JessyBarber/Jessy-Thesis/README.md

# Jessy-Thesis
Repo for thesis. This repo includes documentation, code, resources & reports. 

Project Planning Report -> Project Planning Report/Project Planning Report.pdf
