JessyBarber/Jessy-Thesis/Final Report/Final Report/Final Report.tex

%----------
%   WARNING
%----------

% This Guide contains Library recommendations based mainly on APA and IEEE styles, but you must always follow the guidelines of your TFG Tutor and the TFG regulations for your degree.

% THIS TEMPLATE IS BASED ON THE IEEE STYLE 

%----------
% DOCUMENT SETTINGS
%----------

\documentclass[12pt]{report} % font: 12pt

% Custom packages
\usepackage{comment}
\usepackage[numbers]{natbib}
\usepackage{booktabs}
\usepackage[table,xcdraw]{xcolor}
\usepackage[normalem]{ulem}
\usepackage{amsmath}
\usepackage{subcaption}

\useunder{\uline}{\ul}{}

\bibliographystyle{IEEEtran}

% margins: 2.5 cm top and bottom; 3 cm left and right
\usepackage[
a4paper,
vmargin=2.5cm,
hmargin=3cm
]{geometry}

% Paragraph Spacing and Line Spacing: Narrow (6 pt / 1.15 spacing) or Moderate (6 pt / 1.5 spacing)
\renewcommand{\baselinestretch}{1.15}
\parskip=6pt
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
\usepackage[utf8]{inputenc}

% English settings
\usepackage[english]{babel} 
\usepackage[babel, english=american]{csquotes}
\AtBeginEnvironment{quote}{\small}

% Footer settings
\usepackage{fancyhdr}
\pagestyle{fancy}
\fancyhf{}
\fancyhead[R]{\MakeUppercase{6007ENG - Industry Affiliates Program, Trimester 1, 2023}}
\fancyfoot[R]{Jessy Barber - Griffith University | \thepage}
\fancypagestyle{plain}{\pagestyle{fancy}}
\renewcommand{\headrulewidth}{0pt}

% DESIGN OF THE TITLES of the parts of the work (chapters and epigraphs or sub-chapters)
\usepackage{titlesec}
\usepackage{titletoc}
\titleformat{\chapter}[block]
{\large\bfseries\filcenter}
{\thechapter.}
{5pt}
{\MakeUppercase}
{}
\titlespacing{\chapter}{0pt}{0pt}{*3}
\titlecontents{chapter}
[0pt]                                               
{}
{\contentsmargin{0pt}\thecontentslabel.\enspace\uppercase}
{\contentsmargin{0pt}\uppercase}                        
{\titlerule*[.7pc]{.}\contentspage}                 

\titleformat{\section}
{\bfseries}
{\thesection.}
{5pt}
{}
\titlecontents{section}
[5pt]                                               
{}
{\contentsmargin{0pt}\thecontentslabel.\enspace}
{\contentsmargin{0pt}}
{\titlerule*[.7pc]{.}\contentspage}

\titleformat{\subsection}
{\normalsize\bfseries}
{\thesubsection.}
{5pt}
{}
\titlecontents{subsection}
[10pt]                                               
{}
{\contentsmargin{0pt}                          
	\thecontentslabel.\enspace}
{\contentsmargin{0pt}}                        
{\titlerule*[.7pc]{.}\contentspage}  

% Tables and figures settings
\usepackage{multirow} % combine cells 
\usepackage{caption} % customize the title of tables and figures
\usepackage{floatrow} % we use this package and its \ ttabbox and \ ffigbox macros to align the table and figure names according to the defined style.
\usepackage{array} % with this package we can define in the following line a new type of column for tables: custom width and centered content
\newcolumntype{P}[1]{>{\centering\arraybackslash}p{#1}}
\DeclareCaptionFormat{upper}{#1#2\uppercase{#3}\par}
\usepackage{graphicx}
\graphicspath{{imagenes/}} % Images folder

% Table layout for engineering
\captionsetup*[table]{
	format=upper,
	name=TABLE,
	justification=centering,
	labelsep=period,
	width=.75\linewidth,
	labelfont=small,
	font=small
}

% Figures layout for engineering
\captionsetup[figure]{
	format=hang,
	name=Fig.,
	singlelinecheck=off,
	labelsep=period,
	labelfont=small,
	font=small		
}

% FOOTNOTES
\usepackage{chngcntr} % continuous numbering of footnotes
\counterwithout{footnote}{chapter}

% CODE LISTINGS 
% support and styling for listings. More information in  https://es.wikibooks.org/wiki/Manual_de_LaTeX/Listados_de_código/Listados_con_listings
\usepackage{listings}

% Custom listing
\lstdefinestyle{estilo}{ frame=Ltb,
	framerule=0pt,
	aboveskip=0.5cm,
	framextopmargin=3pt,
	framexbottommargin=3pt,
	framexleftmargin=0.4cm,
	framesep=0pt,
	rulesep=.4pt,
	backgroundcolor=\color{gray97},
	rulesepcolor=\color{black},
	%
	basicstyle=\ttfamily\footnotesize,
	keywordstyle=\bfseries,
	stringstyle=\ttfamily,
	showstringspaces = false,
	commentstyle=\color{gray45},     
	%
	numbers=left,
	numbersep=15pt,
	numberstyle=\tiny,
	numberfirstline = false,
	breaklines=true,
	xleftmargin=\parindent
}

\captionsetup*[lstlisting]{font=small, labelsep=period}
 
\lstset{style=estilo}
\renewcommand{\lstlistingname}{\uppercase{Código}}

% REFERENCES 

% IEEE bibliography setup
\begin{comment}
\usepackage[backend=biber, style=ieee, isbn=false,sortcites, maxbibnames=6, minbibnames=1]{biblatex} % Setting for IEEE citation style, recommended for engineering. "maxbibnames" indicates that from 6 authors truncate the list in the first one (minbibnames) and add "et al." as used in the IEEE style.

\addbibresource{Sections/Bibliography/References.bib} % The references.bib file in which the bibliography used should be
\end{comment}

%-------------
%	DOCUMENT
%-------------

\begin{document}
\pagenumbering{roman} % Roman numerals are used in the numbering of the pages preceding the body of the work.
	
%----------
%	COVER
%----------	

\begin{titlepage}
	\begin{sffamily}
	\color{azulUC3M}
	\begin{center}
		\begin{comment}
		\begin{figure}[H] % UC3M Logo
			\makebox[\textwidth][c]{}
		\end{figure}
		\end{comment}
		\vspace{2.5cm}
		\begin{Large}
			Bachelor of Electrical and Electronic Engineering (Honours)\\			
			 2023\\ % Academic year
			\vspace{2cm}		
			\textsl{6007ENG - Industry Affiliates Program}
			\bigskip
			
		\end{Large}
		 	{\Huge Structural Health Monitoring of the Griffith Footbridge Using LoRaWAN Technology}\\
		 	\vspace*{0.5cm}
	 		\rule{10.5cm}{0.1mm}\\
			\vspace*{0.9cm}
			{\LARGE Jessy Barber}\\ 
			\vspace*{1cm}
		\begin{Large}
			Griffith University Internal Project\\
			Yong Zhu
		\end{Large}
	\end{center}
	\vfill
	\begin{figure}
		
	\end{figure}
	\end{sffamily}
\end{titlepage}

%----------
%	ABSTRACT AND KEYWORDS 
%----------	
\renewcommand\abstractname{\large\bfseries\filcenter\uppercase{Executive Summary}}
\begin{abstract}
\thispagestyle{plain}
\setcounter{page}{1}
	
	% Write your abstract
This research presents a novel approach for Structural Health Monitoring (SHM) of the Griffith University footbridge, harnessing the power of LoRaWAN technology within the framework of the Internet of Things (IoT). The study is undertaken in two phases. 
	
The first phase focuses on the software development and testing of the initial three layers of the IoT architecture: coding, perception and network. This involves the utilisation of two Arduino MKRWAN 1300 devices, where one serves as a LoRa node and the other as a LoRaWAN gateway. An ADXL335 3-axis accelerometer is integrated into the system to capture vibrational data, which is processed and visualized through Python scripts. 
	
The second phase extends the reach of the IoT architecture to incorporate middleware and application layers. It also includes hardware modifications like transitioning to a custom PCB and a 3D printed enclosure. The data captured is transmitted via a LoRaWAN connection to a WisGate Edge Lite 2 gateway and then relayed to the TNN cloud. Data visualization and analysis are facilitated using the Arduino IoT Cloud dashboard.
	
Each phase is guided by defined objectives, including hardware design and testing, software validation, and comprehensive field tests. The overall outcome is a potential new standard for bridge health monitoring using LoRaWAN technology, as exemplified by the Griffith University footbridge.
	
	\vfill
\end{abstract}

%----------
%	Dedication
%----------	
\chapter*{Acknowledgements}

\setcounter{page}{2}
	
	% Write here	
	I would like this opportunity to acknowledge and thank the following people, without whom I would not be able to complete this project:

My mother and father, for always supporting me every step of the way on my academic journey. For supporting me both mentally and financially during my studies, I thank you deeply. 

My group of friends, for respecting the time required for my studies, and always being there to elevate my spirits. 

My fellow peers at Griffith who I have met along the way, I thank you for being patient with me and always providing a fun learning experience. 

My work staff and bosses, for allowing me to take time off from my dream job to complete my degree, and allowing me to come back full time the moment I finish. 

And finally I would like to thank my supervisor Yong Zhu and project partner Huiyue Qiao for their countless hours in meetings and extensive laboratory testing. I hope you enjoyed the project as much as I did. 
	\vfill

%----------
%	TOC
%----------	

%--
% TOC
%-
\tableofcontents
\thispagestyle{fancy}

%--
% List of figures. If they are not included, comment the following lines
%-
\listoffigures
\thispagestyle{fancy}

%--
% List of tables. If they are not included, comment the following lines
%-
\listoftables
\thispagestyle{fancy}

%----------
%	THESIS
%----------	
\clearpage
\pagenumbering{arabic} % numbering with Arabic numerals for the rest of the document.	
\pagestyle{fancy}
\chapter{Introduction}
\input{Sections/Introduction/Report-Structure}
\input{Sections/Introduction/Project-Background}
\input{Sections/Introduction/Aims-Objectives}
\newpage
\chapter{Review of Published Literature}
\input{Sections/Literature-Review/Literature-Review}
\chapter{Design Process}
\input{Sections/Design-Process/Design-Specifications}
\chapter{Prototype Testing}
\input{Sections/Prototype-Testing/Testing-Methodology}
\chapter{Discussions}
\input{Sections/Discussions/Discussions}

% IMPORTANT: Latex special characters are: # $ % & \ ^ _ { } ~. To avoid mistakes when compiling try writing \ before. For: \ use \textbackslash ; for ^ \textasciitilde and ~ \textasciicircum.

%     Example of figure:
%     \begin{figure}[H]
%     	\ffigbox[\FBwidth] {
%     	\caption[Name as seen in index]{Figure name}
%     	}
%     	{\includegraphics[scale=0.6]{imagenes/creativecommons.png}}
%     \end{figure}

%     Example of table:S
% \begin{table}[H]
% 	\ttabbox[\FBwidth]
% 	{\caption{Lorem ipsum}}
% 	{\begin{tabular}{|c|P{1.5cm}|c|P{1.5cm}|P{2cm}|c|P{1.5cm}|P{2cm}|}
% 		\hline
% 		\multicolumn{2}{|c|}{\textbf{I}} & \multicolumn{2}{c|}{\textbf{II}} & \multicolumn{3}{c|}{\textbf{III}} & \textbf{IV} \\
% 		\hline
% 		x & y & x & y & x & y & x & y \\
% 		\hline
% 		10.0 & 8.04 & 10.0 & 9.14 & 10.0 & 7.46 & 8.0 & 6.58 \\
% 		\hline
% 		8.0 & 6.95 & 8.0 & 8.14 & 8.0 & 6.77 & 8.0 & 5.76 \\
% 		\hline
% 		13.0 & 7.58 & 13.0 & 8.74 & 13.0 & 12.74 & 8.0 & 7.71 \\
% 		\hline
% 		9.0 & 8.81 & 9.0 & 8.77 & 9.0 & 7.11 & 8.0 & 8.84 \\
% 		\hline
% 		11.0 & 8.33 & 11.0 & 9.26 & 11.0 & 7.81 & 8.0 & 8.47 \\
% 		\hline
% 		14.0 & 9.96 & 14.0 & 8.10 & 14.0 & 8.84 & 8.0 & 7.04 \\
% 		\hline
% 		6.0 & 7.24 & 6.0 & 6.13 & 6.0 & 6.08 & 8.0 & 5.25 \\
% 		\hline
% 		4.0 & 4.26 & 4.0 & 3.10 & 4.0 & 5.39 & 19.0 & 12.50 \\
% 		\hline
% 		12.0 & 10.84 & 12.0 & 9.13 & 12.0 & 8.15 & 8.0 & 5.56 \\
% 		\hline
% 		7.0 & 4.82 & 7.0 & 7.26 & 7.0 & 6.42 & 8.0 & 7.91 \\
% 		\hline
% 		5.0 & 5.68 & 5.0 & 4.74 & 5.0 & 5.73 & 8.0 & 6.89 \\
% 		\hlineS
% 		\multicolumn{5}{l}{Source: BOE}
% 	\end{tabular}}
% \end{table}

% Start writing here----------------------------------------------------

%----------
%	Bibliography
%----------	

\clearpage
%\addcontentsline{toc}{chapter}{Bibliography}

%\printbibliography
\bibliography{References}

%----------
%	Appendix
%----------	

% If your work includes Appendix, you can uncomment the following lines
\chapter {Appendix}
\pagenumbering{gobble} % Appendix pages are not numbered
\input{Sections/Appendix/Appendix}

\end{document}
