JessyBarber/Jessy-Thesis/Final Report/Final Report/Sections/Introduction/Report-Structure.tex

\section{Report Structure}

The report is organized in the following structure; first relevant background information regarding measuring the health of a bridge, WSNs, LoRa and LoRaWAN, and the internet of things will be presented. Following this, the aims and objectives of this report will be outlined. Next, a review of the relevant published literature will be evaluated. The design specifications and methodology for developing protoype one and two will be provided. Results from testing both prototype implementations will be presented and a discussion regarding these results and performance will be provided. Device limitations will be analysed, suggestions for further improvements will be discussed followed by a conclusion. Proceeding the conclusion will be the references and appendices.
