JessyBarber/Jessy-Thesis/Poster/presentation.pptx

## Structural Health Monitoring of the Griffith Footbridge using LoRaWAN Technology

LoRaWAN
What is LoRaWAN Technology?
IoT Architecture
Demonstration of a full IoT implementation
Design and testing of two functional prototypes
Two Prototypes

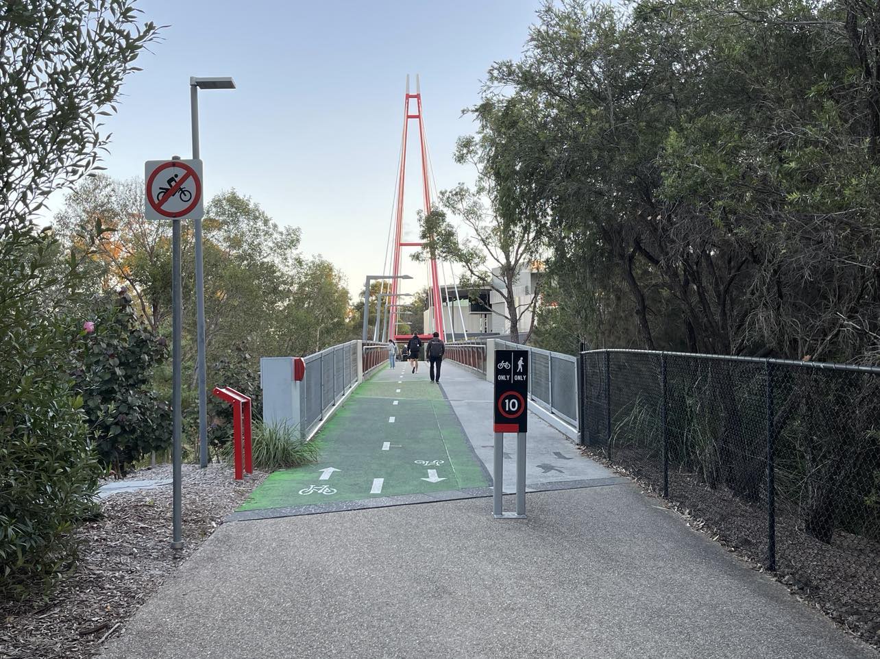
[picture p42: figure]

## Slide 2

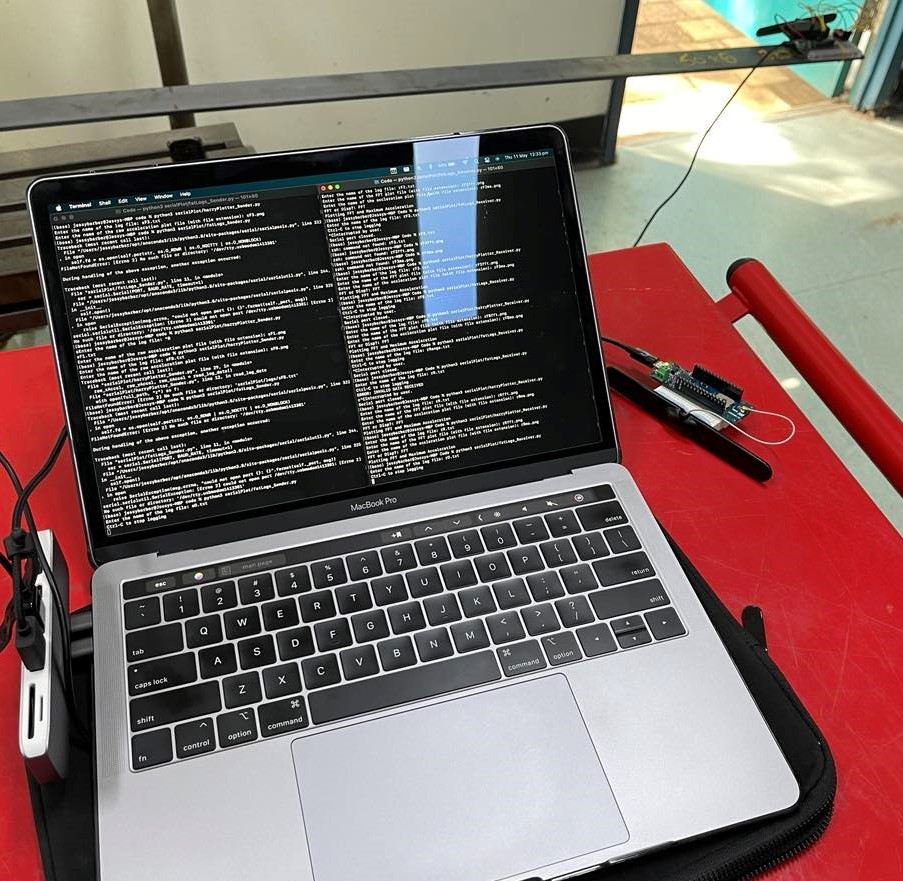
[picture p43: figure]
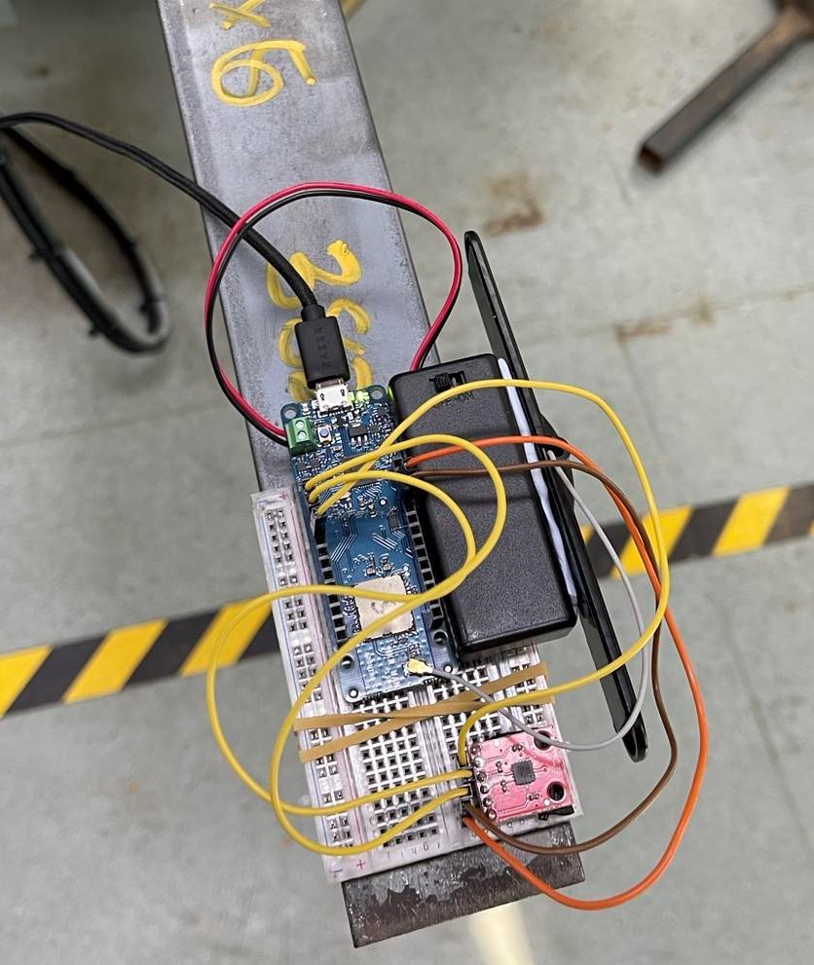
[picture p44: figure]

Node to node LoRa communication

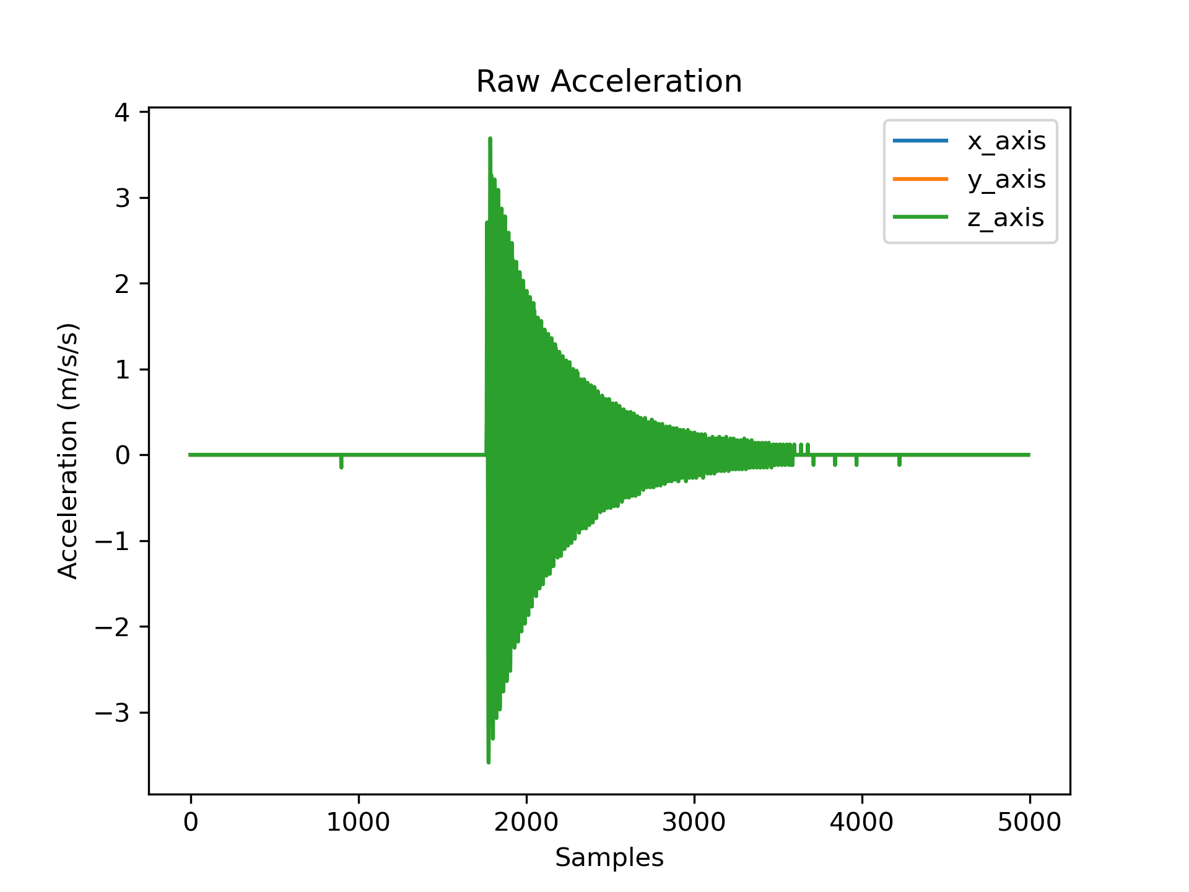
[picture p45: figure]

Serial communication for raw acceleration

Node to node communication range: 200m

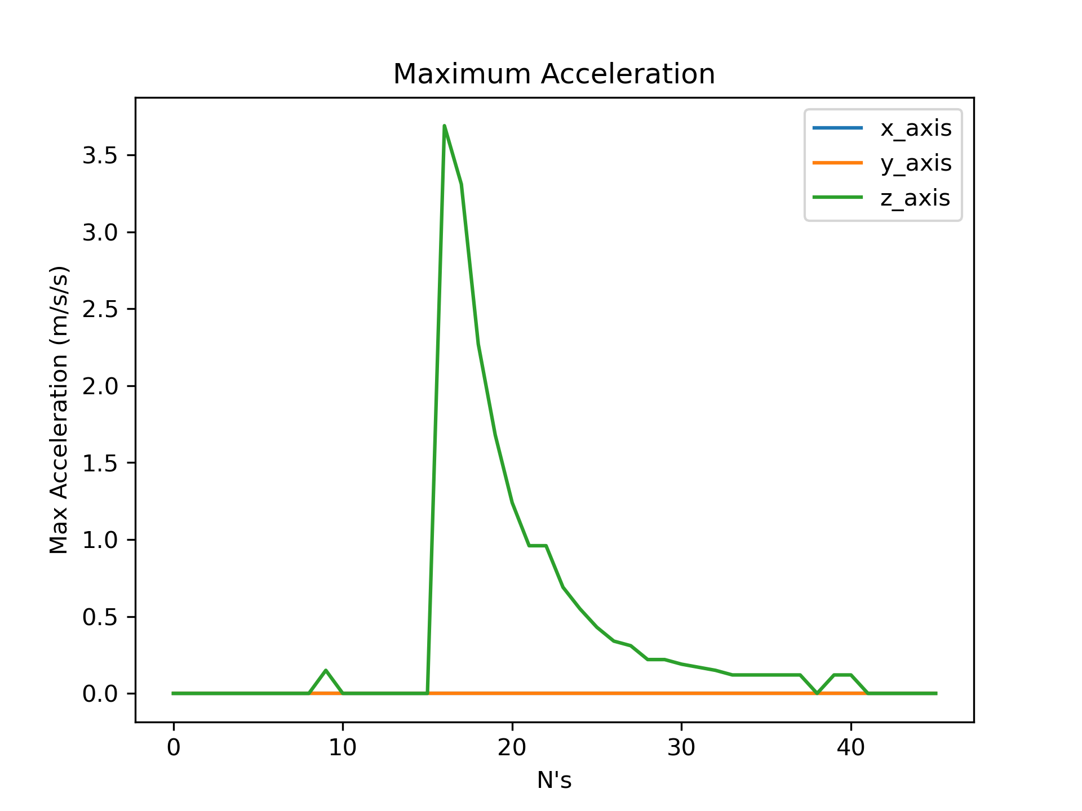
[picture p46: figure]
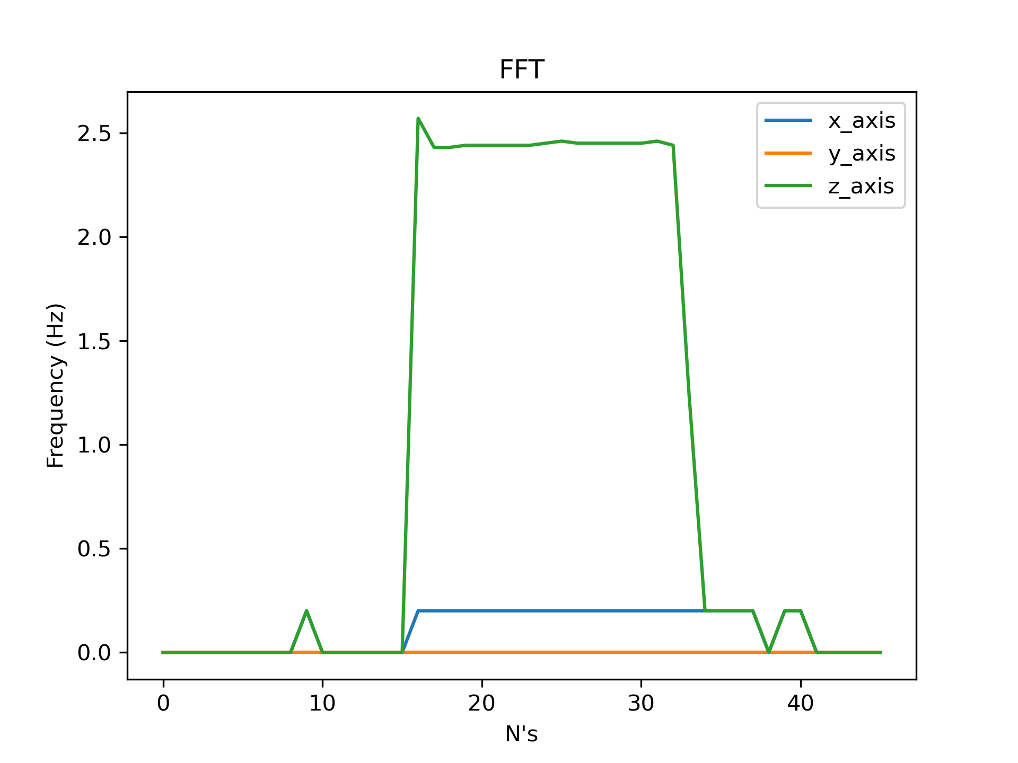
[picture p47: figure]

9

## Slide 3

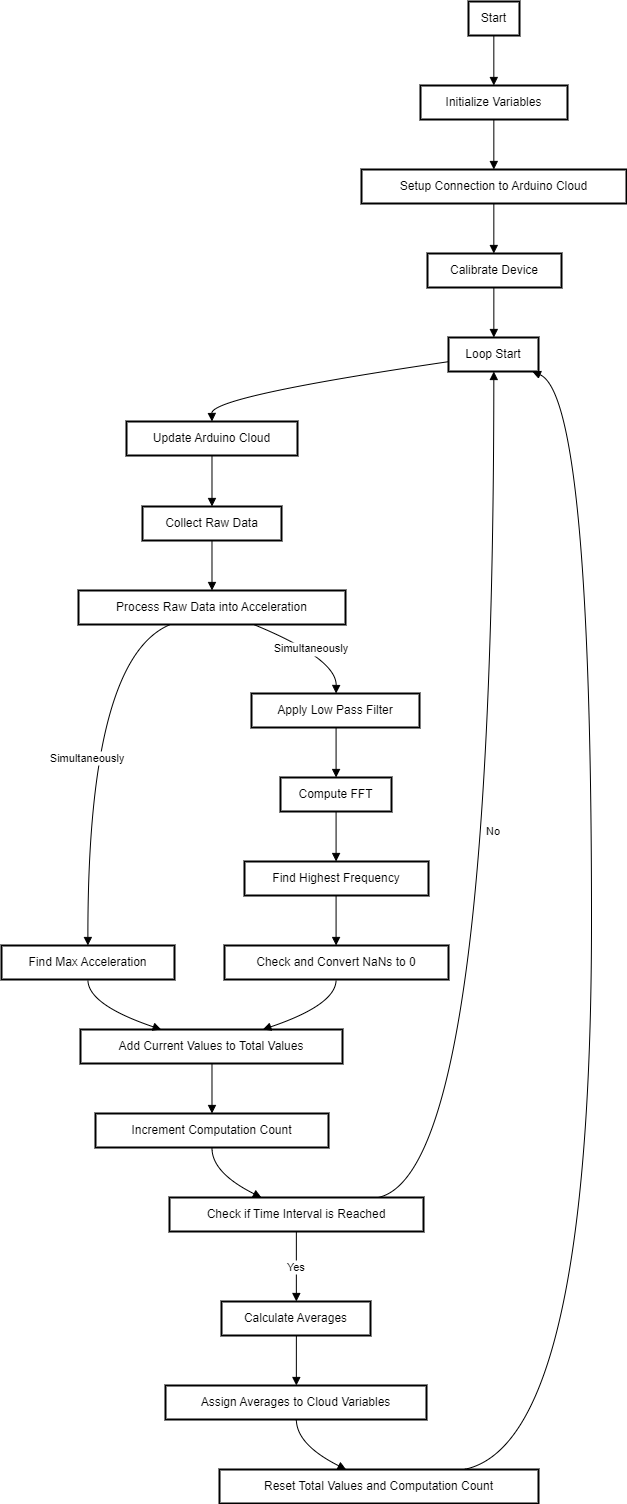
[picture p48: figure]
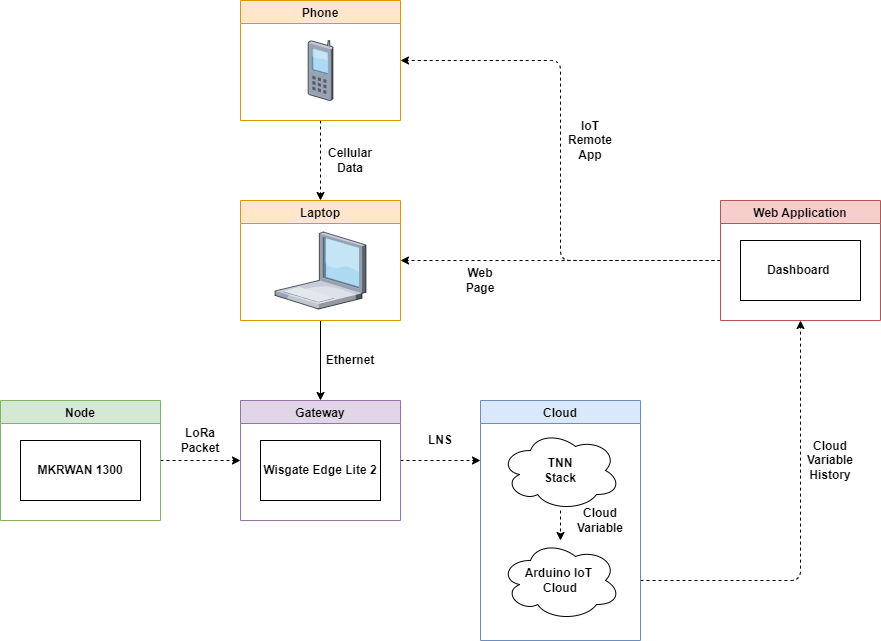
[picture p49: figure]

## Slide 4


## Slide 5

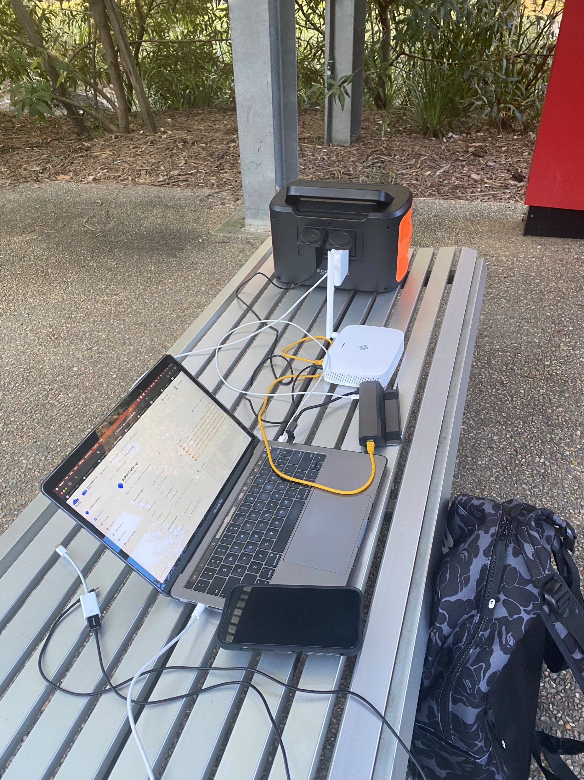
[picture p50: figure]

Test range: 25m

Average first mode flexural frequency:
2.5 Hz

## Conclusion
