JessyBarber/Jessy-Thesis/Final Report/Final Report/Sections/Design-Process/proto1-sys-diagram.pdf

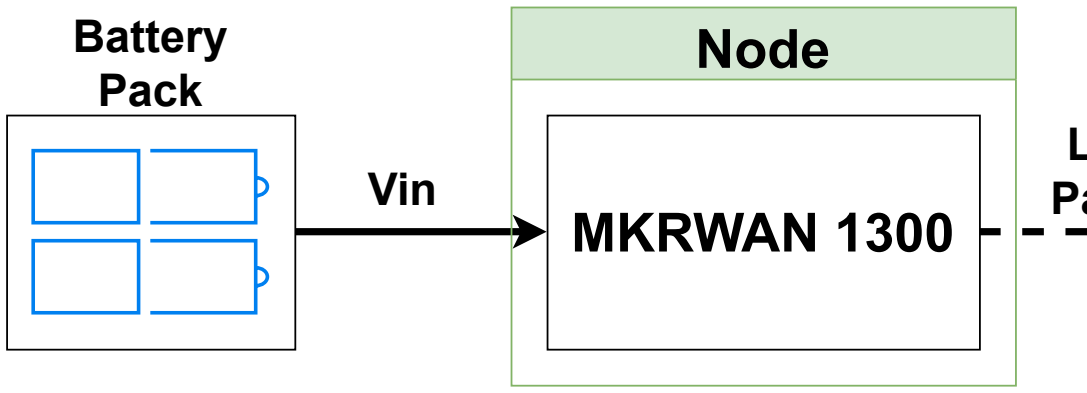
[picture p66: figure]
Node; MKRWAN 1300; Vin; Battery Pack

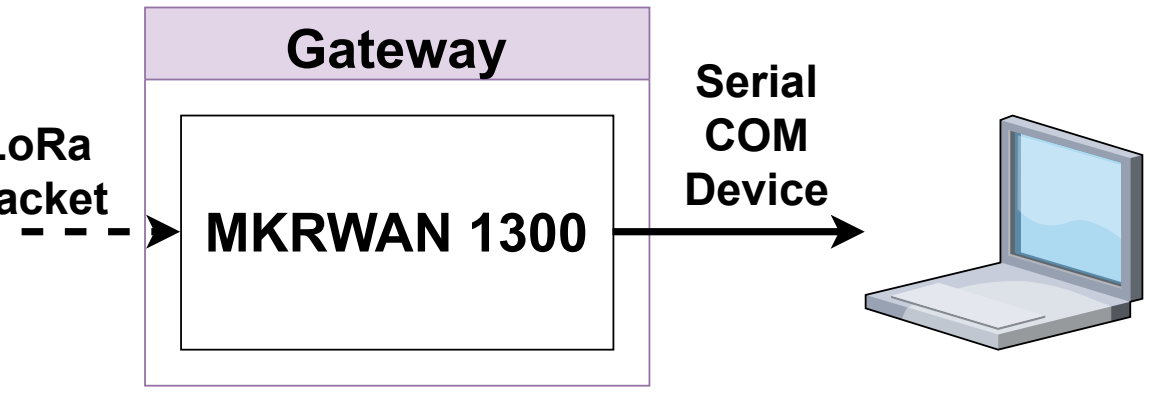
[picture p67: figure]
Gateway; MKRWAN 1300; LoRa acket; Serial COM Device
