JessyBarber/Jessy-Thesis/Final Report/Enclosure with Axis .pptx

X

Y

Z
