JessyBarber/Jessy-Thesis/Final Report/cover-page.pdf

## Griffith School of Engineering

## Griffith University

## 6007ENG – Industry Affiliates Program

# Structural Health Monitoring of the

# Griffith Footbridge Using LoRaWAN

# Technology

## Jessy Barber, s5138877

12th

# June, Trimester 1, 2023

## Griffith University Internal Project

## Yong Zhu

A report submitted in partial fulfilment of the degree of Bachelor of Engineering (Honours)

The copyright on this report is held by the author and/or the IAP Industry Partner. Permission has been granted to Griffith University to keep

a reference copy of this report.

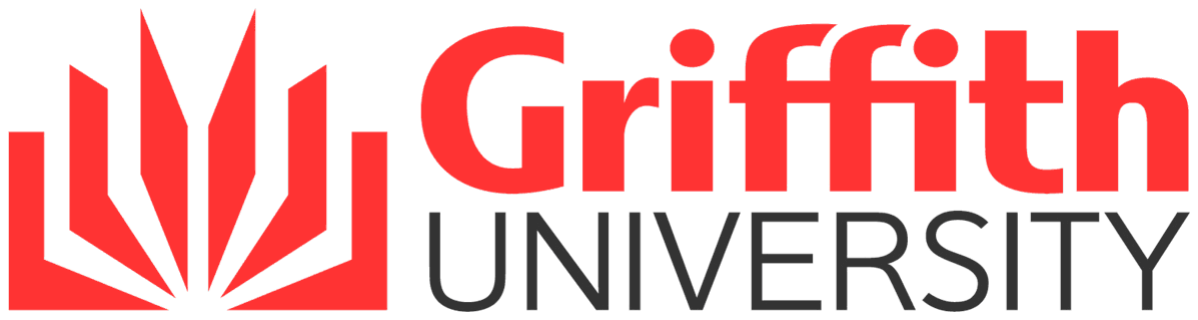
[picture p86: figure]
