JessyBarber/Jessy-Thesis/Resources/MKR WAN 1300 from Arduino.pdf

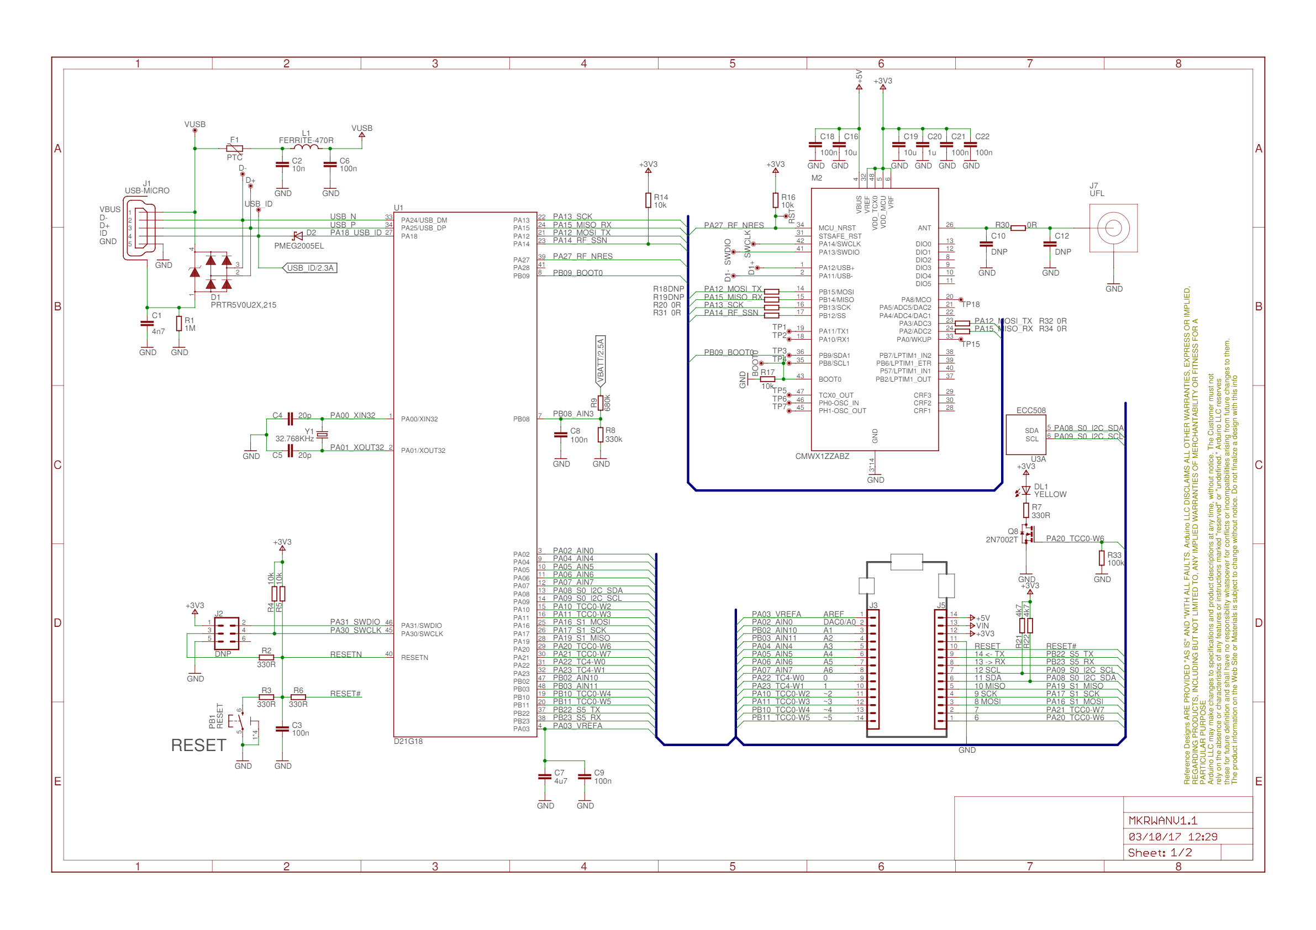
[picture p87: page 1]
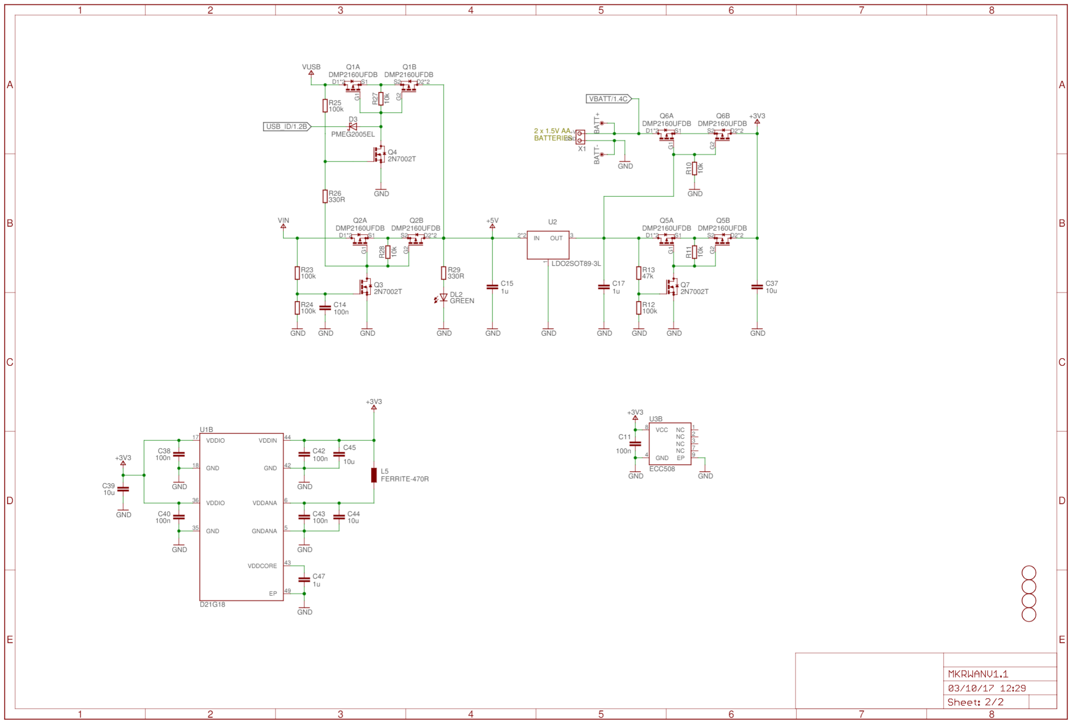
[picture p88: page 2]
