JessyBarber/Jessy-Thesis/Code/Log/Plots/N=32/FFT(N=32).png

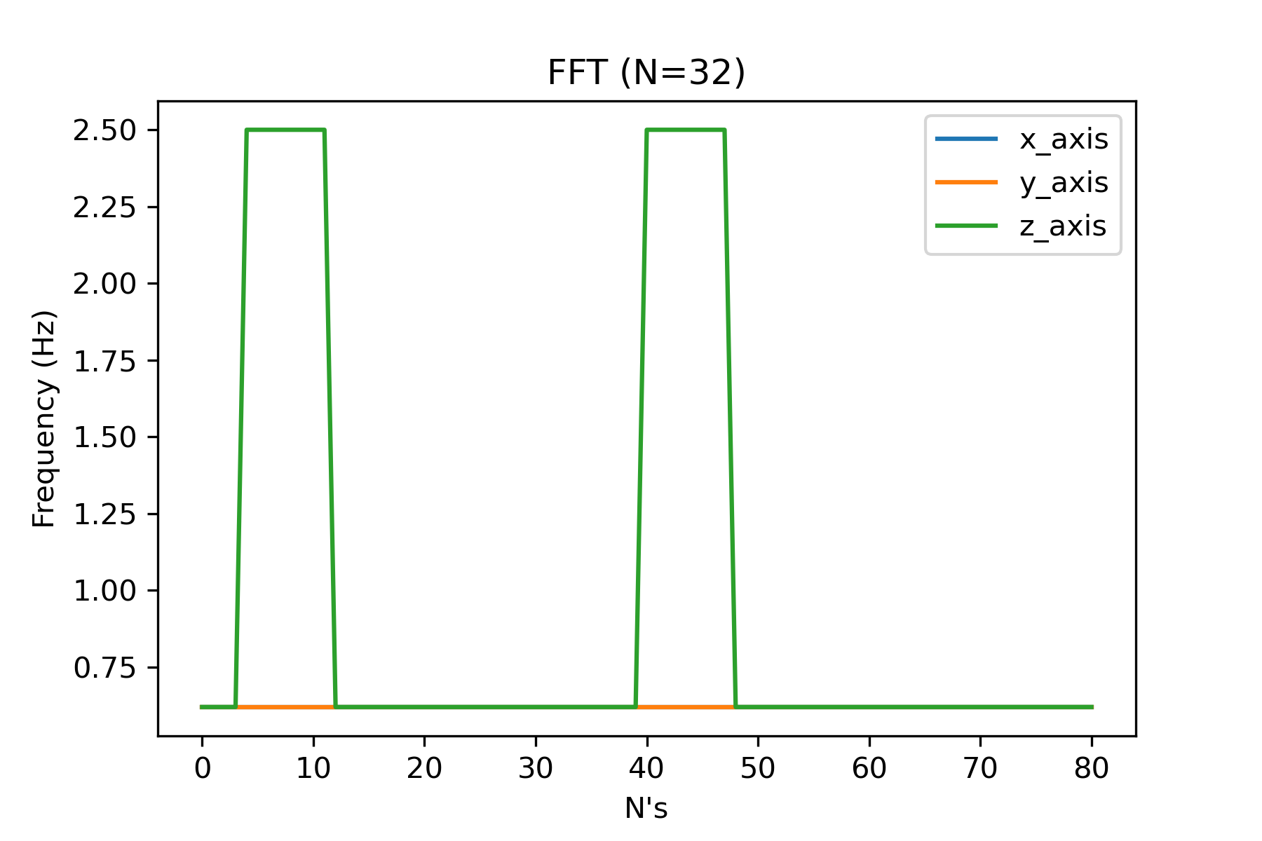
Code/Log/Plots/N=32/FFT(N=32).png
