JessyBarber/Jessy-Thesis/Code/Log/Plots/N=32/MaxAccel(N=32).png

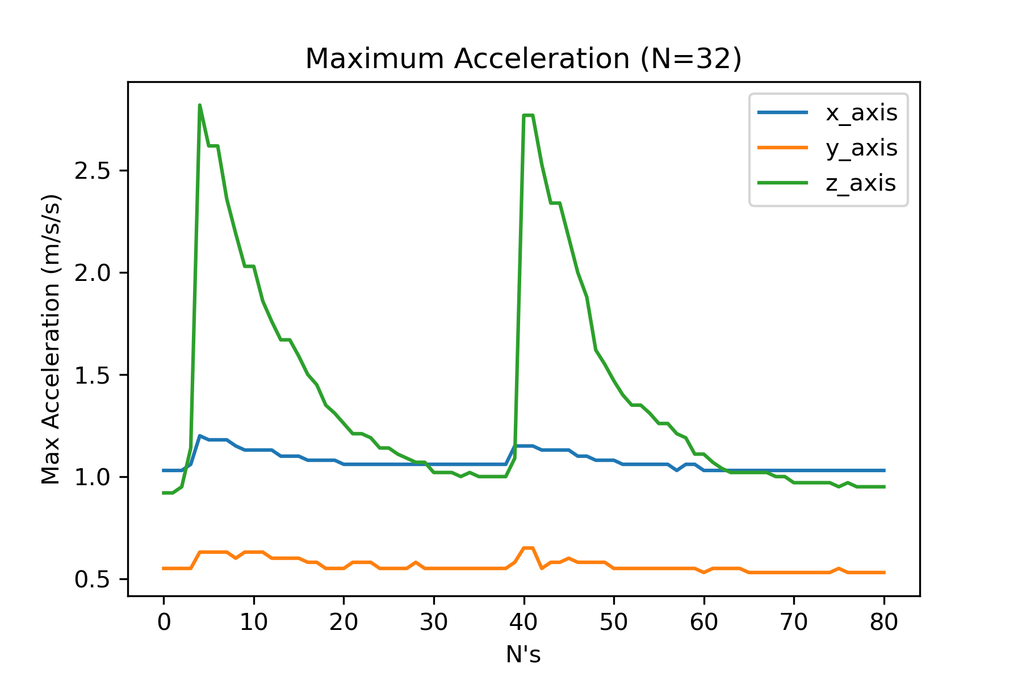
Code/Log/Plots/N=32/MaxAccel(N=32).png
