JessyBarber/Jessy-Thesis/Code/Log/Plots/N=64/FFT(N=64).png

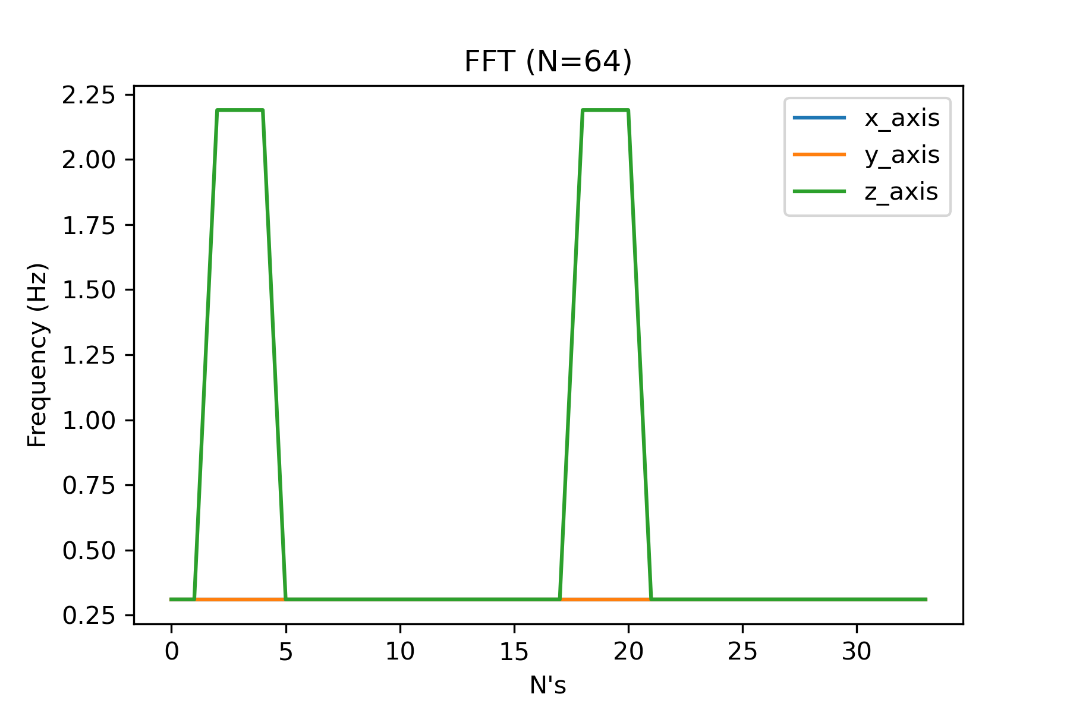
Code/Log/Plots/N=64/FFT(N=64).png
