JessyBarber/Jessy-Thesis/Code/Log/Plots/N=64/MaxAccel(N=64).png

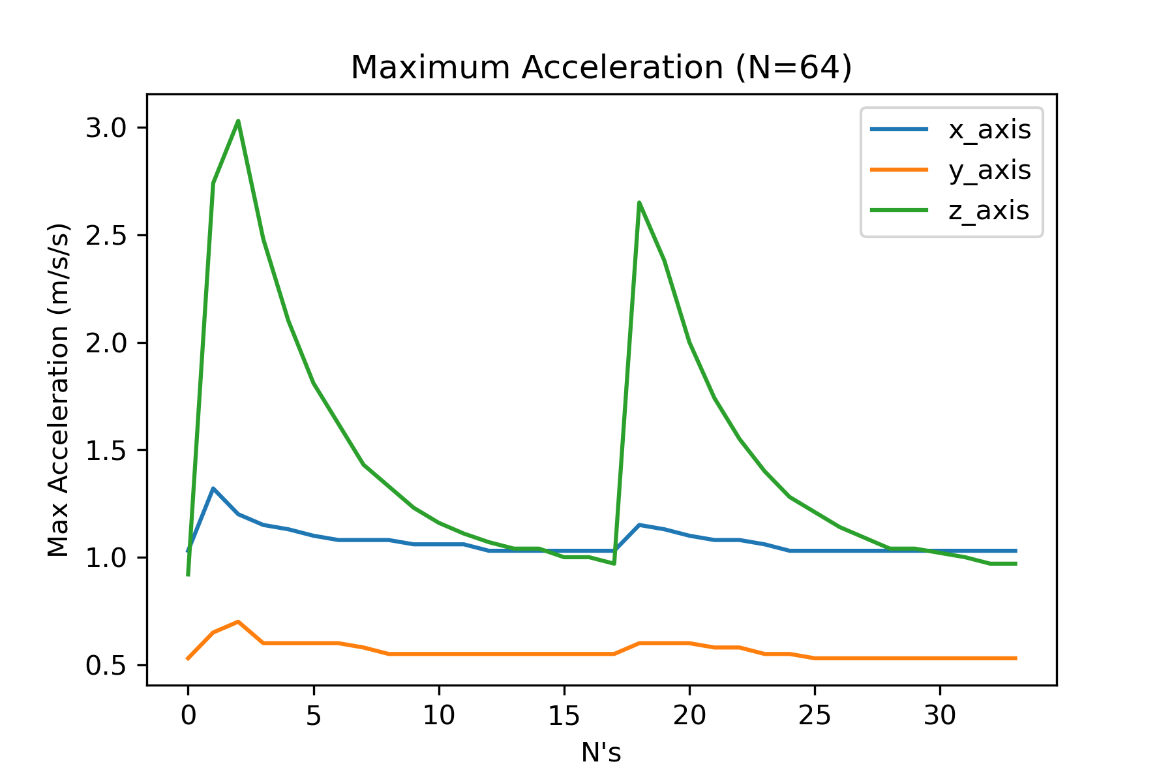
Code/Log/Plots/N=64/MaxAccel(N=64).png
