JessyBarber/Jessy-Thesis/Code/Log/Plots/N=64/RawAccel(N=64).png

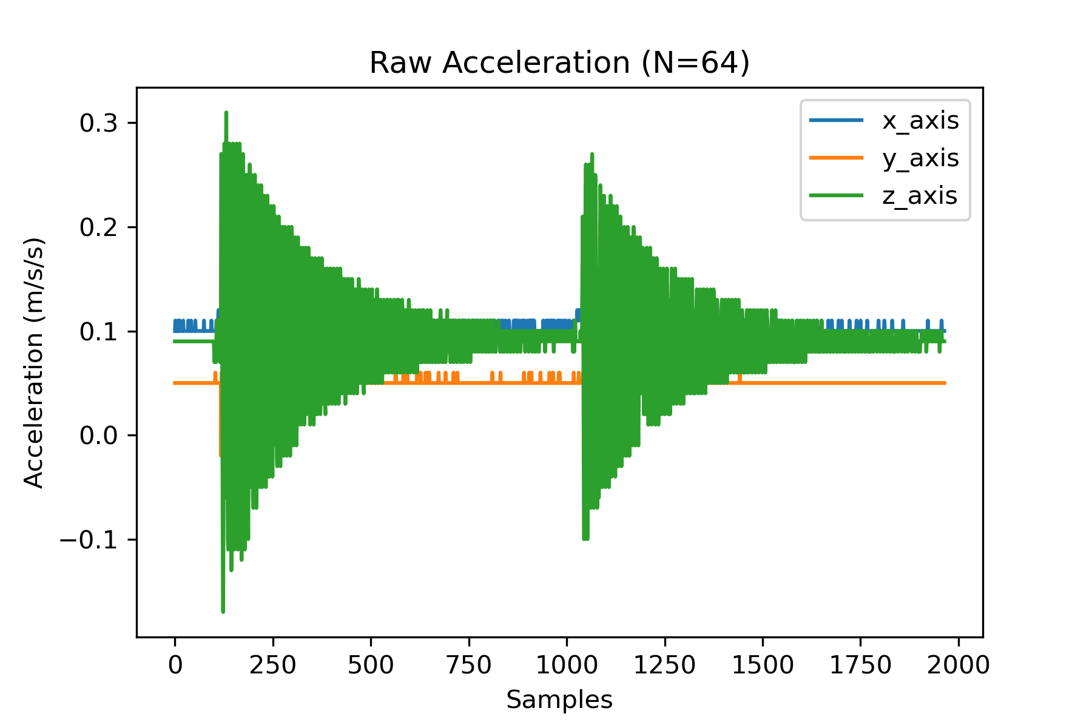
Code/Log/Plots/N=64/RawAccel(N=64).png
