JessyBarber/Jessy-Thesis/Code/Log/Plots/N=128/MaxAccel(N=128).png

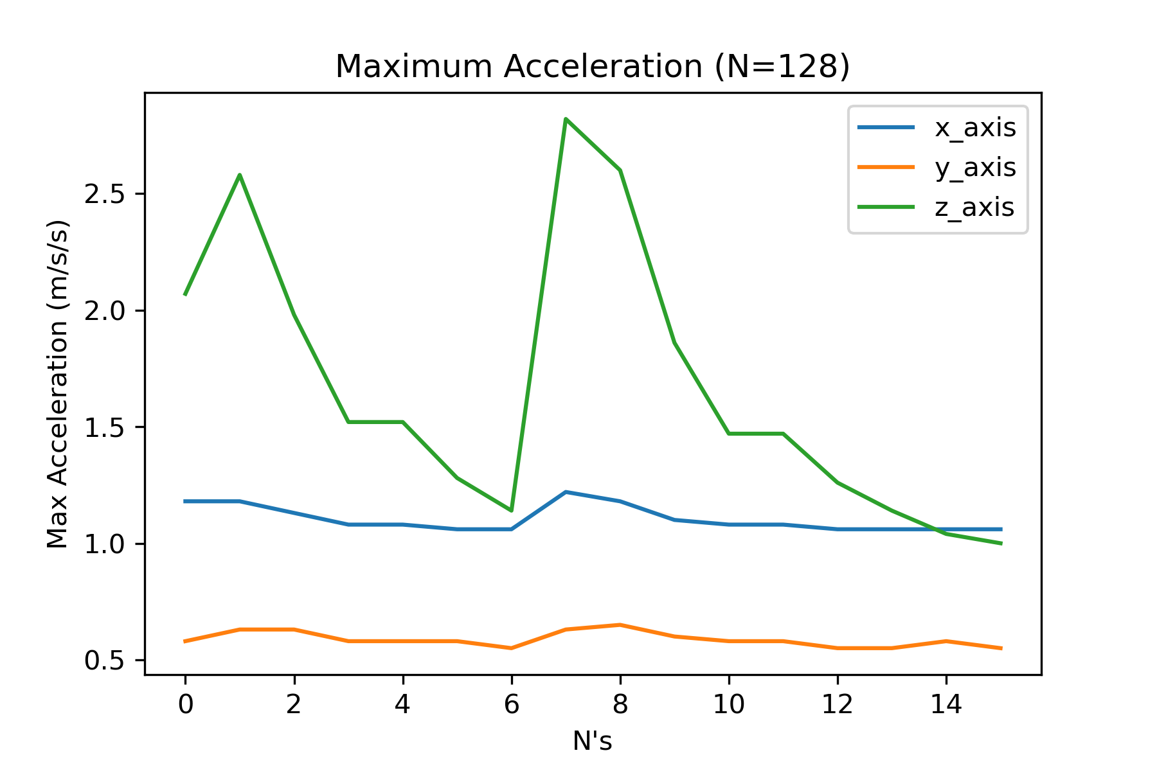
Code/Log/Plots/N=128/MaxAccel(N=128).png
