JessyBarber/Jessy-Thesis/Code/Log/Plots/N=128/RawAccel(N=128).png

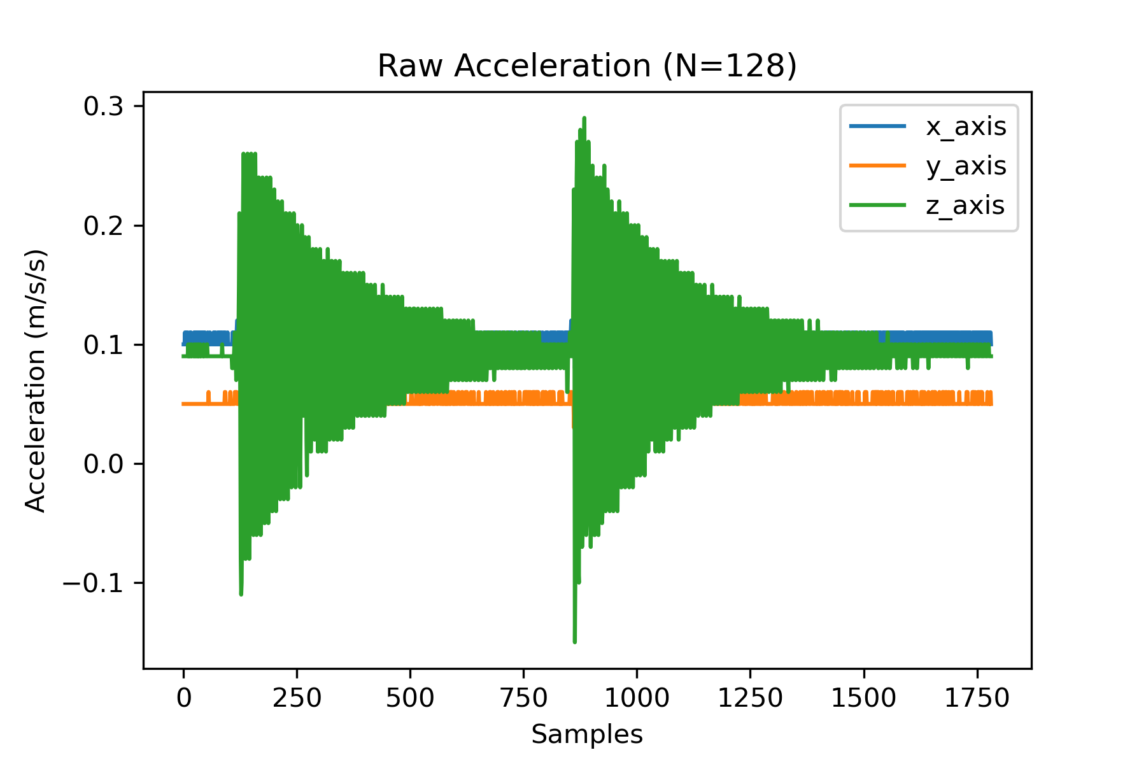
Code/Log/Plots/N=128/RawAccel(N=128).png
