JessyBarber/Jessy-Thesis/Code/Log/Plots/N=256/FFT(N=256).png

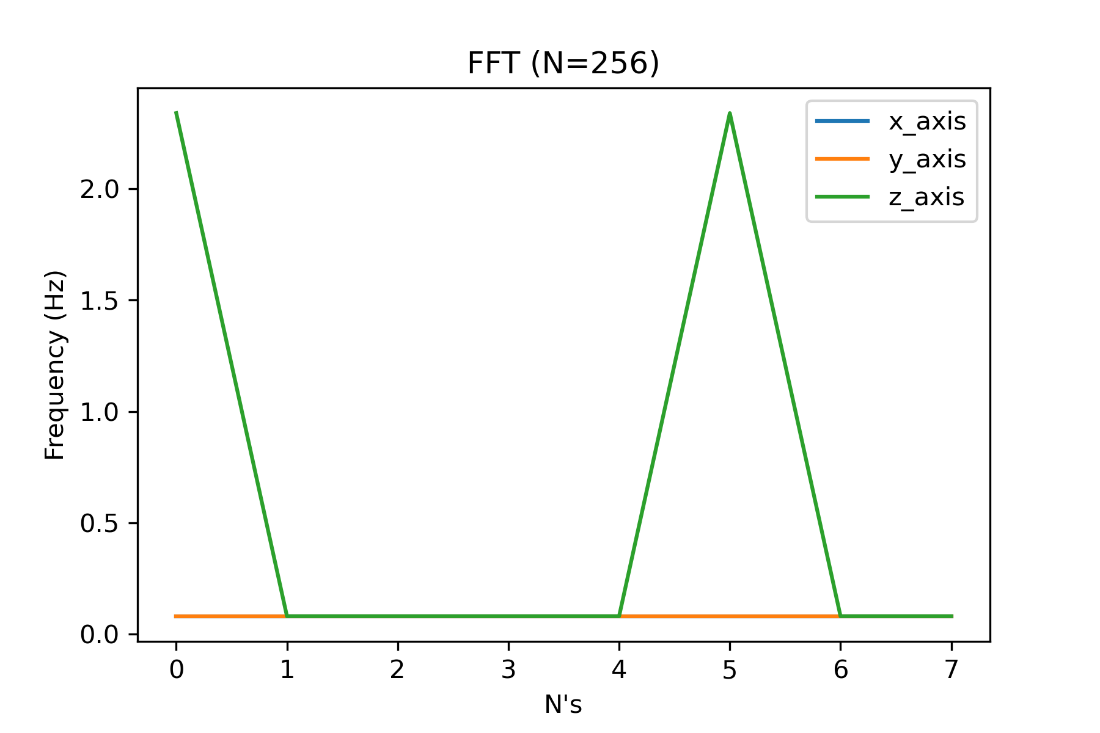
Code/Log/Plots/N=256/FFT(N=256).png
