JessyBarber/Jessy-Thesis/Code/Log/Plots/N=256/MaxAccel(N=256).png

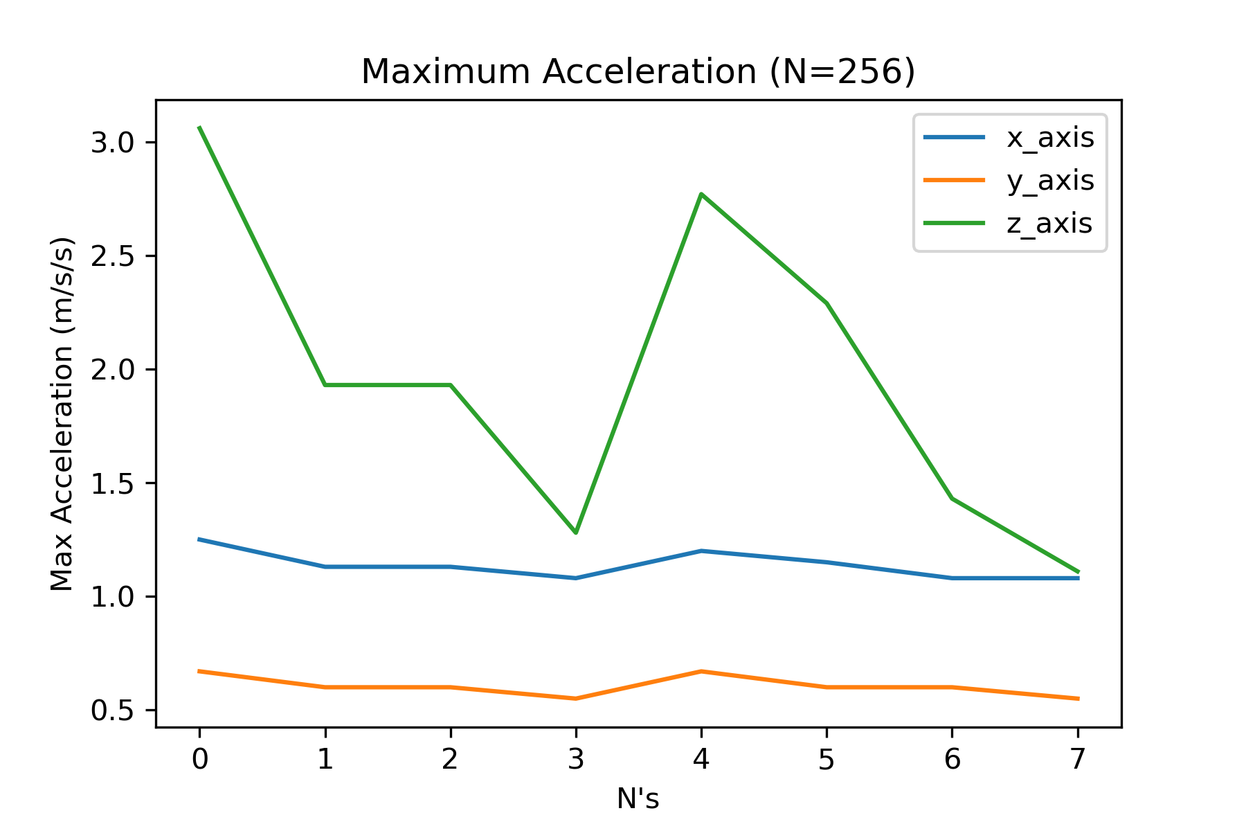
Code/Log/Plots/N=256/MaxAccel(N=256).png
