JessyBarber/Jessy-Thesis/Code/serialPlot/plots/pcbrtest1.png

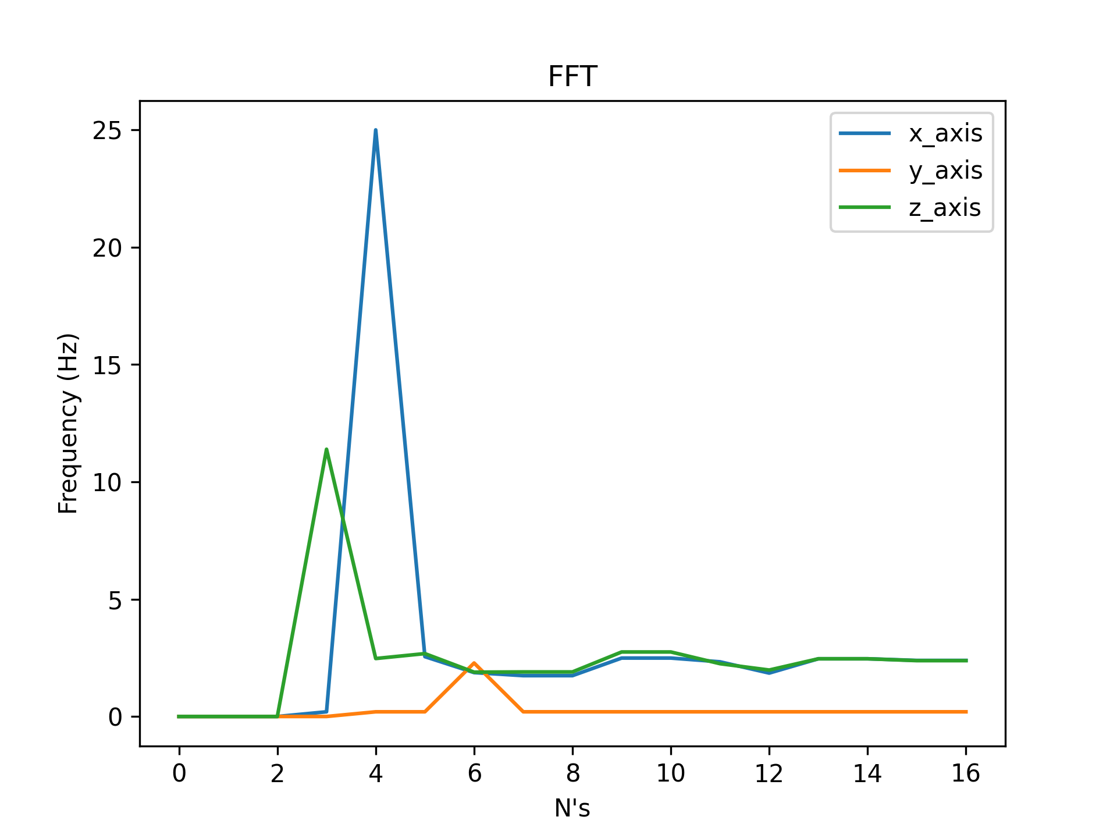
Code/serialPlot/plots/pcbrtest1.png
