JessyBarber/Jessy-Thesis/Code/serialPlot/plots/pcbrtest1ma.png

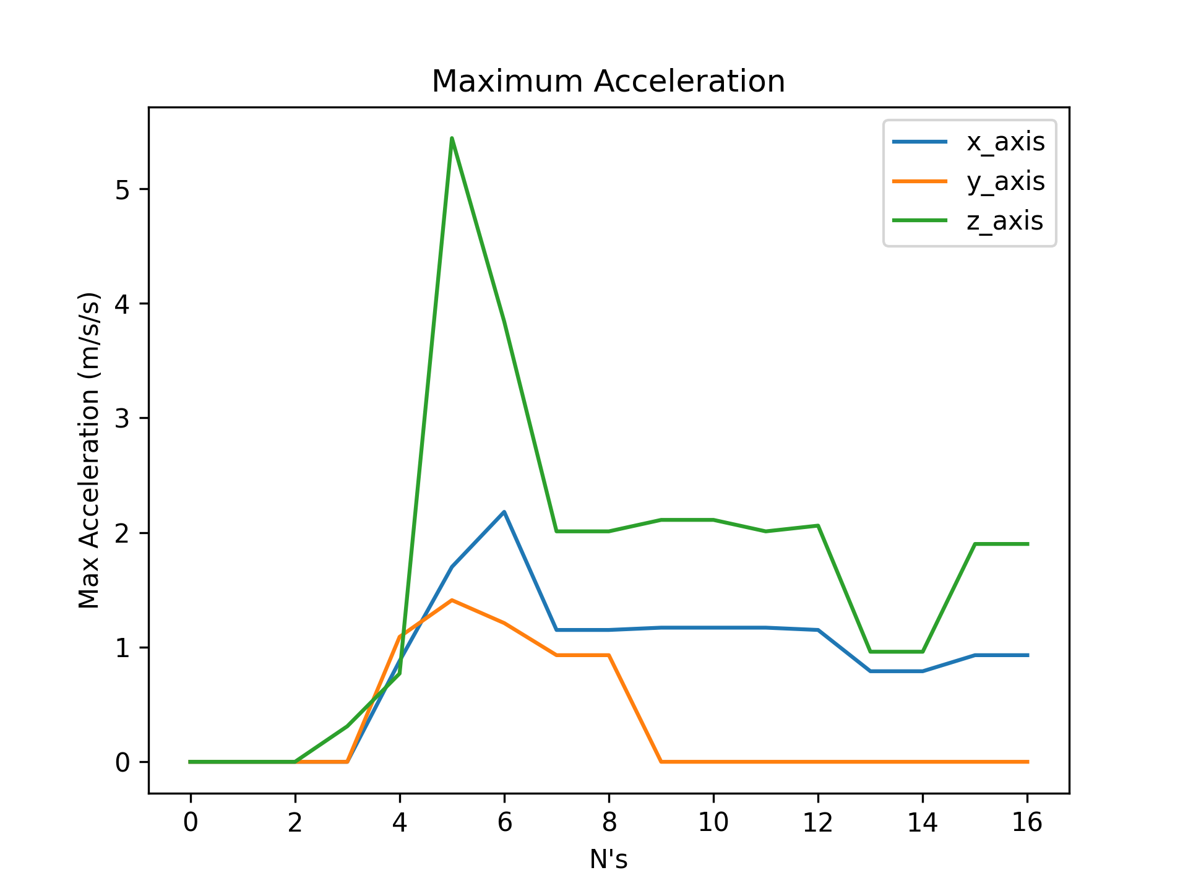
Code/serialPlot/plots/pcbrtest1ma.png
