JessyBarber/Jessy-Thesis/Code/serialPlot/plots/pcbtest1.png

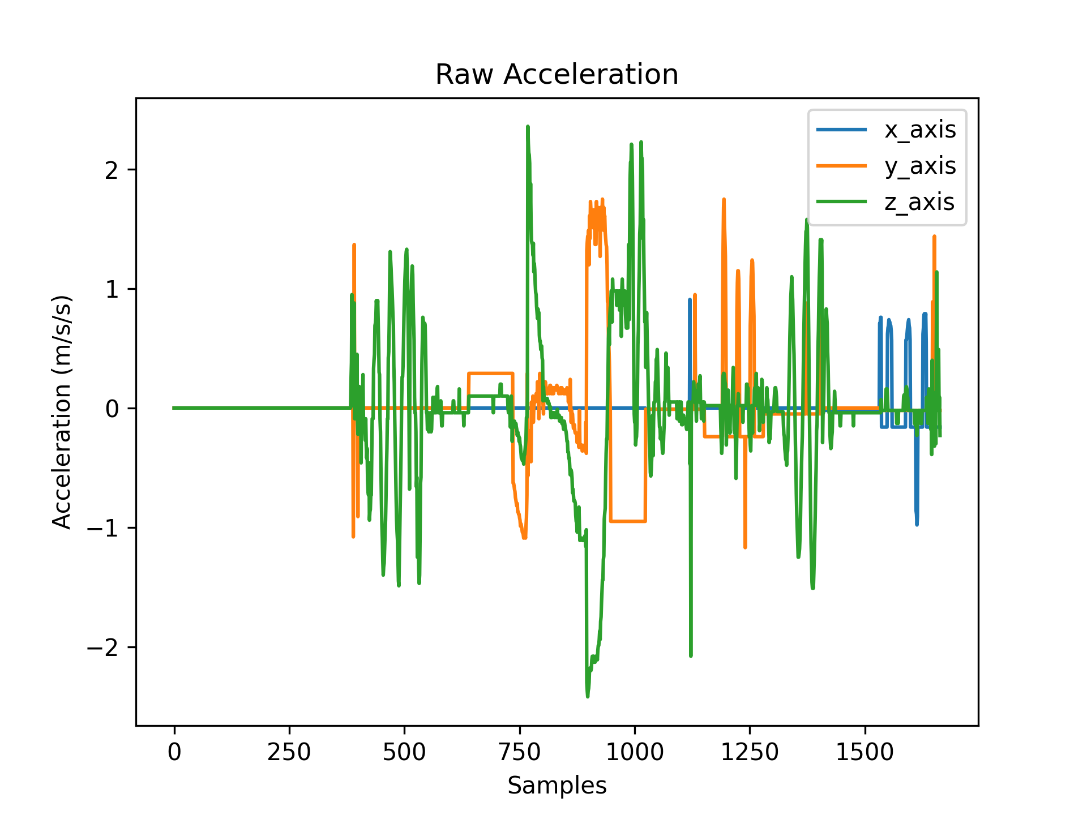
Code/serialPlot/plots/pcbtest1.png
