JessyBarber/Jessy-Thesis/Code/serialPlot/plots/pcbtest2.png

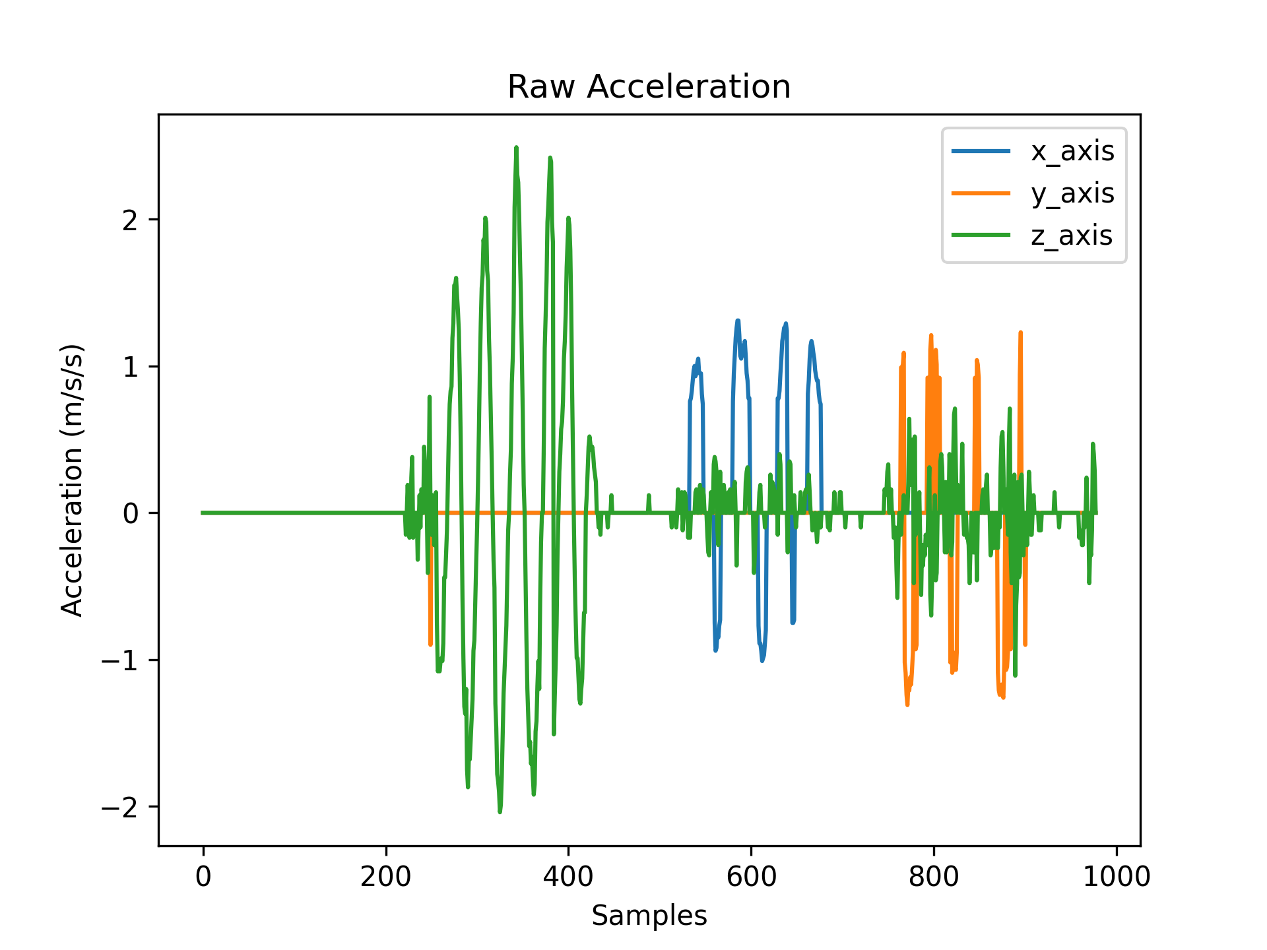
Code/serialPlot/plots/pcbtest2.png
