JessyBarber/Jessy-Thesis/Code/serialPlot/plots/pcbtest3.png

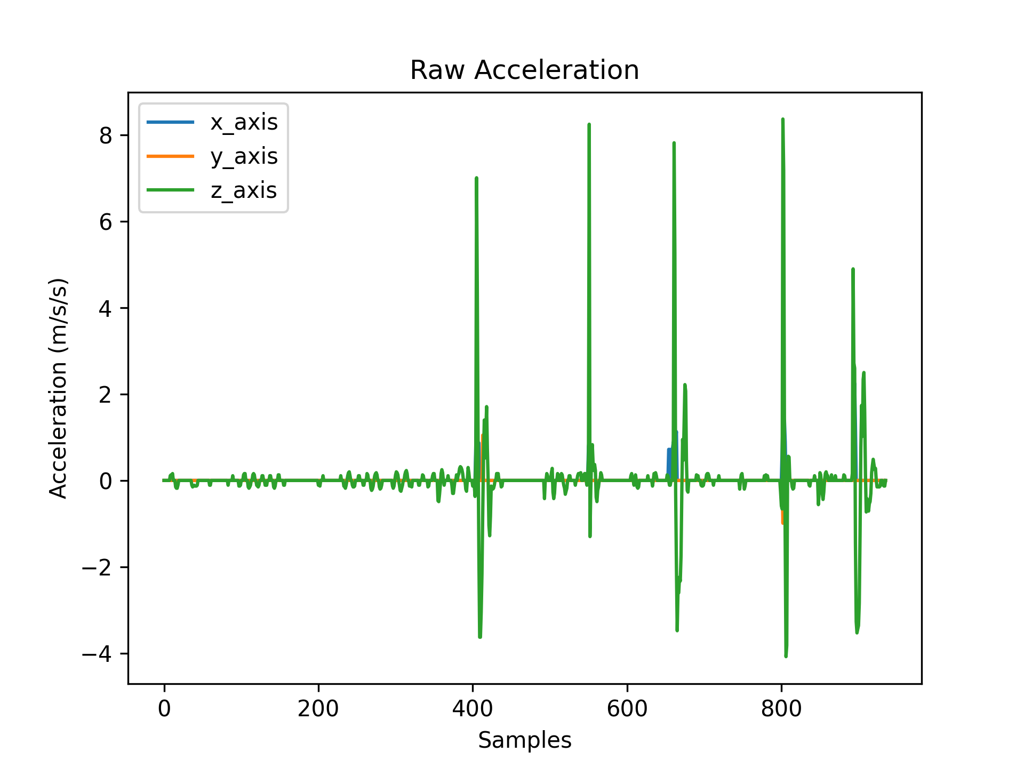
Code/serialPlot/plots/pcbtest3.png
