JessyBarber/Jessy-Thesis/Code/serialPlot/plots/pcbtestR1FFT.png

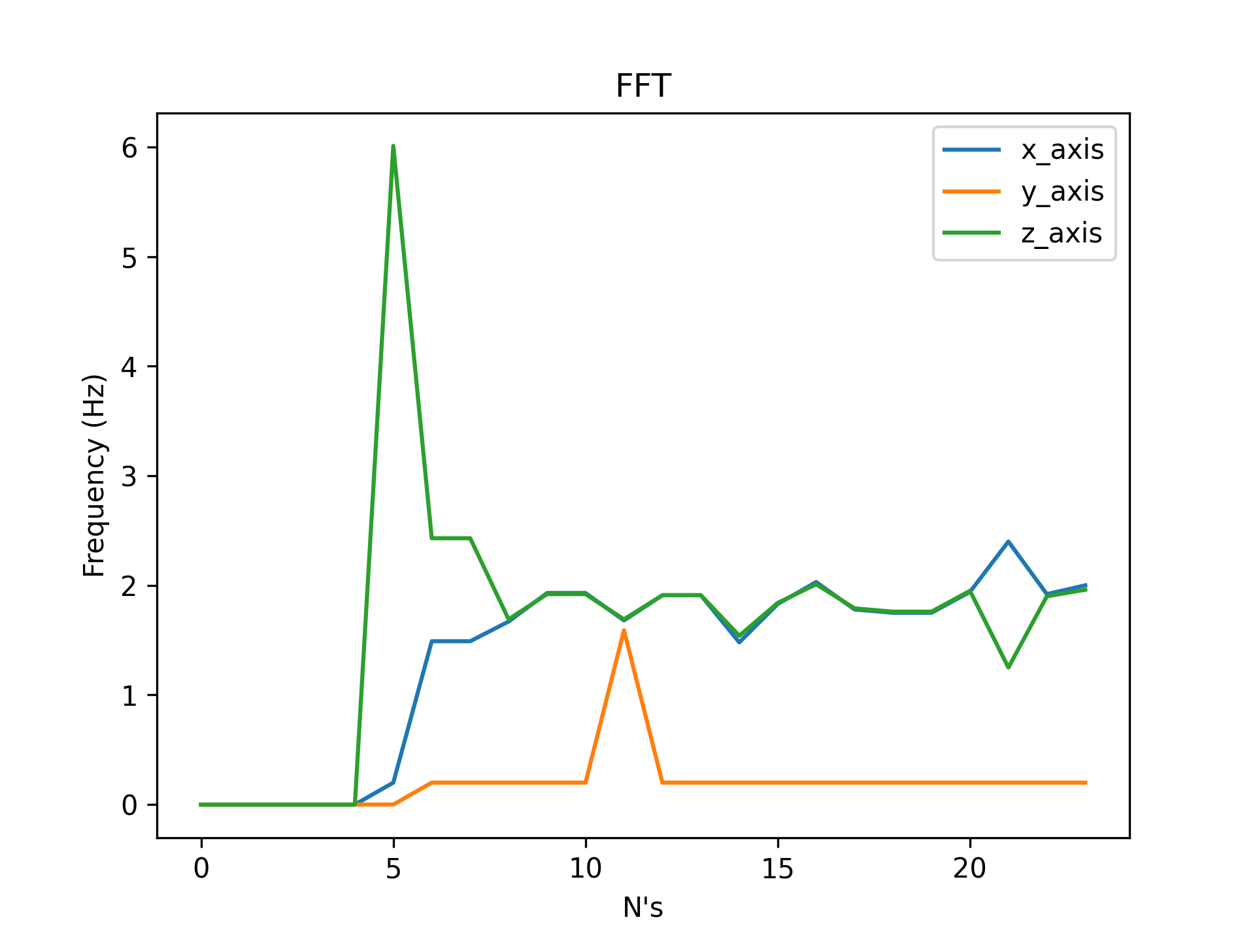
Code/serialPlot/plots/pcbtestR1FFT.png
