JessyBarber/Jessy-Thesis/Code/serialPlot/plots/pcbtestR1MA.png

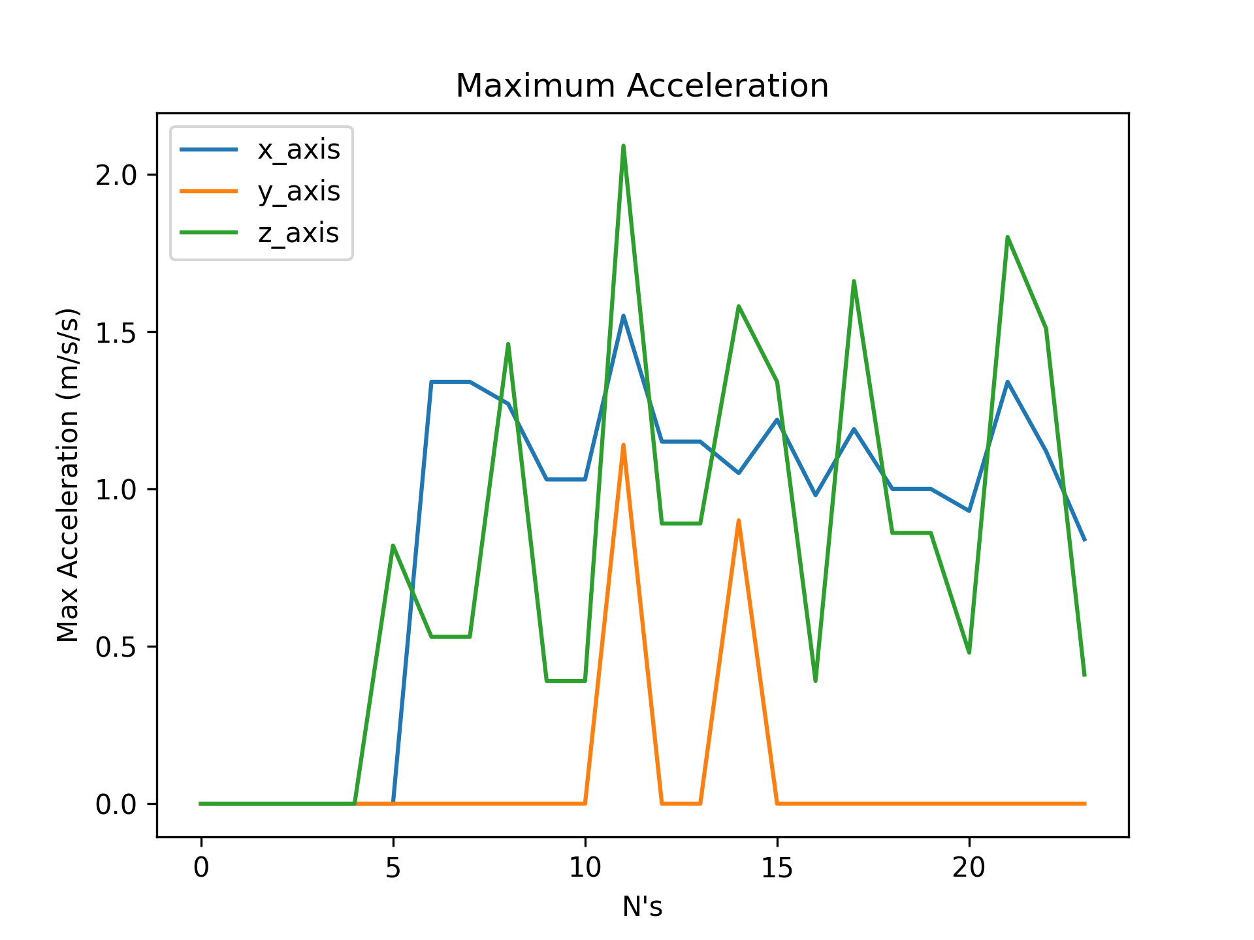
Code/serialPlot/plots/pcbtestR1MA.png
