JessyBarber/Jessy-Thesis/Code/serialPlot/plots/pcbtestRBFFT.png

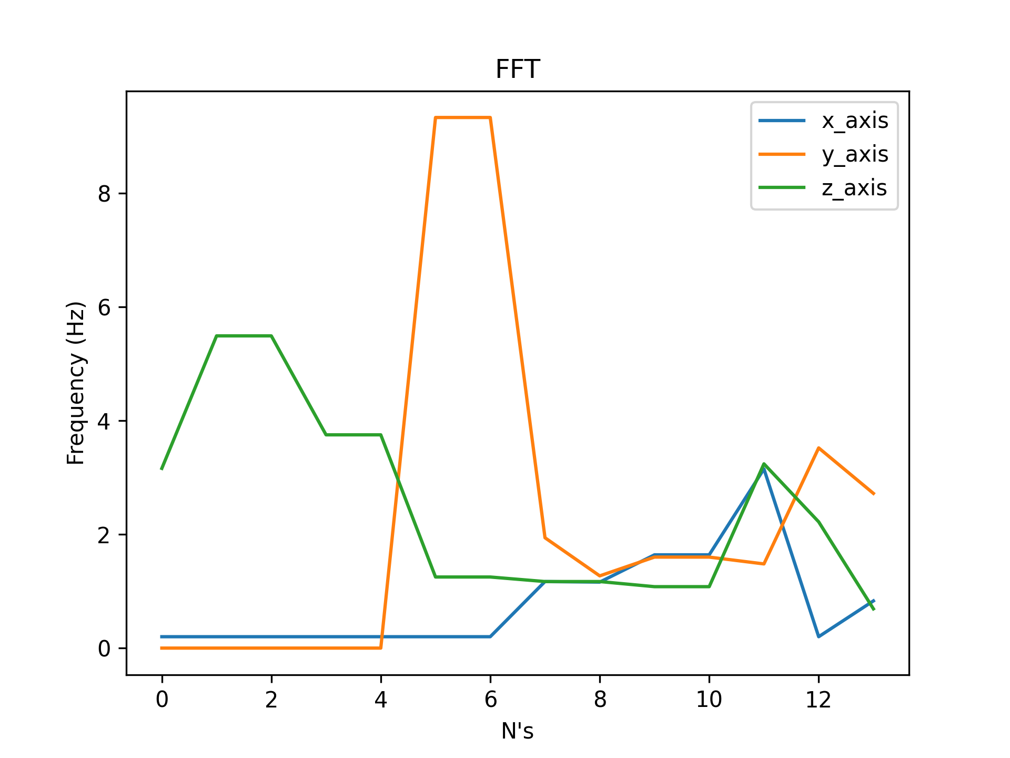
Code/serialPlot/plots/pcbtestRBFFT.png
