JessyBarber/Jessy-Thesis/Code/serialPlot/plots/pcbtestRBMA.png

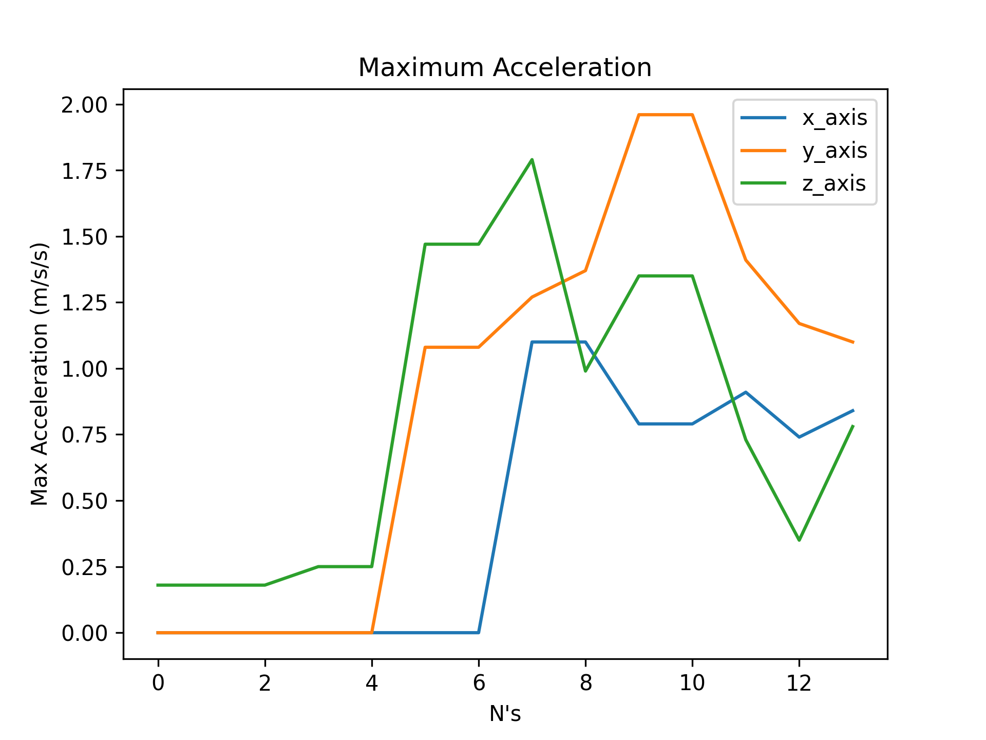
Code/serialPlot/plots/pcbtestRBMA.png
