JessyBarber/Jessy-Thesis/Code/serialPlot/plots/pcbtestS1.png

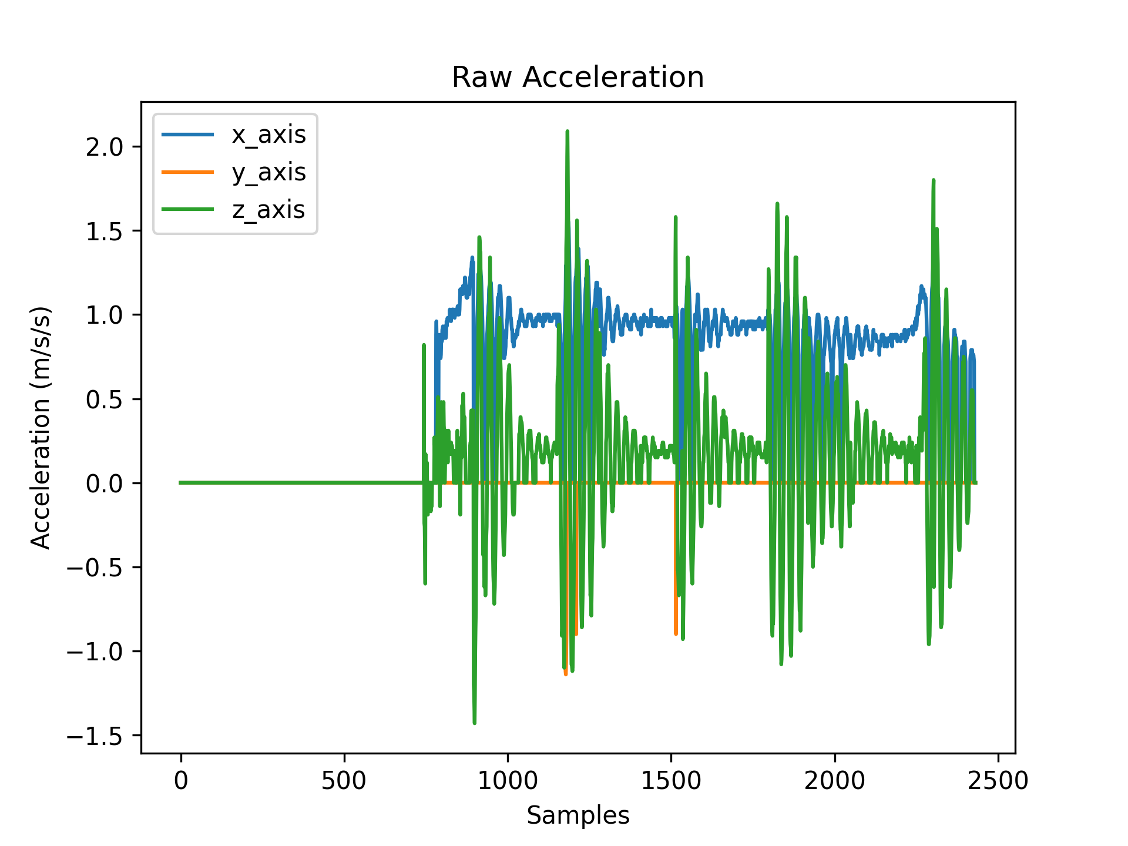
Code/serialPlot/plots/pcbtestS1.png
