JessyBarber/Jessy-Thesis/Code/serialPlot/plots/rDBfft.png

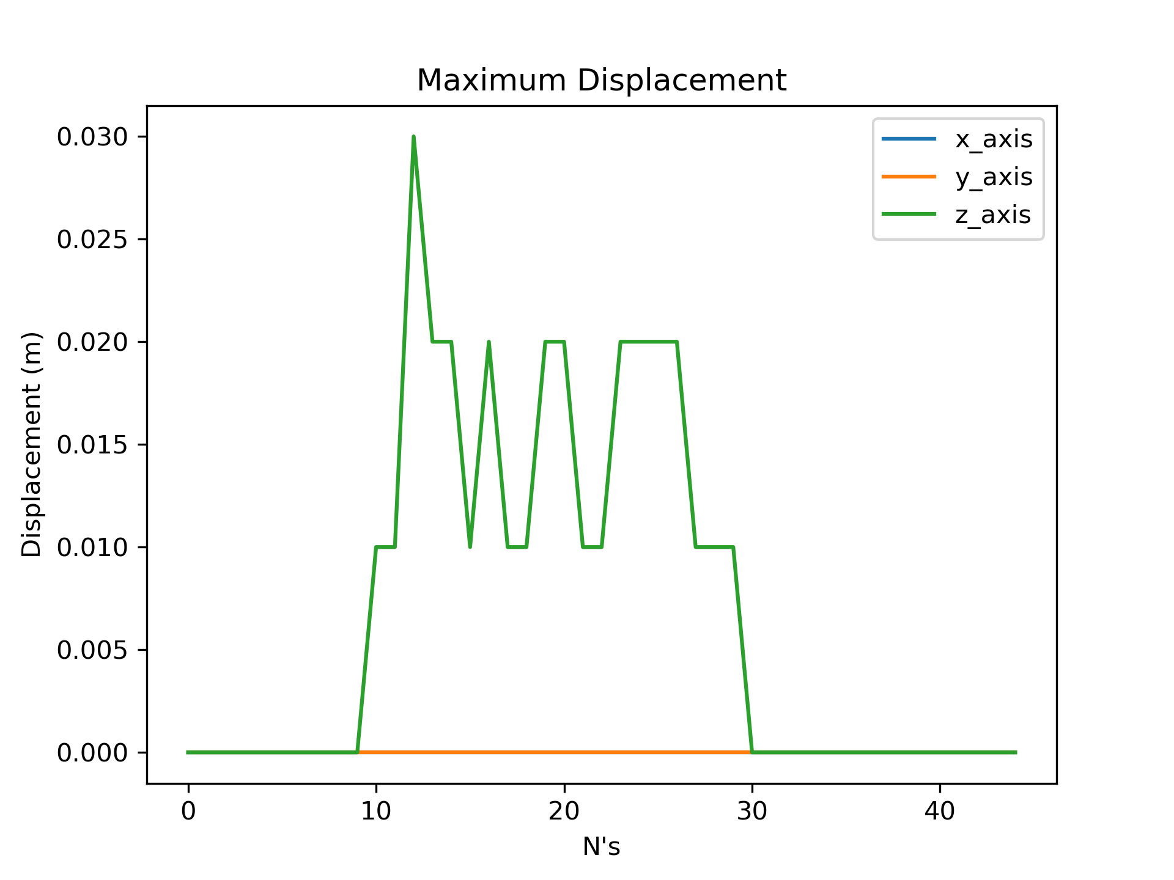
Code/serialPlot/plots/rDBfft.png
