JessyBarber/Jessy-Thesis/Code/serialPlot/plots/rDBma.png

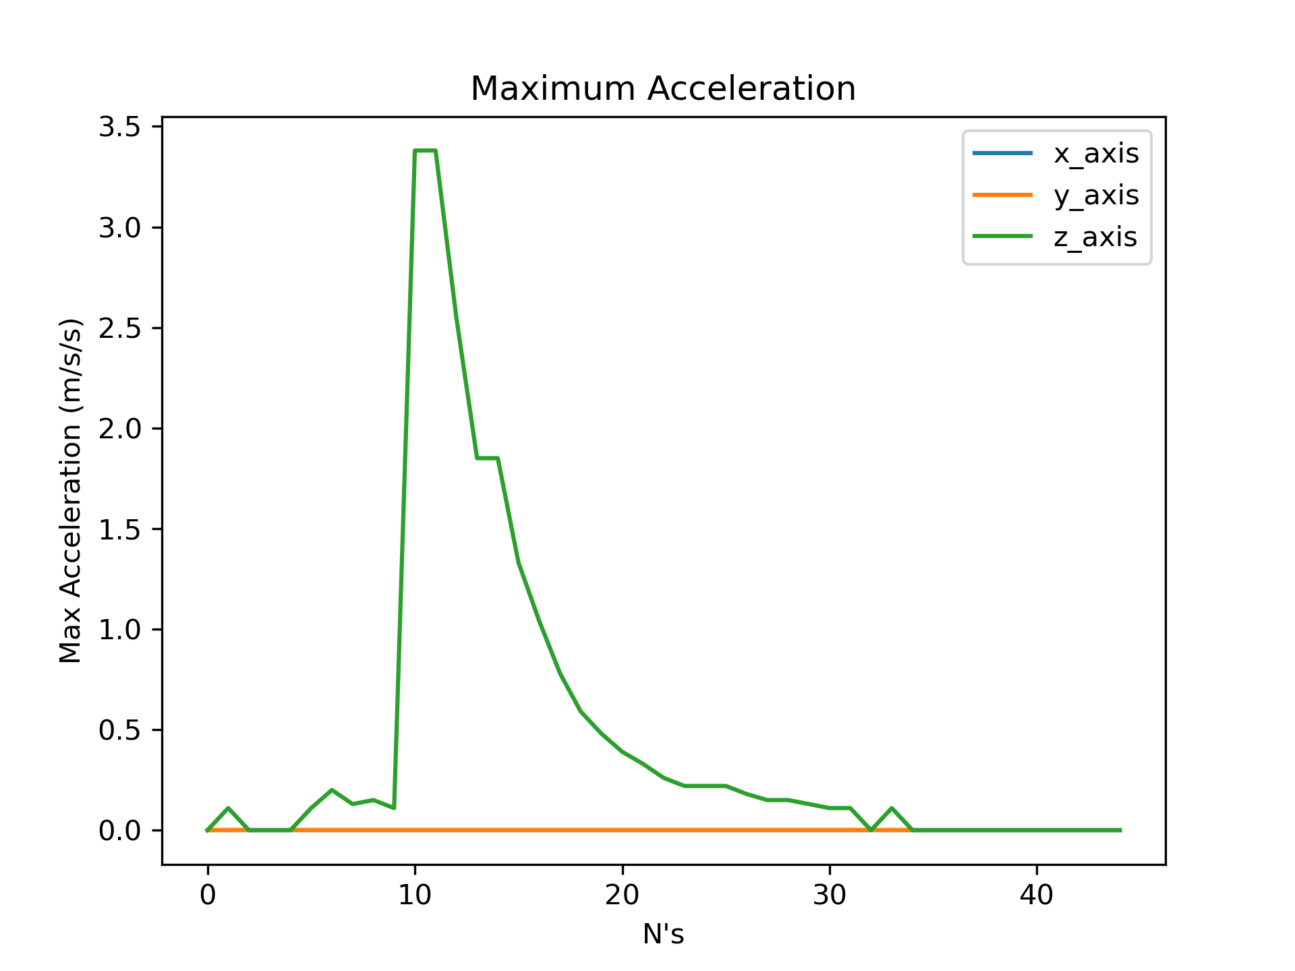
Code/serialPlot/plots/rDBma.png
