JessyBarber/Jessy-Thesis/Code/serialPlot/plots/rDd.png

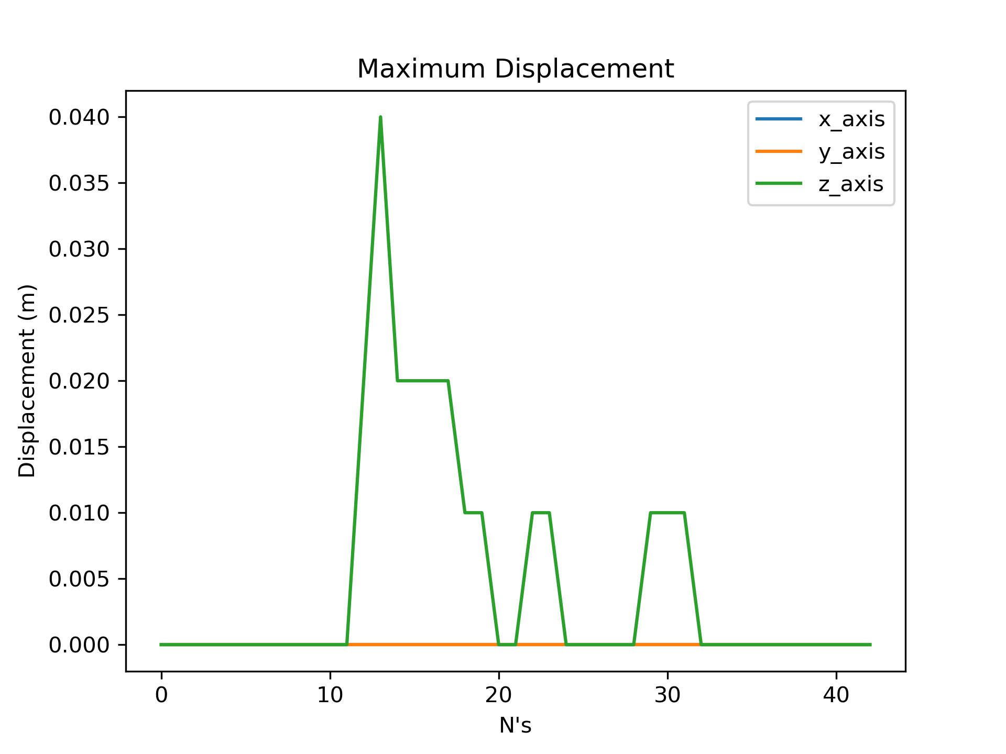
Code/serialPlot/plots/rDd.png
