JessyBarber/Jessy-Thesis/Code/serialPlot/plots/rDma.png

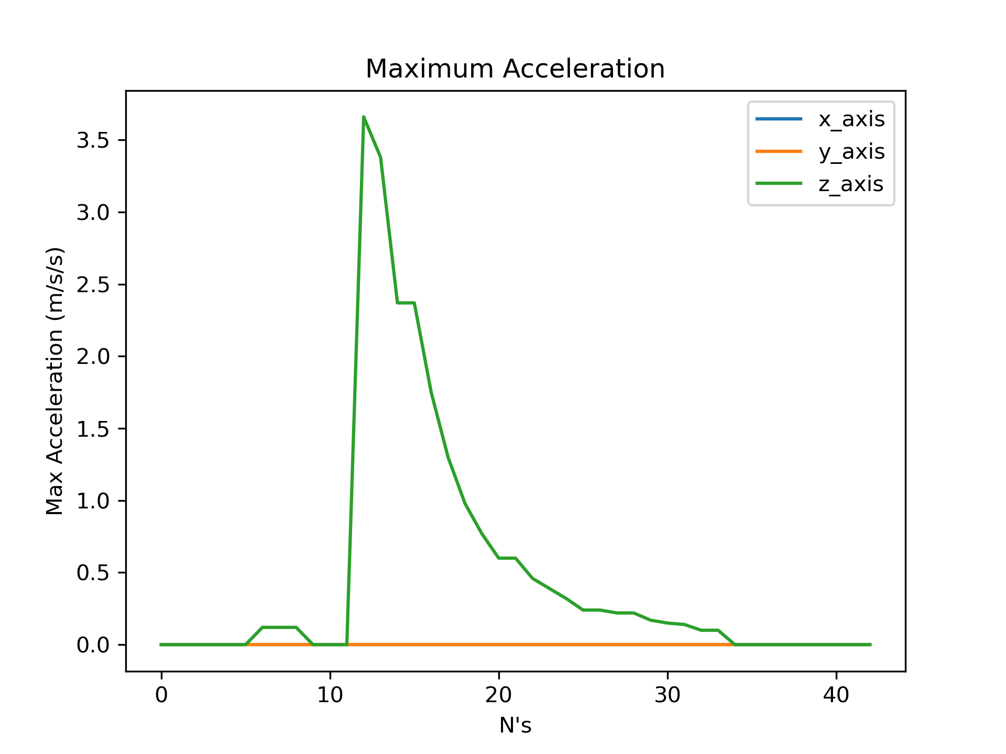
Code/serialPlot/plots/rDma.png
