JessyBarber/Jessy-Thesis/Code/serialPlot/plots/rF1fft.png

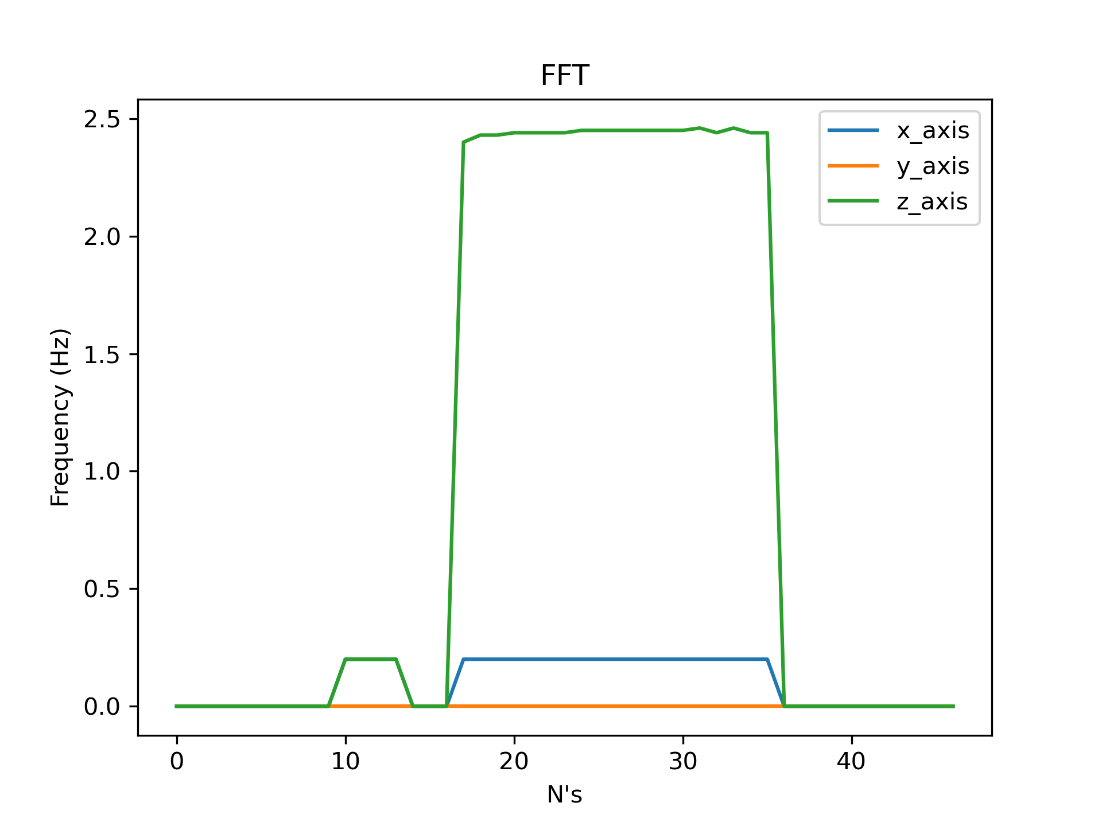
Code/serialPlot/plots/rF1fft.png
