JessyBarber/Jessy-Thesis/Code/serialPlot/plots/rF1MA.png

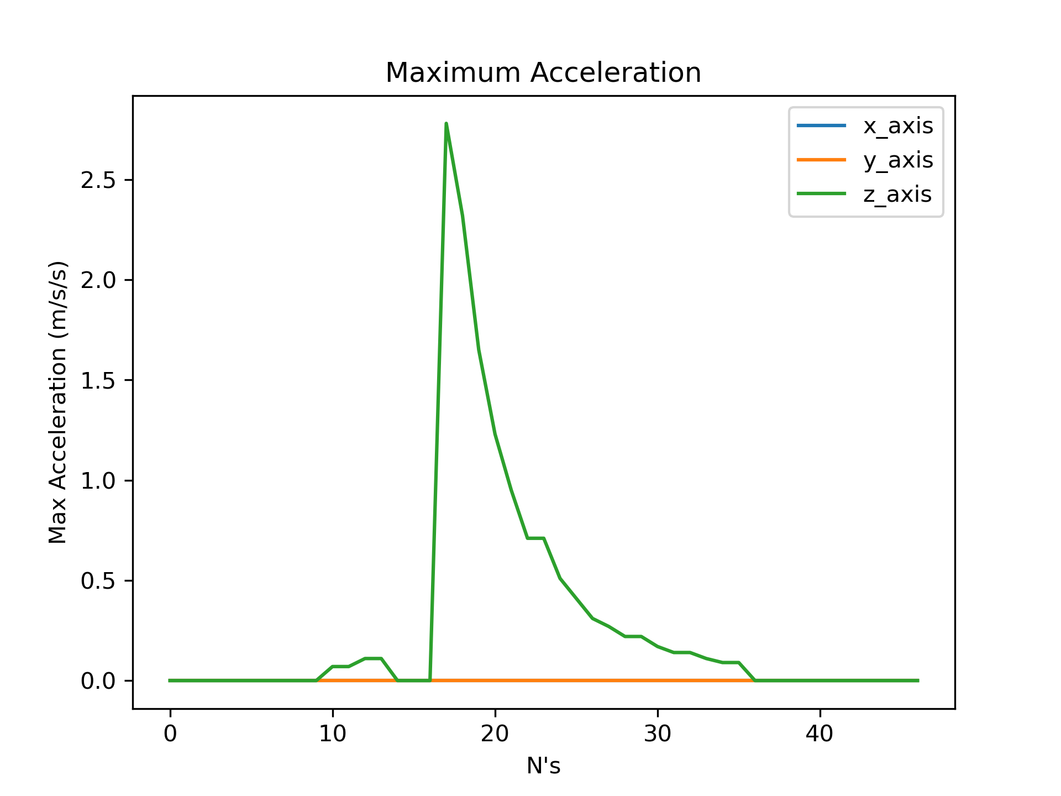
Code/serialPlot/plots/rF1MA.png
