JessyBarber/Jessy-Thesis/Code/serialPlot/plots/rFBfft.png

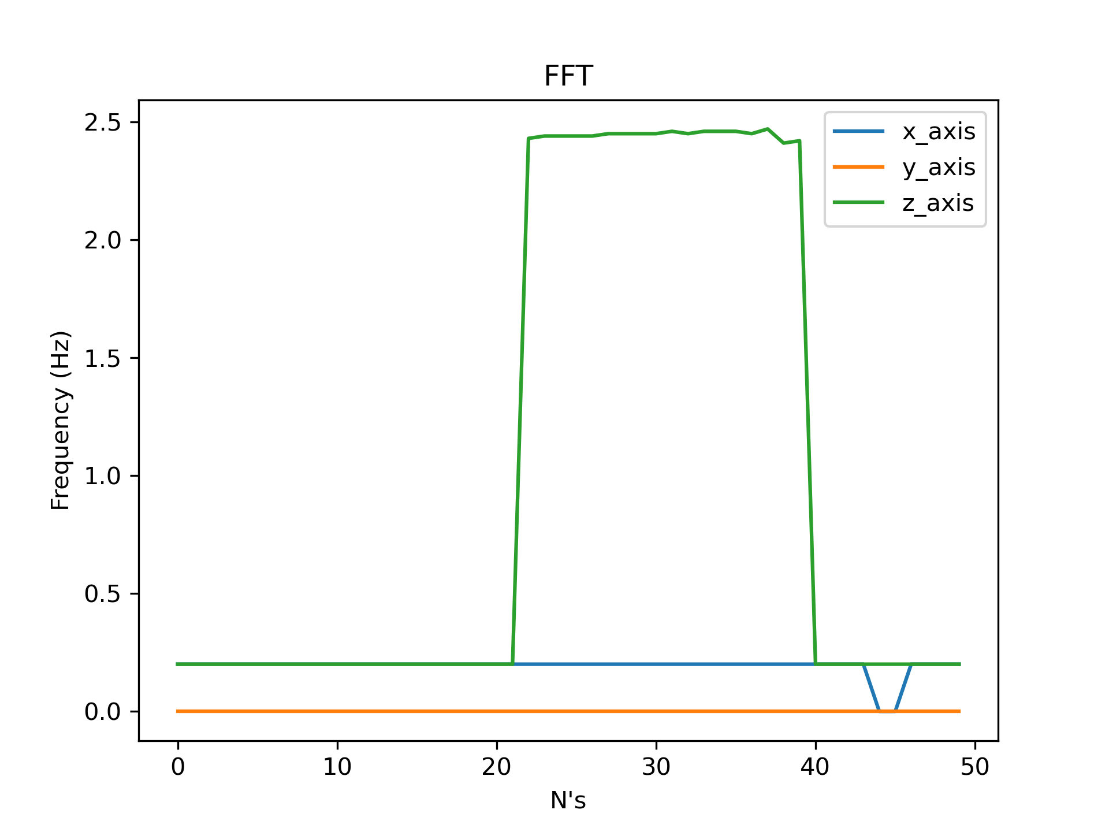
Code/serialPlot/plots/rFBfft.png
