JessyBarber/Jessy-Thesis/Code/serialPlot/plots/rFBma.png

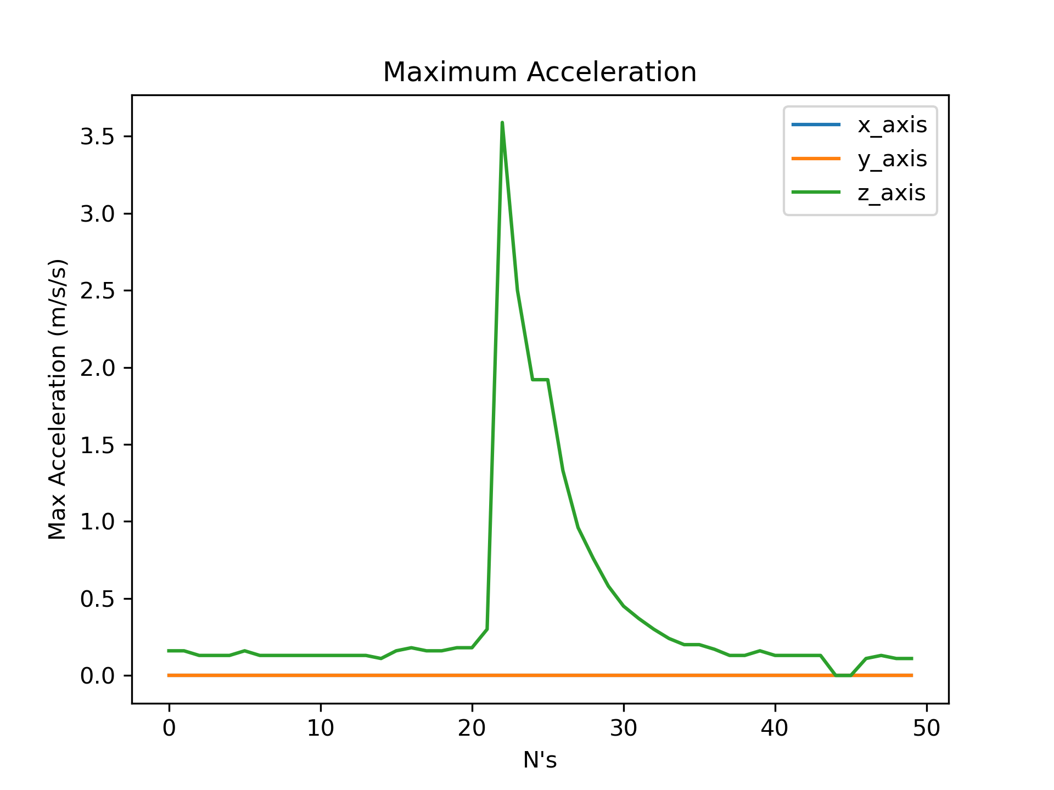
Code/serialPlot/plots/rFBma.png
