JessyBarber/Jessy-Thesis/Code/serialPlot/plots/rFLPfft.png

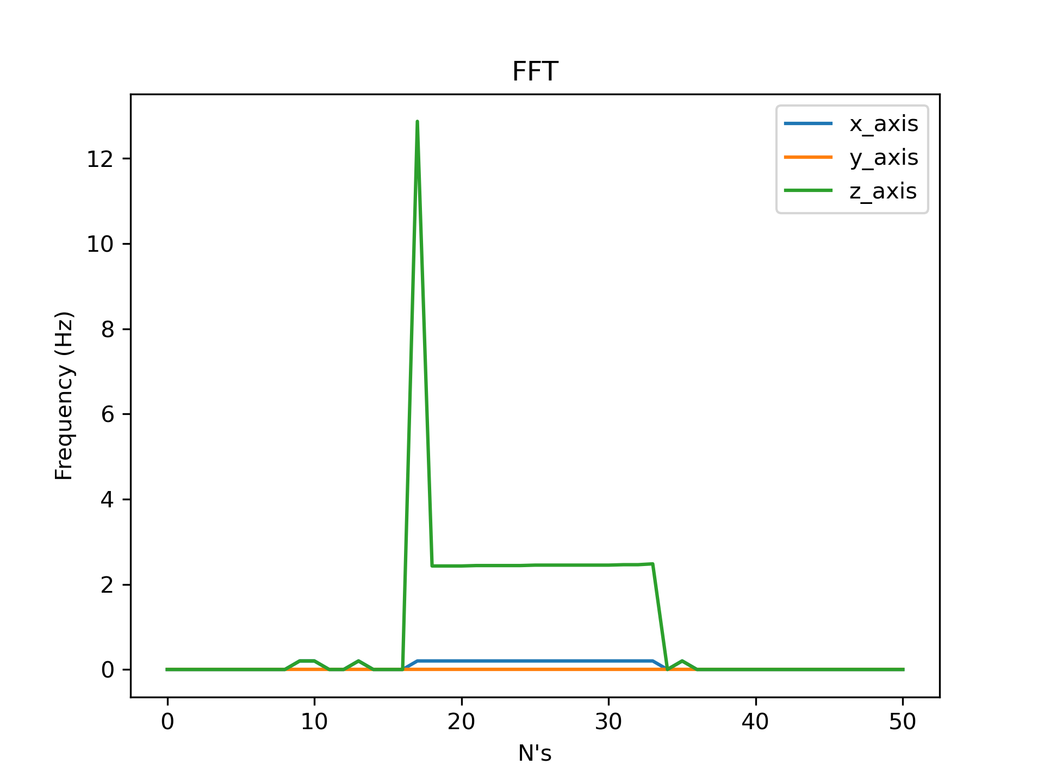
Code/serialPlot/plots/rFLPfft.png
