JessyBarber/Jessy-Thesis/Code/serialPlot/plots/rFNLPfft.png

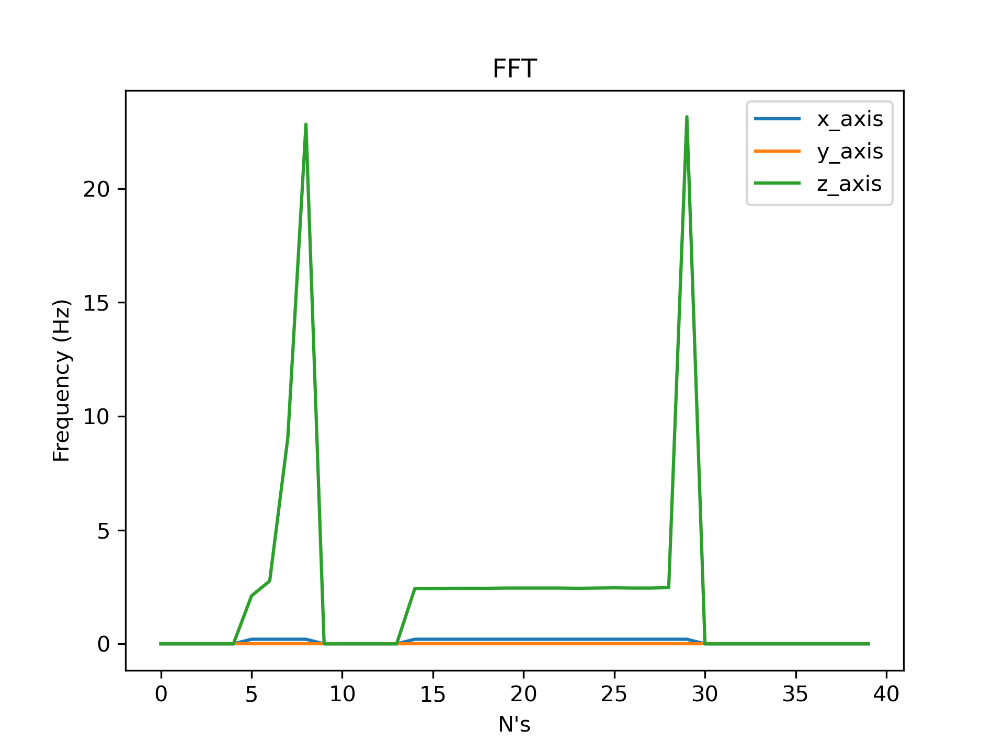
Code/serialPlot/plots/rFNLPfft.png
