JessyBarber/Jessy-Thesis/Code/serialPlot/plots/rFNLPma.png

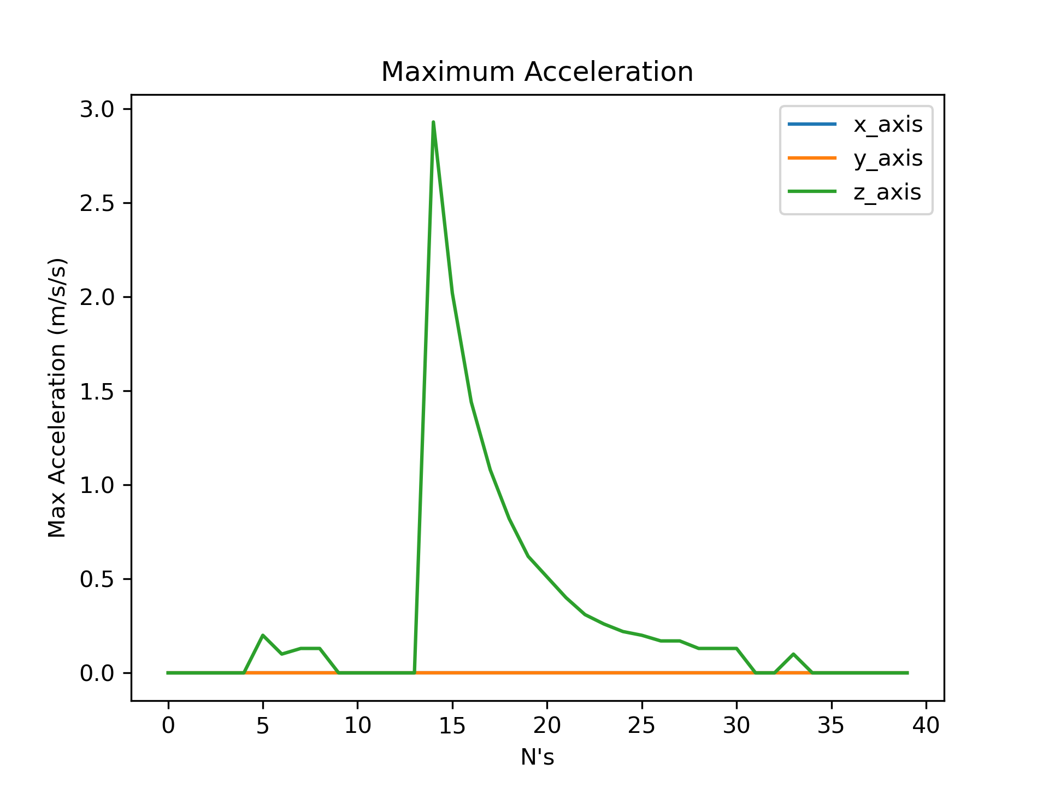
Code/serialPlot/plots/rFNLPma.png
