JessyBarber/Jessy-Thesis/Code/serialPlot/plots/rRfft.png

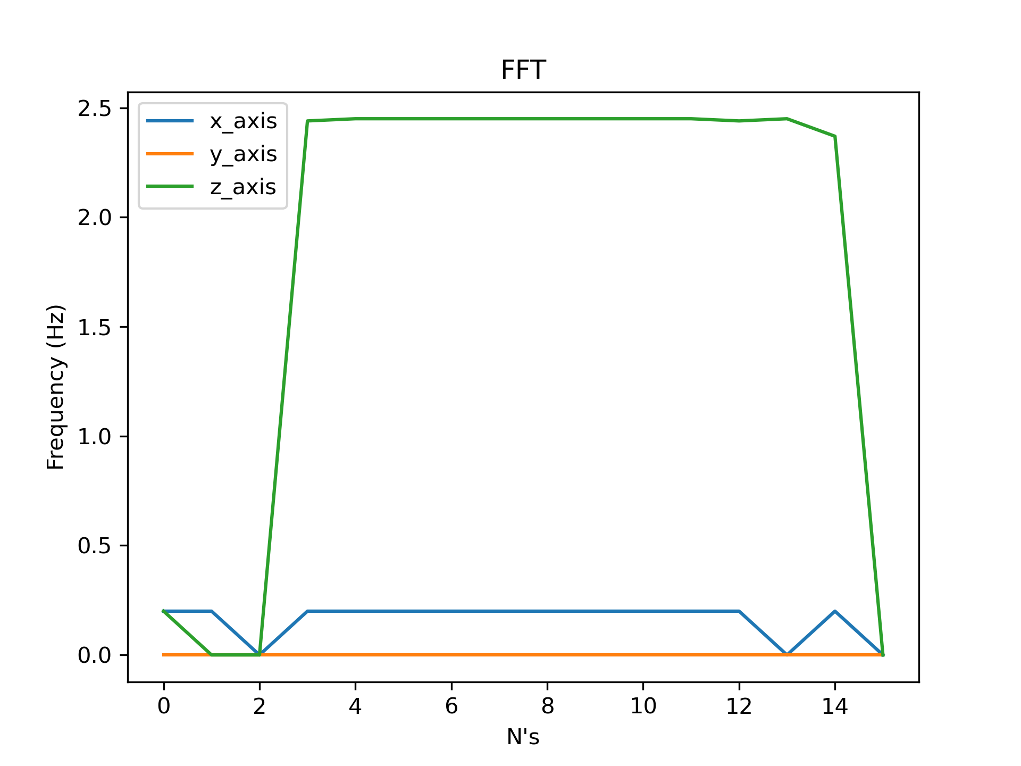
Code/serialPlot/plots/rRfft.png
