JessyBarber/Jessy-Thesis/Code/serialPlot/plots/rRma.png

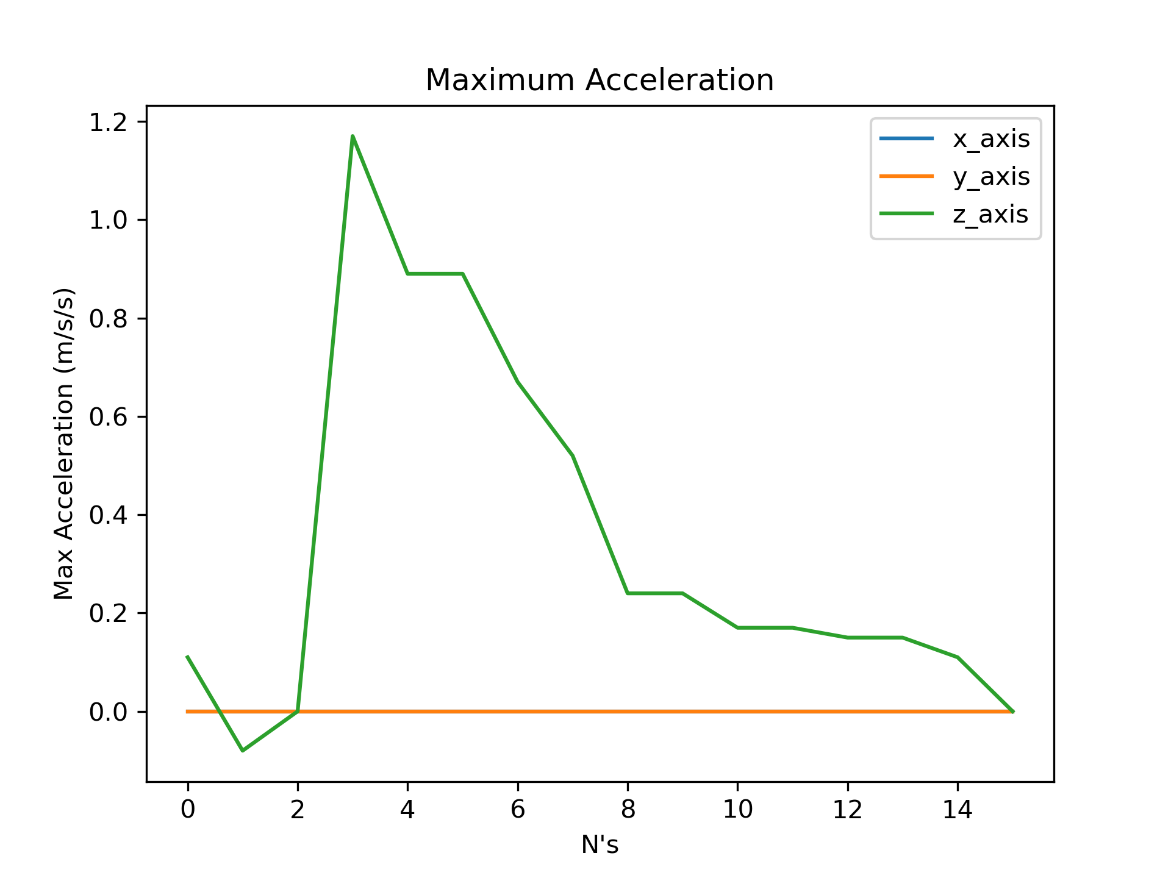
Code/serialPlot/plots/rRma.png
