JessyBarber/Jessy-Thesis/Code/serialPlot/plots/rt1fft.png

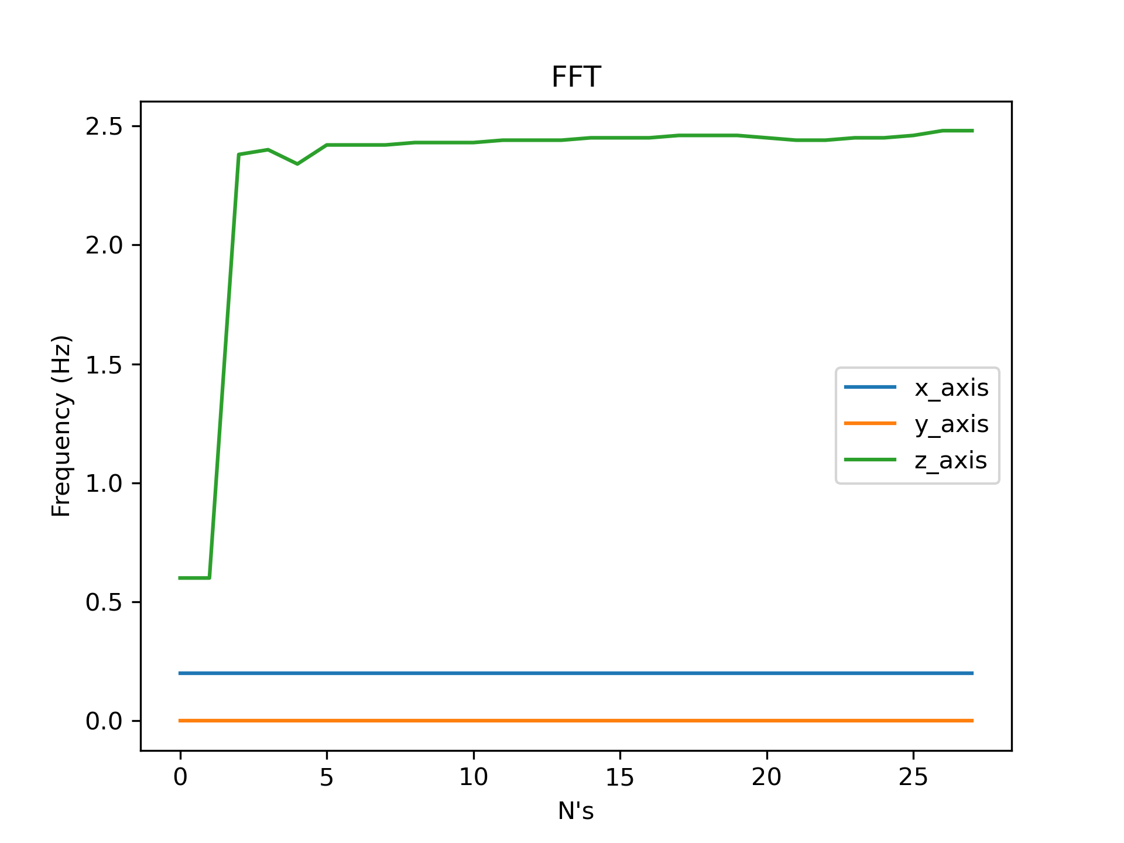
Code/serialPlot/plots/rt1fft.png
