JessyBarber/Jessy-Thesis/Code/serialPlot/plots/rt1ma.png

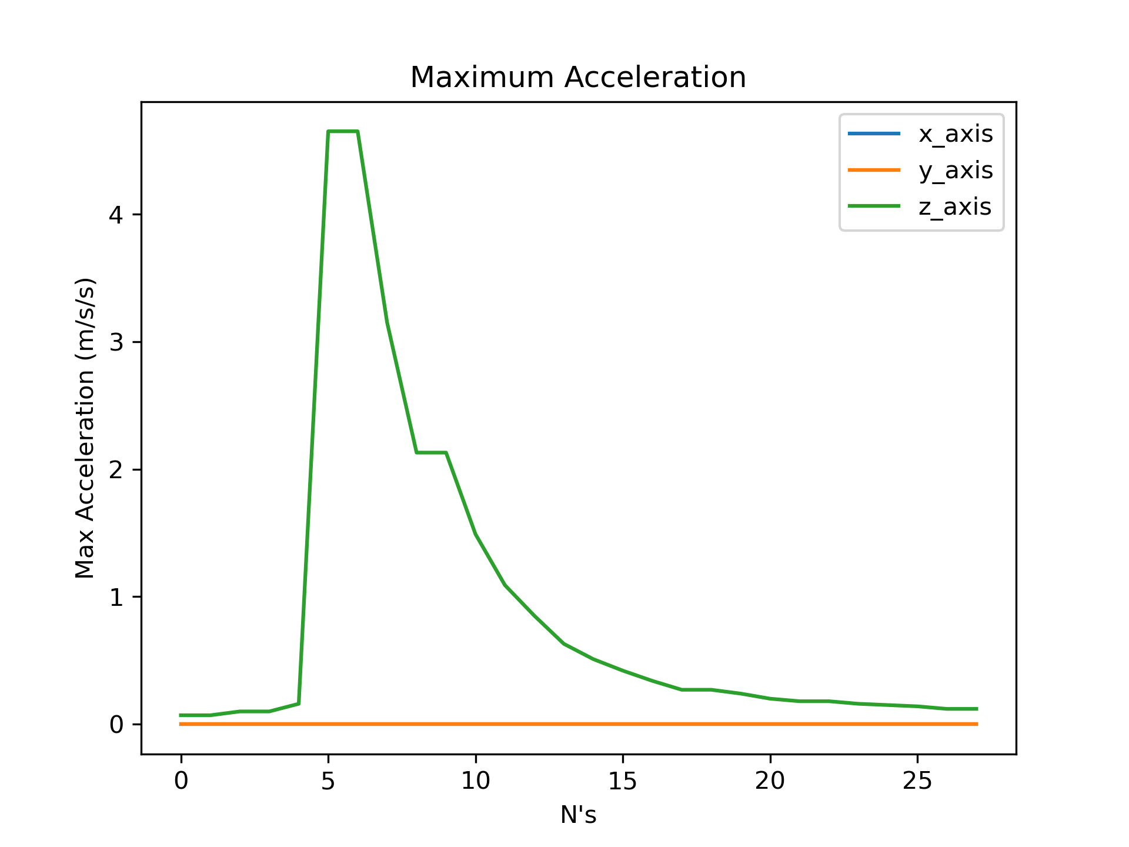
Code/serialPlot/plots/rt1ma.png
