JessyBarber/Jessy-Thesis/Code/serialPlot/plots/rt5ma.png

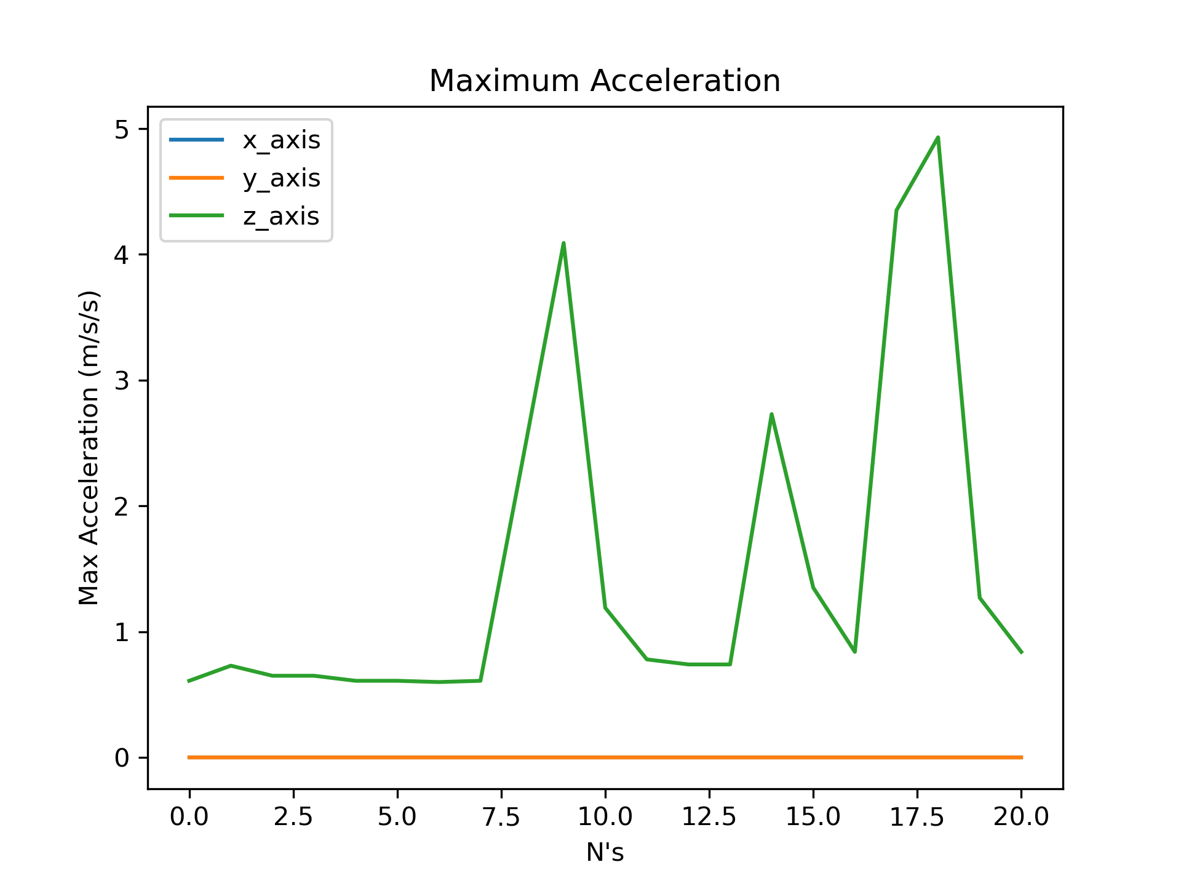
Code/serialPlot/plots/rt5ma.png
