JessyBarber/Jessy-Thesis/Code/serialPlot/plots/sFLP.png

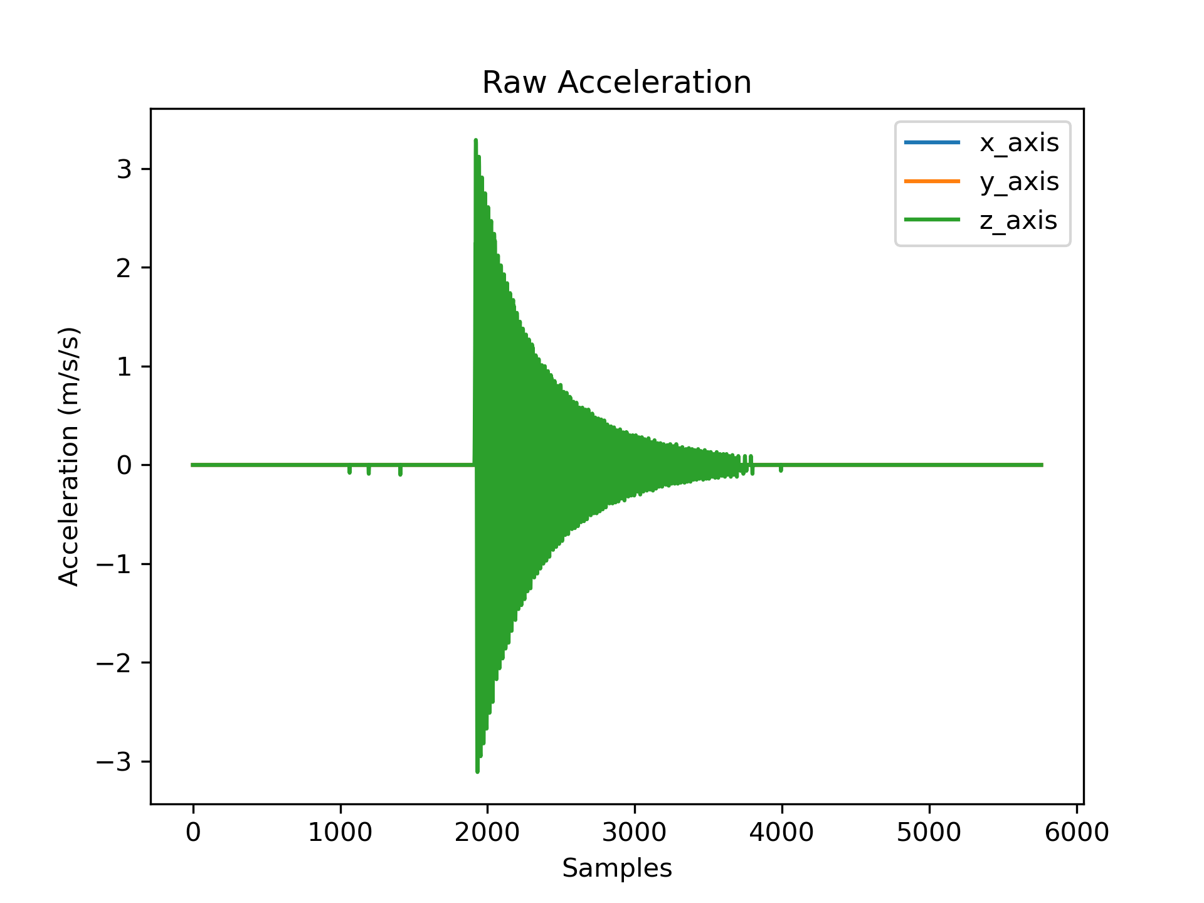
Code/serialPlot/plots/sFLP.png
