JessyBarber/Jessy-Thesis/Code/serialPlot/plots/sFNLP.png

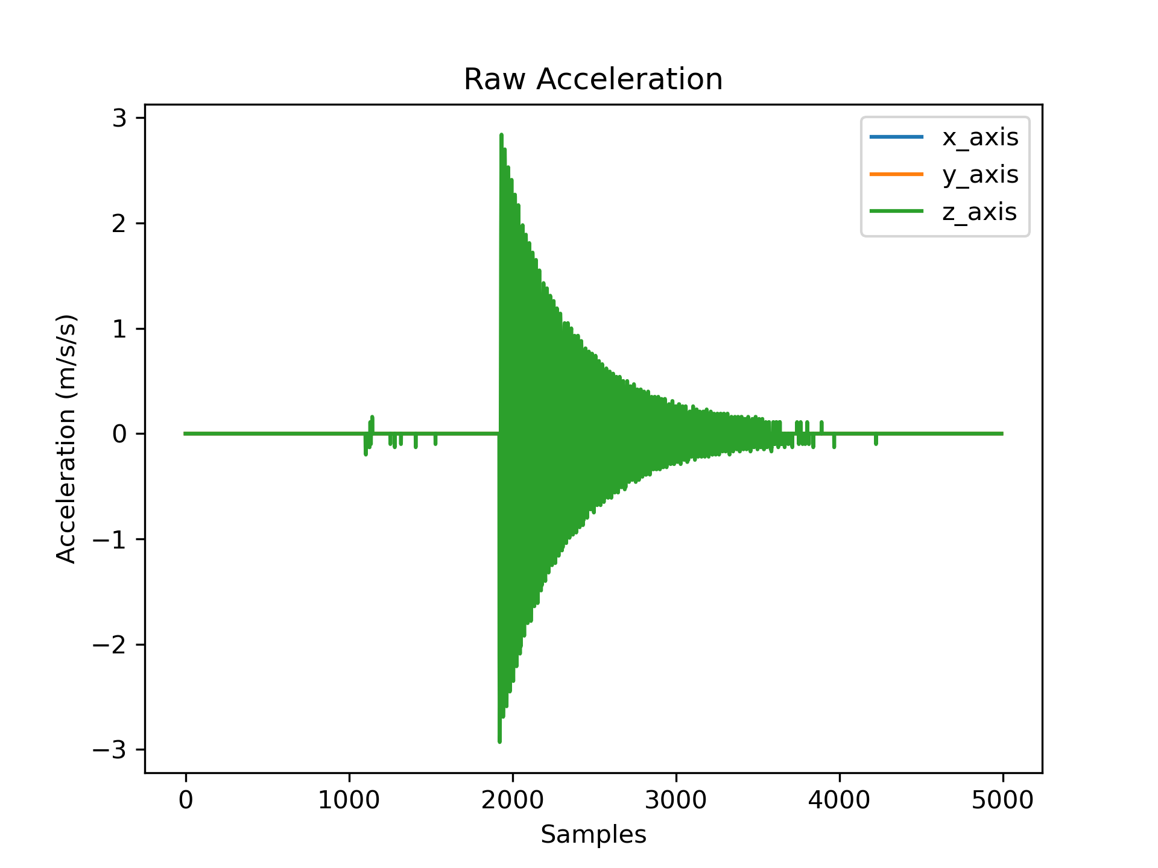
Code/serialPlot/plots/sFNLP.png
