JessyBarber/Jessy-Thesis/Code/serialPlot/plots/st1.png

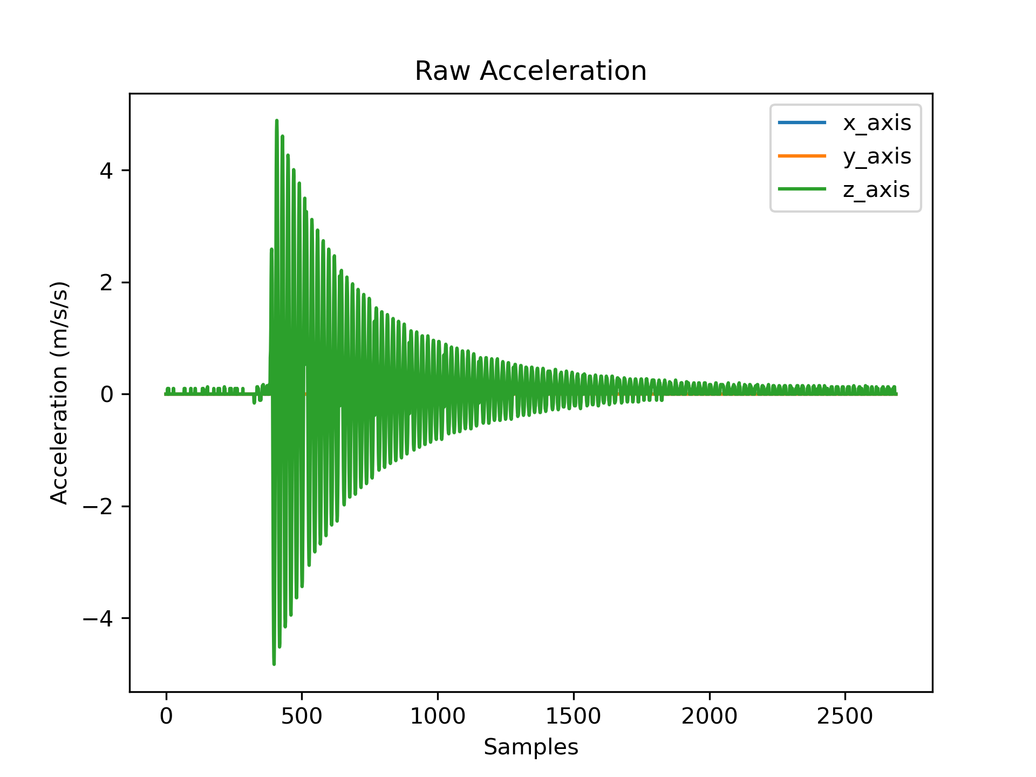
Code/serialPlot/plots/st1.png
