JessyBarber/Jessy-Thesis/Interview/consent form.jpg

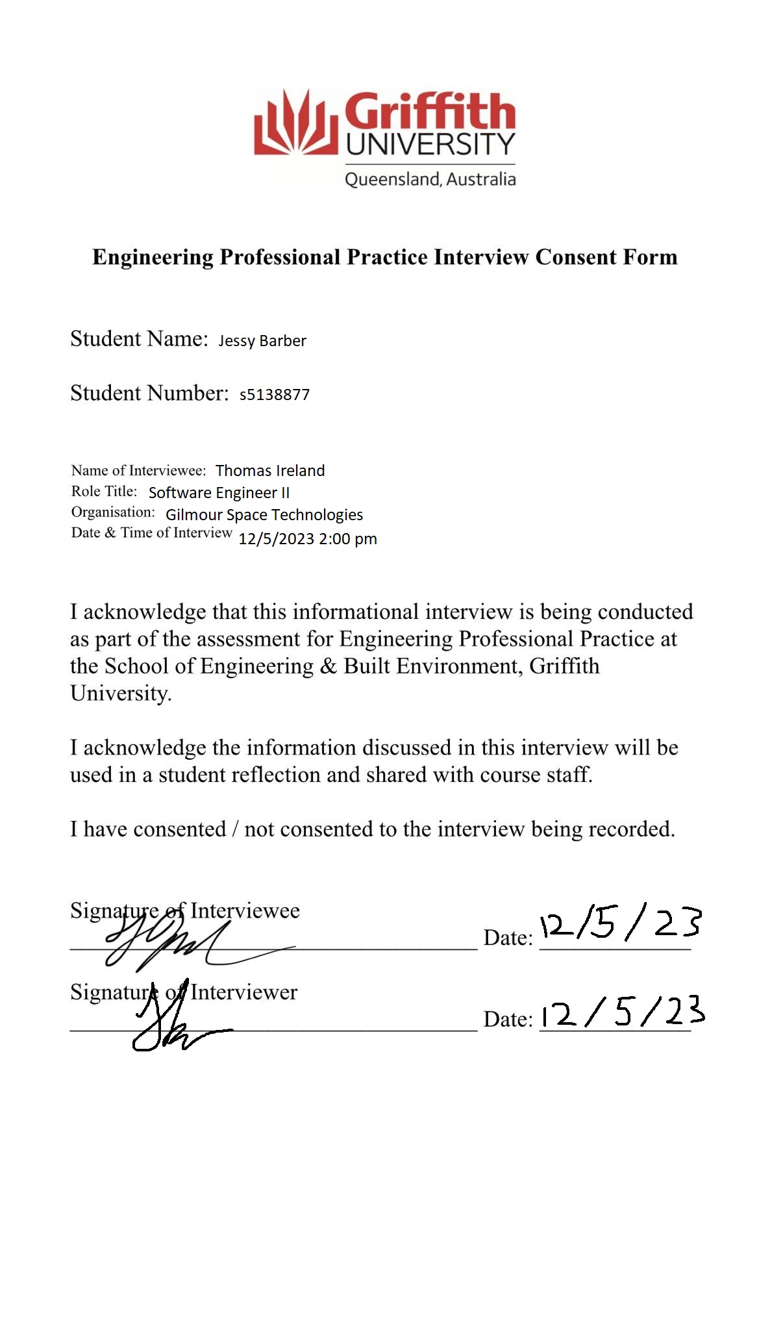
Interview/consent form.jpg
