JessyBarber/Jessy-Thesis/Poster/9-Figure5-1.png

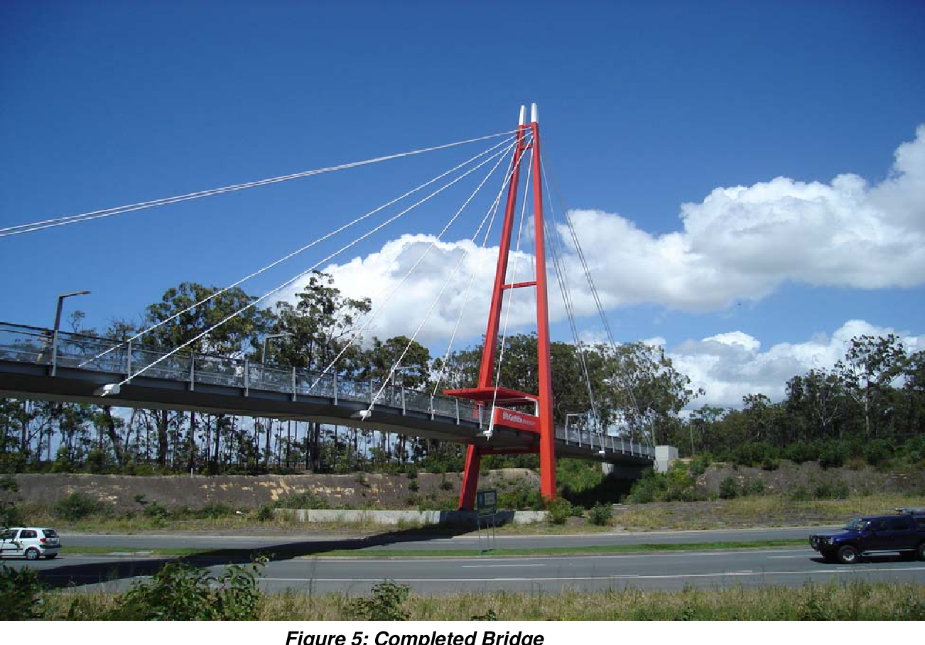
Poster/9-Figure5-1.png
