JessyBarber/Jessy-Thesis/Poster/344795886_979308416840797_6847414806290104091_n.jpg

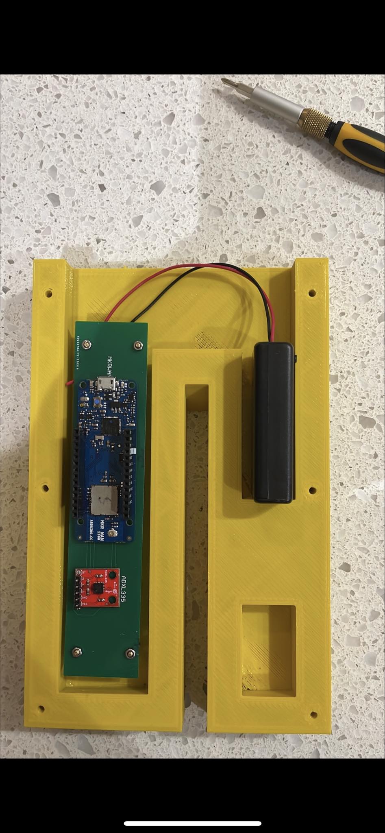
Poster/344795886_979308416840797_6847414806290104091_n.jpg
