JessyBarber/Jessy-Thesis/Poster/345075089_225211823628120_8395305061642345078_n.jpg

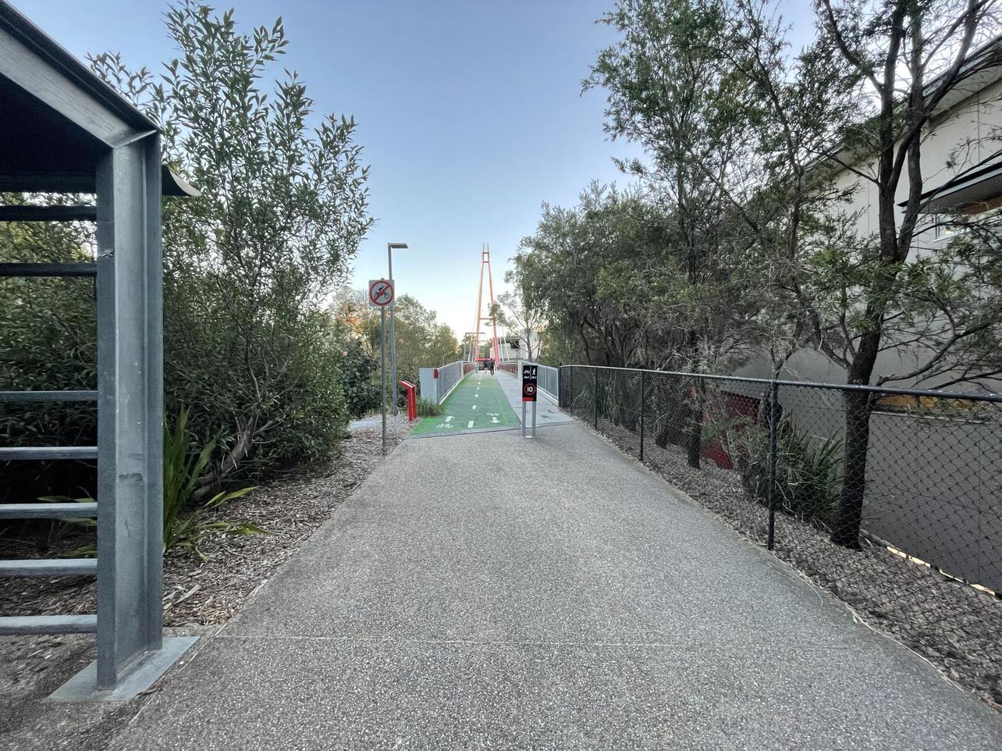
Poster/345075089_225211823628120_8395305061642345078_n.jpg
