JessyBarber/Jessy-Thesis/Poster/351194389_763414572176267_4411843484989981273_n.jpg

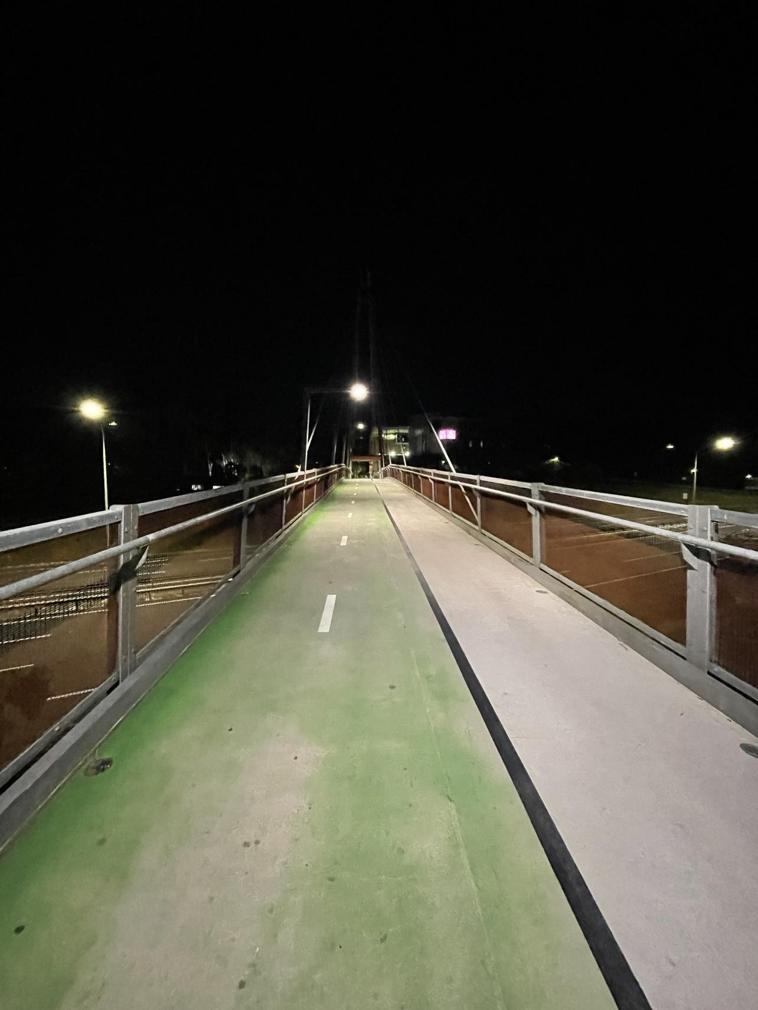
Poster/351194389_763414572176267_4411843484989981273_n.jpg
