JessyBarber/Jessy-Thesis/Poster/MicrosoftTeams-image (2).png

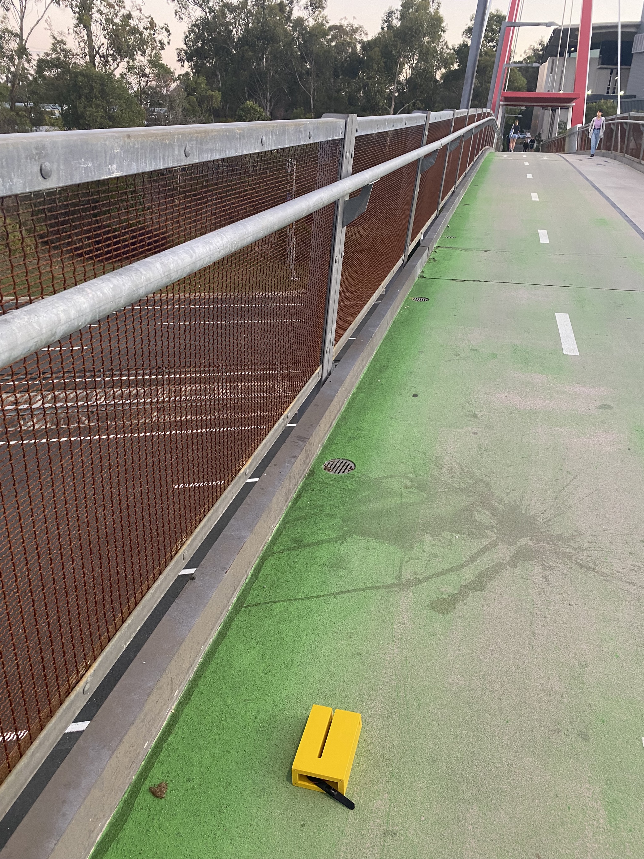
Poster/MicrosoftTeams-image (2).png
