JessyBarber/Jessy-Thesis/Poster/MicrosoftTeams-image (3).png

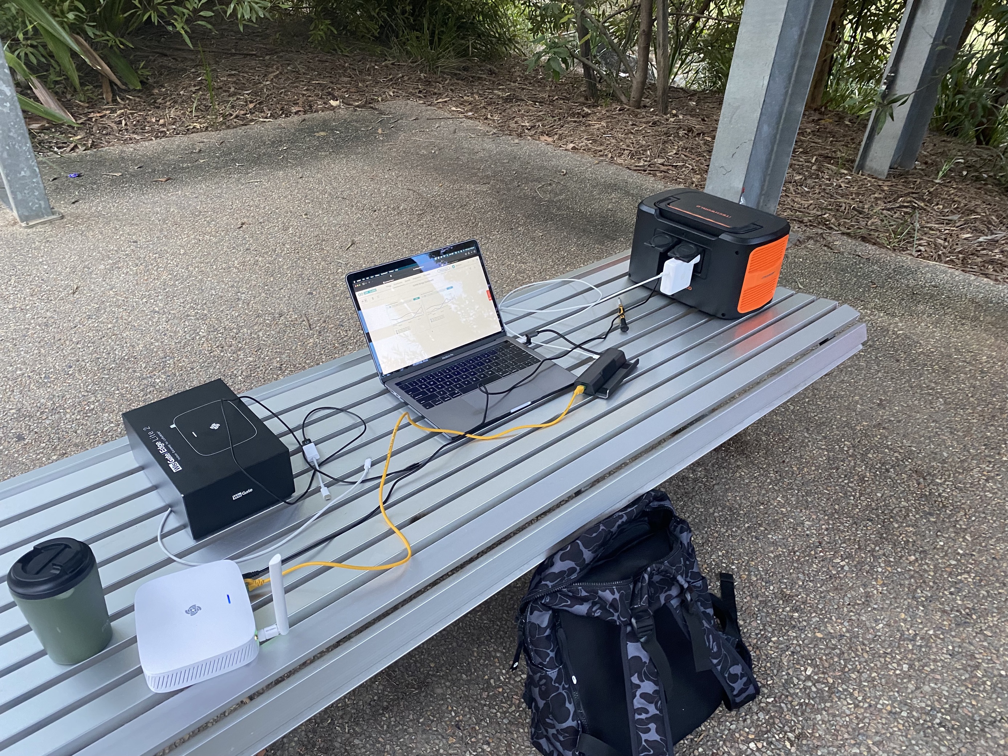
Poster/MicrosoftTeams-image (3).png
