JessyBarber/Jessy-Thesis/Poster/MicrosoftTeams-image (4).png

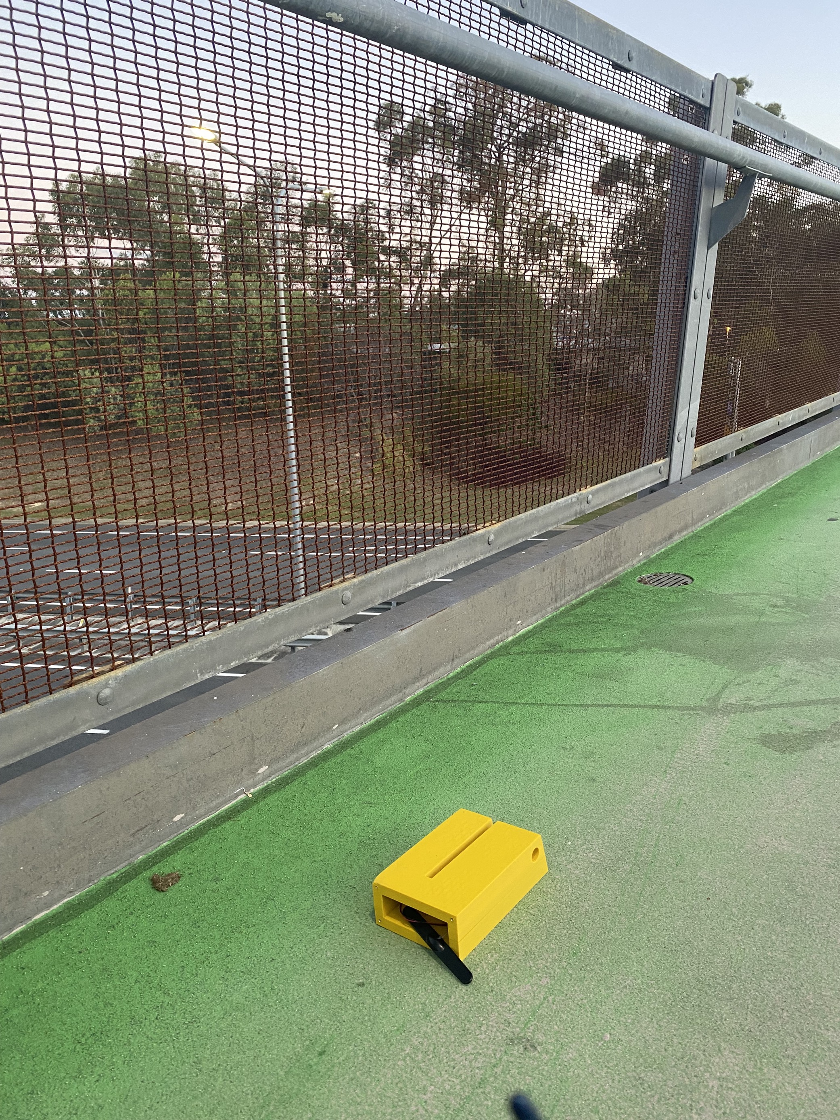
Poster/MicrosoftTeams-image (4).png
