JessyBarber/Jessy-Thesis/Poster/MicrosoftTeams-image (5).png

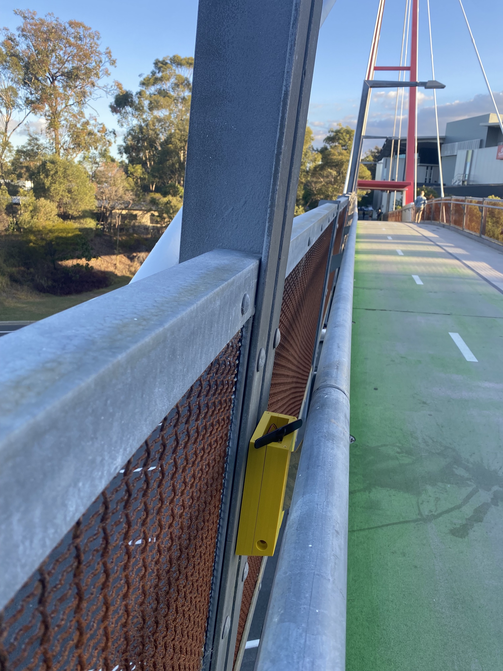
Poster/MicrosoftTeams-image (5).png
