JessyBarber/Jessy-Thesis/Poster/MicrosoftTeams-image (6).png

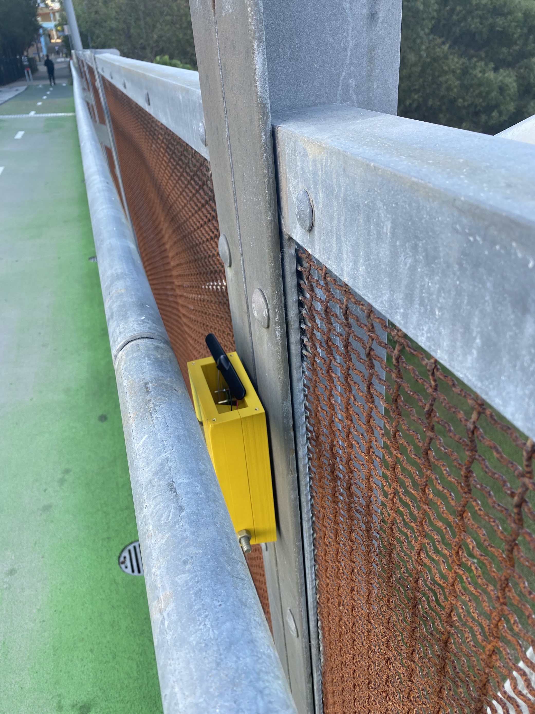
Poster/MicrosoftTeams-image (6).png
