JessyBarber/Jessy-Thesis/Poster/MicrosoftTeams-image (7).png

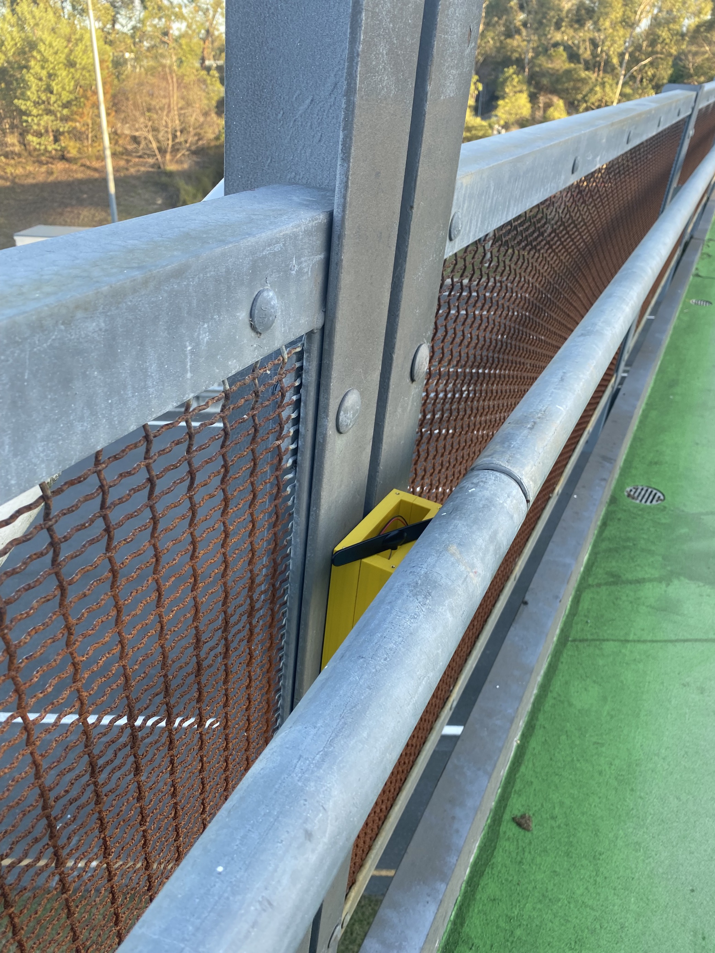
Poster/MicrosoftTeams-image (7).png
