JessyBarber/Jessy-Thesis/Project Planning Report/Images/Gantt-Chart2.png

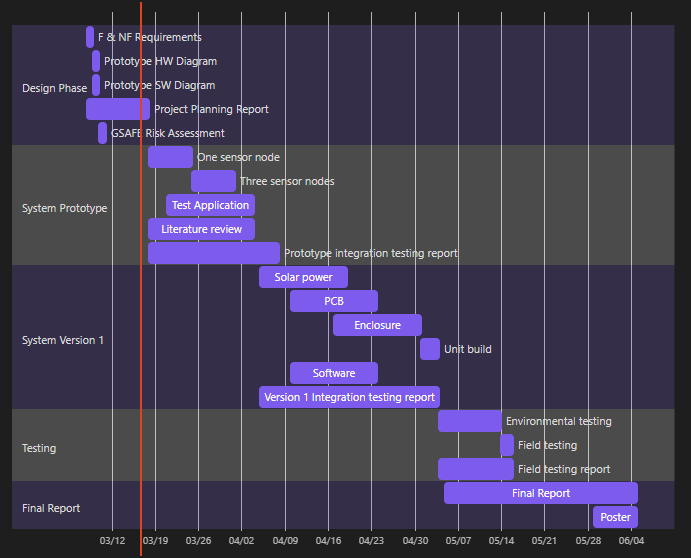
Project Planning Report/Images/Gantt-Chart2.png
