JessyBarber/Jessy-Thesis/Enclosure/Enclosure_Base_Split/Enclosure_Base_Back.step

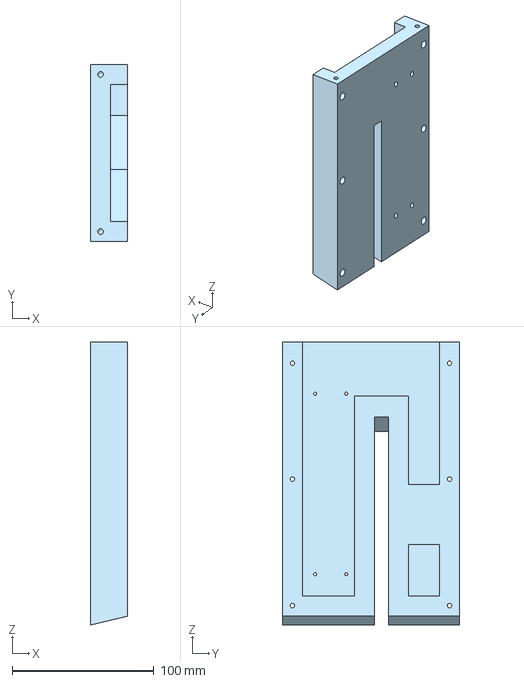
[picture p142: CAD file, 2023-05-24]
Enclosure/Enclosure_Base_Split/Enclosure_Base_Back.step
26.0 x 125.0 x 200.0 mm
