JessyBarber/Jessy-Thesis/Enclosure/Enclosure_Lid_V2.stl

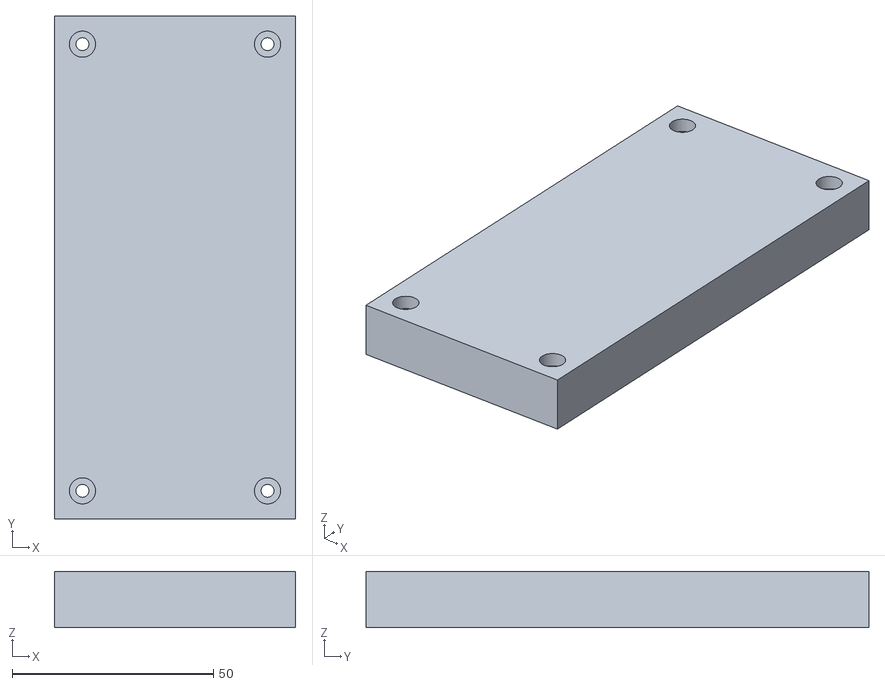
[picture p143: CAD file, 2023-05-28]
Enclosure/Enclosure_Lid_V2.stl
60.0 x 125.0 x 14.0
