JessyBarber/Jessy-Thesis/PCB/lora-carrier-board/lora-carrier-board.step

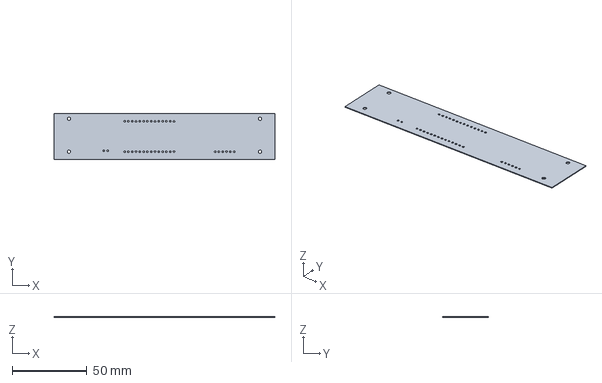
[picture p144: CAD file, 2023-05-21]
PCB/lora-carrier-board/lora-carrier-board.step
147.6 x 31.0 x 0.411 mm
