JessyBarber/Jessy-Thesis/Enclosure/Enclosure_Base_Split/Enclosure_Base_Front.step

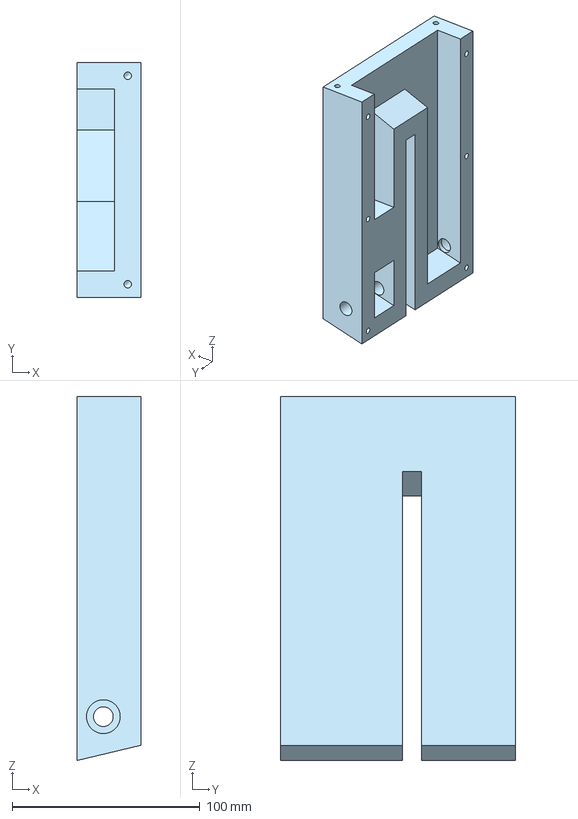
[picture p145: CAD file, 2023-05-24]
Enclosure/Enclosure_Base_Split/Enclosure_Base_Front.step
34.0 x 125.0 x 193.8 mm
