JessyBarber/Jessy-Thesis/Enclosure/Enclosure_Base_Split/Enclosure_Lid.step

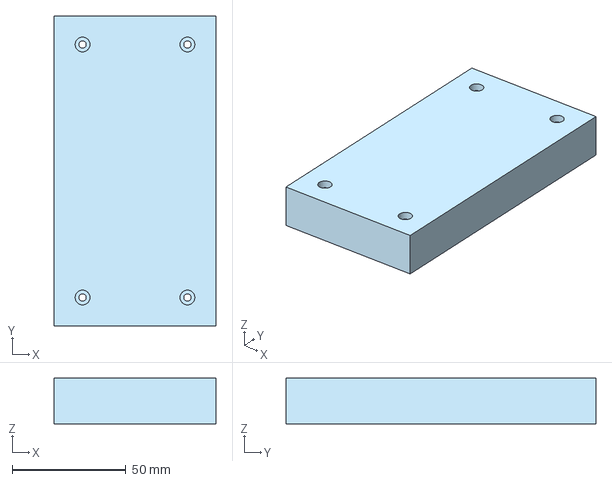
[picture p146: CAD file, 2023-05-24]
Enclosure/Enclosure_Base_Split/Enclosure_Lid.step
71.0 x 136.0 x 20.0 mm
