JessyBarber/Jessy-Thesis/(list of files, cad)

Other CAD files:
Enclosure/Enclosure_Lid.stl
Enclosure/Enclosure_Base_Split/Enclosure_Base_Back.stl
Enclosure/Enclosure_Base_Split/Enclosure_Base_Front.stl
