JessyBarber/Jessy-Thesis/Final Report/Tables/software-steps-1.xlsx

Step | Process
1
2
3
4
5
6
7
8
9
10
11
12
