JessyBarber/Jessy-Thesis/Code/serialPlot/Tests/Test2/README.rtf

Testing filter coefficients (alpha) for low pass filter.
Tests:
- SFTest2 is alpha = 0.3827 -> Fc = 5Hz
- SFTest3 is alpha = 0.3394 -> Fc = 4Hz
- We dropped beam 10cm
