JessyBarber/Jessy-Thesis/Final Report/Final Report/test.tex

\documentclass[12pt]{article}

\usepackage[numbers]{natbib}
\bibliographystyle{IEEEtran}

\begin{document}

test \cite{WSN-WaterQual}

\bibliography{References}

\end{document}
