JessyBarber/Jessy-Thesis/bridge-results.xlsx

Sheet: Experiment1
Experiment 1 (0.05, 0.05, 0.03)
 | Frequency (Hz) |  |  | Acceleration (m/s/s) |  |  | Signal
Time | x-axis | y-axis | z-axis | x-axis | y-axis | z-axis | SNR | RSSI
16:15:20 | 0.108 | 0.03 | 3.193 | 0.055 | 0.034 | 0.06 | 15.25 | -73
16:16:20 | 0.223 | 0.108 | 2.386 | 0.007 | 0.011 | 0.037 | 13.5 | -74
16:17:20 | 0.177 | -0.001 | 4.38 | 0.013 | 0.006 | 0.044 | 13.5 | -66
16:18:20 | 0.22 | 0.02 | 2.975 | 0.015 | 0 | 0.036 | 1.5 | -110
16:19:20 | 0.137 | 1.972 | 2.34 | 0.006 | 0.011 | 0.042 | 14.25 | -74
16:20:30 | 0.286 | 0.029 | 2.029 | 0.019 | 0 | 0.038 | 14 | -62
16:21:30 | 0.499 | 0.228 | 2.054 | 0.029 | 0.006 | 0.045 | 14 | -62
16:22:30 | 0.109 | 0.038 | 2.157 | 0.007 | 0.005 | 0.034 | 12.5 | -78
16:23:30 | 0.192 | 0.085 | 2.248 | - | 0.012 | 0.051 | 13 | -78
16:24:40 | 0.21 | 0.139 | 2.742 | 0.015 | 0.01 | 0.035 | 13.5 | -77
16:25:40 | 0.137 | 0.01 | 2.099 | 0.007 | 0 | 0.044 | 10 | -76
16:26:40 | 0.391 | 0.029 | 2.202 | 0.02 | - | 0.045 | 12.75 | -75
16:27:40 | 0.176 | 0.01 | 2.895 | 0.007 | - | 0.039 | 11 | -86
16:28:40 | 0.192 | 0.153 | 3.073 | - | 0.01 | 0.04 | 13.5 | -73
16:29:50 | 1.659 | 0.172 | 2.047 | 0.071 | 0.011 | 0.036 | 14 | -75
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
