JessyBarber/Jessy-Thesis/Code/serialPlot/Tests/Test1/Plots/rF0.5FFT.png

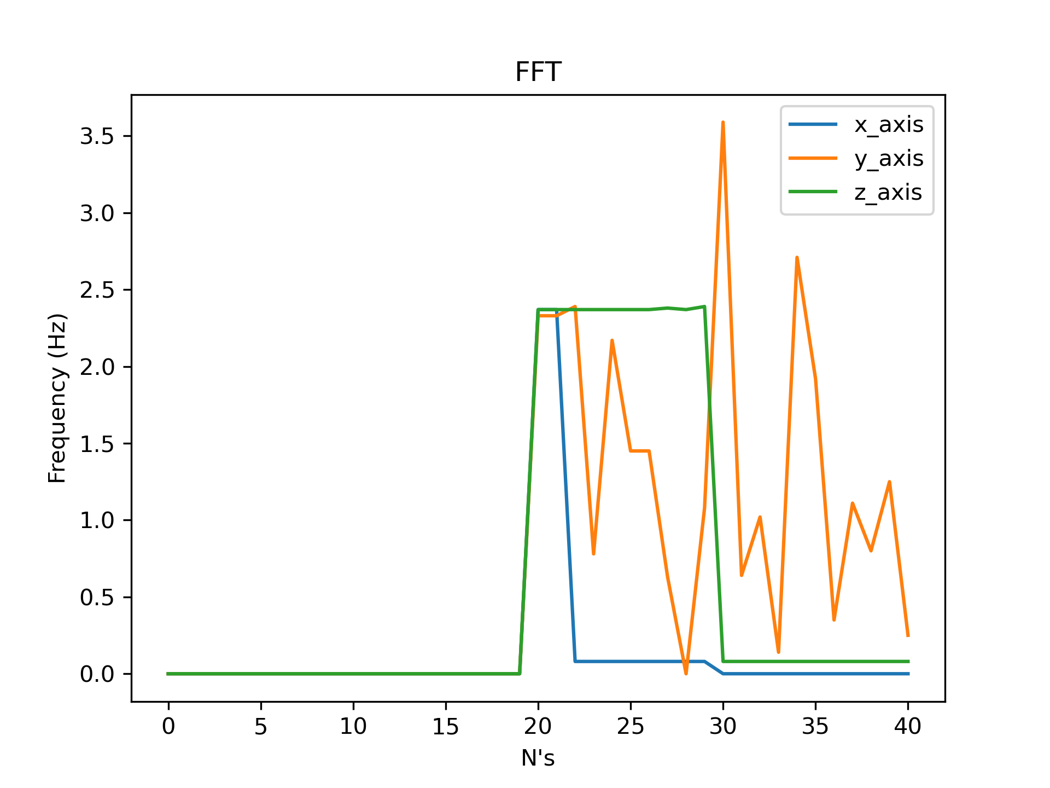
Code/serialPlot/Tests/Test1/Plots/rF0.5FFT.png
