JessyBarber/Jessy-Thesis/Code/serialPlot/Tests/Test1/Plots/rF0.5MA.png

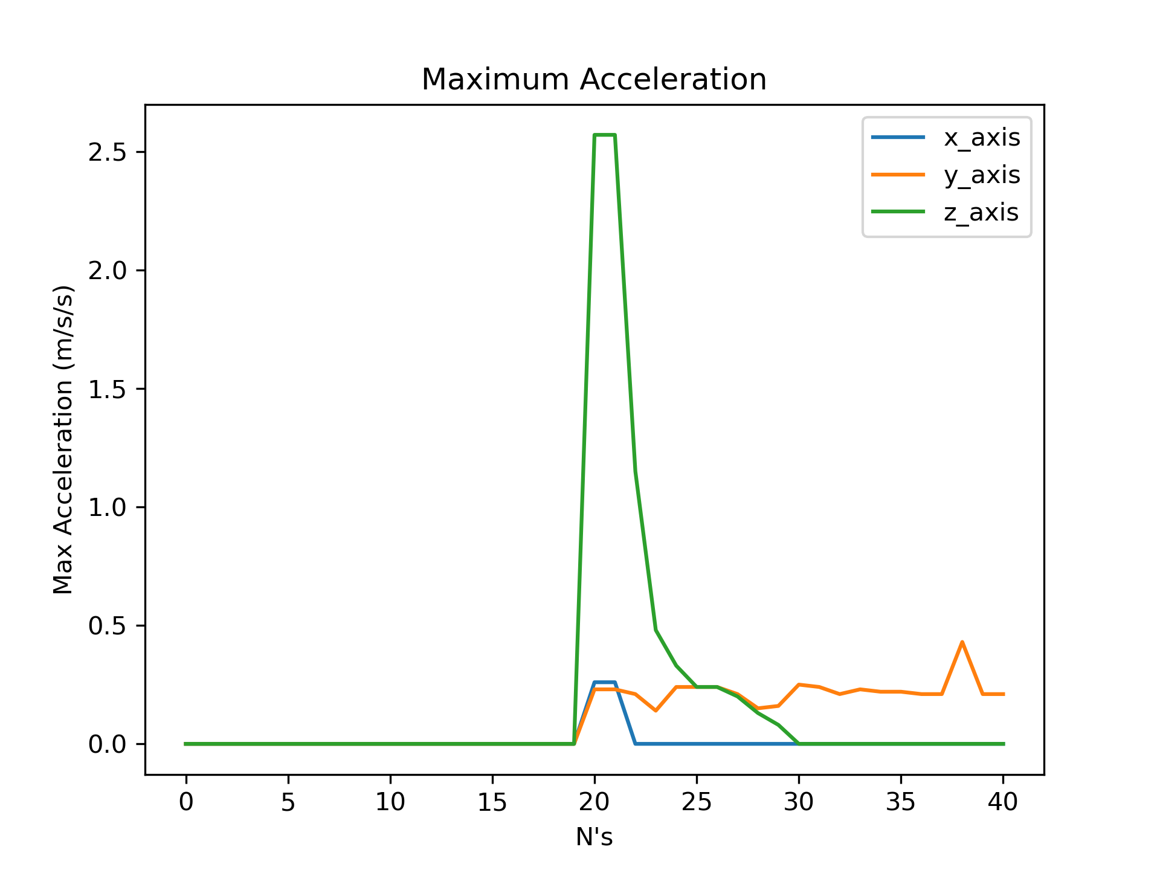
Code/serialPlot/Tests/Test1/Plots/rF0.5MA.png
