JessyBarber/Jessy-Thesis/Code/serialPlot/Tests/Test1/Plots/rfFFT.png

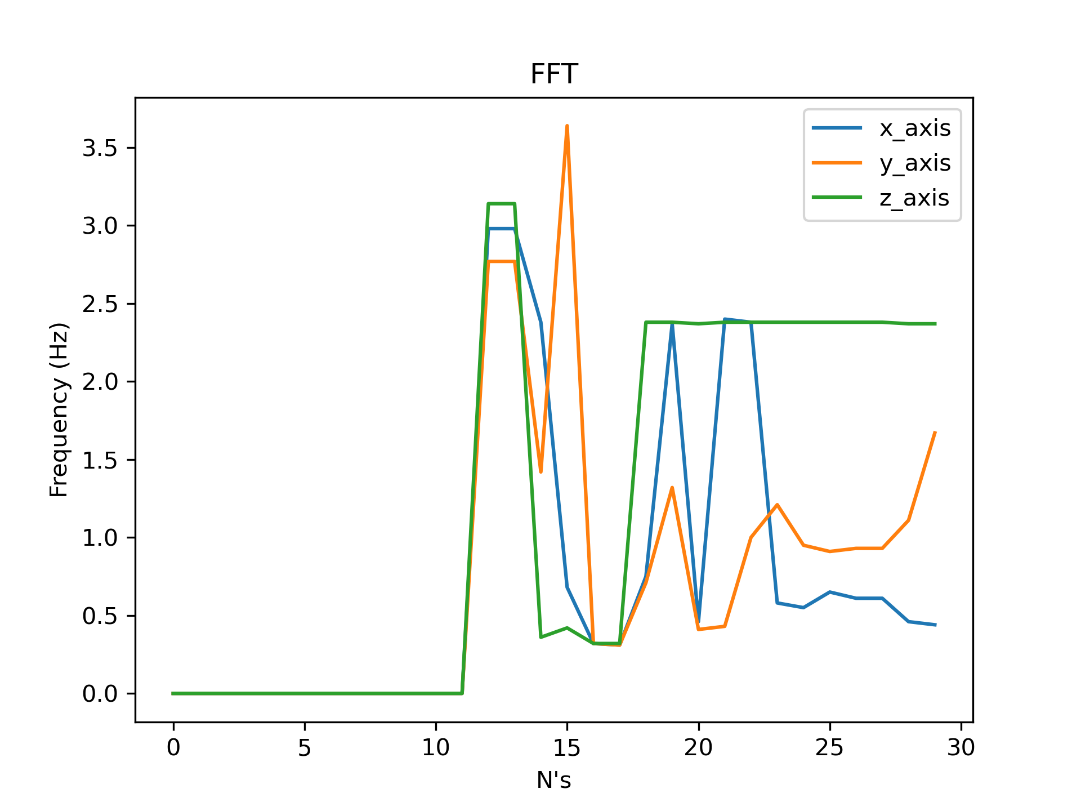
Code/serialPlot/Tests/Test1/Plots/rfFFT.png
