JessyBarber/Jessy-Thesis/Code/serialPlot/Tests/Test1/Plots/rfMA.png

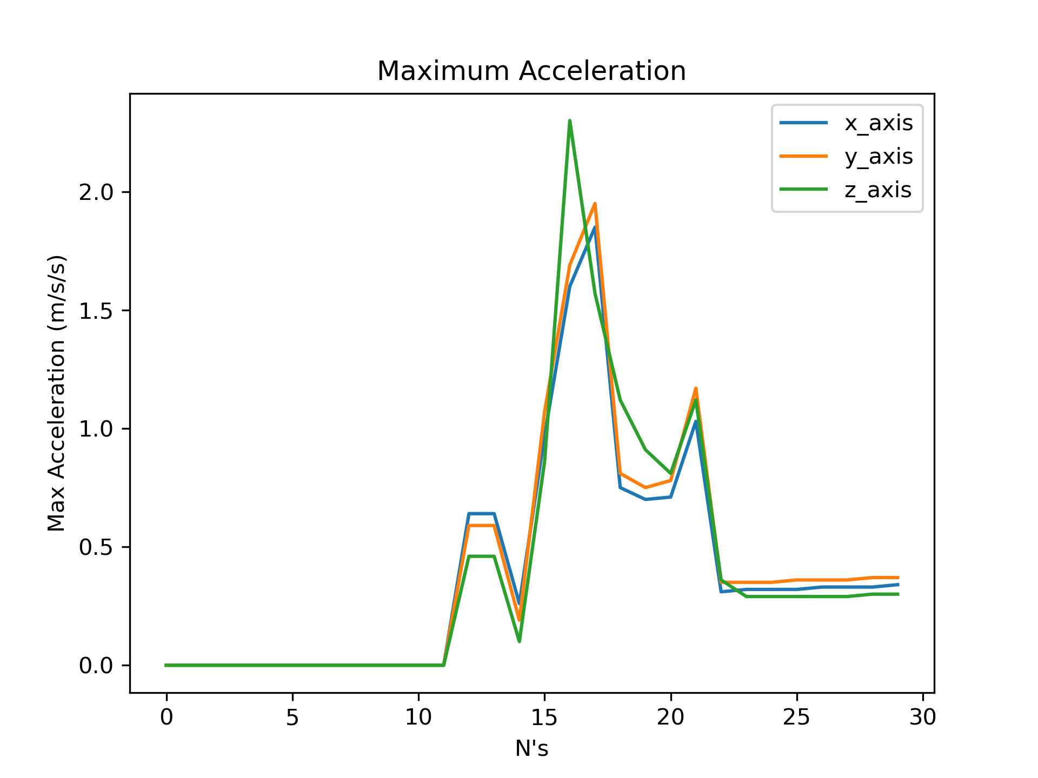
Code/serialPlot/Tests/Test1/Plots/rfMA.png
