JessyBarber/Jessy-Thesis/Code/serialPlot/Tests/Test1/Plots/rFTest1FFT.png

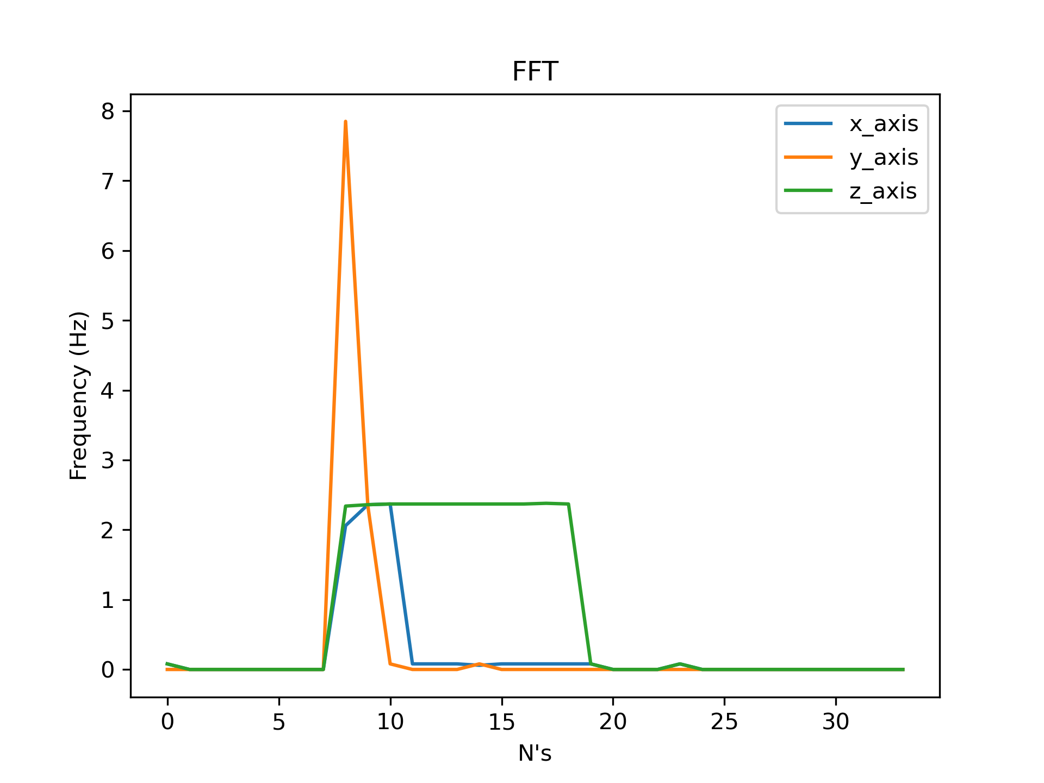
Code/serialPlot/Tests/Test1/Plots/rFTest1FFT.png
