JessyBarber/Jessy-Thesis/Code/serialPlot/Tests/Test1/Plots/rFTest1MA.png

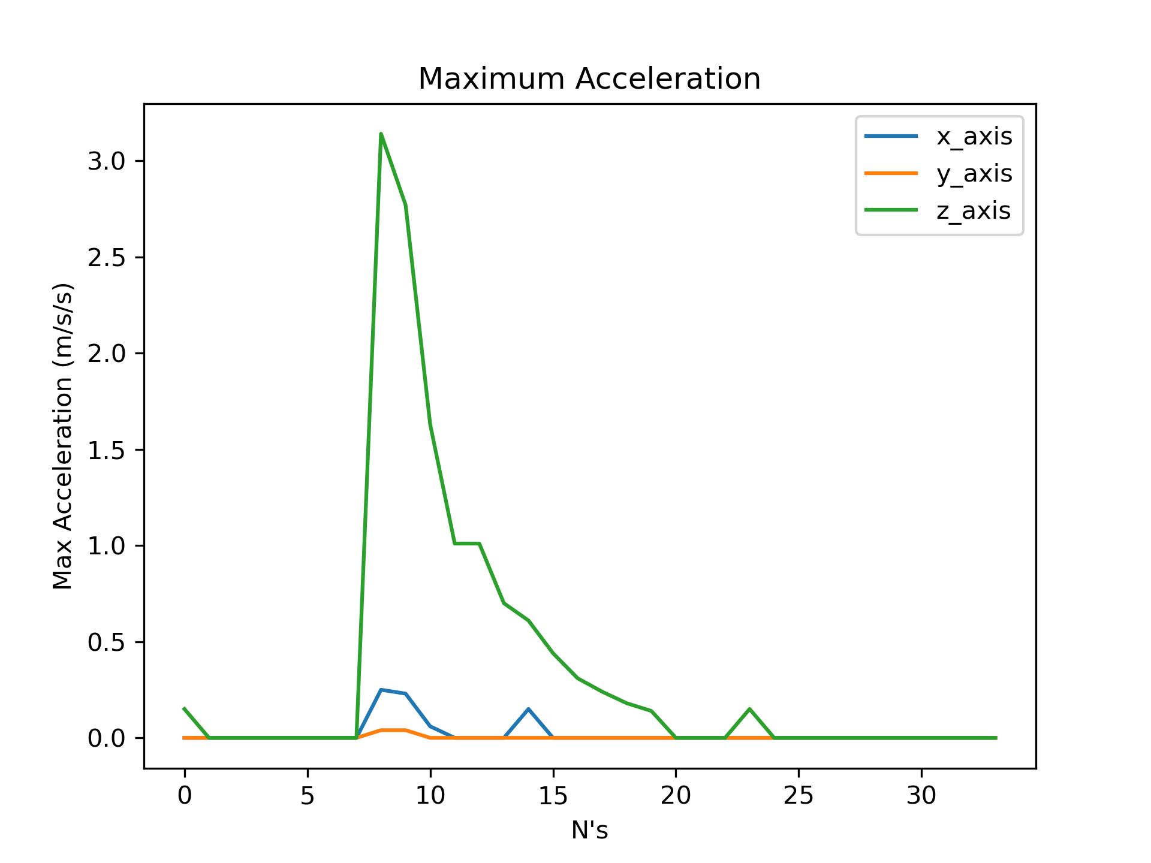
Code/serialPlot/Tests/Test1/Plots/rFTest1MA.png
