JessyBarber/Jessy-Thesis/Code/serialPlot/Tests/Test1/Plots/rFTest2FFT.png

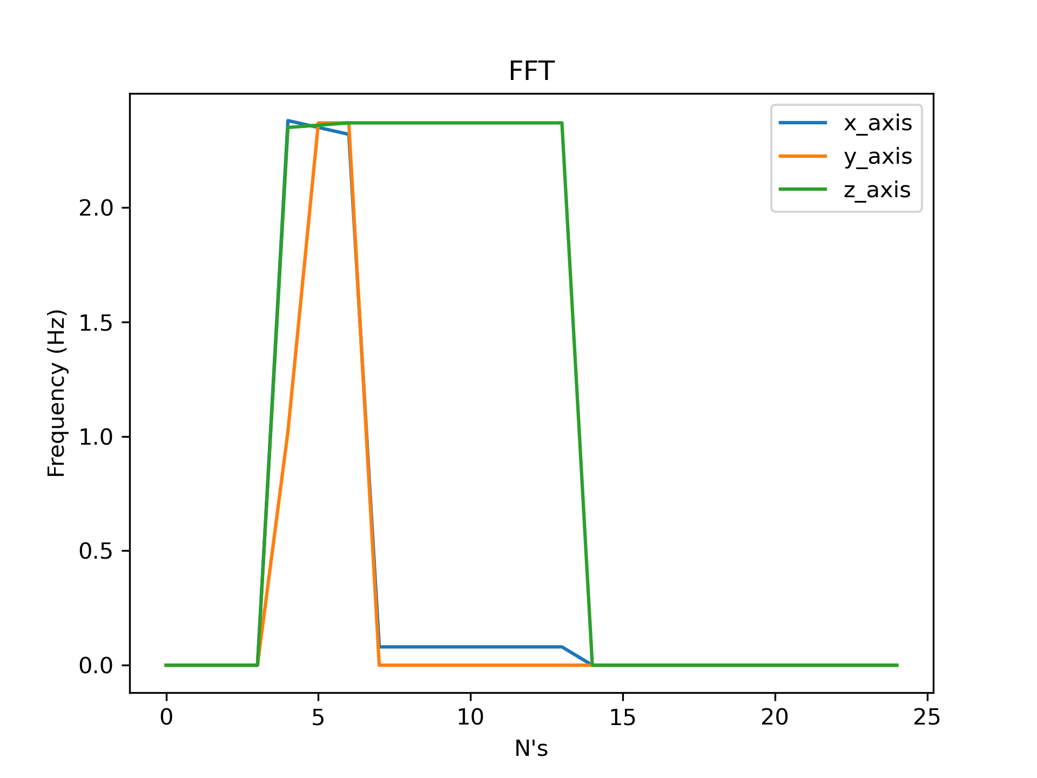
Code/serialPlot/Tests/Test1/Plots/rFTest2FFT.png
