JessyBarber/Jessy-Thesis/Code/serialPlot/Tests/Test1/Plots/rFTest2MA.png

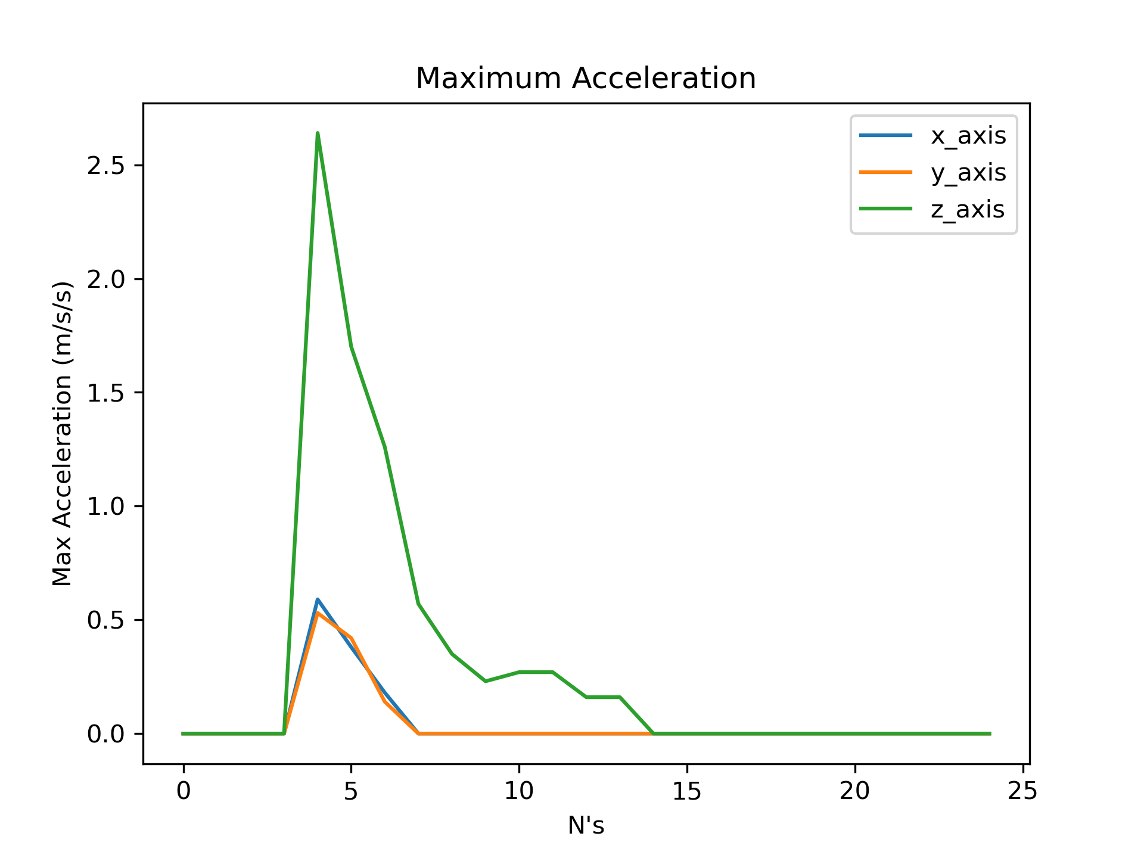
Code/serialPlot/Tests/Test1/Plots/rFTest2MA.png
