JessyBarber/Jessy-Thesis/Code/serialPlot/Tests/Test1/Plots/rFTest3FFT.png

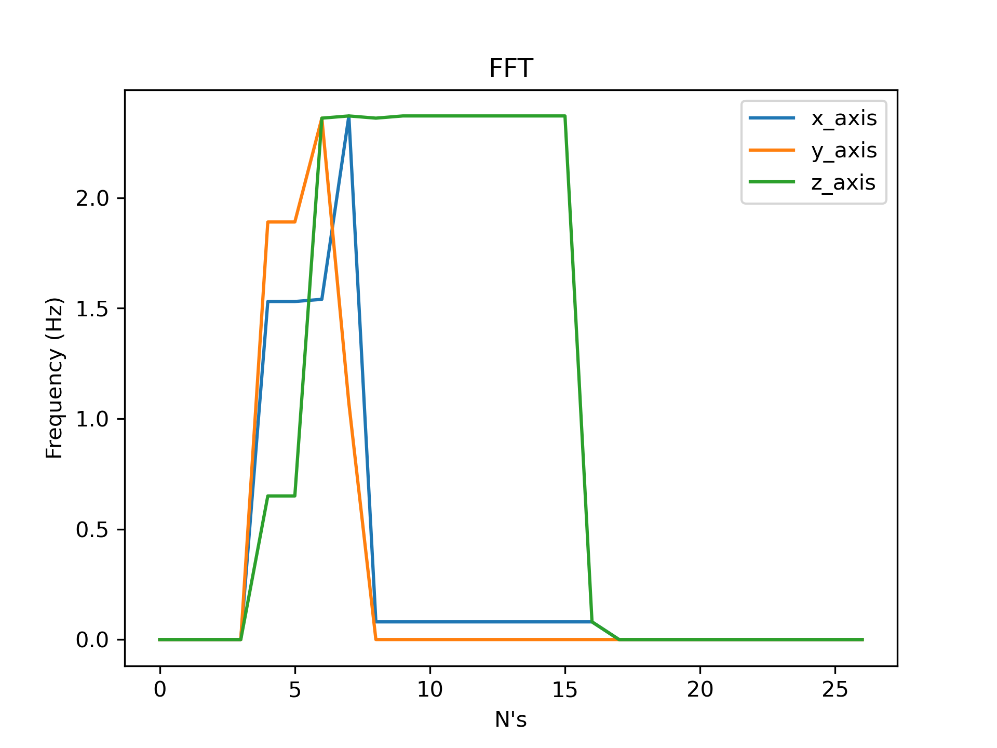
Code/serialPlot/Tests/Test1/Plots/rFTest3FFT.png
