JessyBarber/Jessy-Thesis/Code/serialPlot/Tests/Test1/Plots/SF0.1.png

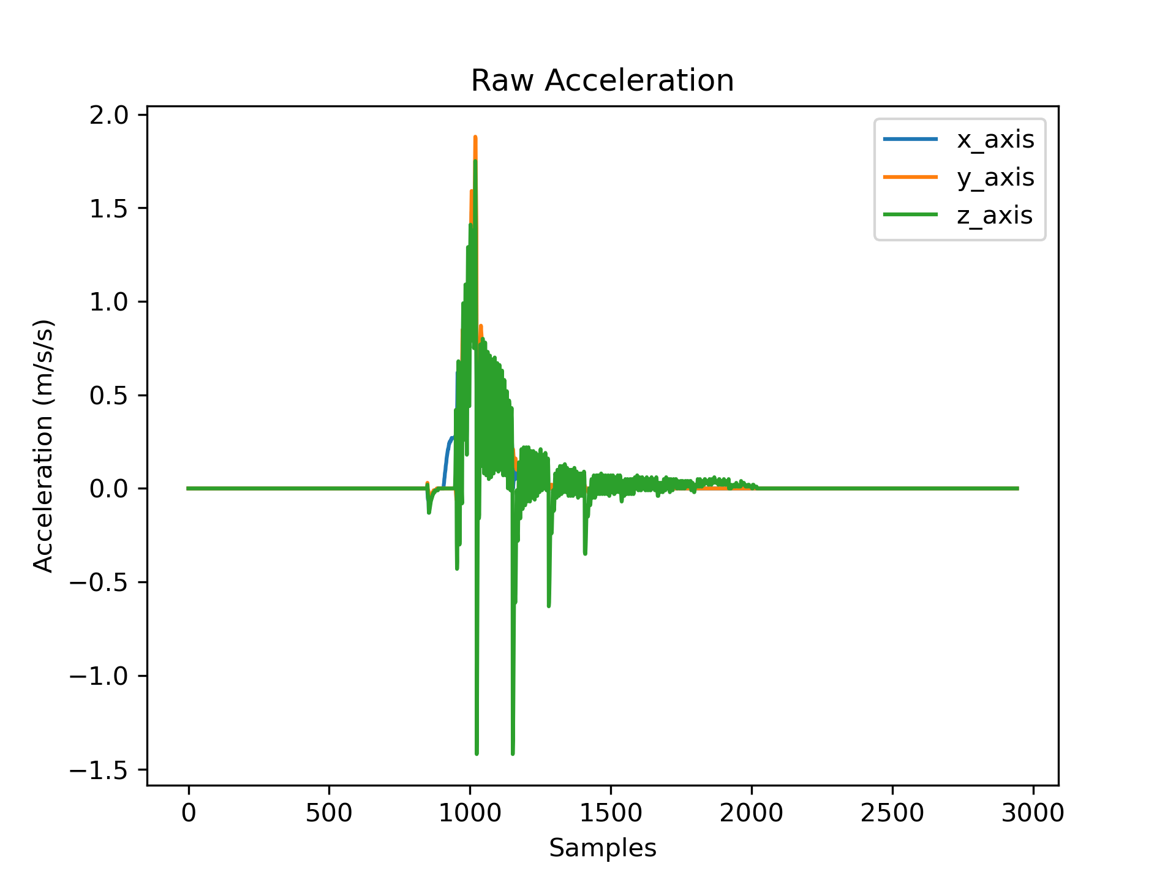
Code/serialPlot/Tests/Test1/Plots/SF0.1.png
