JessyBarber/Jessy-Thesis/Code/serialPlot/Tests/Test1/Plots/sF0.5.png

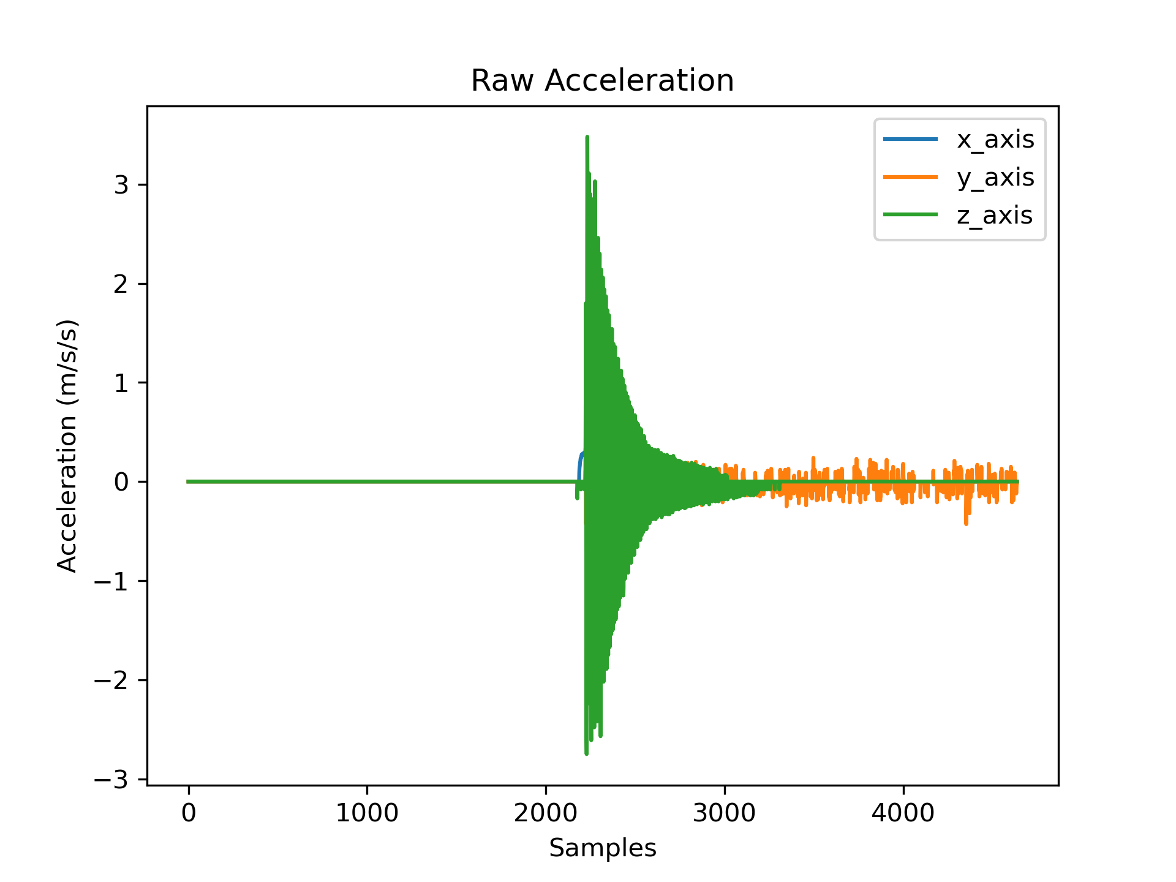
Code/serialPlot/Tests/Test1/Plots/sF0.5.png
