JessyBarber/Jessy-Thesis/Code/serialPlot/Tests/Test1/Plots/sFTest1.png

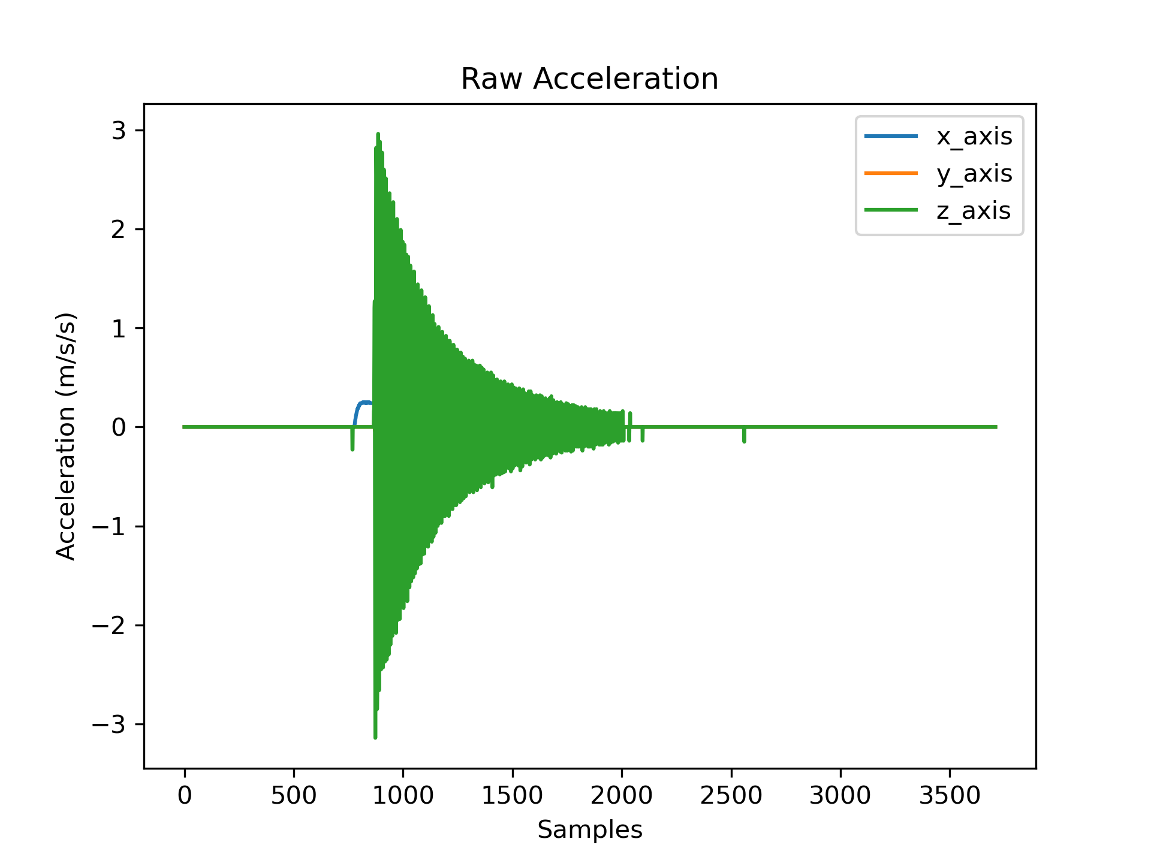
Code/serialPlot/Tests/Test1/Plots/sFTest1.png
