JessyBarber/Jessy-Thesis/Code/serialPlot/Tests/Test1/Plots/sFTest3.png

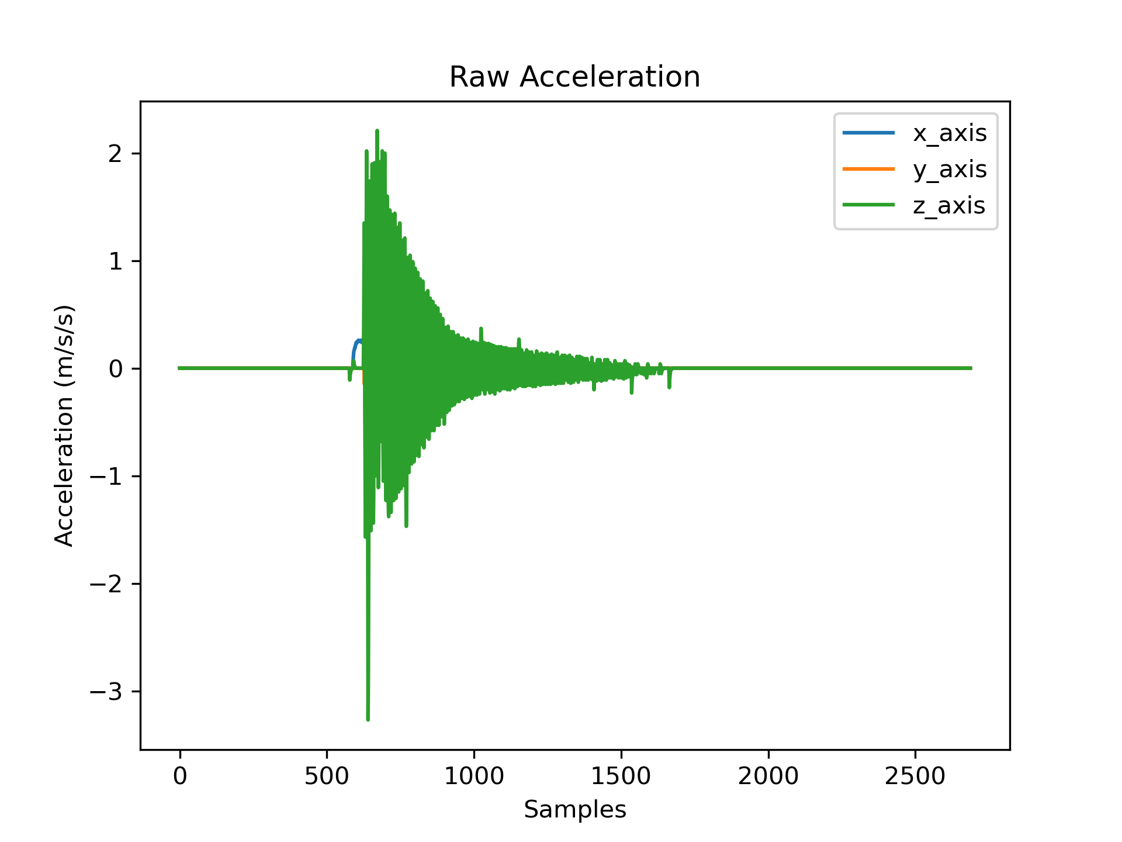
Code/serialPlot/Tests/Test1/Plots/sFTest3.png
