JessyBarber/Jessy-Thesis/Code/serialPlot/Tests/Test1/Plots/sfusbRA.png

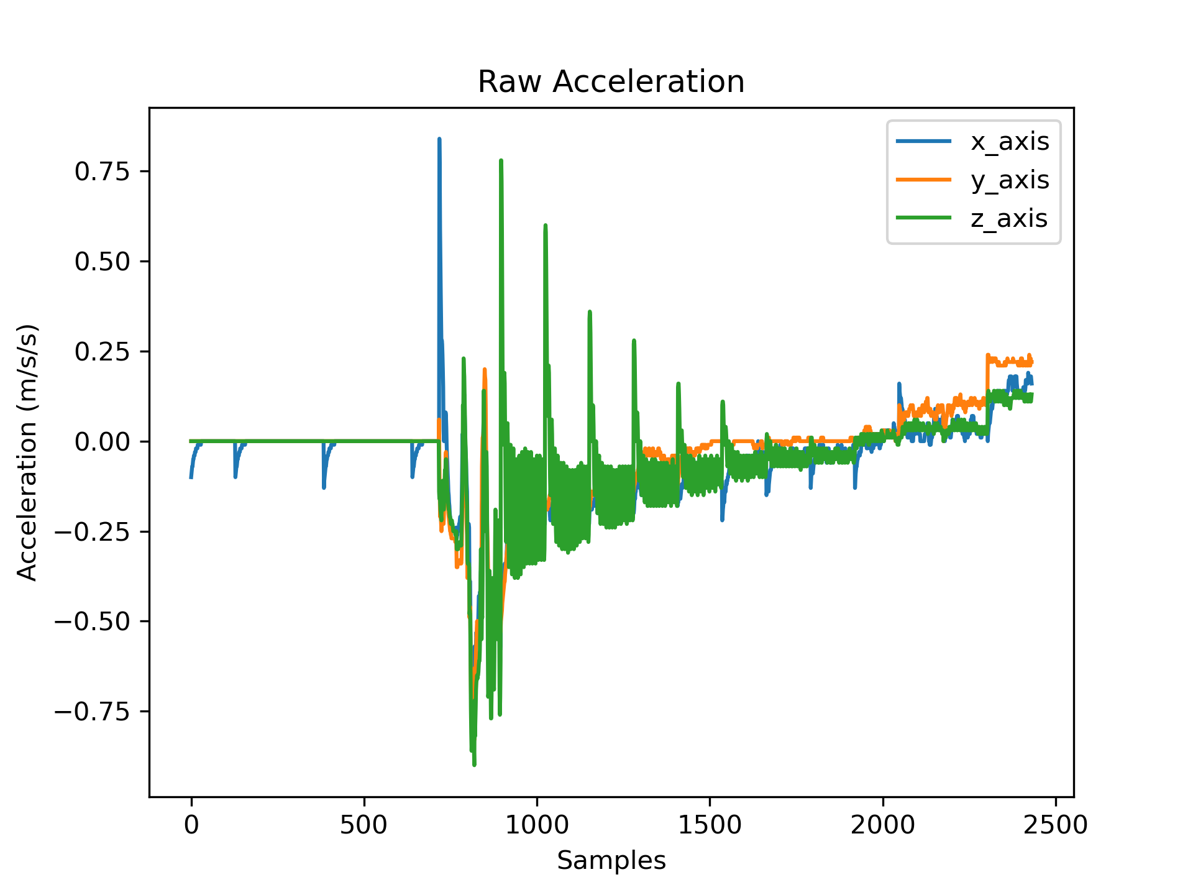
Code/serialPlot/Tests/Test1/Plots/sfusbRA.png
