JessyBarber/Jessy-Thesis/Code/serialPlot/Tests/Test1/Plots/sTest1.png

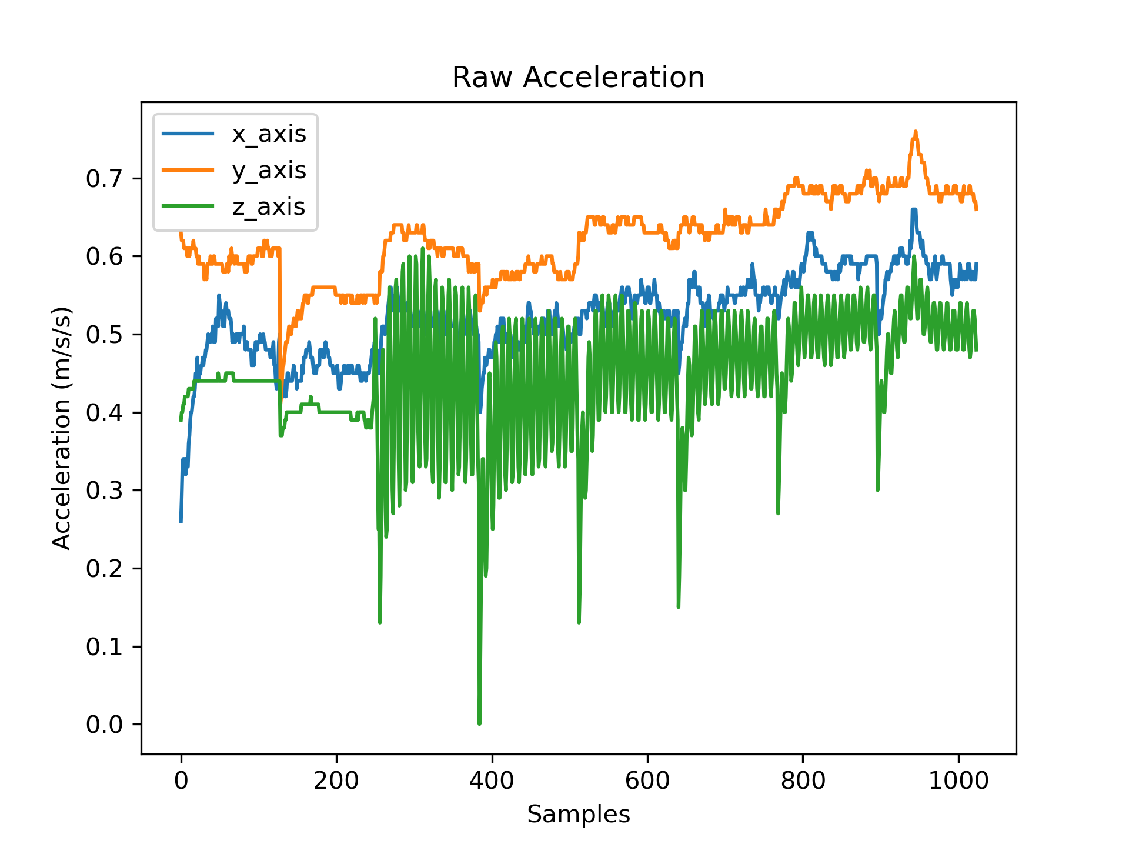
Code/serialPlot/Tests/Test1/Plots/sTest1.png
