JessyBarber/Jessy-Thesis/Code/serialPlot/Tests/Test1/Plots/sTest2.png

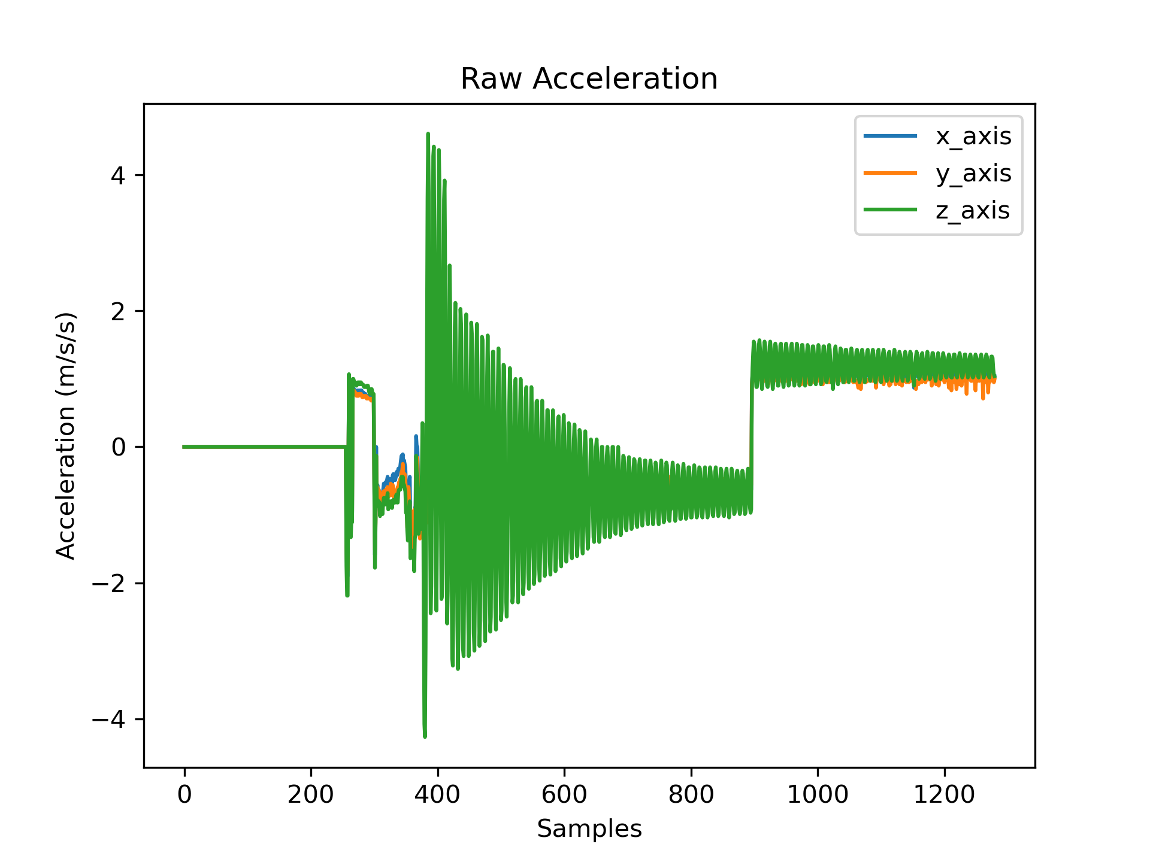
Code/serialPlot/Tests/Test1/Plots/sTest2.png
