JessyBarber/Jessy-Thesis/Code/serialPlot/Tests/Test1/Plots/sTest3.png

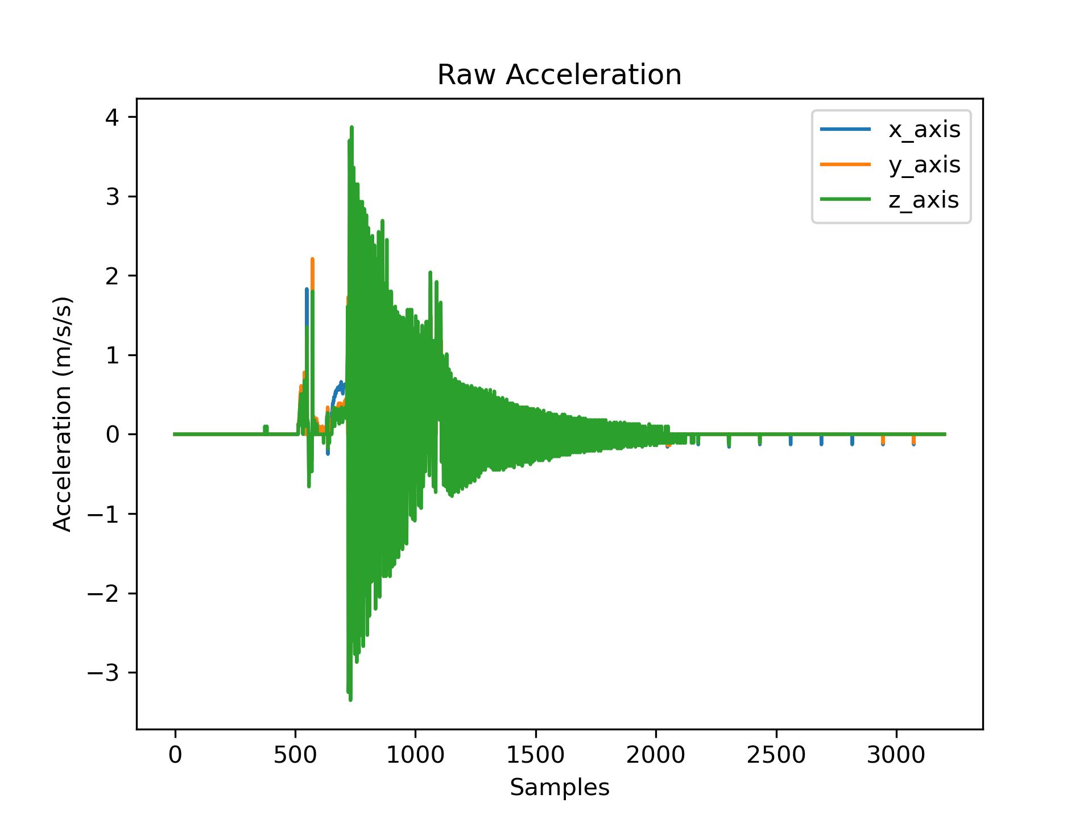
Code/serialPlot/Tests/Test1/Plots/sTest3.png
