JessyBarber/Jessy-Thesis/Code/serialPlot/Tests/Test2/Plots/rFfft.png

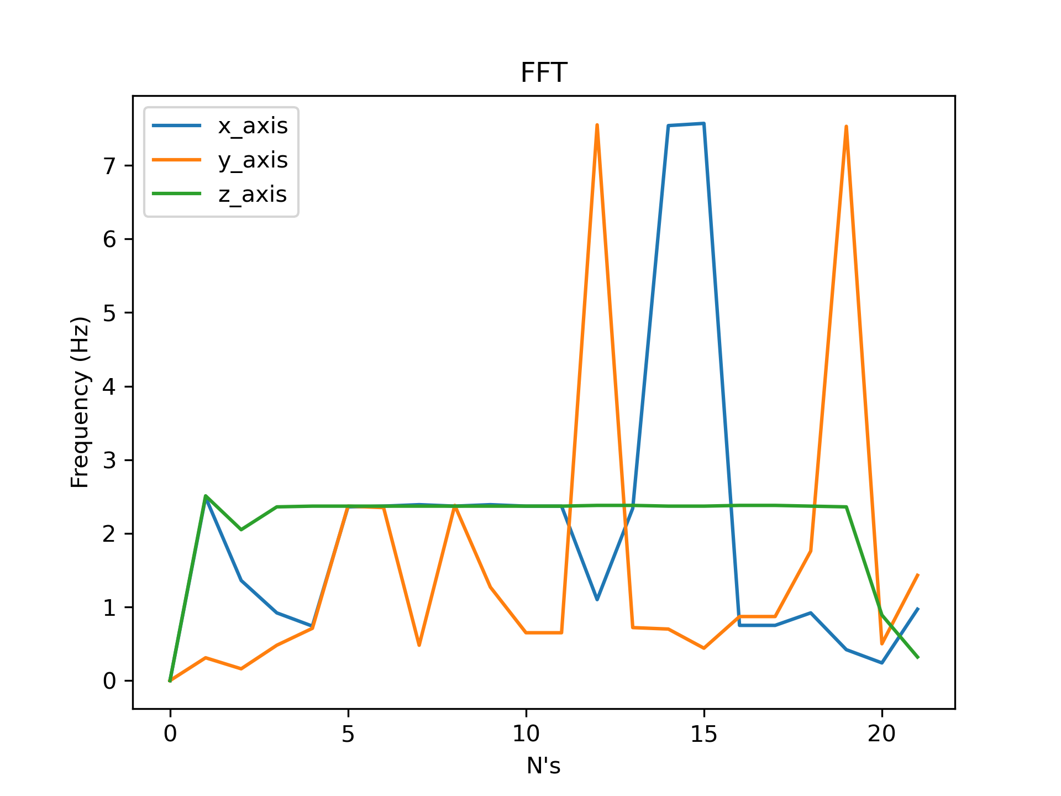
Code/serialPlot/Tests/Test2/Plots/rFfft.png
