JessyBarber/Jessy-Thesis/Code/serialPlot/Tests/Test2/Plots/rFMA.png

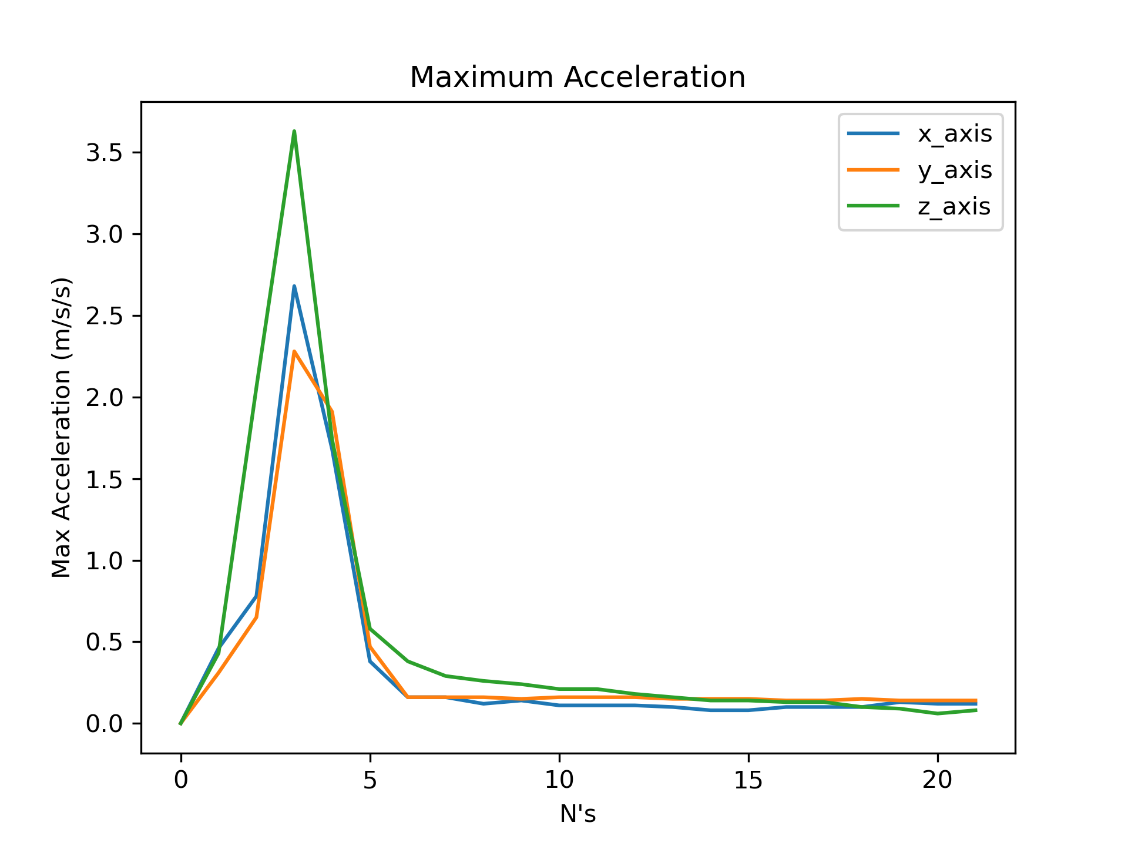
Code/serialPlot/Tests/Test2/Plots/rFMA.png
