JessyBarber/Jessy-Thesis/Code/serialPlot/Tests/Test2/Plots/rFTest3MA.png

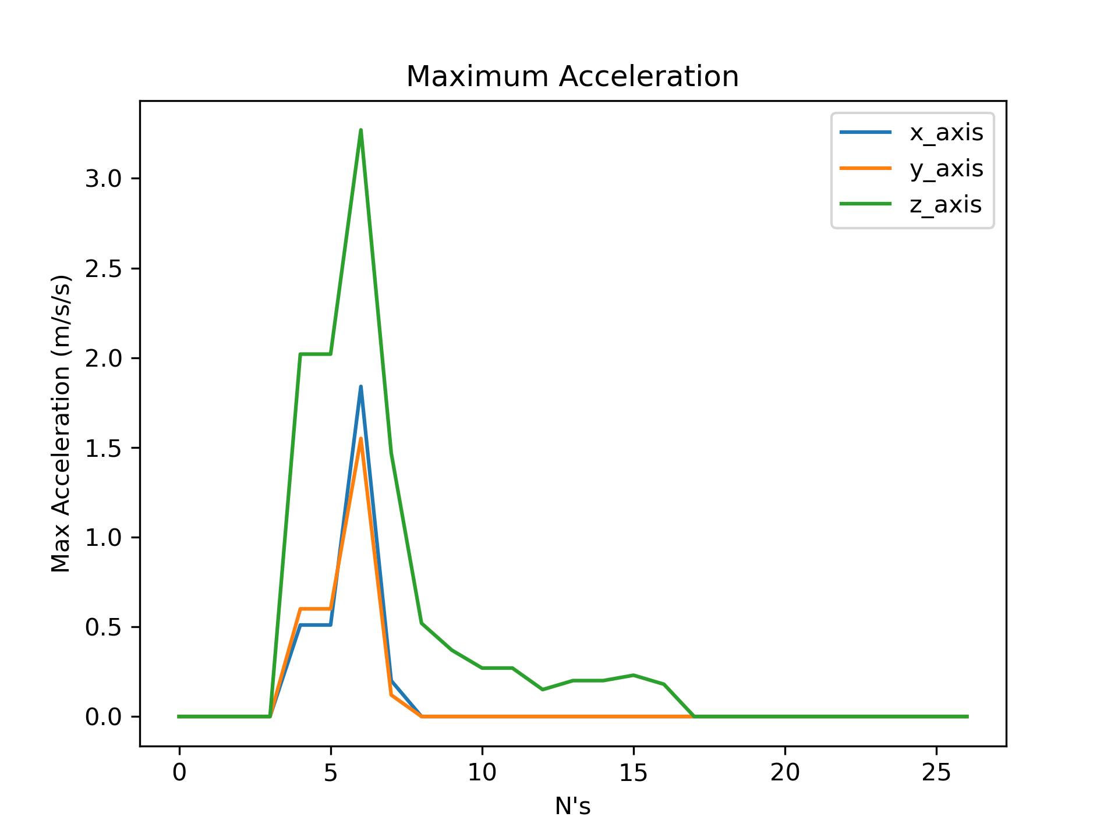
Code/serialPlot/Tests/Test2/Plots/rFTest3MA.png
