JessyBarber/Jessy-Thesis/Code/serialPlot/Tests/Test2/Plots/sF.png

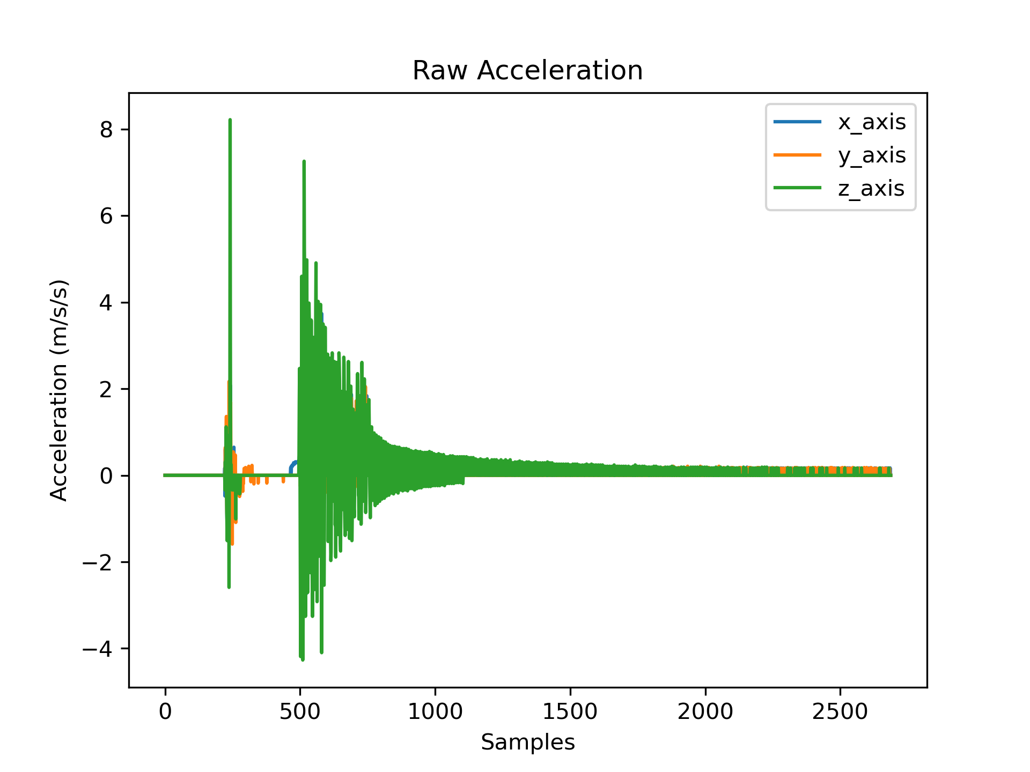
Code/serialPlot/Tests/Test2/Plots/sF.png
