JessyBarber/Jessy-Thesis/Code/serialPlot/Tests/Test3(home)/plots/rtest2D.png

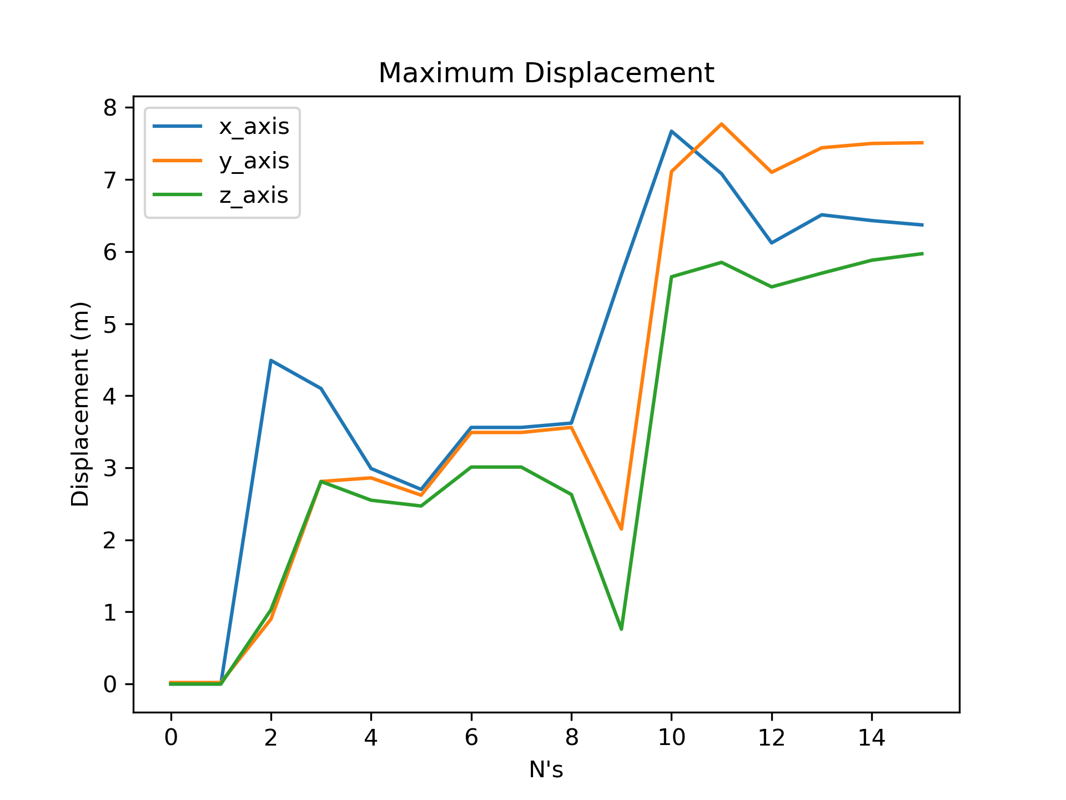
Code/serialPlot/Tests/Test3(home)/plots/rtest2D.png
