JessyBarber/Jessy-Thesis/Code/serialPlot/Tests/Test3(home)/plots/rtest2MA.png

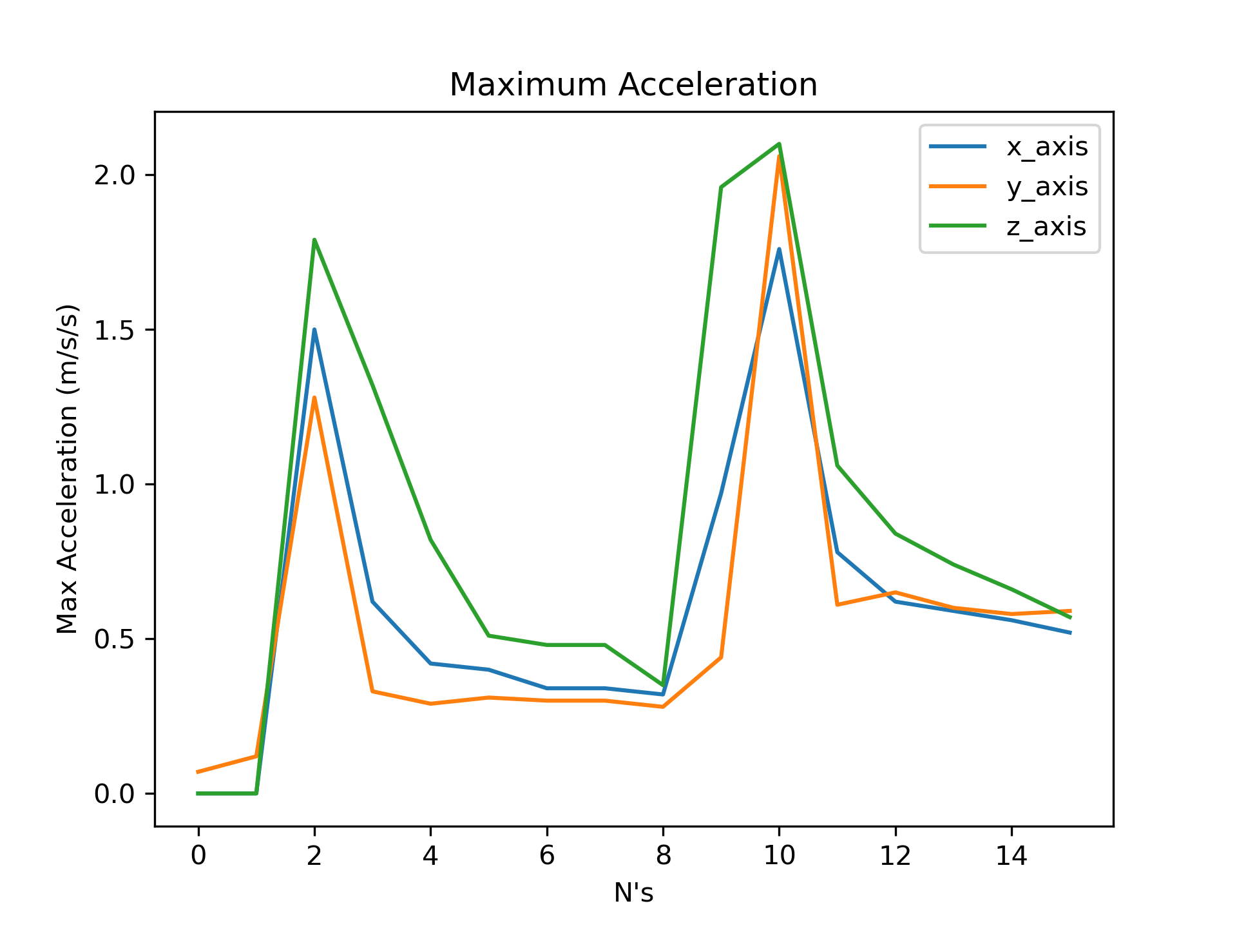
Code/serialPlot/Tests/Test3(home)/plots/rtest2MA.png
