JessyBarber/Jessy-Thesis/Code/serialPlot/Tests/Test3(home)/plots/rtest3D.png

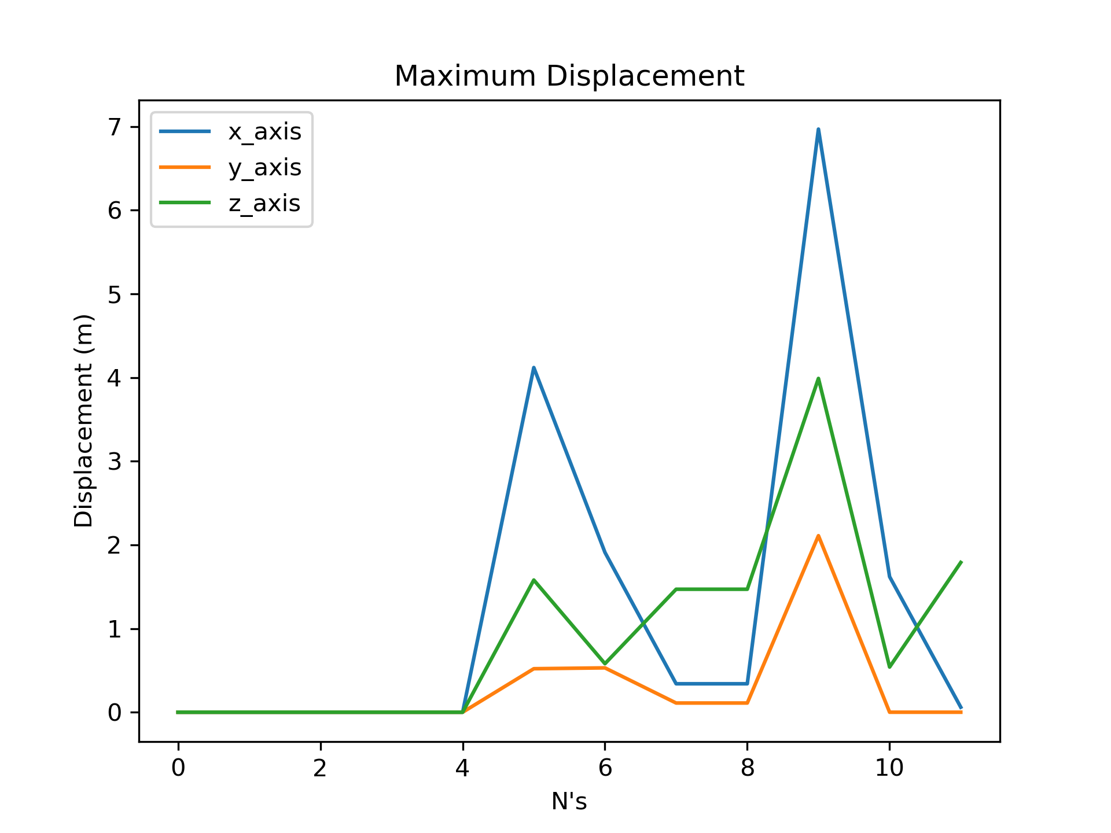
Code/serialPlot/Tests/Test3(home)/plots/rtest3D.png
