JessyBarber/Jessy-Thesis/Code/serialPlot/Tests/Test3(home)/plots/rtest3MA.png

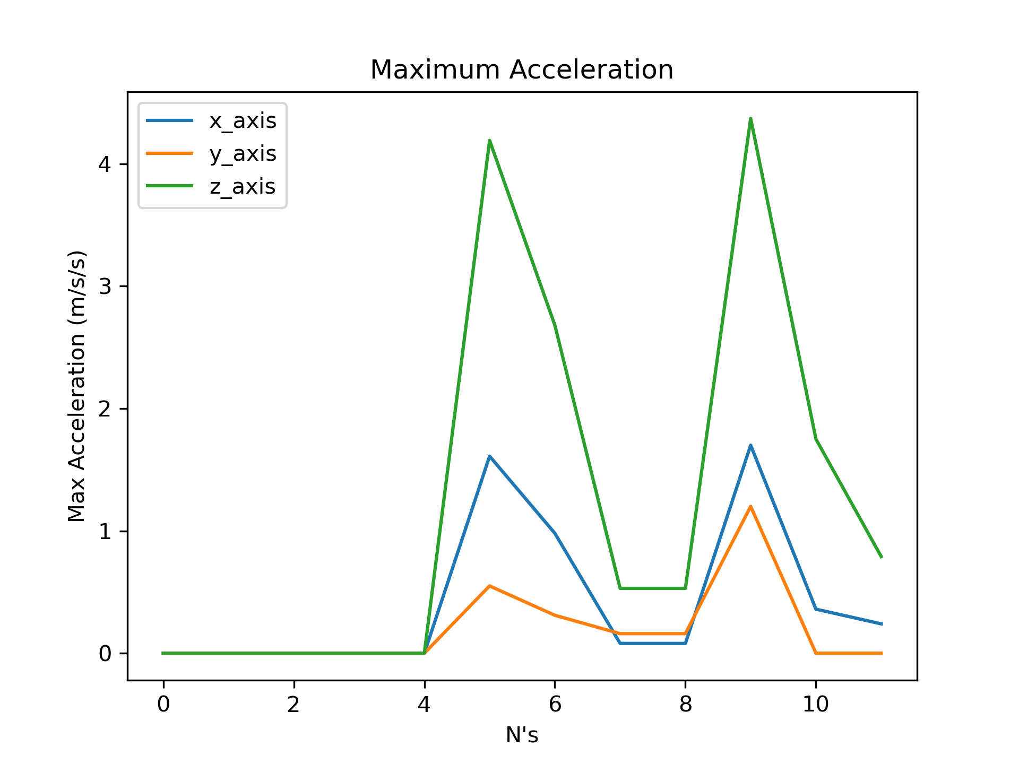
Code/serialPlot/Tests/Test3(home)/plots/rtest3MA.png
