JessyBarber/Jessy-Thesis/Code/serialPlot/Tests/Test3(home)/plots/rtest4FFT.png

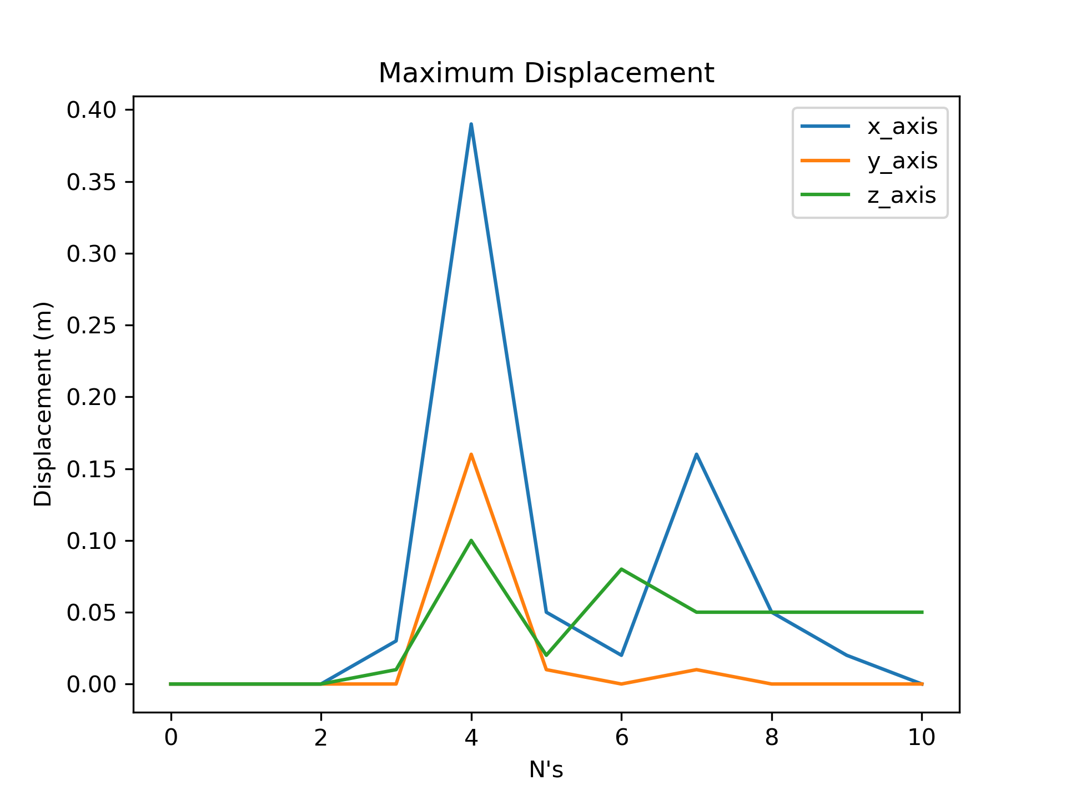
Code/serialPlot/Tests/Test3(home)/plots/rtest4FFT.png
