JessyBarber/Jessy-Thesis/Code/serialPlot/Tests/Test3(home)/plots/rtest4MA.png

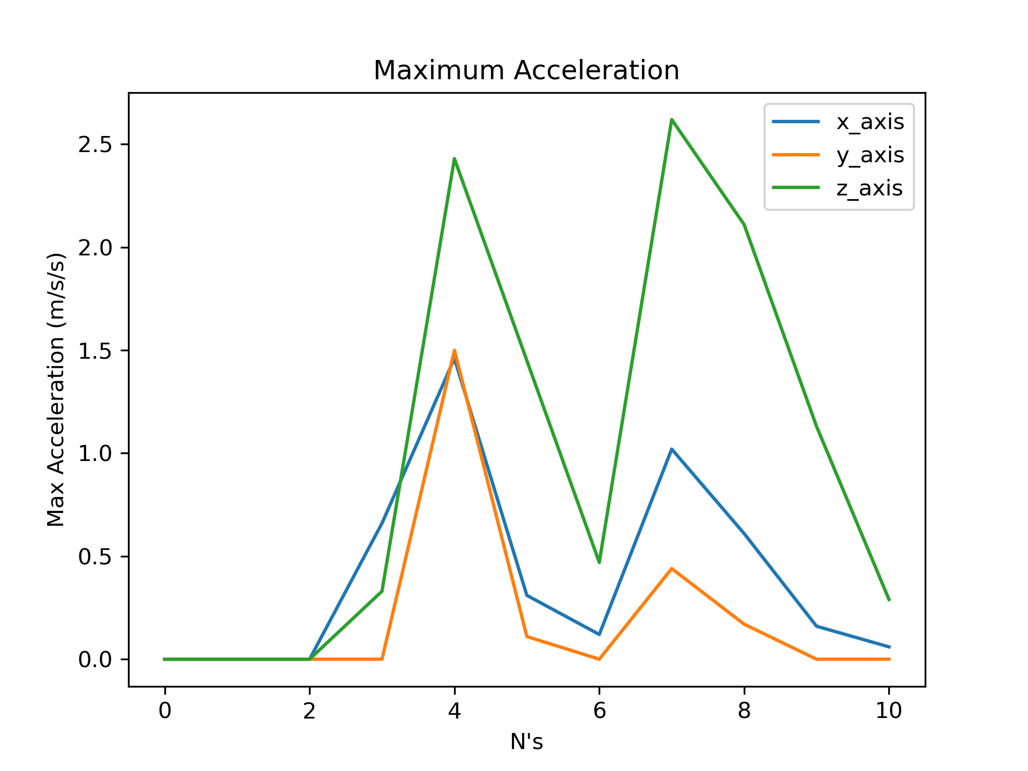
Code/serialPlot/Tests/Test3(home)/plots/rtest4MA.png
