JessyBarber/Jessy-Thesis/Code/serialPlot/Tests/Test3(home)/plots/rtestFFT.png

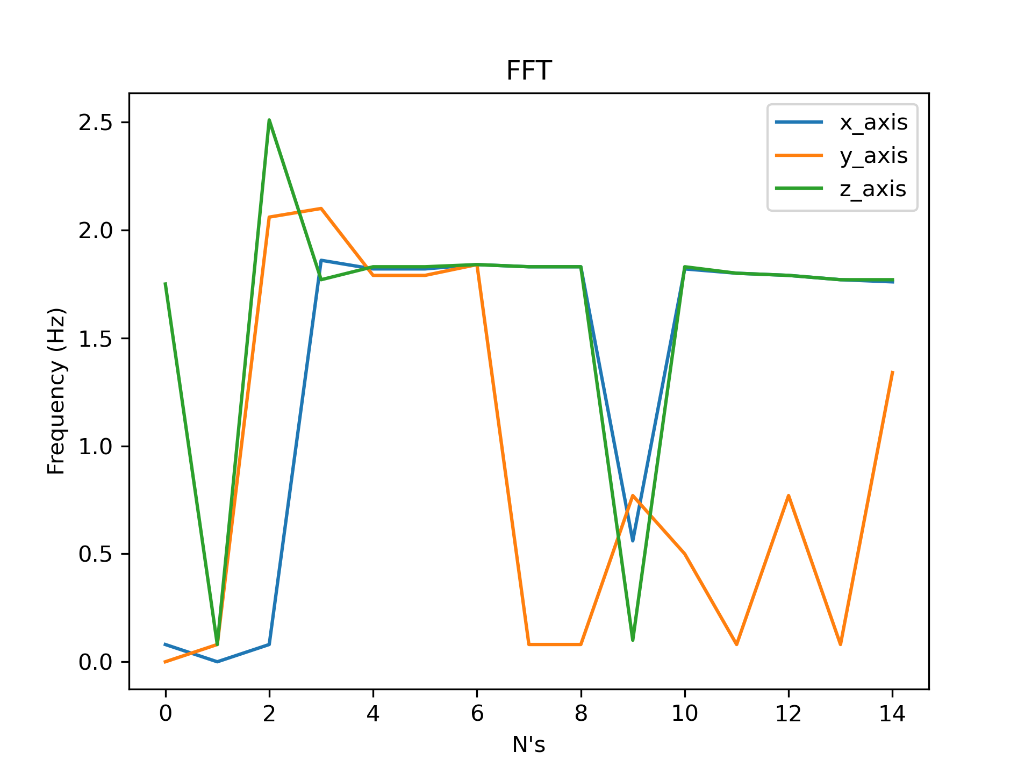
Code/serialPlot/Tests/Test3(home)/plots/rtestFFT.png
