JessyBarber/Jessy-Thesis/Code/serialPlot/Tests/Test3(home)/plots/rtestMA.png

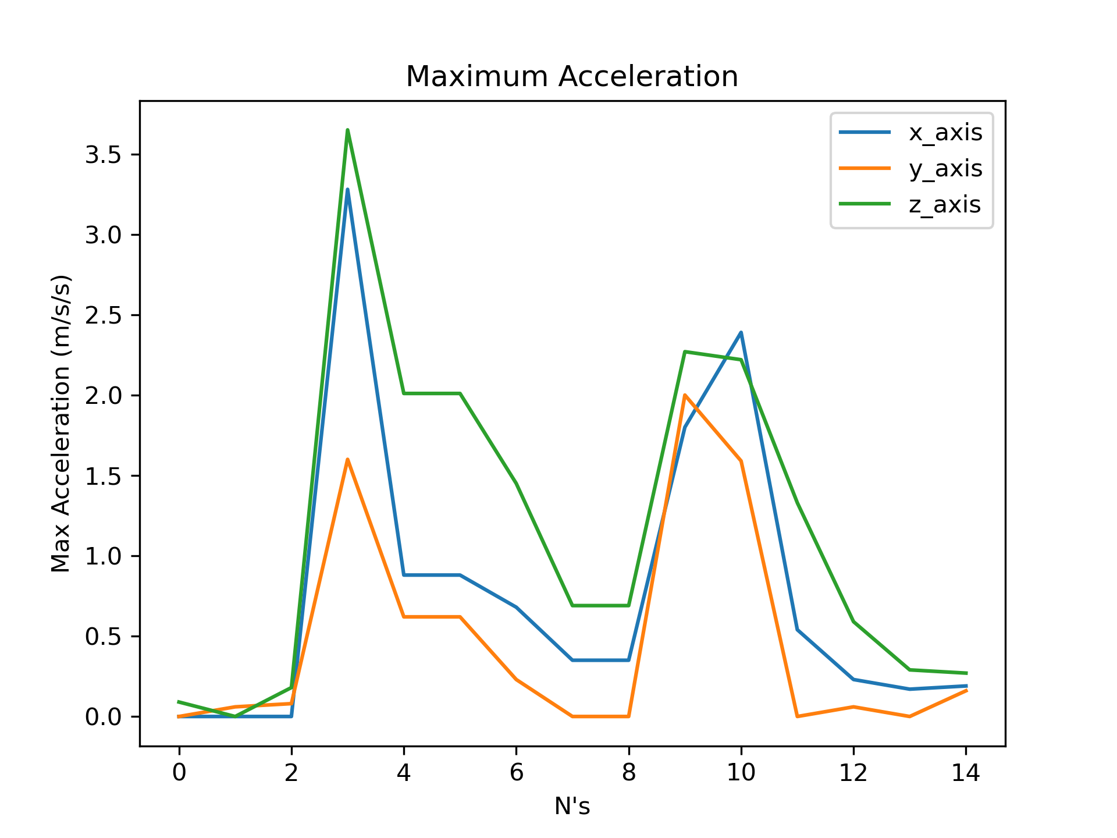
Code/serialPlot/Tests/Test3(home)/plots/rtestMA.png
