JessyBarber/Jessy-Thesis/Code/serialPlot/Tests/Test3(home)/plots/sFTest2.png

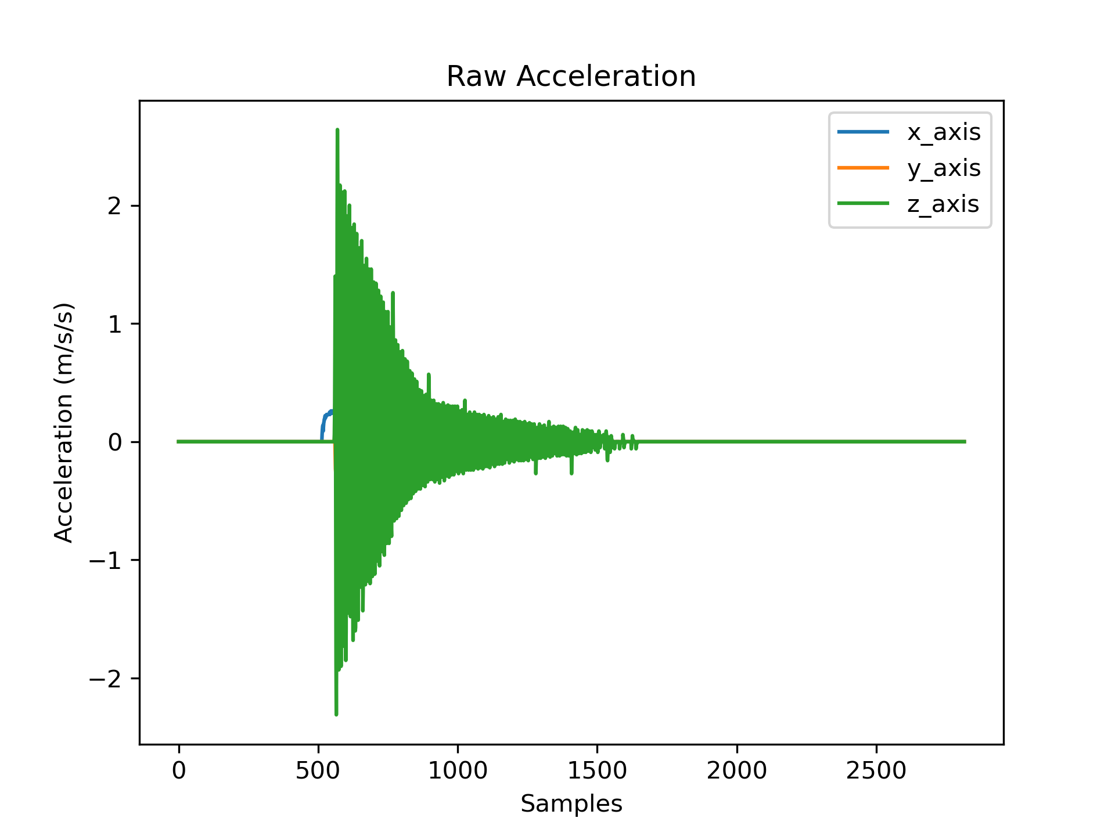
Code/serialPlot/Tests/Test3(home)/plots/sFTest2.png
