JessyBarber/Jessy-Thesis/Code/serialPlot/Tests/Test3(home)/plots/stest2.png

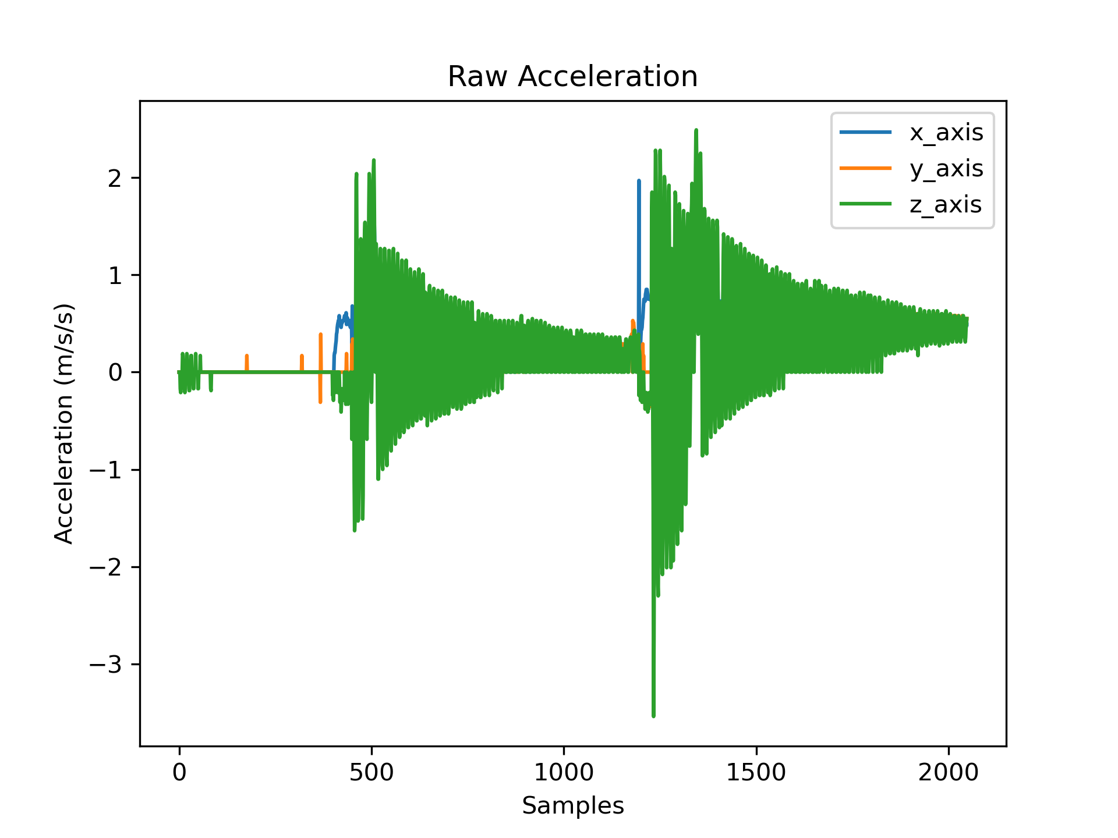
Code/serialPlot/Tests/Test3(home)/plots/stest2.png
