JessyBarber/Jessy-Thesis/Code/serialPlot/Tests/Test3(home)/plots/stest3.png

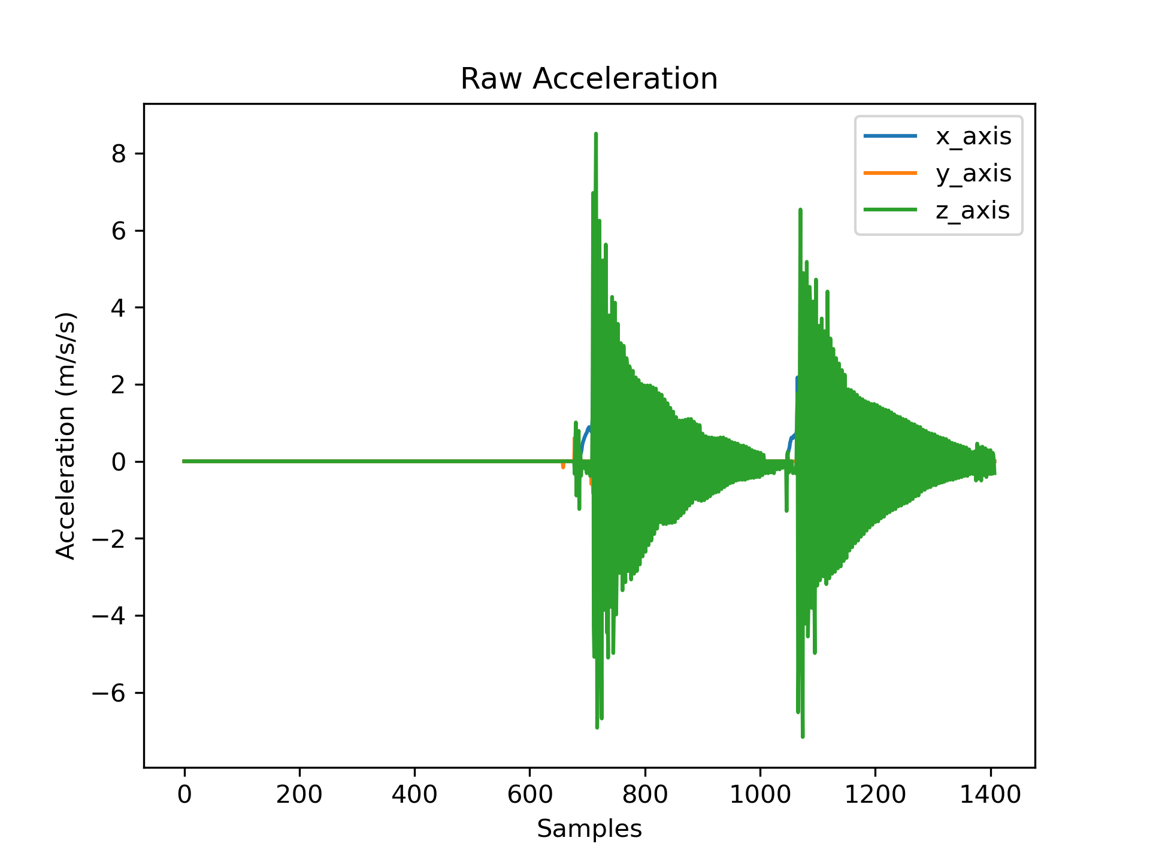
Code/serialPlot/Tests/Test3(home)/plots/stest3.png
