JessyBarber/Jessy-Thesis/Code/serialPlot/Tests/Test3(home)/plots/stest.png

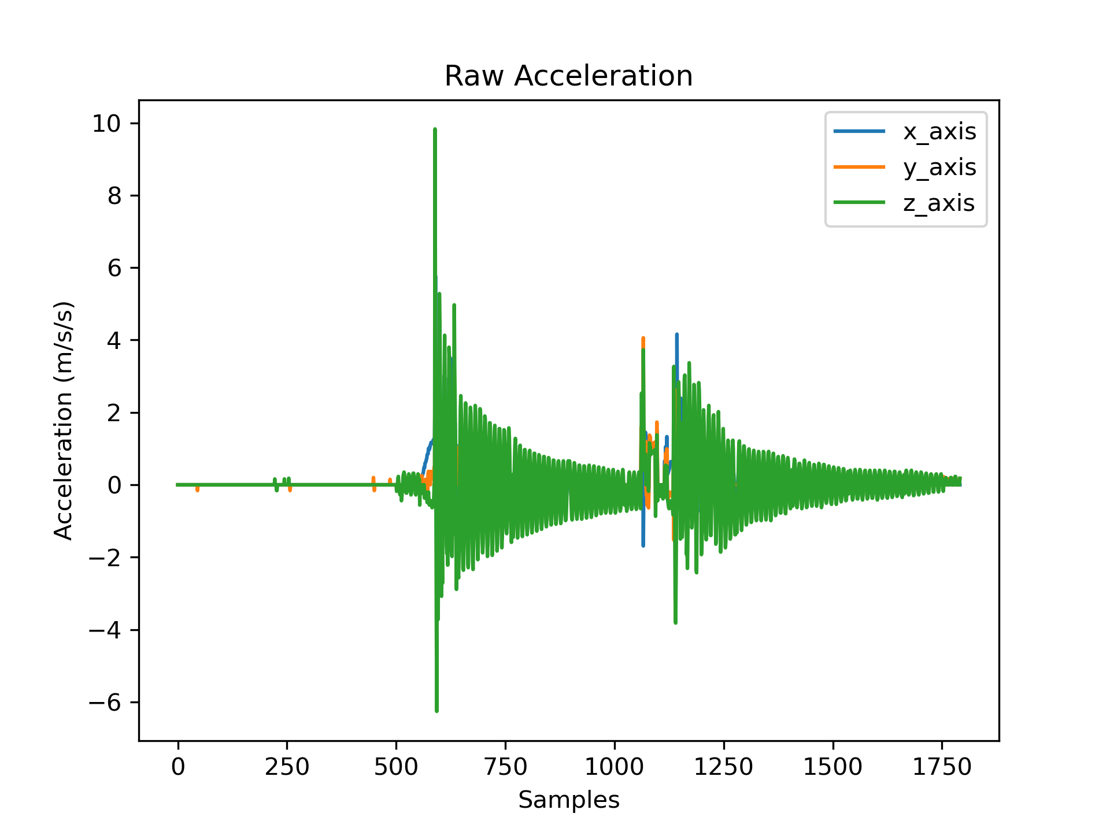
Code/serialPlot/Tests/Test3(home)/plots/stest.png
