JessyBarber/Jessy-Thesis/Code/serialPlot/Tests/Test4/plots/rF1FFT.png

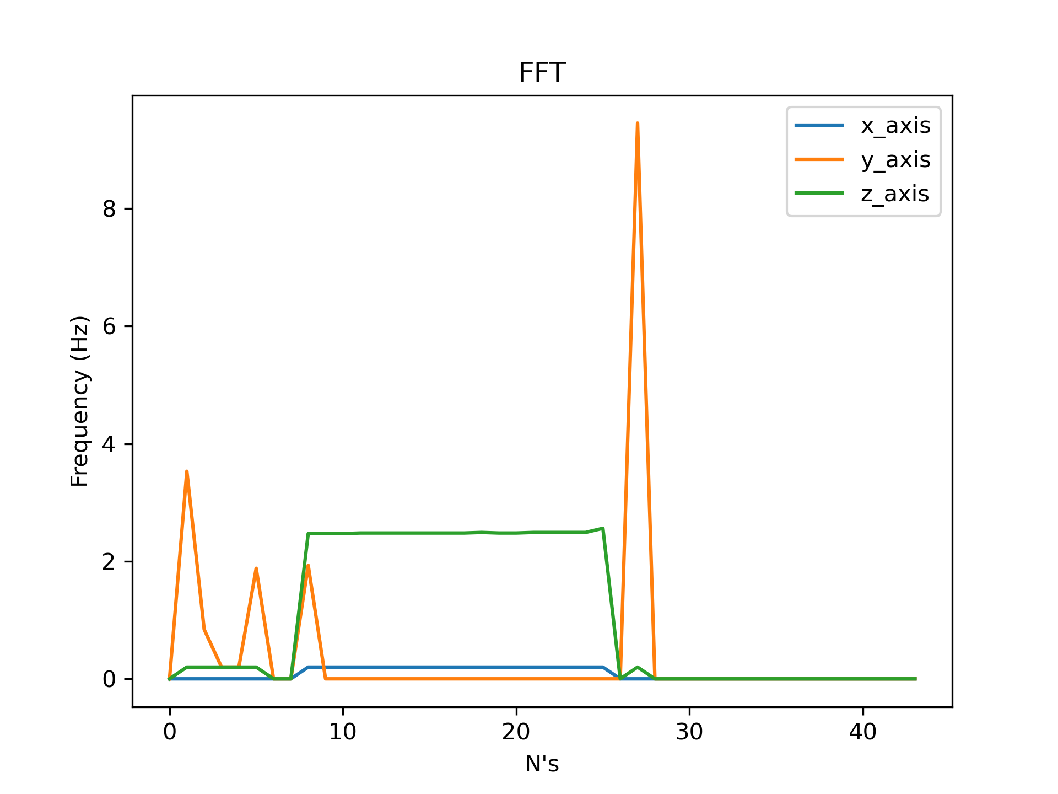
Code/serialPlot/Tests/Test4/plots/rF1FFT.png
