JessyBarber/Jessy-Thesis/Code/serialPlot/Tests/Test4/plots/rF1MA.png

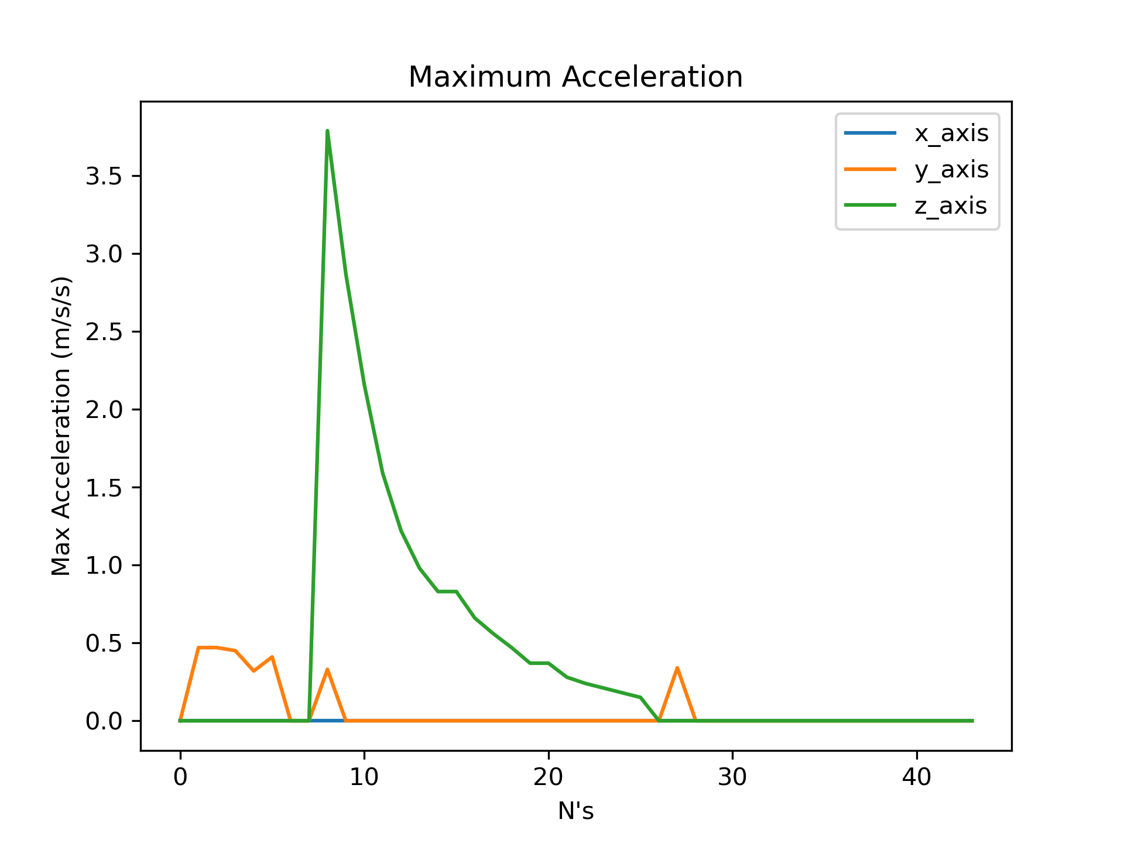
Code/serialPlot/Tests/Test4/plots/rF1MA.png
