JessyBarber/Jessy-Thesis/Code/serialPlot/Tests/Test4/plots/rF2FFT.png

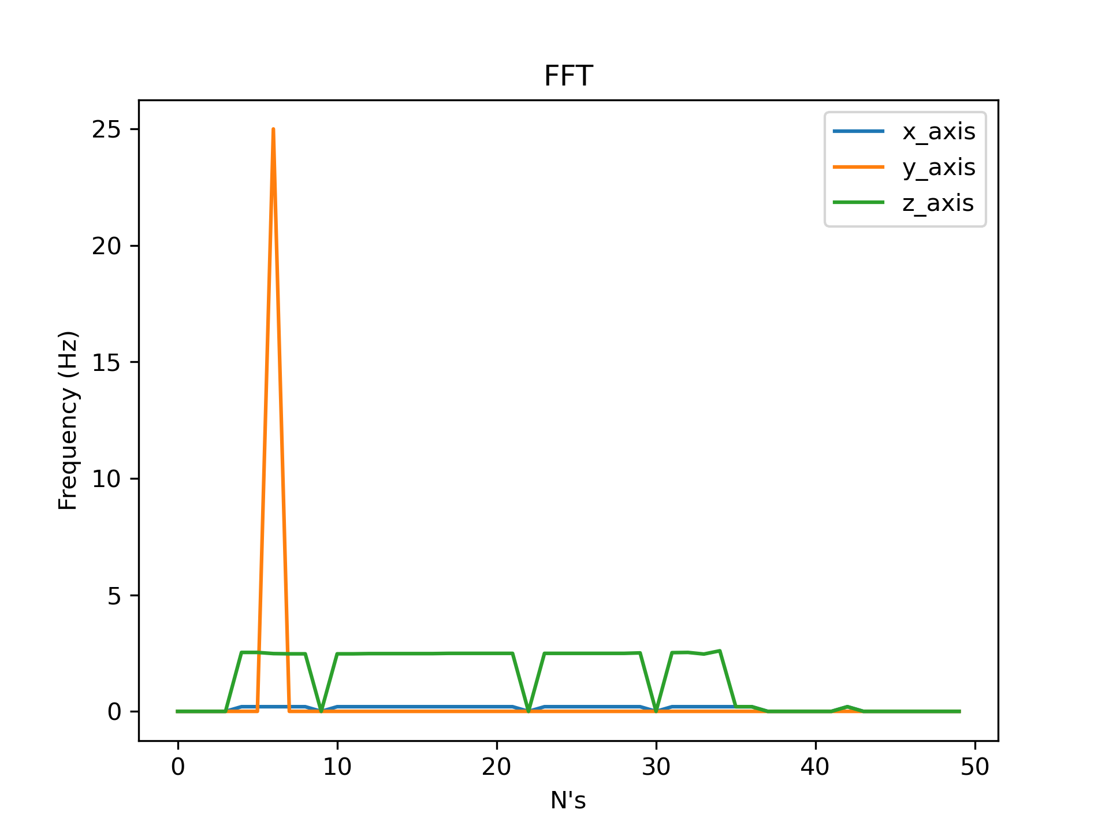
Code/serialPlot/Tests/Test4/plots/rF2FFT.png
