JessyBarber/Jessy-Thesis/Code/serialPlot/Tests/Test4/plots/rF3FFT.png

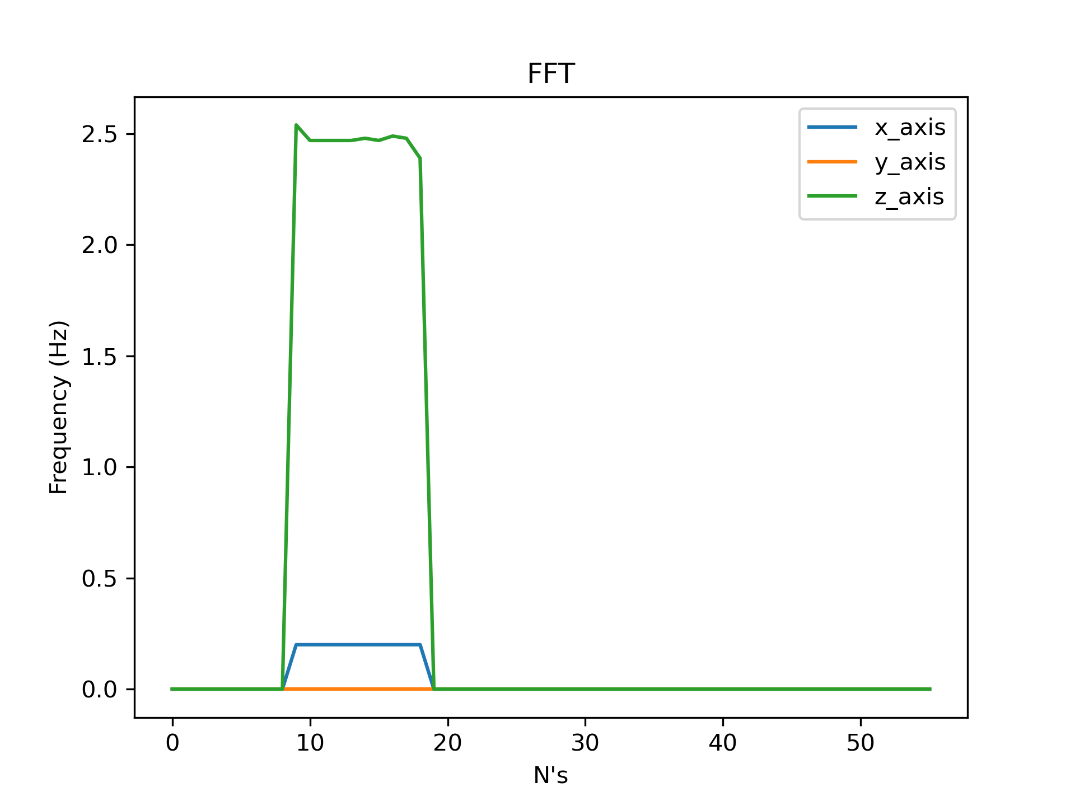
Code/serialPlot/Tests/Test4/plots/rF3FFT.png
