JessyBarber/Jessy-Thesis/Code/serialPlot/Tests/Test4/plots/rF3MA.png

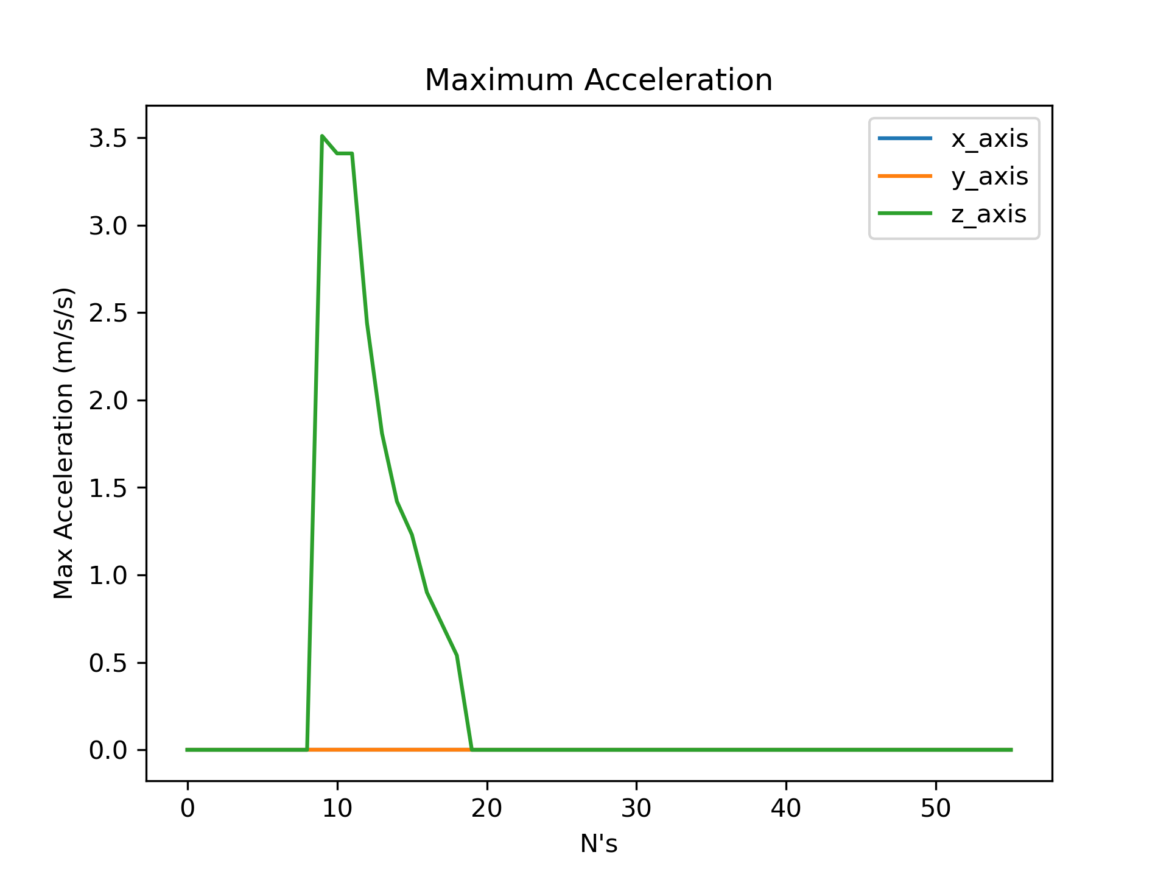
Code/serialPlot/Tests/Test4/plots/rF3MA.png
