JessyBarber/Jessy-Thesis/Code/serialPlot/Tests/Test4/plots/rF4FFT.png

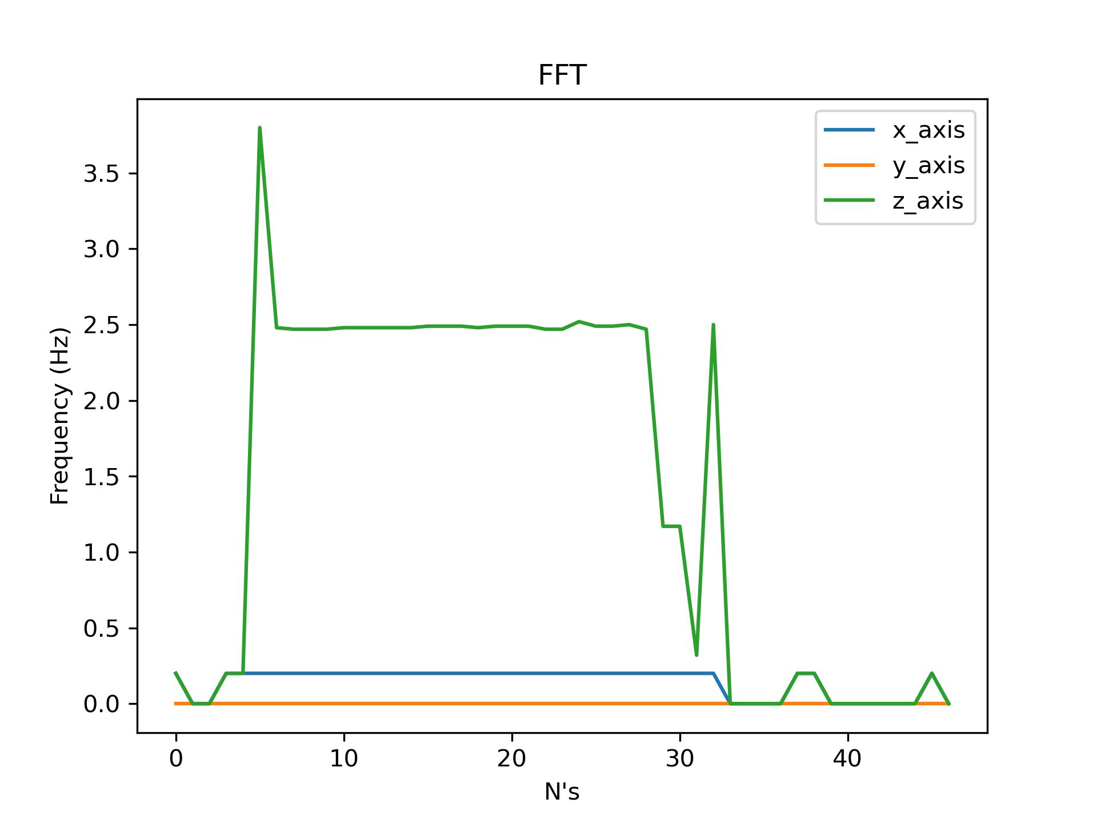
Code/serialPlot/Tests/Test4/plots/rF4FFT.png
