JessyBarber/Jessy-Thesis/Code/serialPlot/Tests/Test4/plots/rF4MA.png

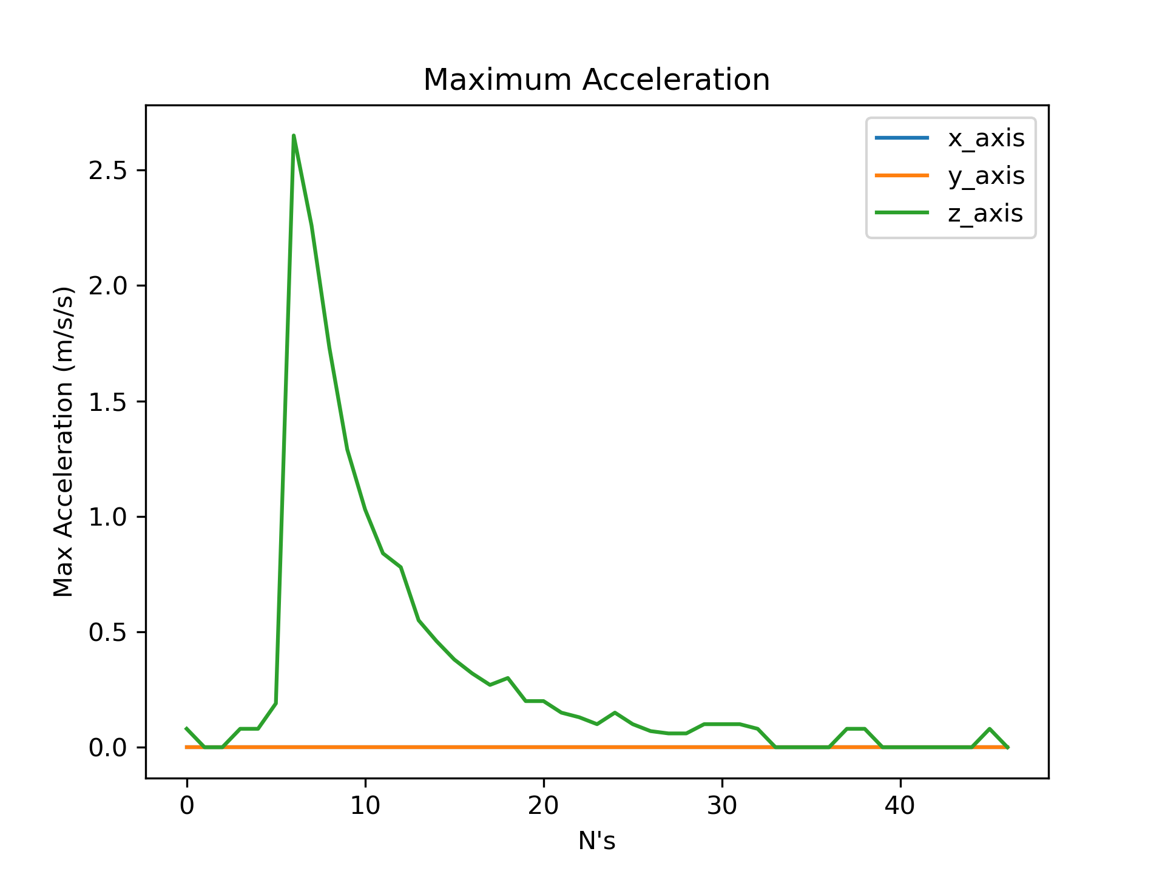
Code/serialPlot/Tests/Test4/plots/rF4MA.png
