JessyBarber/Jessy-Thesis/Code/serialPlot/Tests/Test4/plots/rF5FFT.png

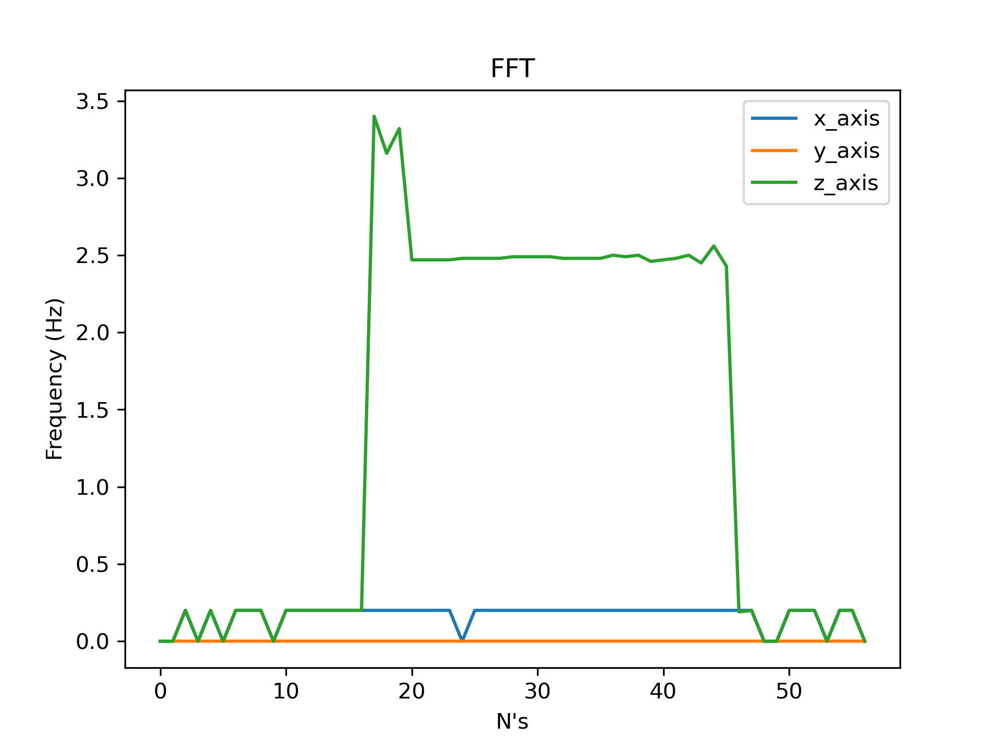
Code/serialPlot/Tests/Test4/plots/rF5FFT.png
