JessyBarber/Jessy-Thesis/Code/serialPlot/Tests/Test4/plots/rF6FFT.png

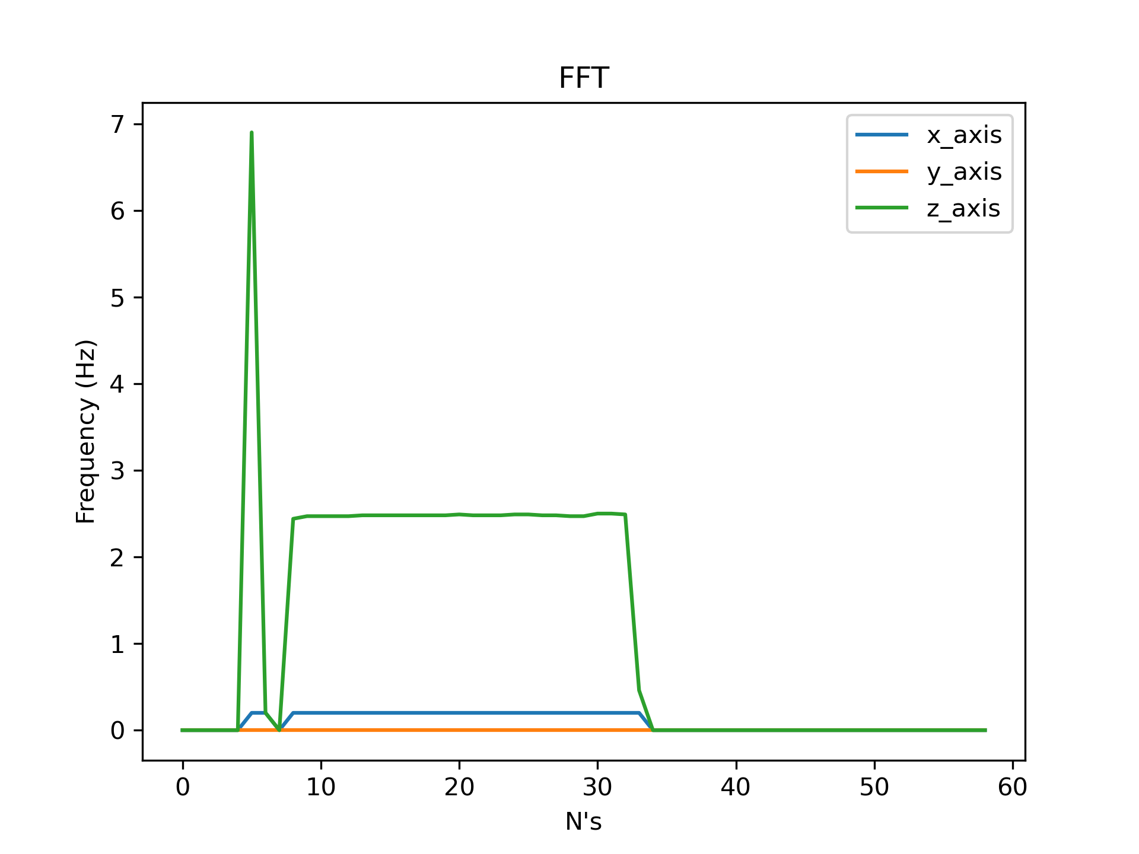
Code/serialPlot/Tests/Test4/plots/rF6FFT.png
