JessyBarber/Jessy-Thesis/Code/serialPlot/Tests/Test4/plots/rFB1FFT.png

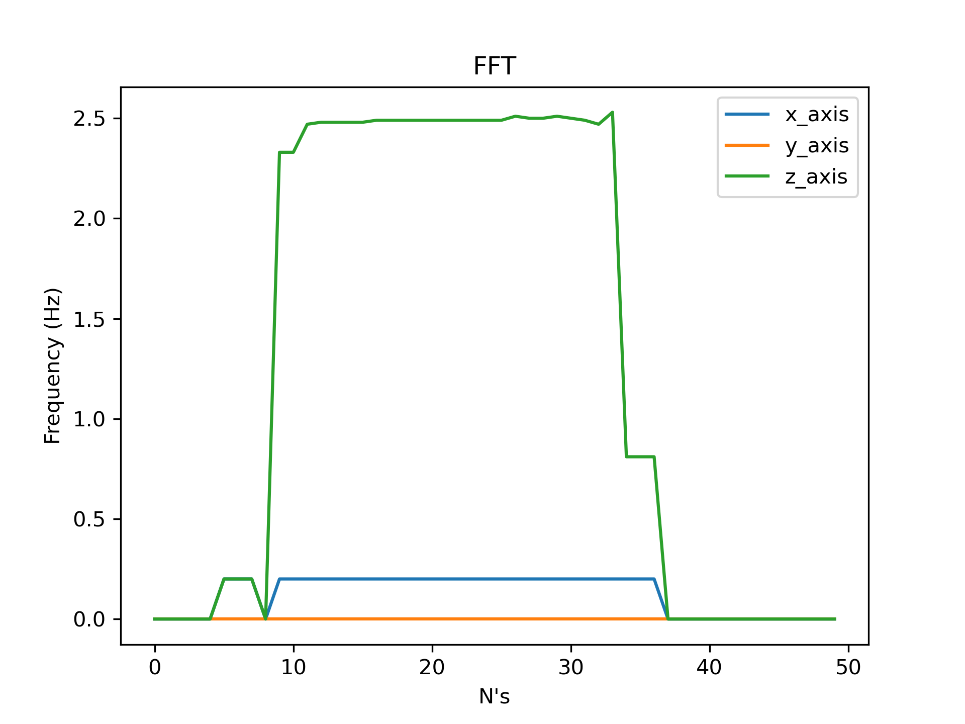
Code/serialPlot/Tests/Test4/plots/rFB1FFT.png
