JessyBarber/Jessy-Thesis/Code/serialPlot/Tests/Test4/plots/rFB1MA.png

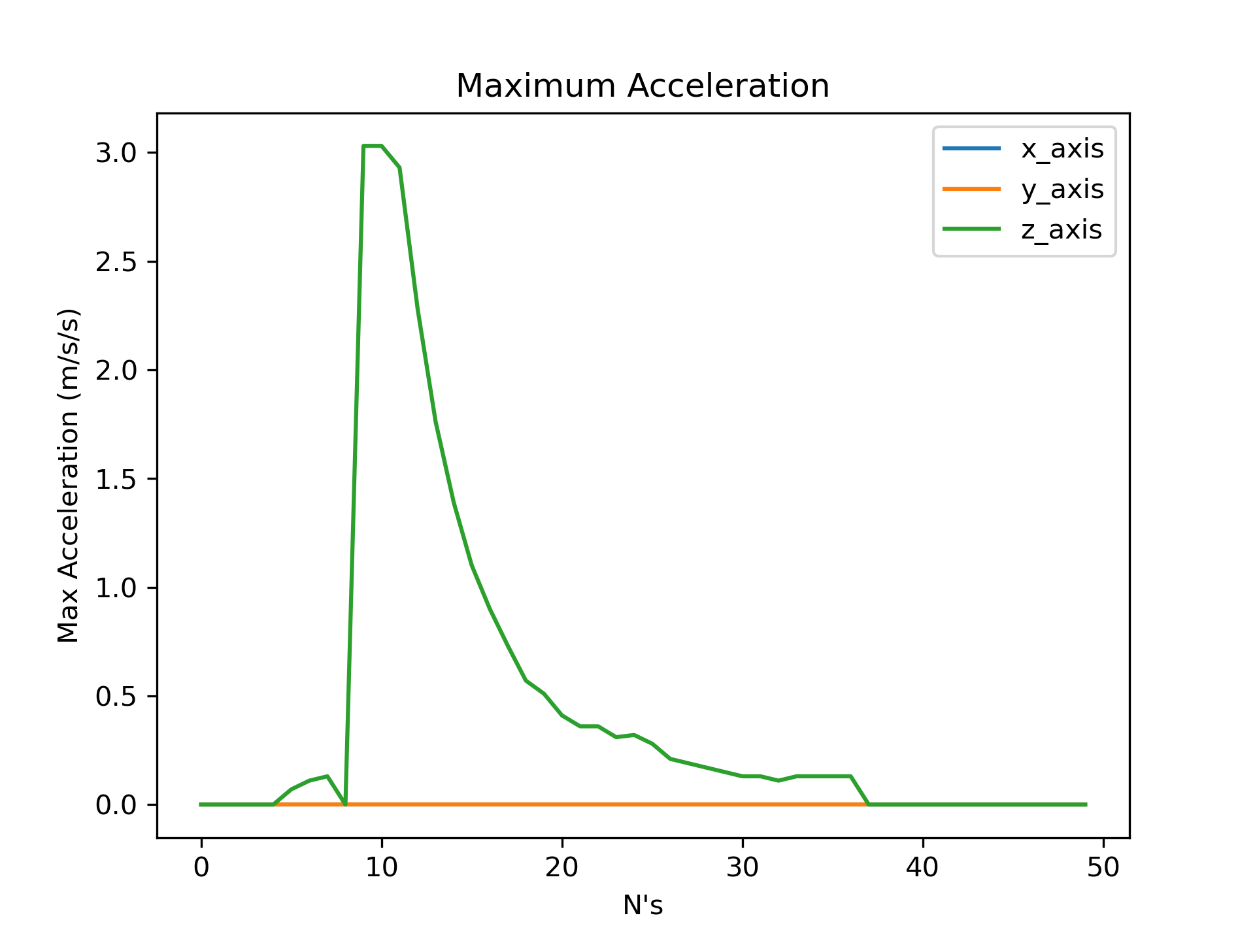
Code/serialPlot/Tests/Test4/plots/rFB1MA.png
