JessyBarber/Jessy-Thesis/Code/serialPlot/Tests/Test4/plots/rFB2FFT.png

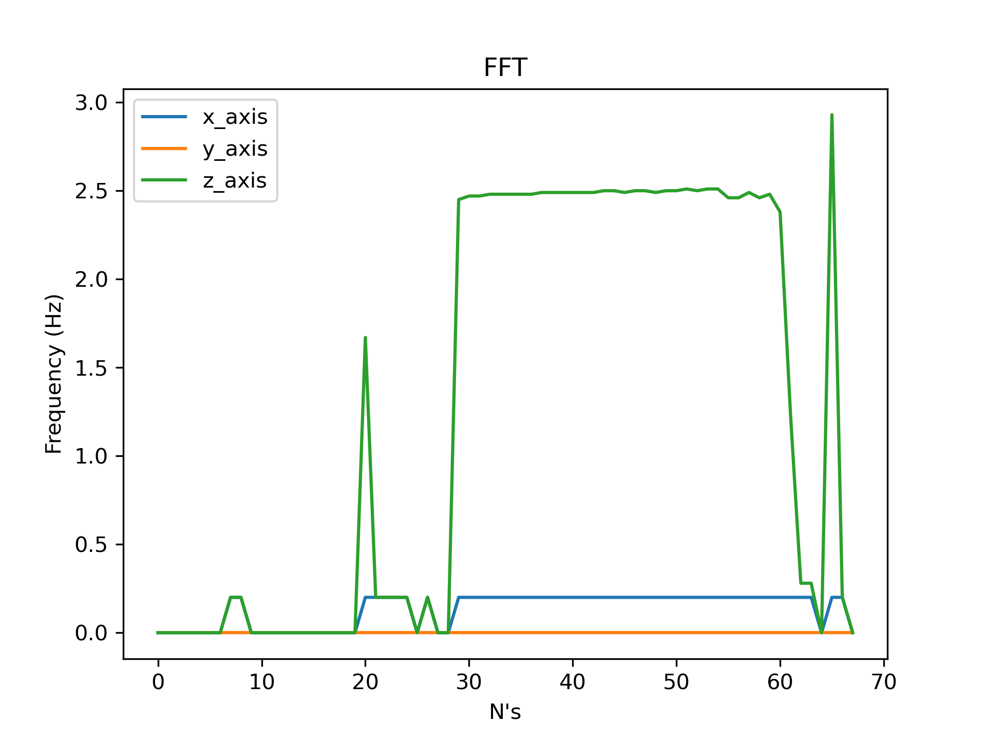
Code/serialPlot/Tests/Test4/plots/rFB2FFT.png
