JessyBarber/Jessy-Thesis/Code/serialPlot/Tests/Test4/plots/rFB3FFT.png

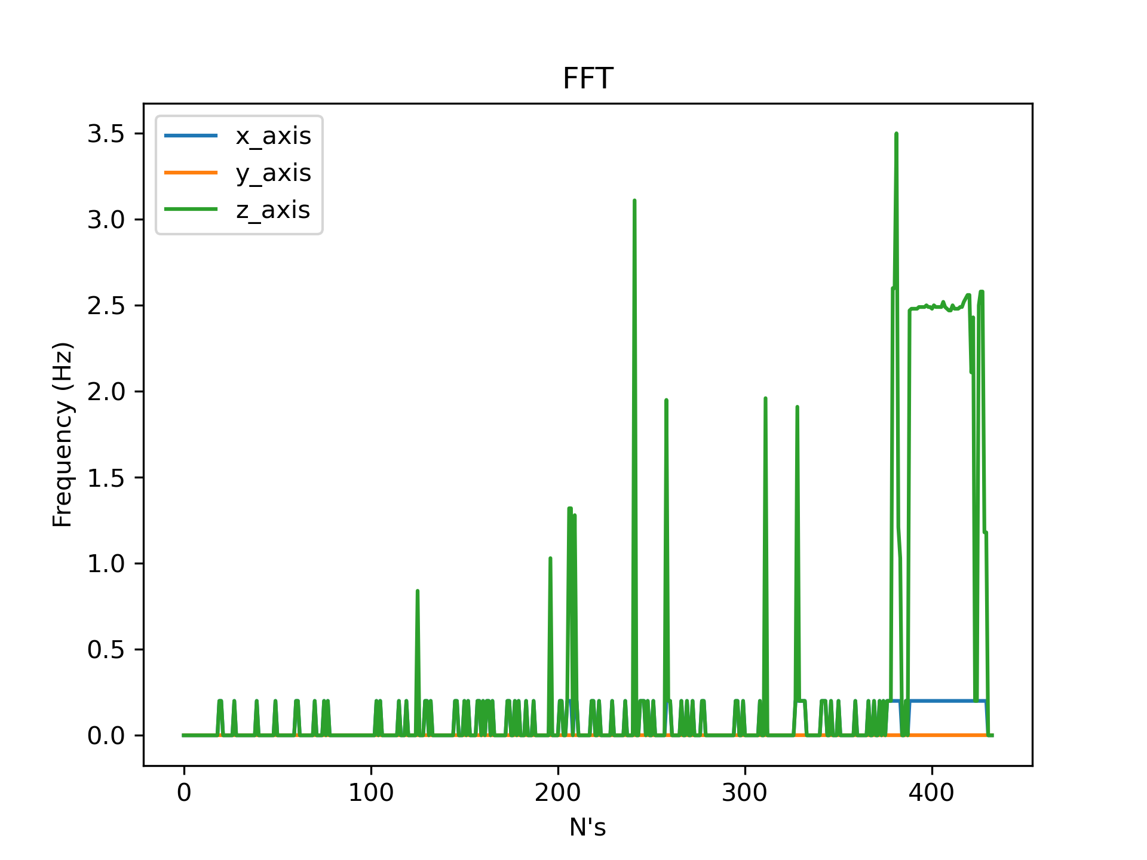
Code/serialPlot/Tests/Test4/plots/rFB3FFT.png
