JessyBarber/Jessy-Thesis/Code/serialPlot/Tests/Test4/plots/rFB3MA.png

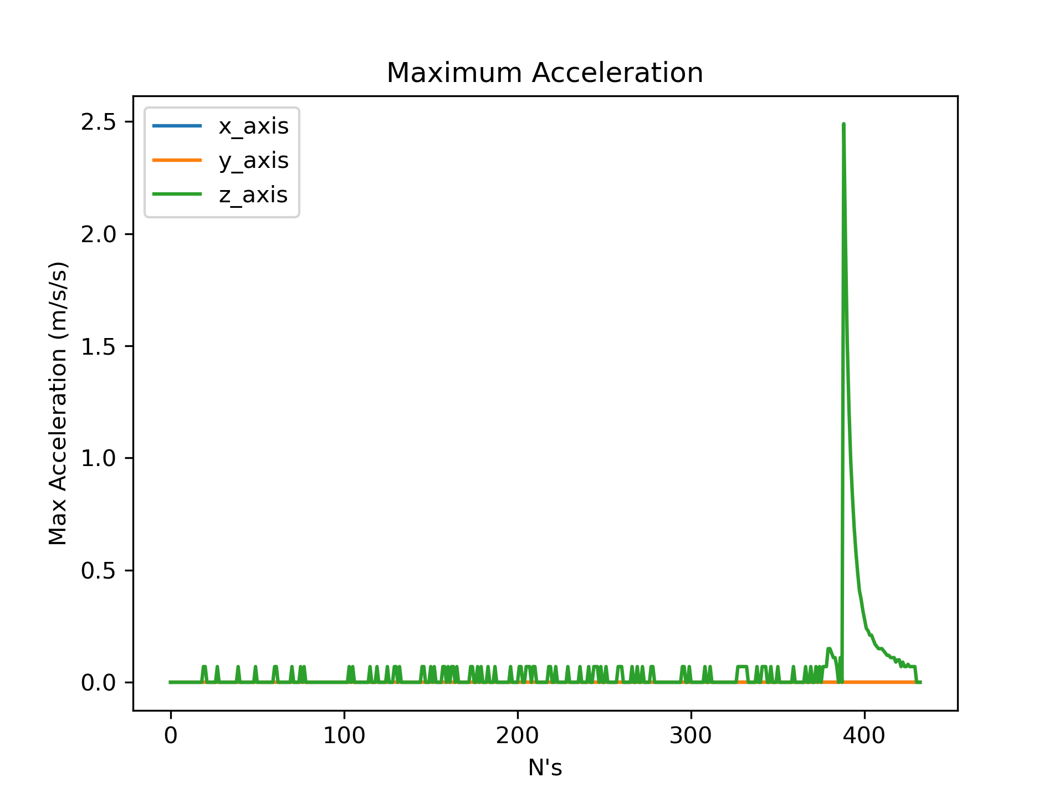
Code/serialPlot/Tests/Test4/plots/rFB3MA.png
