JessyBarber/Jessy-Thesis/Code/serialPlot/Tests/Test4/plots/rFB4FFT.png

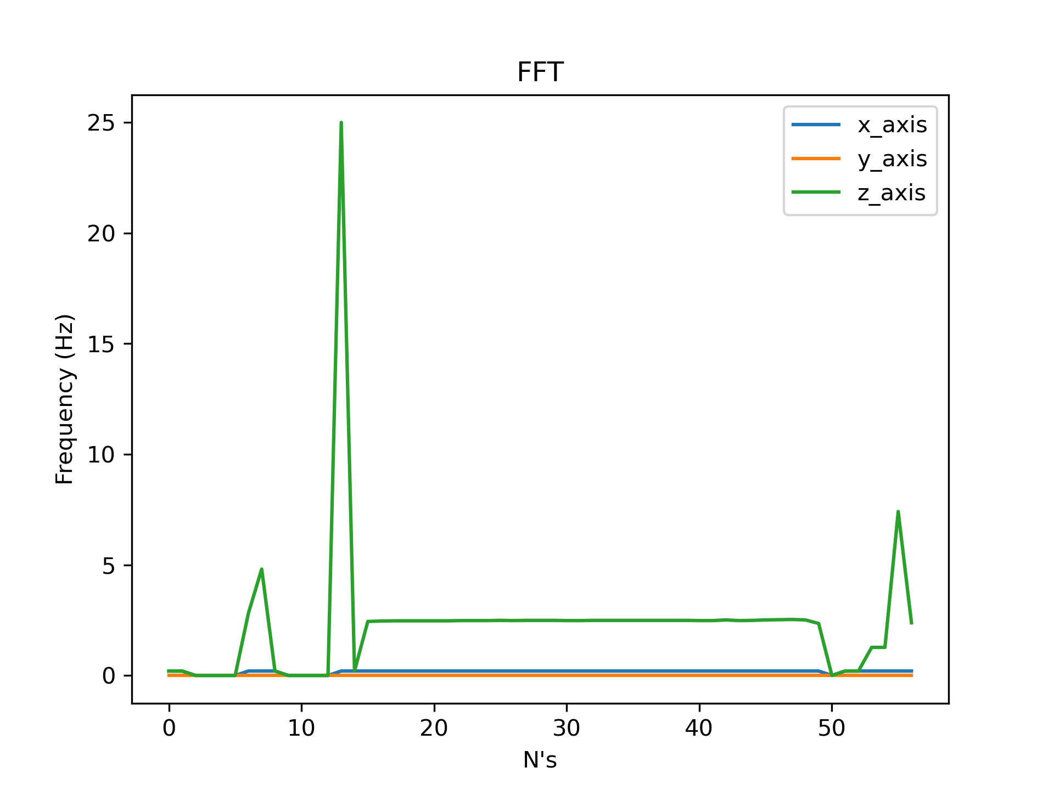
Code/serialPlot/Tests/Test4/plots/rFB4FFT.png
