JessyBarber/Jessy-Thesis/Code/serialPlot/Tests/Test4/plots/rFB4MA.png

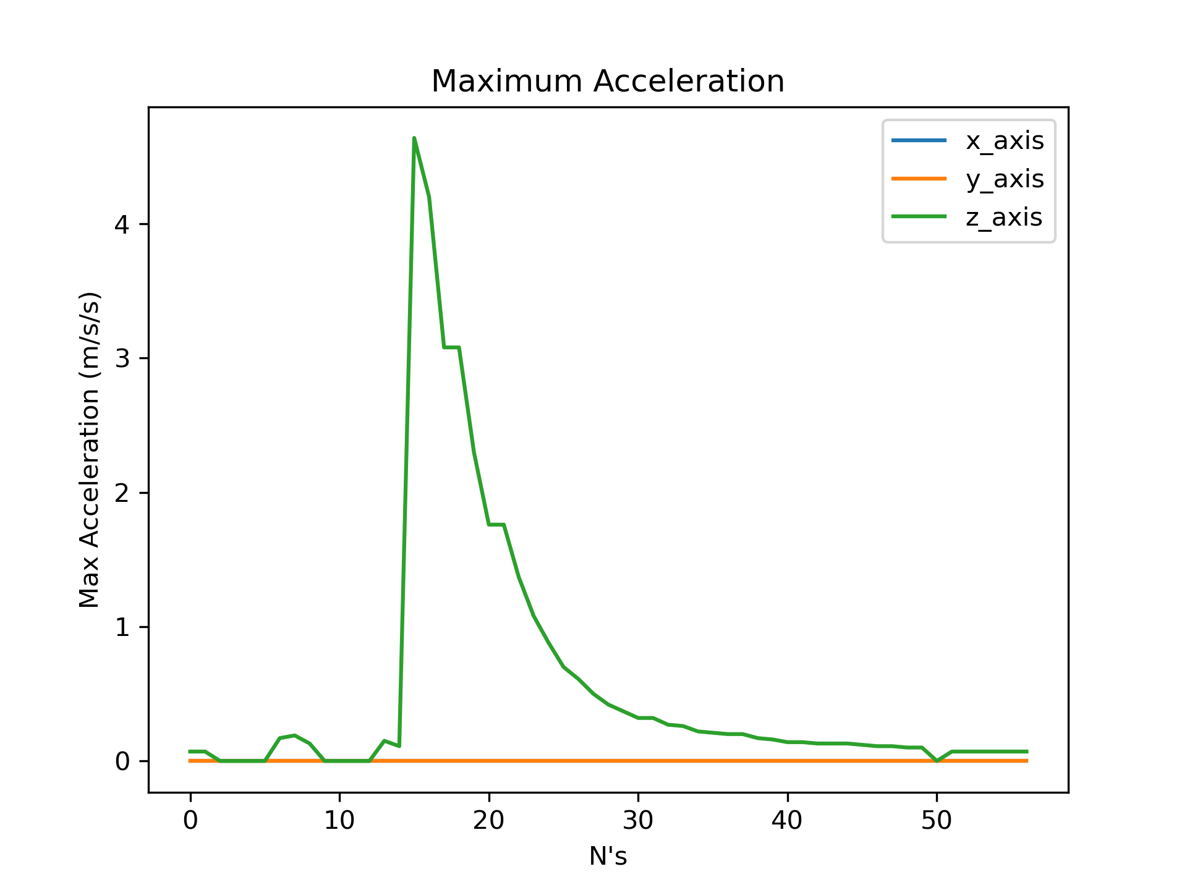
Code/serialPlot/Tests/Test4/plots/rFB4MA.png
