JessyBarber/Jessy-Thesis/Code/serialPlot/Tests/Test4/plots/rFB5FFT.png

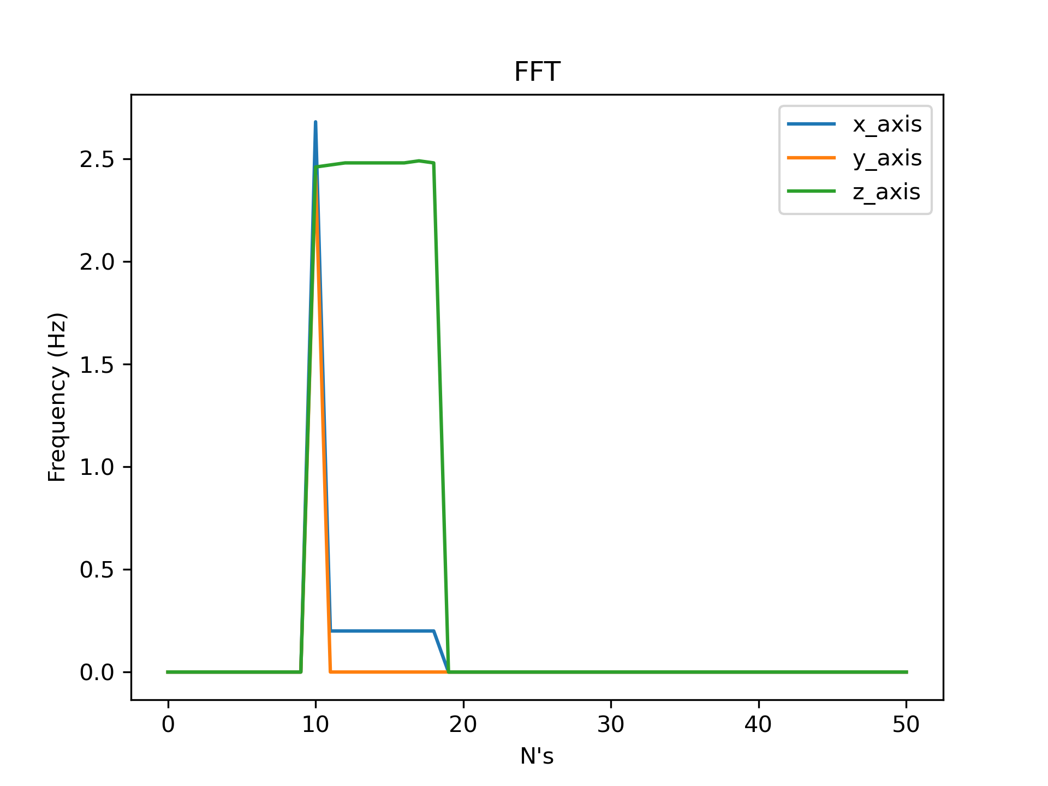
Code/serialPlot/Tests/Test4/plots/rFB5FFT.png
