JessyBarber/Jessy-Thesis/Code/serialPlot/Tests/Test4/plots/rFB5MA.png

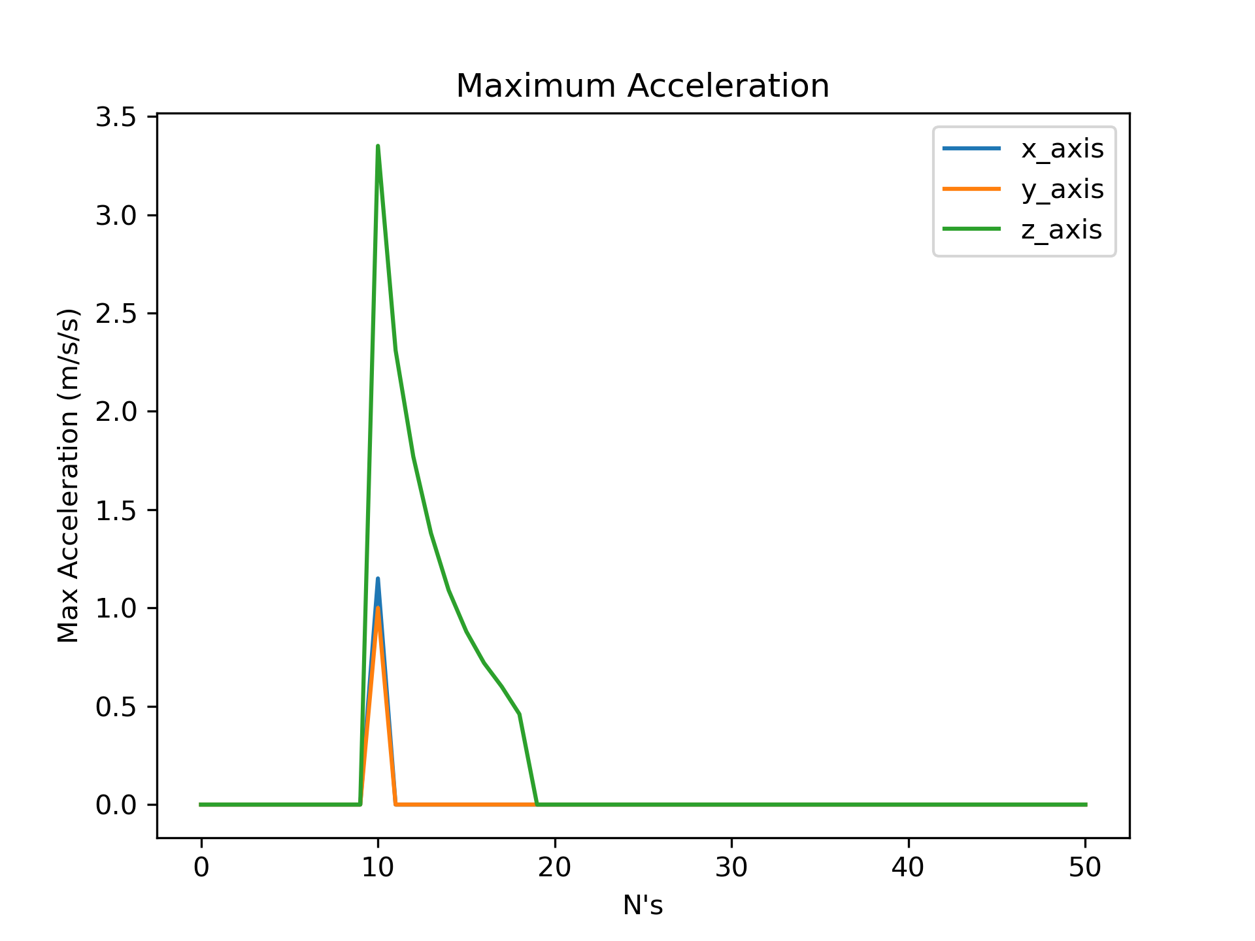
Code/serialPlot/Tests/Test4/plots/rFB5MA.png
