JessyBarber/Jessy-Thesis/Code/serialPlot/Tests/Test4/plots/rFB6FFT.png

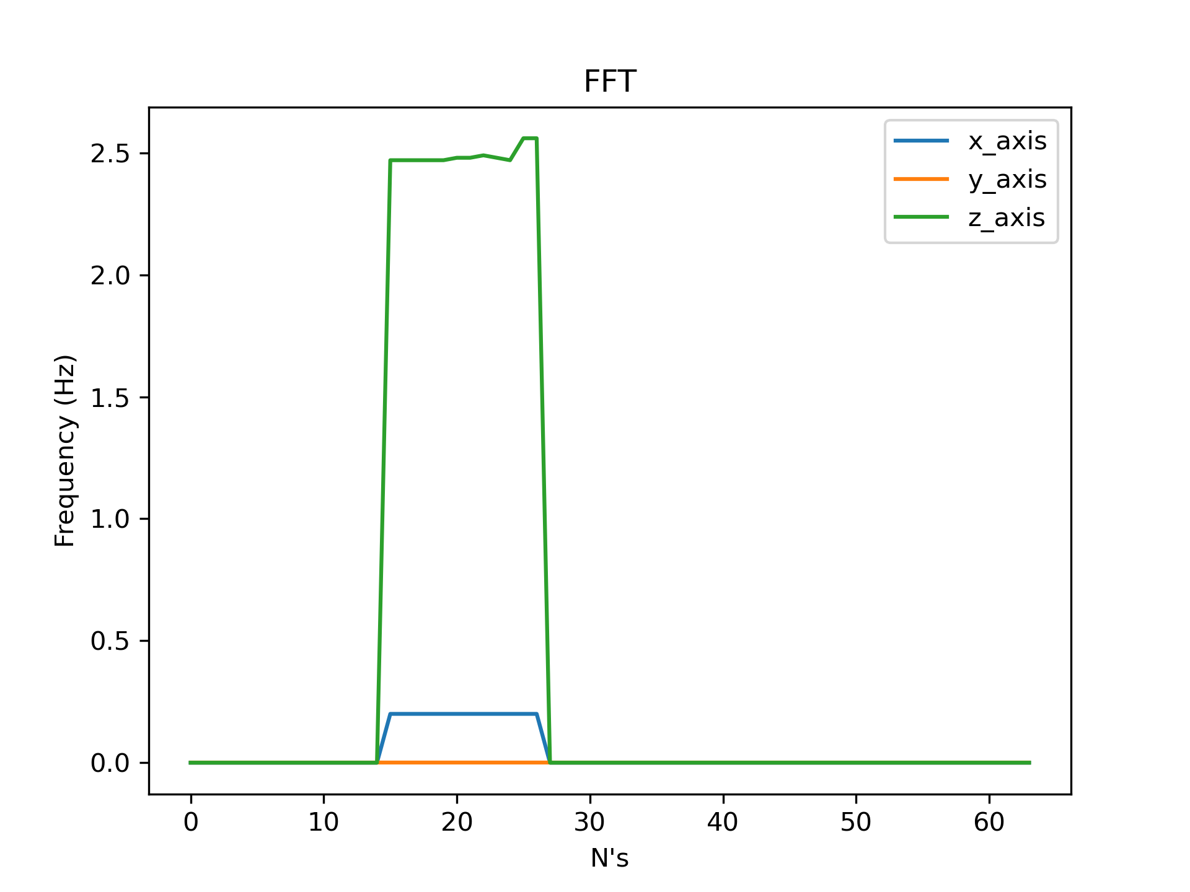
Code/serialPlot/Tests/Test4/plots/rFB6FFT.png
