JessyBarber/Jessy-Thesis/Code/serialPlot/Tests/Test4/plots/rFB7FFT.png

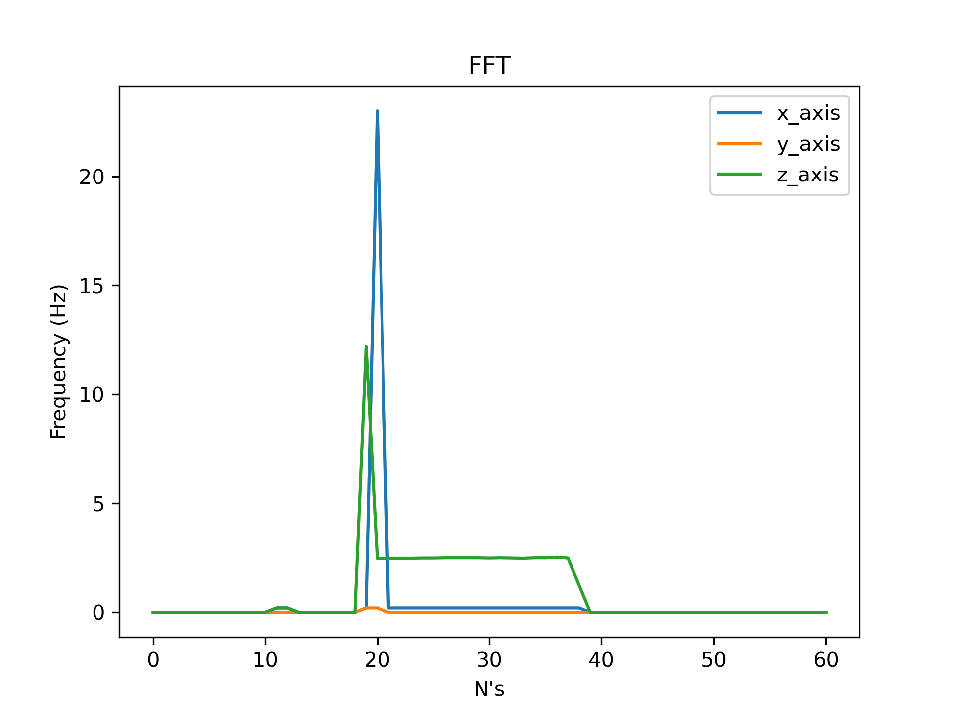
Code/serialPlot/Tests/Test4/plots/rFB7FFT.png
