JessyBarber/Jessy-Thesis/Code/serialPlot/Tests/Test4/plots/rFB7MA.png

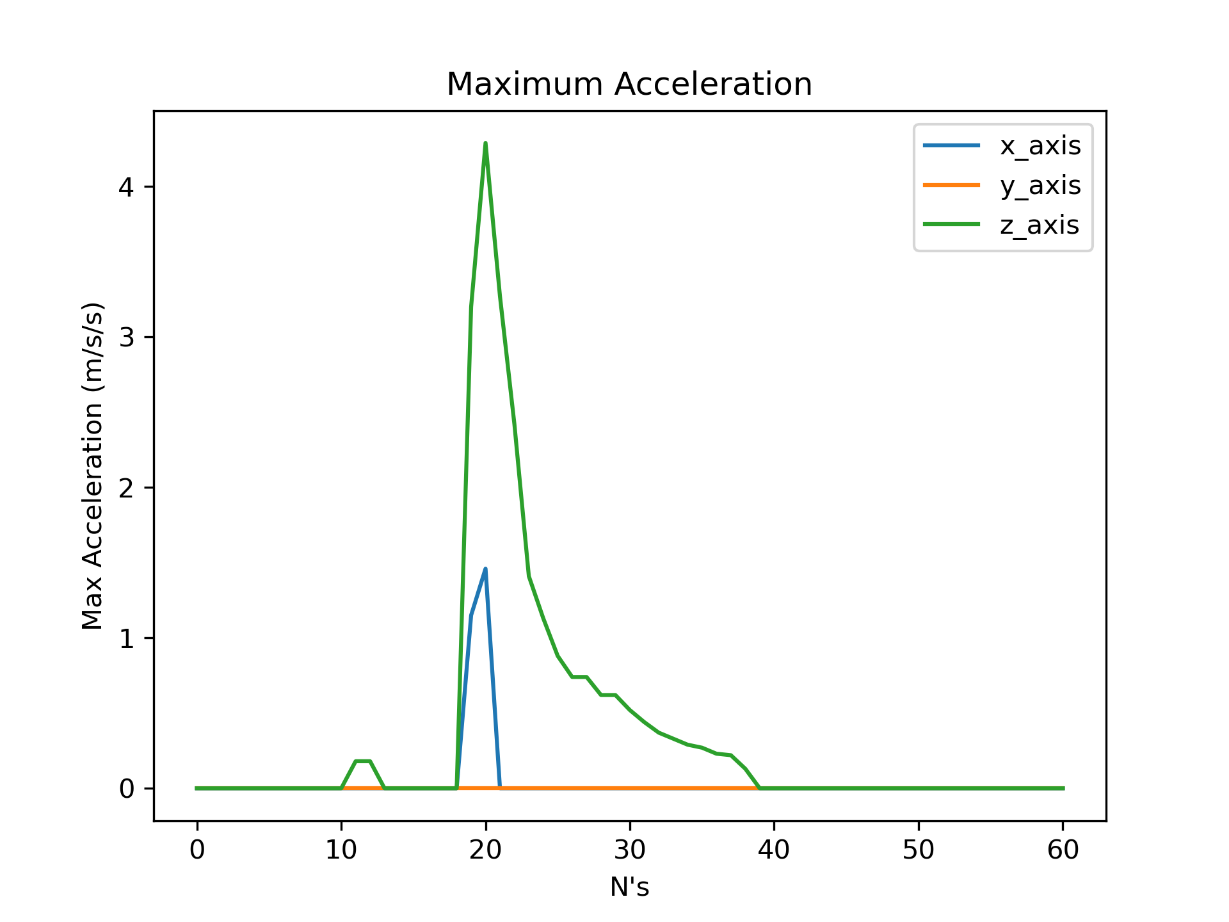
Code/serialPlot/Tests/Test4/plots/rFB7MA.png
