JessyBarber/Jessy-Thesis/Code/serialPlot/Tests/Test4/plots/rFB8FFT.png

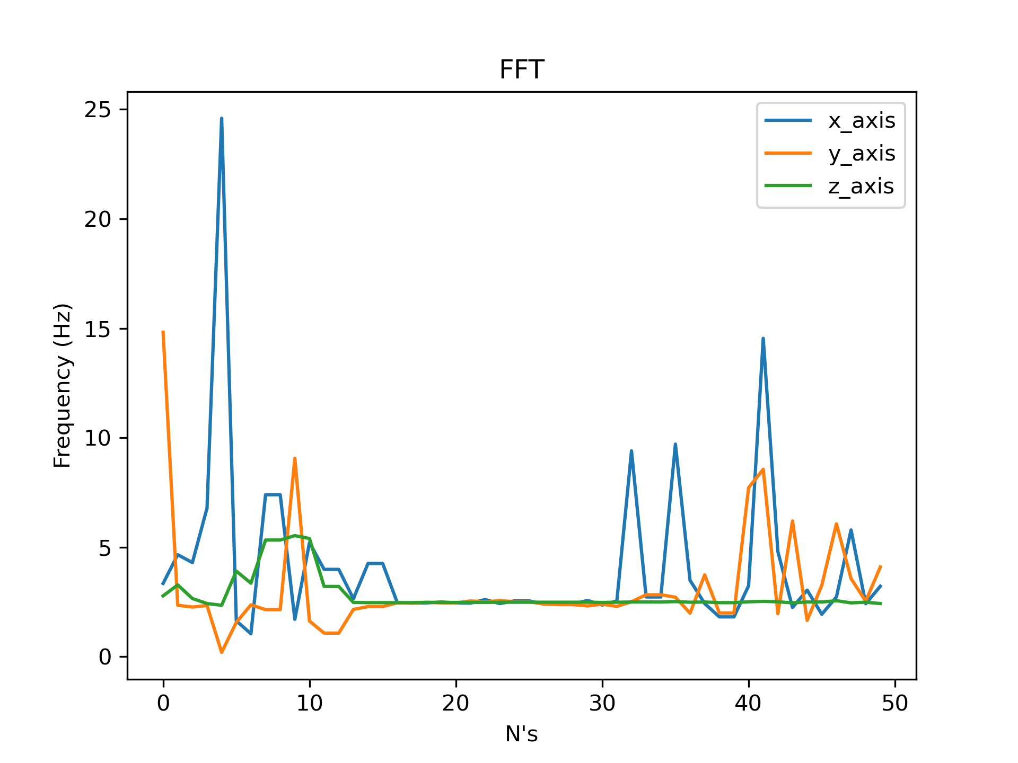
Code/serialPlot/Tests/Test4/plots/rFB8FFT.png
