JessyBarber/Jessy-Thesis/Code/serialPlot/Tests/Test4/plots/rFB8MA.png

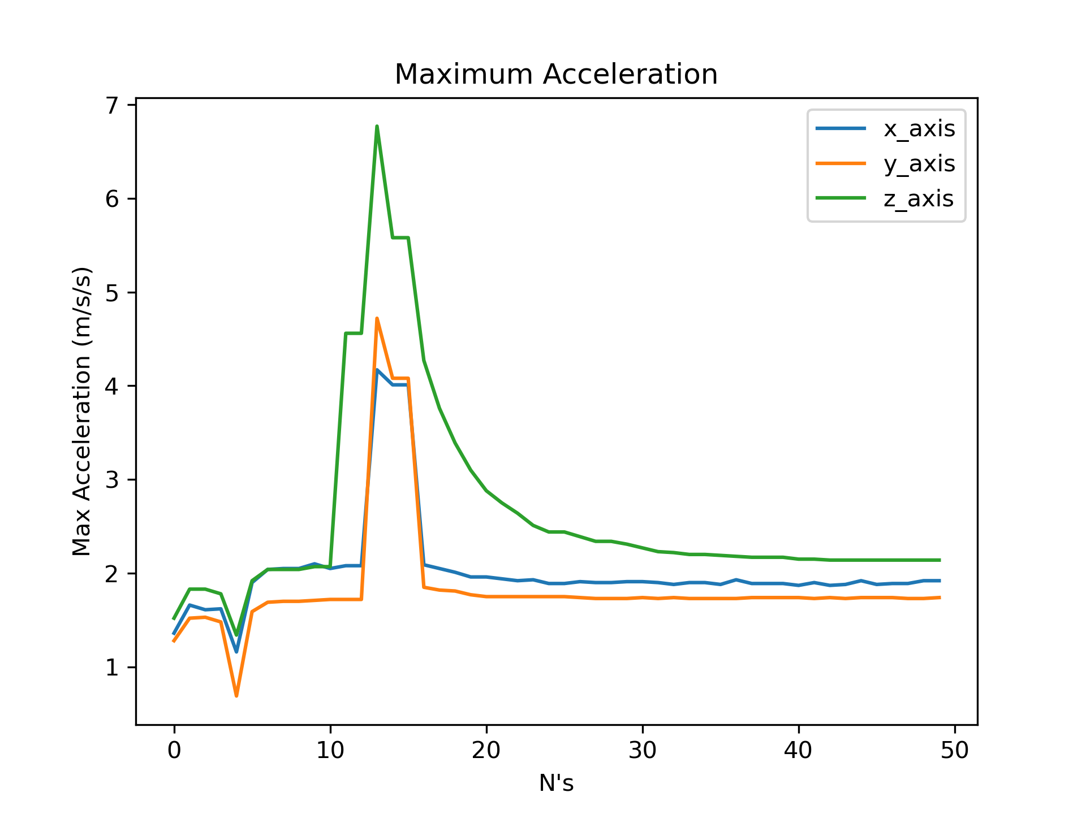
Code/serialPlot/Tests/Test4/plots/rFB8MA.png
