JessyBarber/Jessy-Thesis/Code/serialPlot/Tests/Test4/plots/rFBTest1FFT.png

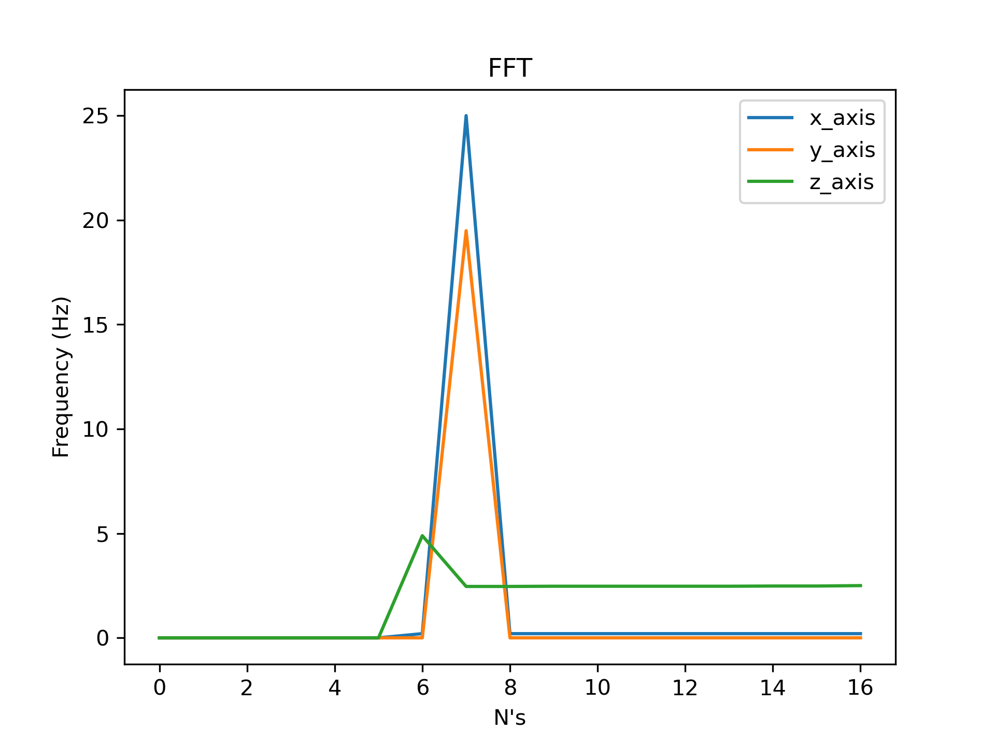
Code/serialPlot/Tests/Test4/plots/rFBTest1FFT.png
