JessyBarber/Jessy-Thesis/Code/serialPlot/Tests/Test4/plots/rFBTest1MA.png

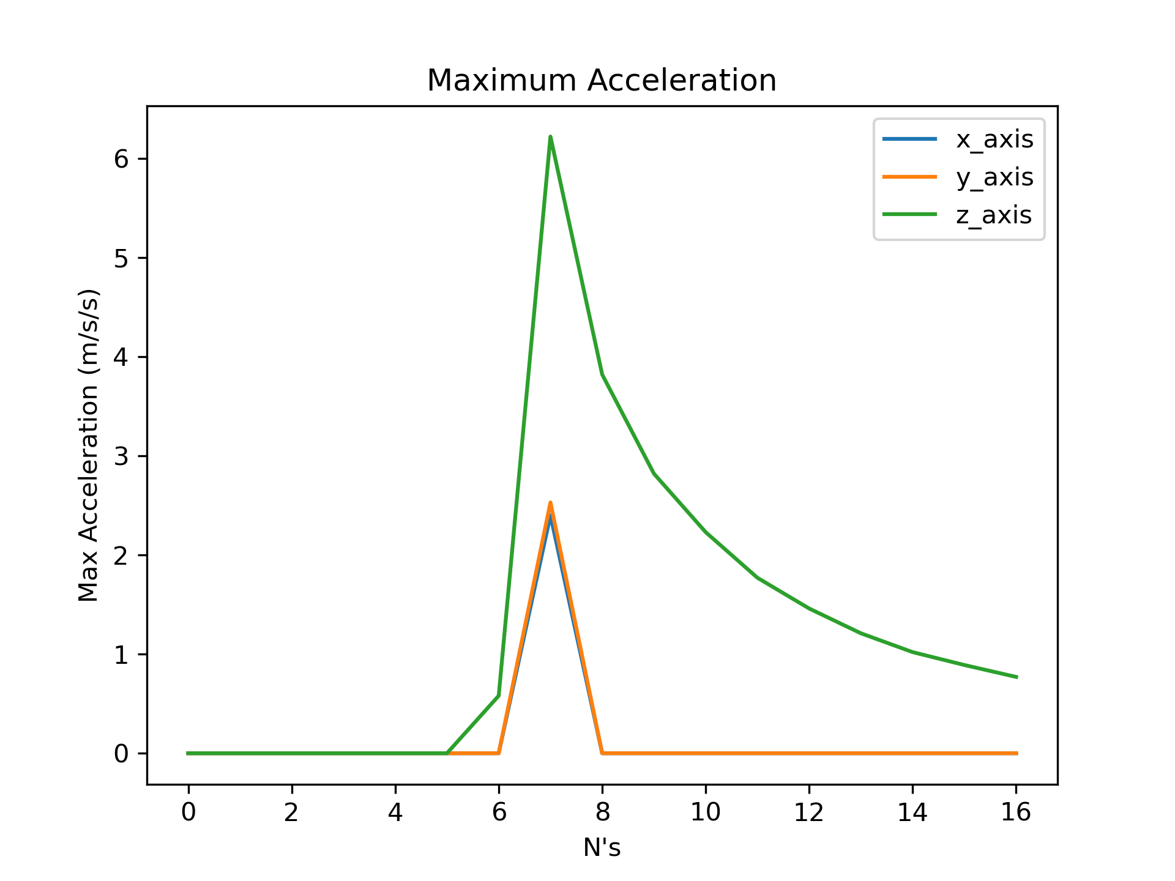
Code/serialPlot/Tests/Test4/plots/rFBTest1MA.png
