JessyBarber/Jessy-Thesis/Code/serialPlot/Tests/Test4/plots/rFBTest2FFT.png

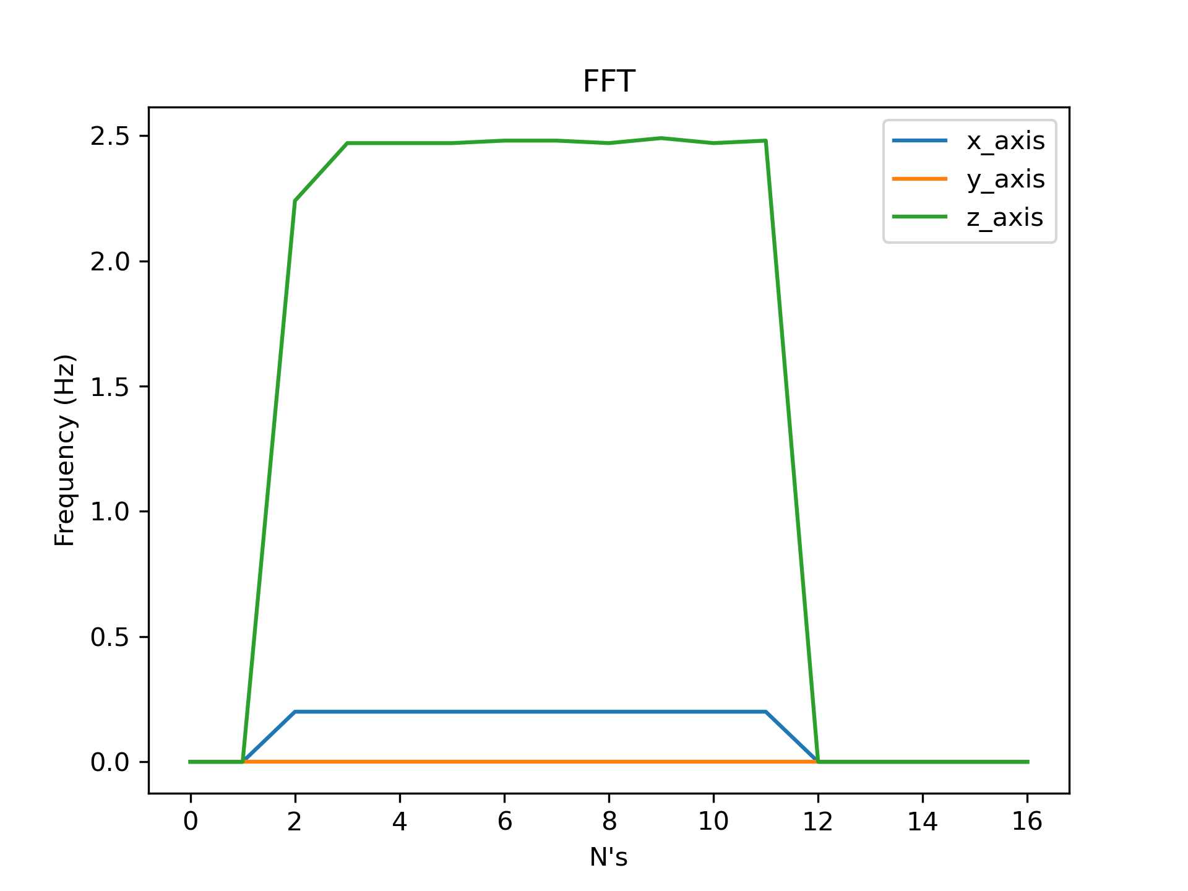
Code/serialPlot/Tests/Test4/plots/rFBTest2FFT.png
