JessyBarber/Jessy-Thesis/Code/serialPlot/Tests/Test4/plots/rFBTest3FFT.png

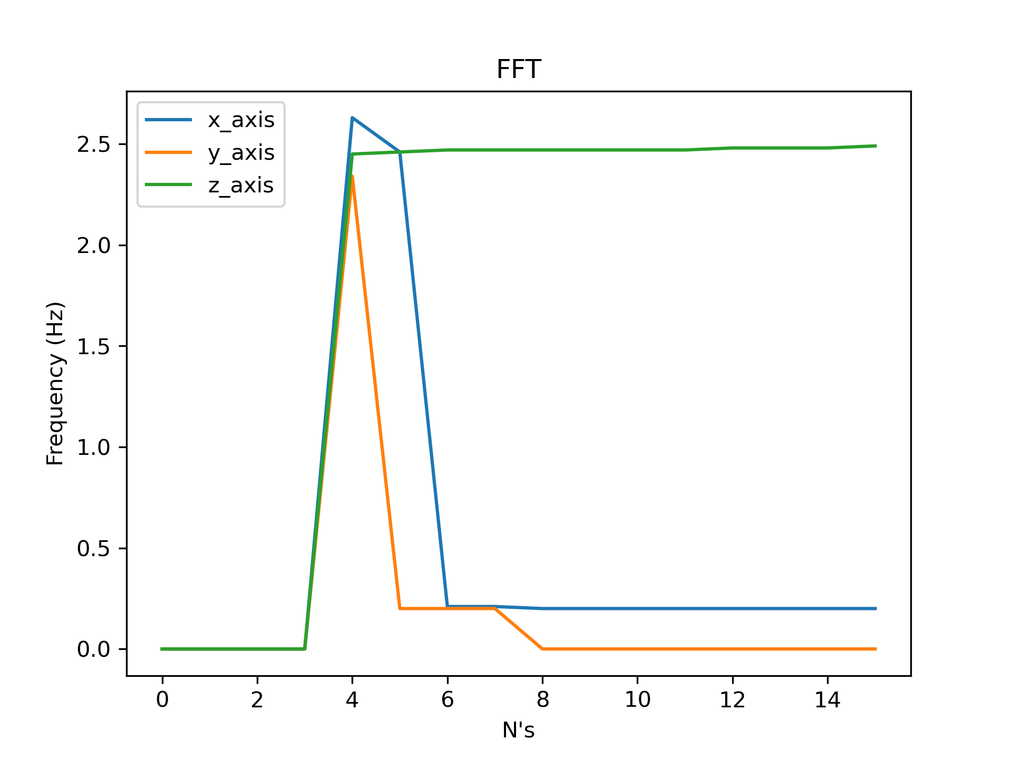
Code/serialPlot/Tests/Test4/plots/rFBTest3FFT.png
