JessyBarber/Jessy-Thesis/Code/serialPlot/Tests/Test4/plots/rFBTest3MA.png

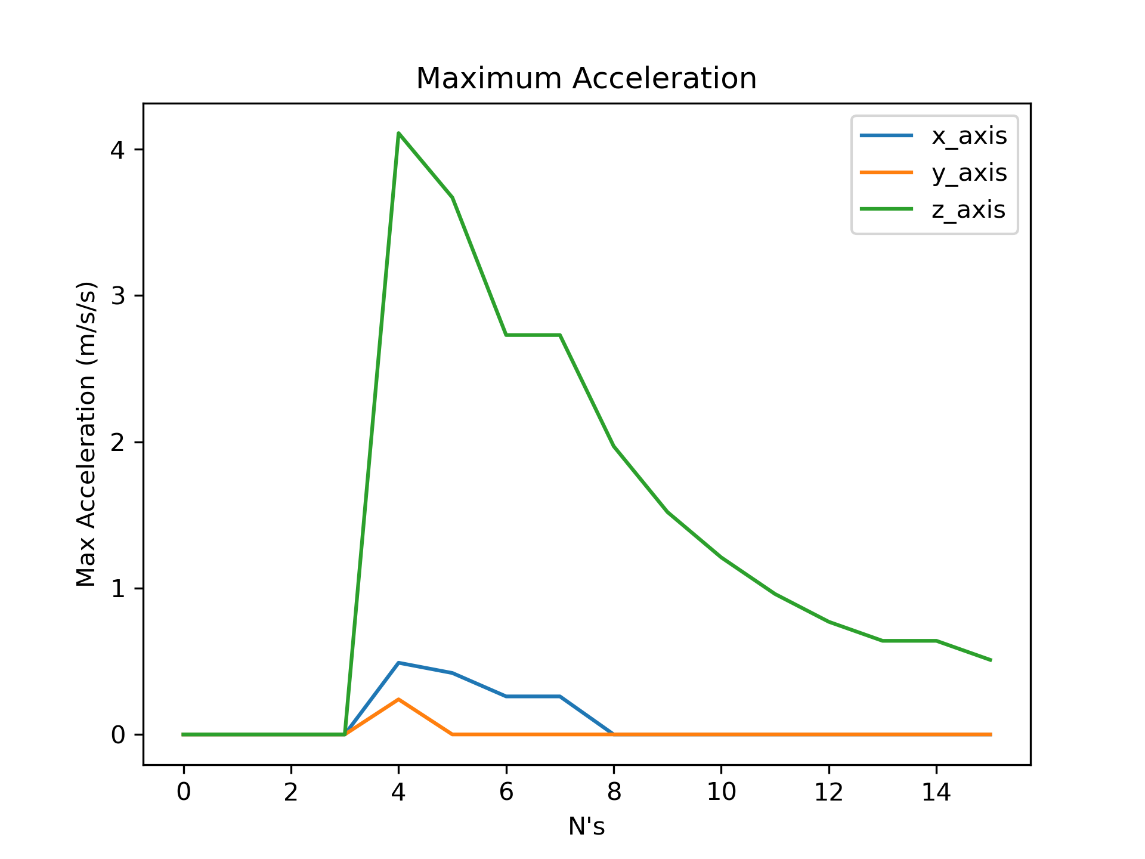
Code/serialPlot/Tests/Test4/plots/rFBTest3MA.png
