JessyBarber/Jessy-Thesis/Code/serialPlot/Tests/Test4/plots/rFBTest6FFT.png

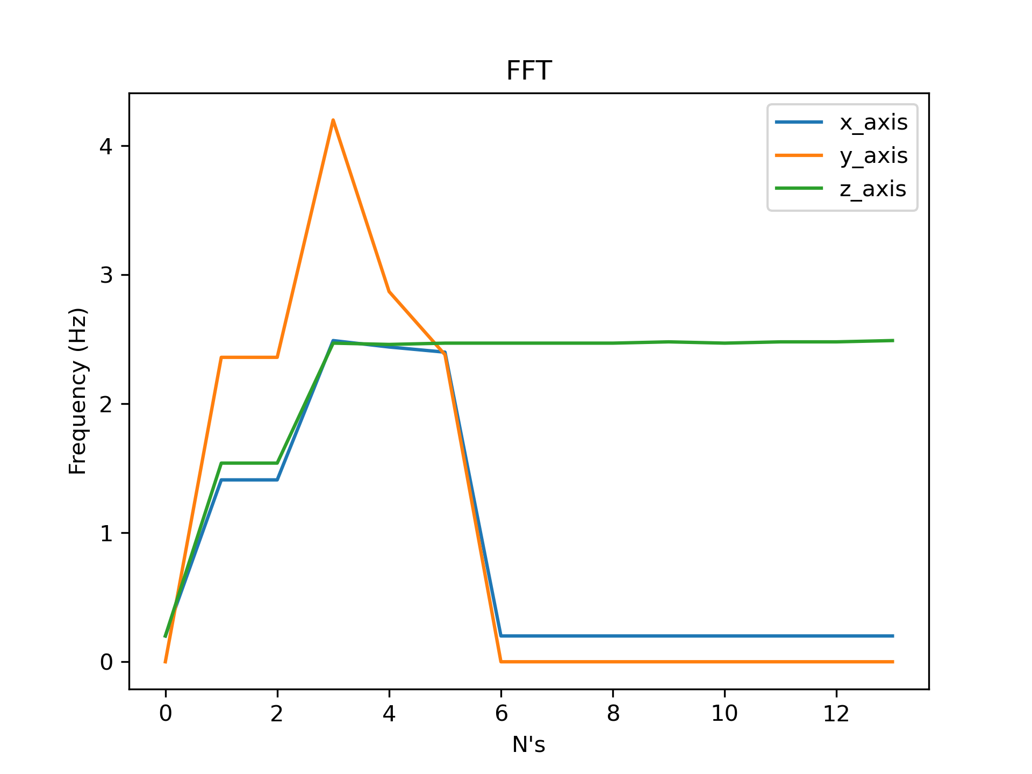
Code/serialPlot/Tests/Test4/plots/rFBTest6FFT.png
