JessyBarber/Jessy-Thesis/Code/serialPlot/Tests/Test4/plots/rFBTest6MA.png

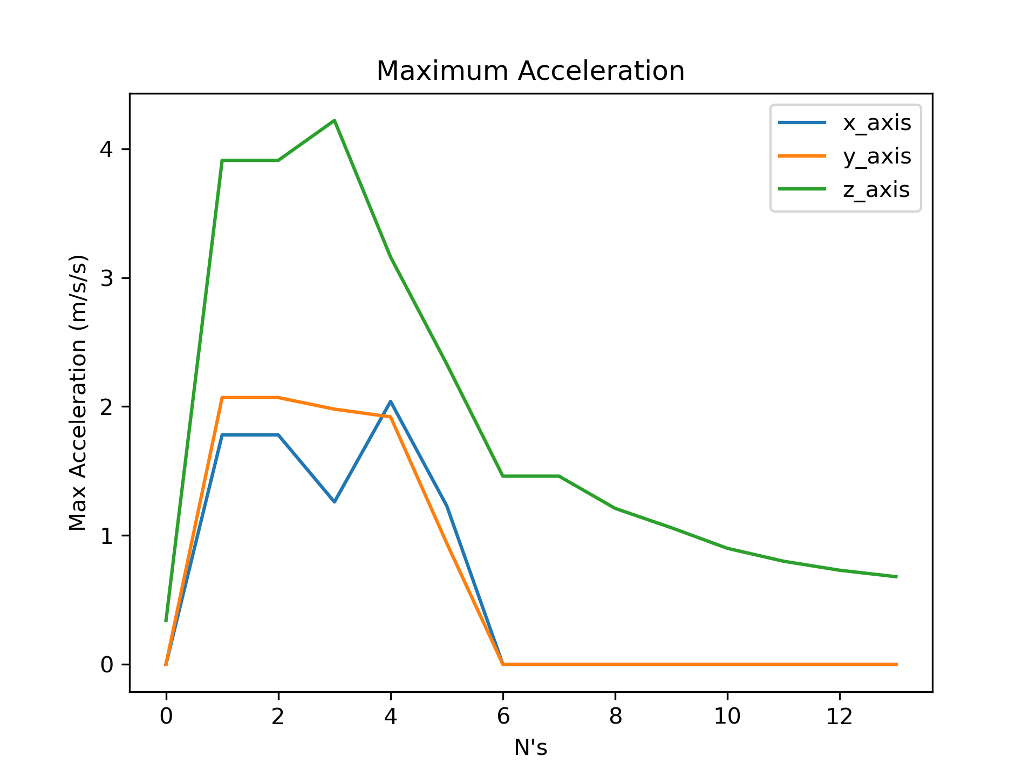
Code/serialPlot/Tests/Test4/plots/rFBTest6MA.png
