JessyBarber/Jessy-Thesis/Code/serialPlot/Tests/Test4/plots/rFBTest7FFT.png

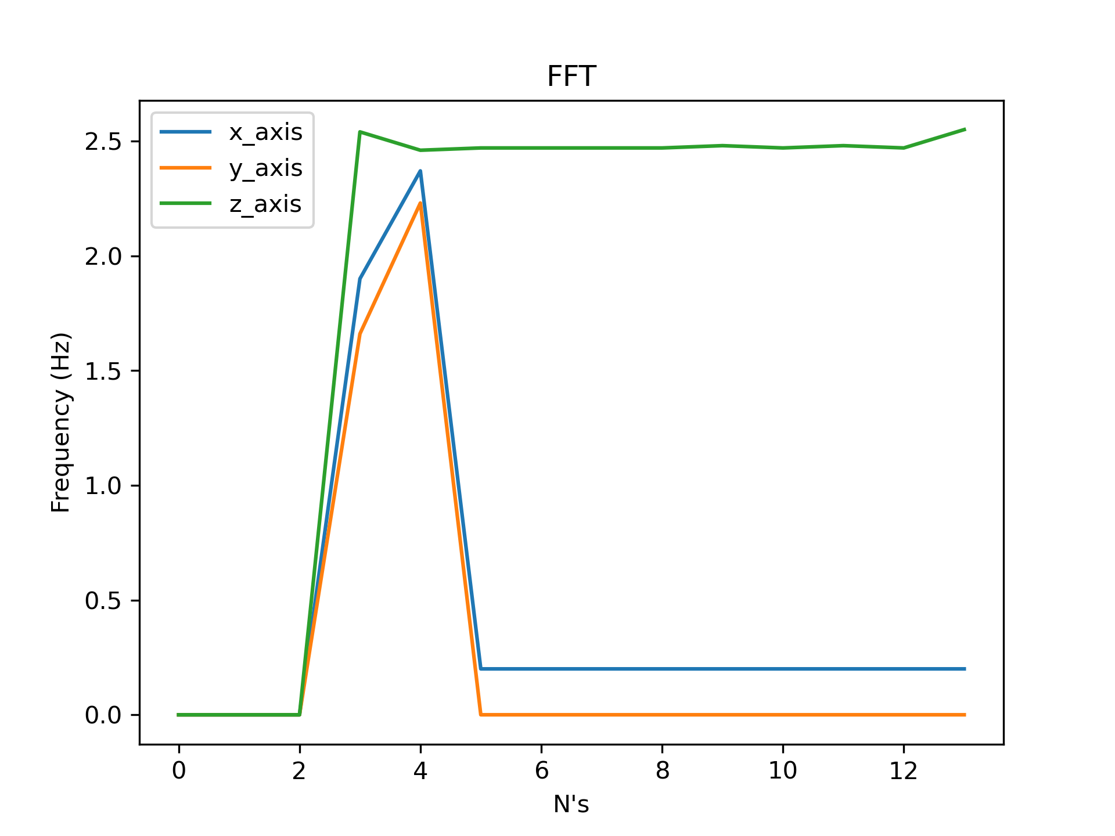
Code/serialPlot/Tests/Test4/plots/rFBTest7FFT.png
