JessyBarber/Jessy-Thesis/Code/serialPlot/Tests/Test4/plots/rFBTest7MA.png

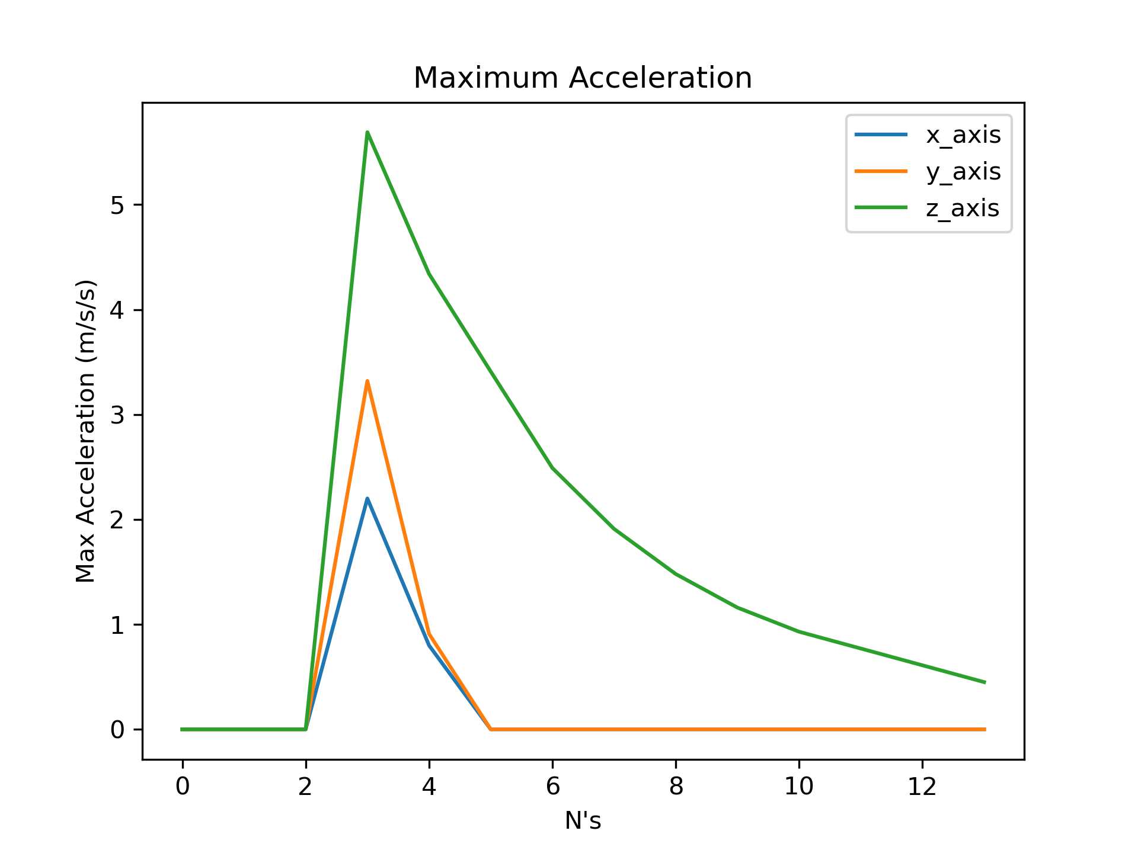
Code/serialPlot/Tests/Test4/plots/rFBTest7MA.png
