JessyBarber/Jessy-Thesis/Code/serialPlot/Tests/Test4/plots/rFBTest8FFT.png

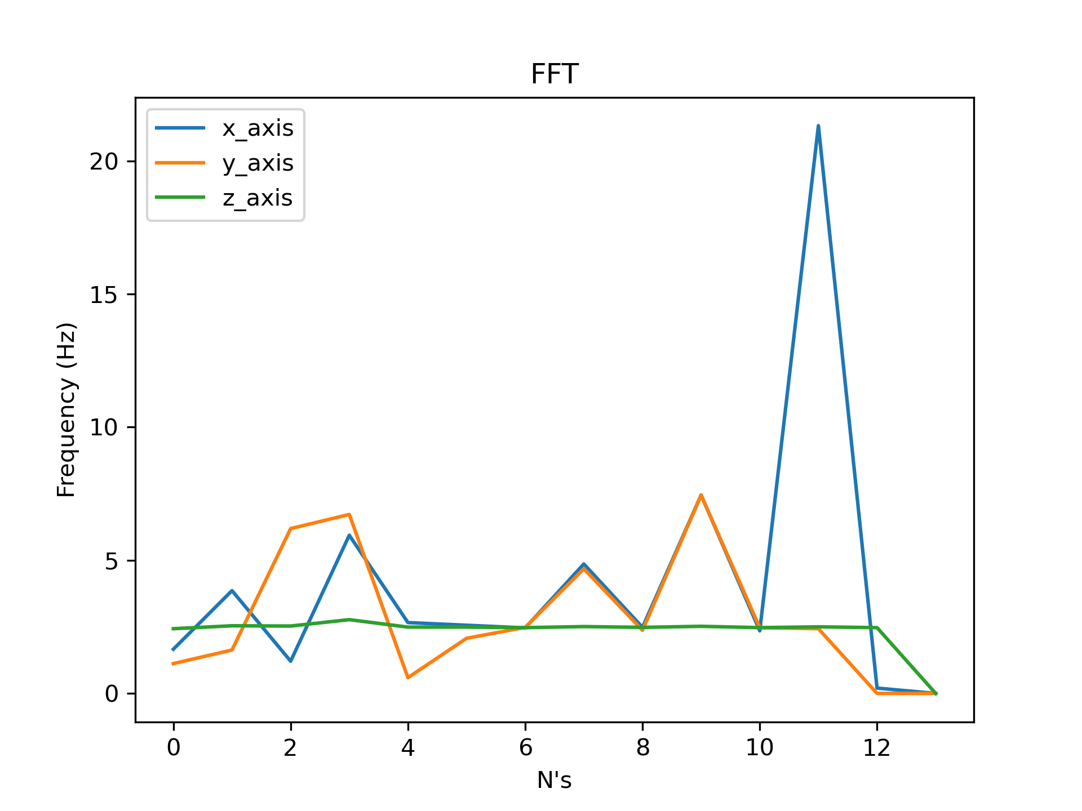
Code/serialPlot/Tests/Test4/plots/rFBTest8FFT.png
