JessyBarber/Jessy-Thesis/Code/serialPlot/Tests/Test4/plots/rFBTest8MA.png

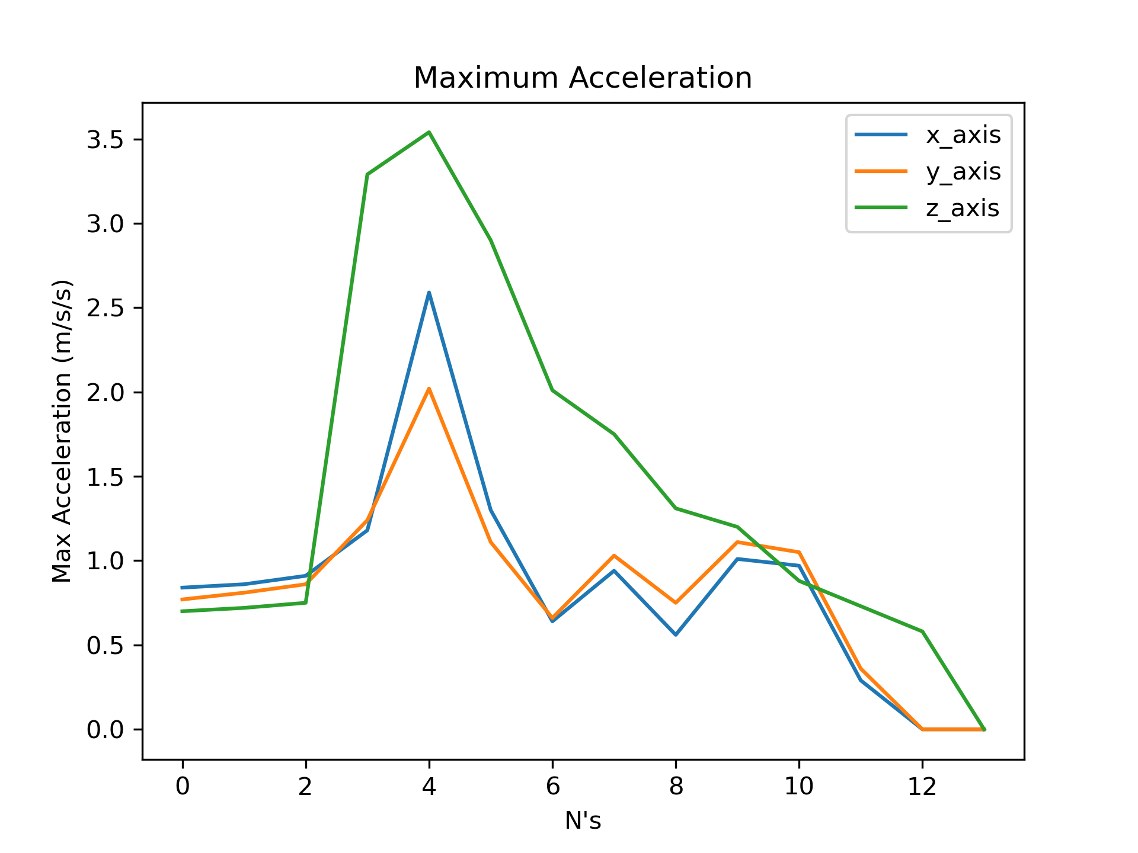
Code/serialPlot/Tests/Test4/plots/rFBTest8MA.png
