JessyBarber/Jessy-Thesis/Code/serialPlot/Tests/Test4/plots/rFBTest9FFT.png

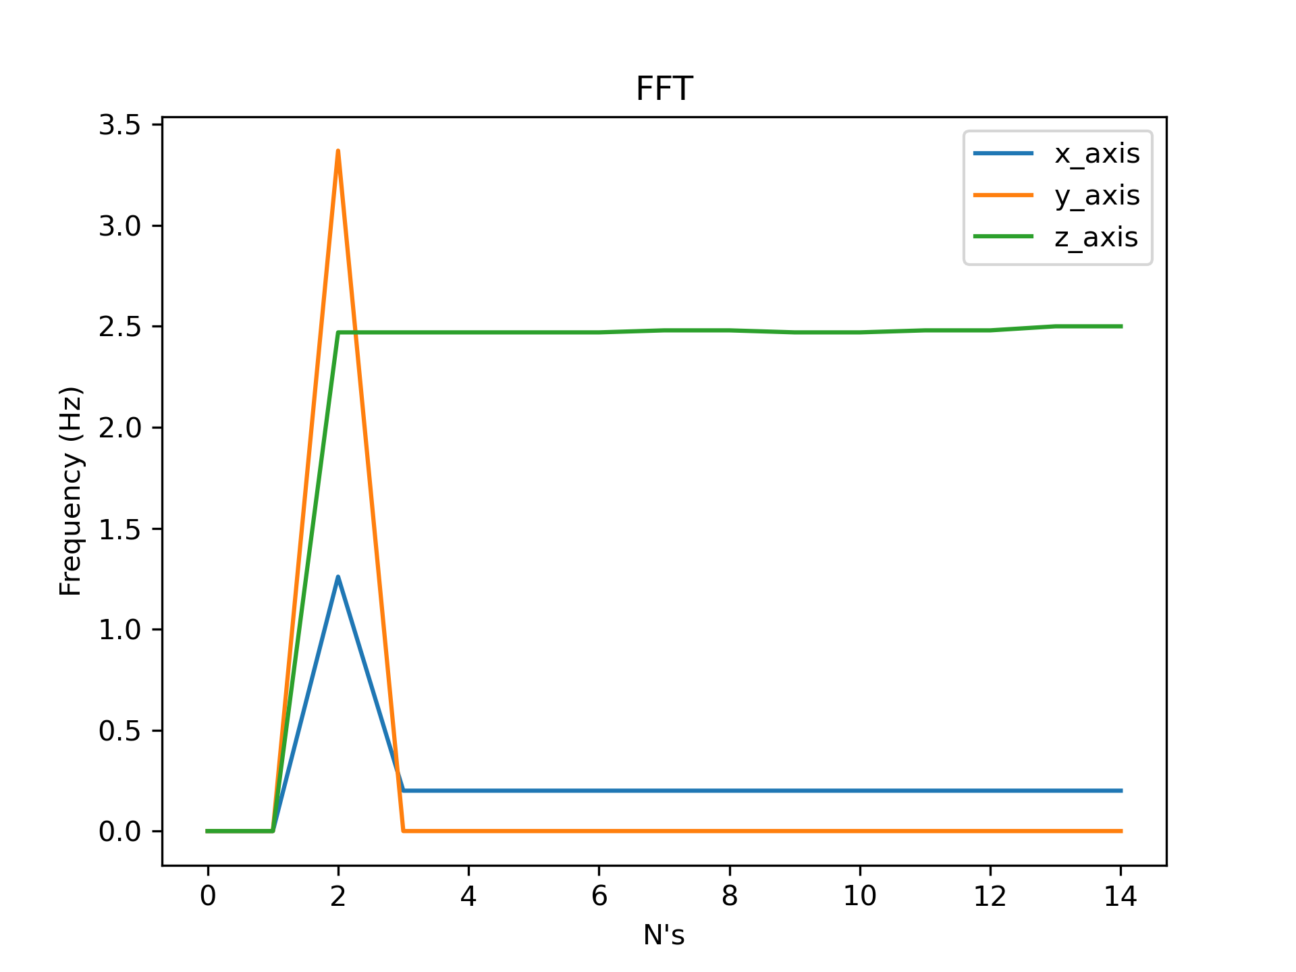
Code/serialPlot/Tests/Test4/plots/rFBTest9FFT.png
