JessyBarber/Jessy-Thesis/Code/serialPlot/Tests/Test4/plots/rFBTest9MA.png

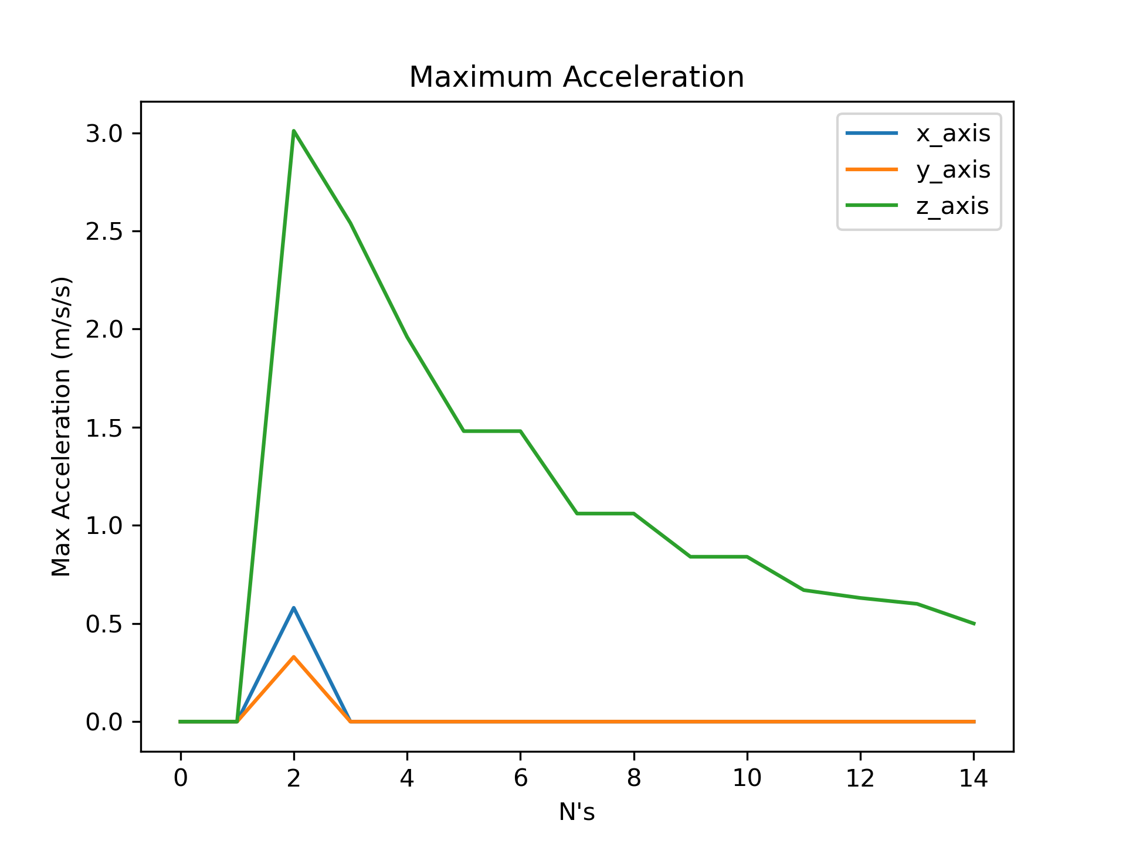
Code/serialPlot/Tests/Test4/plots/rFBTest9MA.png
