JessyBarber/Jessy-Thesis/Code/serialPlot/Tests/Test4/plots/rFBTest10FFT.png

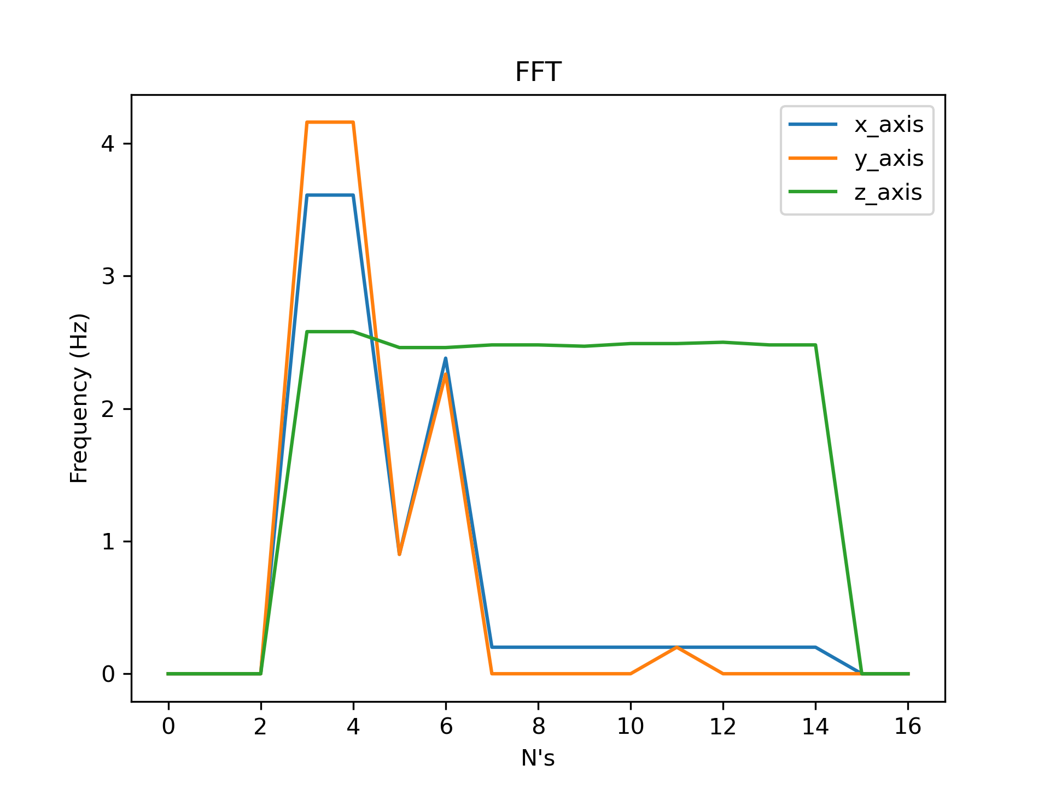
Code/serialPlot/Tests/Test4/plots/rFBTest10FFT.png
