JessyBarber/Jessy-Thesis/Code/serialPlot/Tests/Test4/plots/rFBTest10MA.png

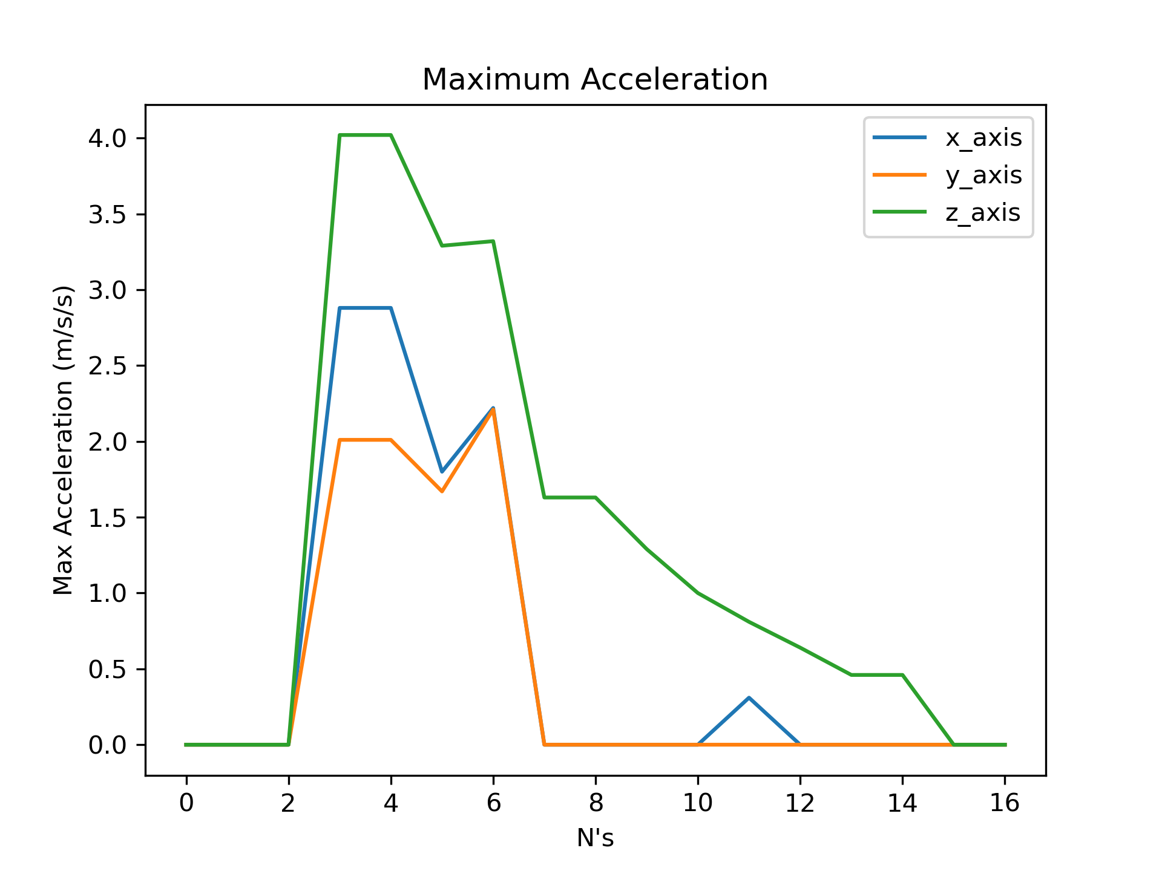
Code/serialPlot/Tests/Test4/plots/rFBTest10MA.png
