JessyBarber/Jessy-Thesis/Code/serialPlot/Tests/Test4/plots/rFBTest11FFT.png

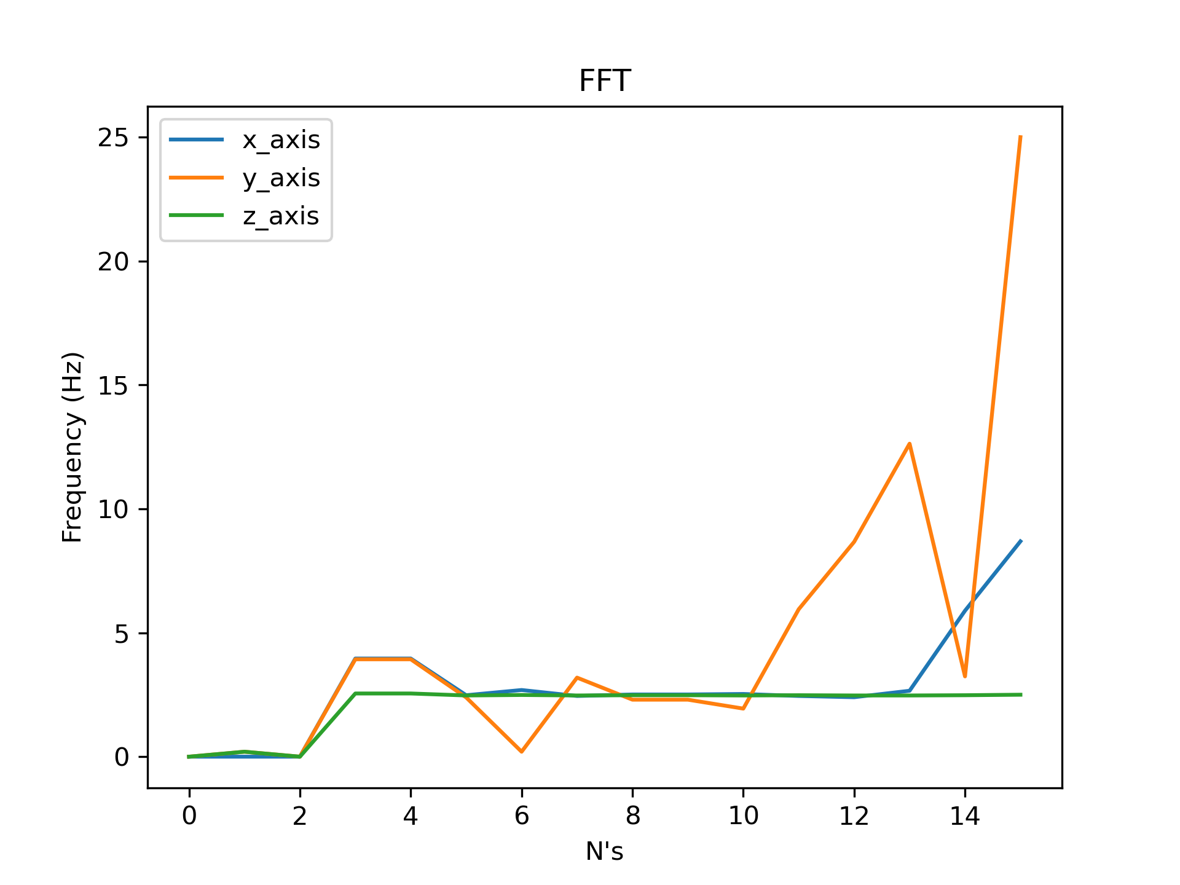
Code/serialPlot/Tests/Test4/plots/rFBTest11FFT.png
