JessyBarber/Jessy-Thesis/Code/serialPlot/Tests/Test4/plots/rFBTest11MA.png

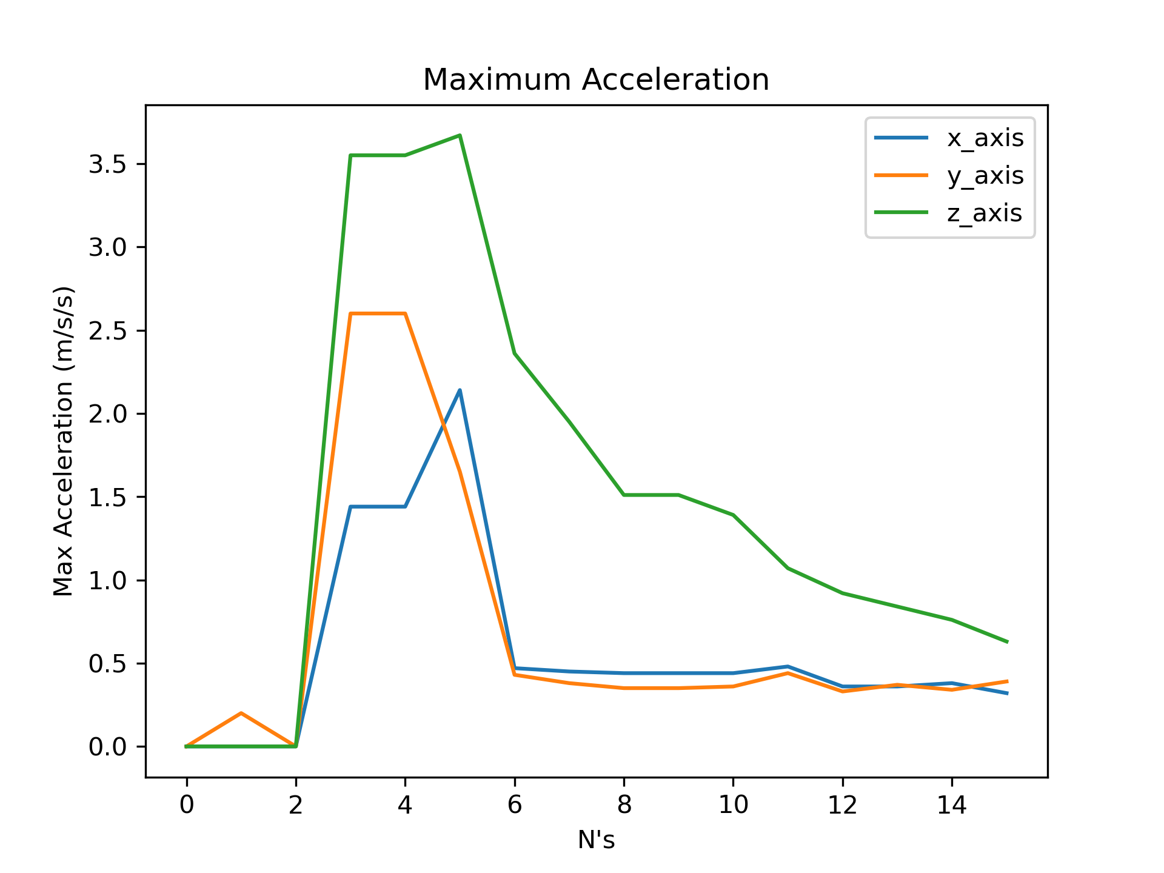
Code/serialPlot/Tests/Test4/plots/rFBTest11MA.png
