JessyBarber/Jessy-Thesis/Code/serialPlot/Tests/Test4/plots/rFBTestMA.png

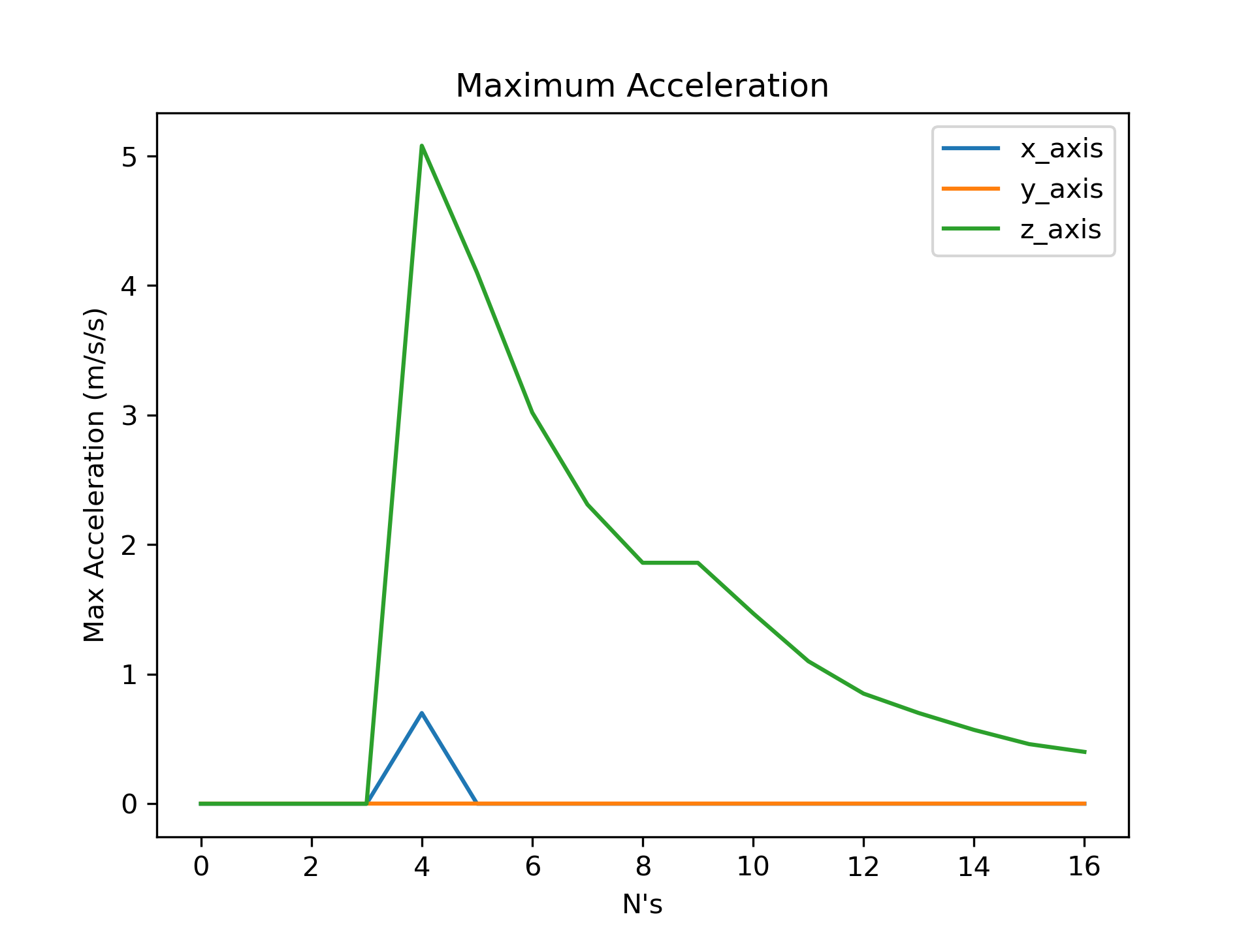
Code/serialPlot/Tests/Test4/plots/rFBTestMA.png
