JessyBarber/Jessy-Thesis/Code/serialPlot/Tests/Test4/plots/rFTest1FFT.png

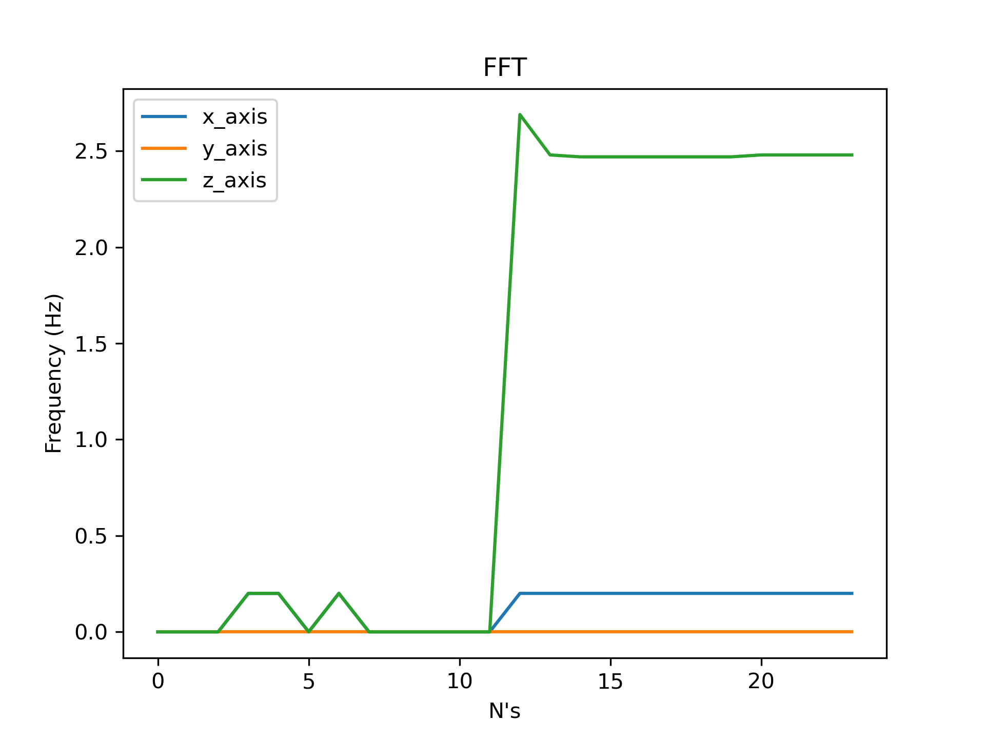
Code/serialPlot/Tests/Test4/plots/rFTest1FFT.png
