JessyBarber/Jessy-Thesis/Code/serialPlot/Tests/Test4/plots/rFTest1MA.png

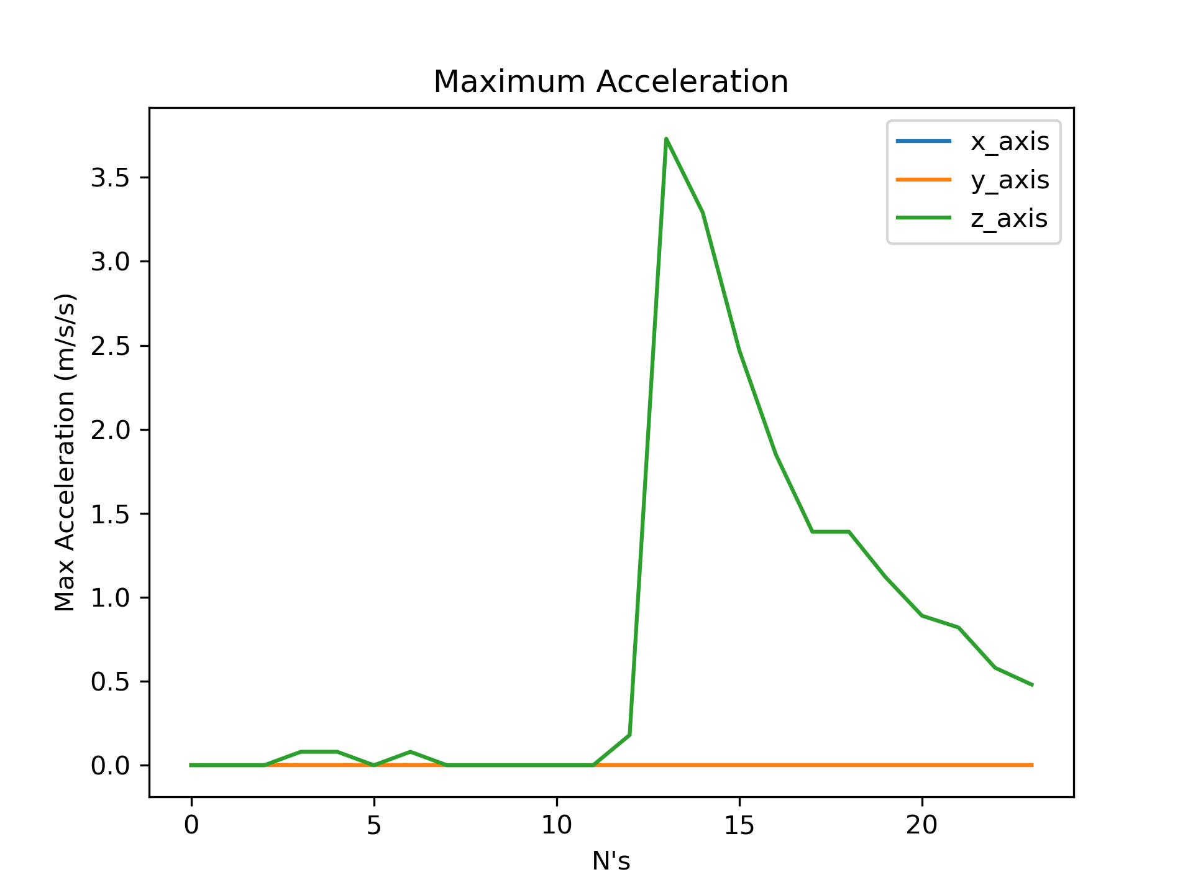
Code/serialPlot/Tests/Test4/plots/rFTest1MA.png
