JessyBarber/Jessy-Thesis/Code/serialPlot/Tests/Test4/plots/sF1.png

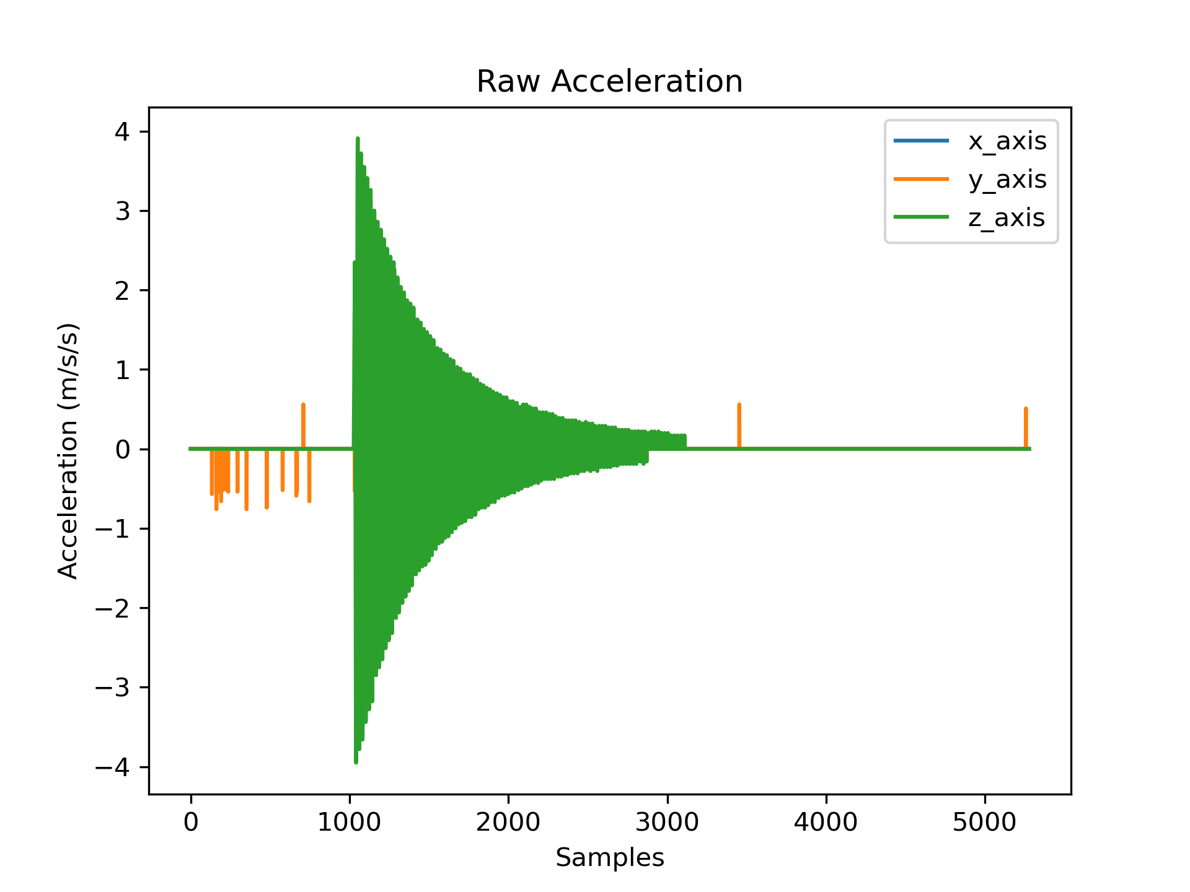
Code/serialPlot/Tests/Test4/plots/sF1.png
