JessyBarber/Jessy-Thesis/Code/serialPlot/Tests/Test4/plots/sF2.png

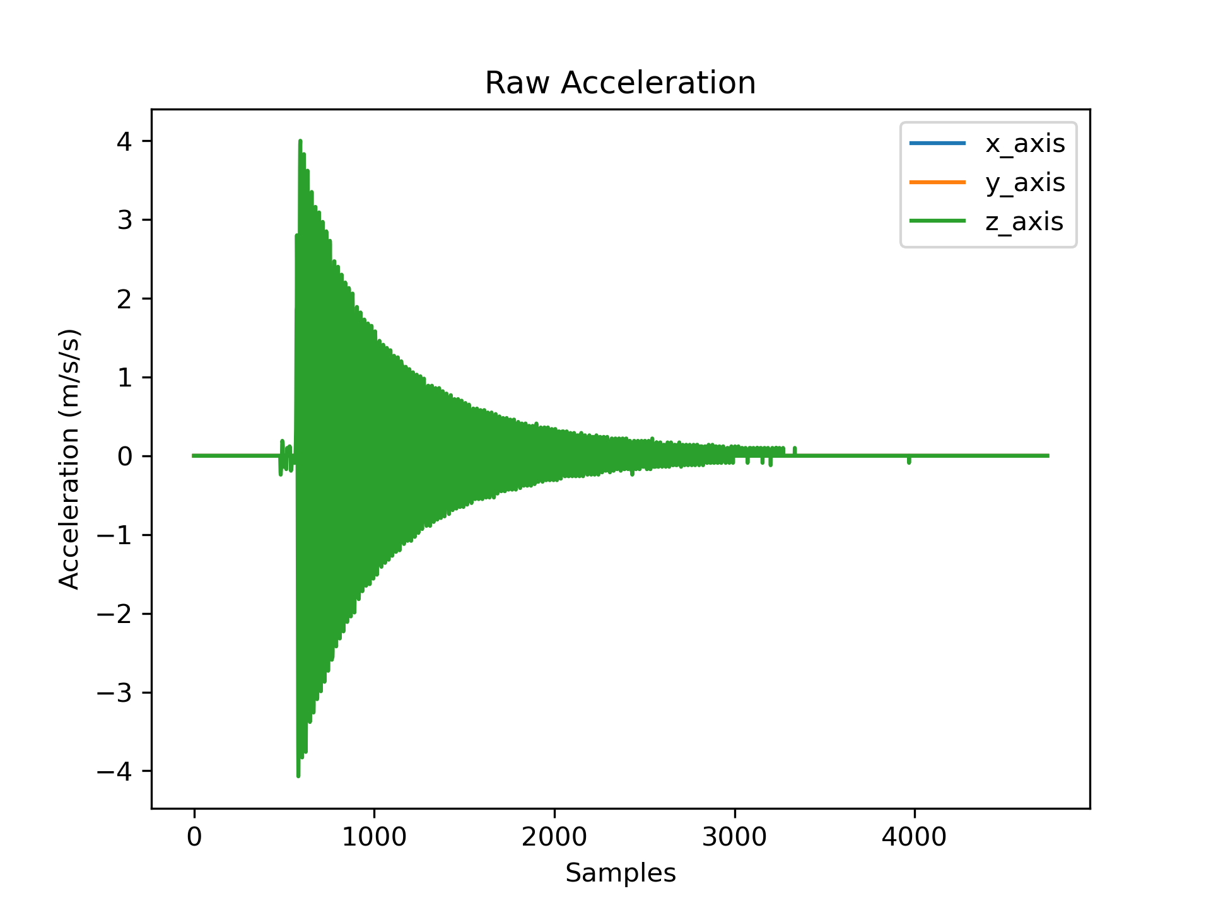
Code/serialPlot/Tests/Test4/plots/sF2.png
