JessyBarber/Jessy-Thesis/Code/serialPlot/Tests/Test4/plots/sF3.png

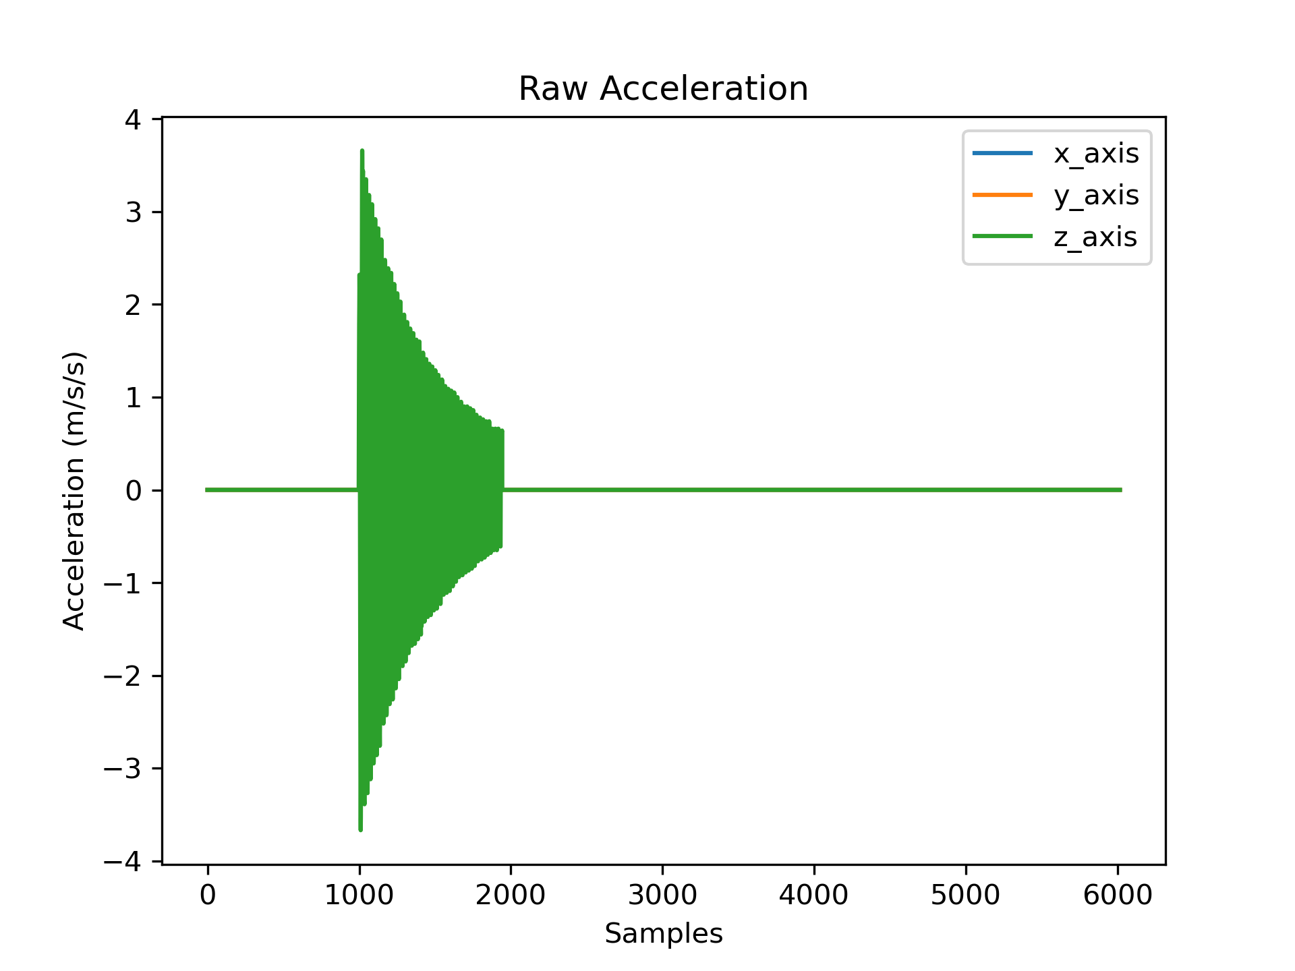
Code/serialPlot/Tests/Test4/plots/sF3.png
