JessyBarber/Jessy-Thesis/Code/serialPlot/Tests/Test4/plots/sF4.png

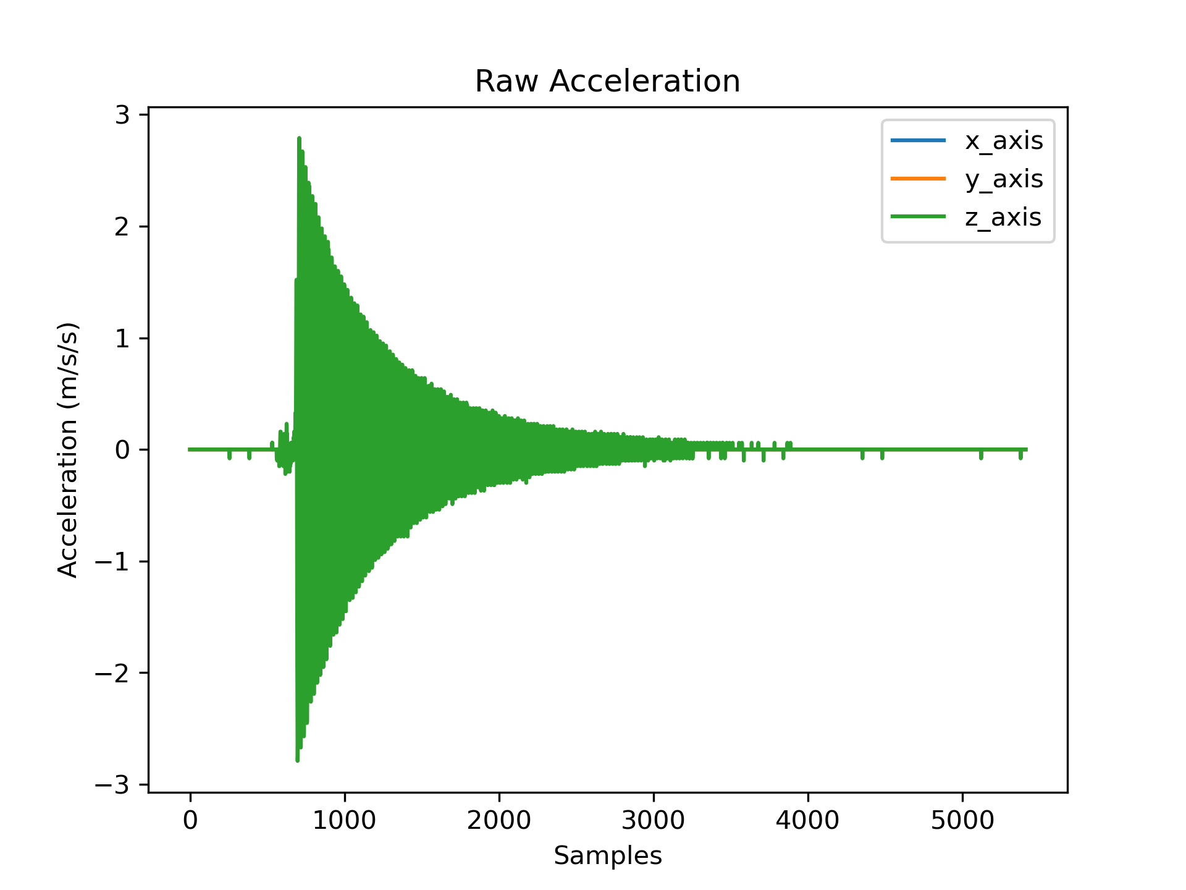
Code/serialPlot/Tests/Test4/plots/sF4.png
