JessyBarber/Jessy-Thesis/Code/serialPlot/Tests/Test4/plots/sF5.png

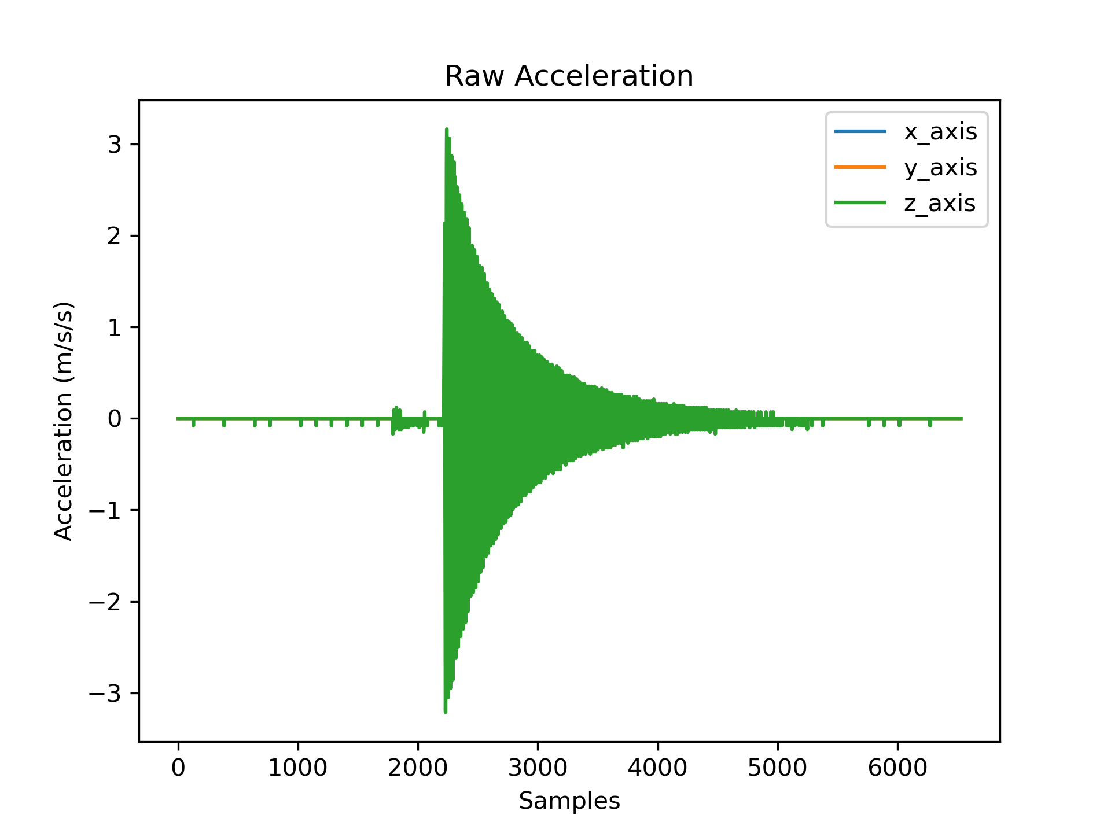
Code/serialPlot/Tests/Test4/plots/sF5.png
