JessyBarber/Jessy-Thesis/Code/serialPlot/Tests/Test4/plots/sFBTest1.png

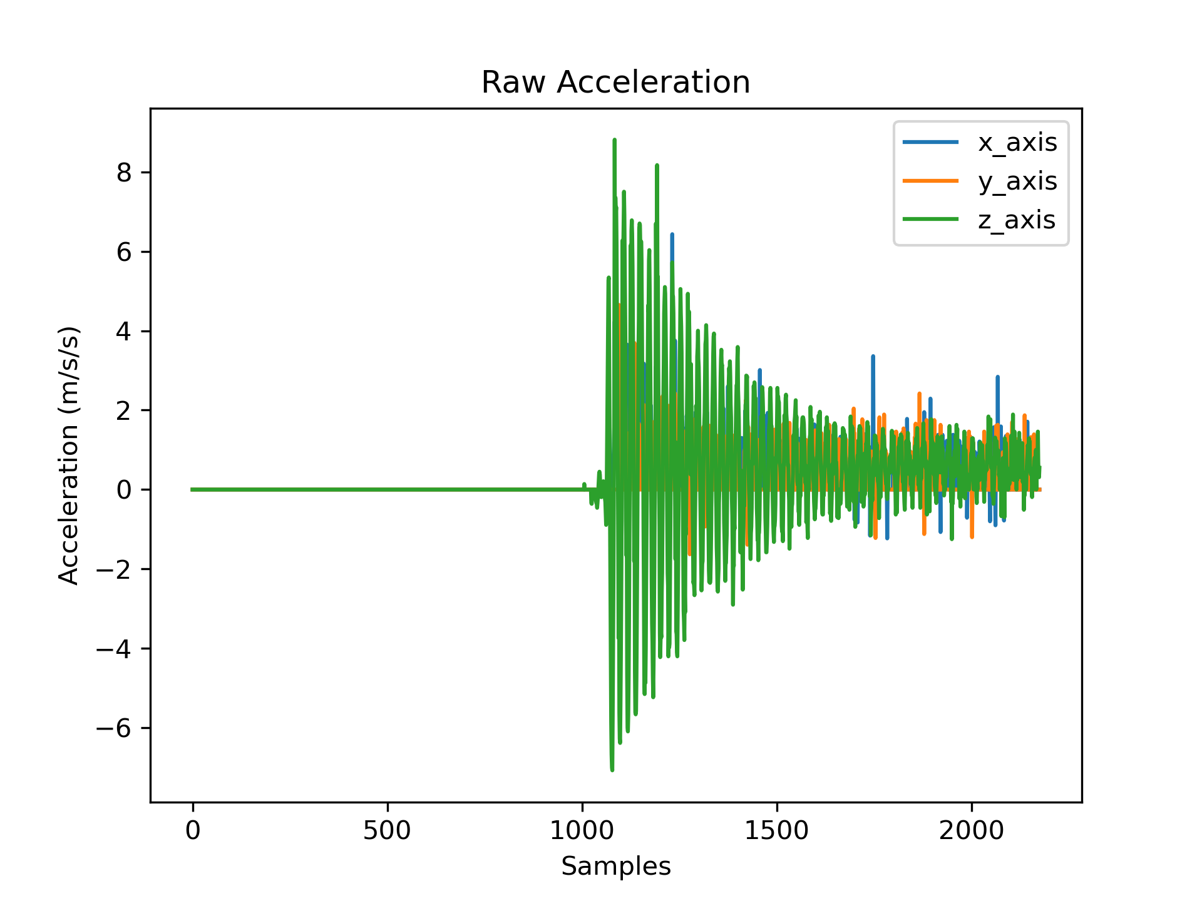
Code/serialPlot/Tests/Test4/plots/sFBTest1.png
