JessyBarber/Jessy-Thesis/Code/serialPlot/Tests/Test4/plots/sFTest1.png

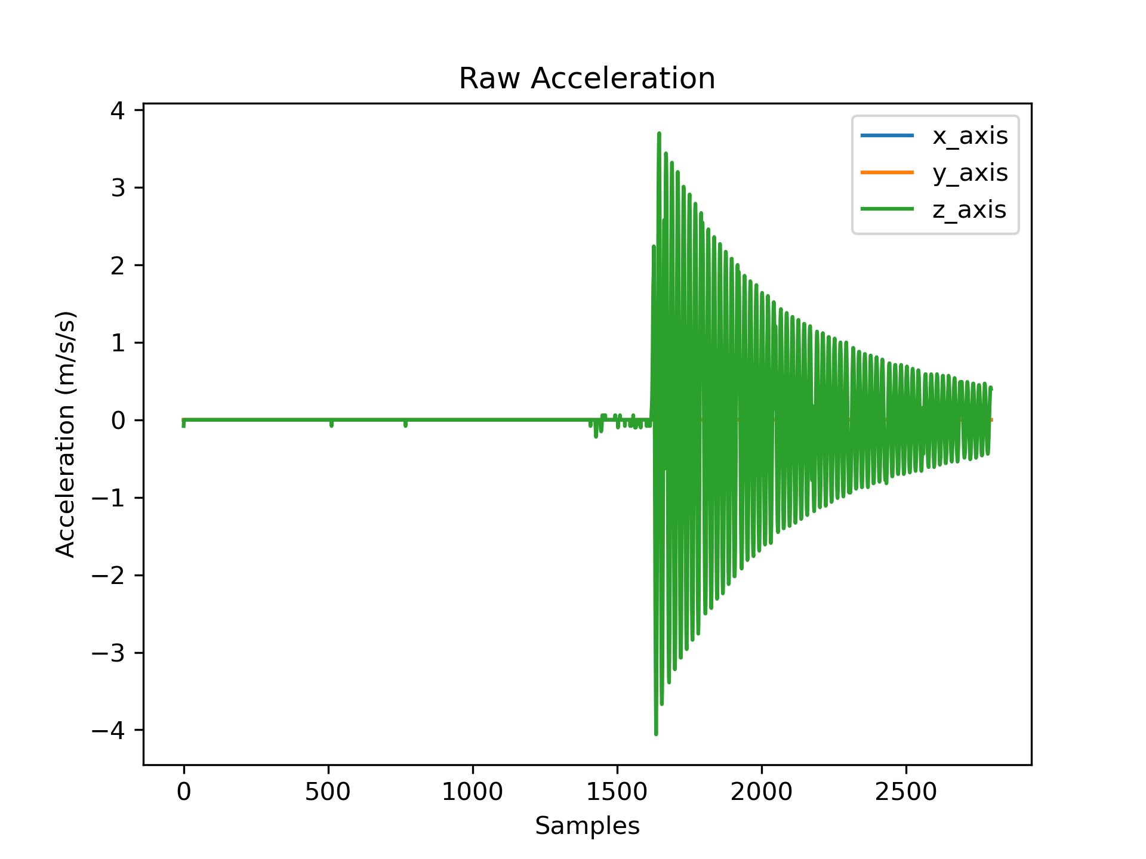
Code/serialPlot/Tests/Test4/plots/sFTest1.png
