JessyBarber/Jessy-Thesis/Code/serialPlot/Tests/Test4/plots/sFTest2.png

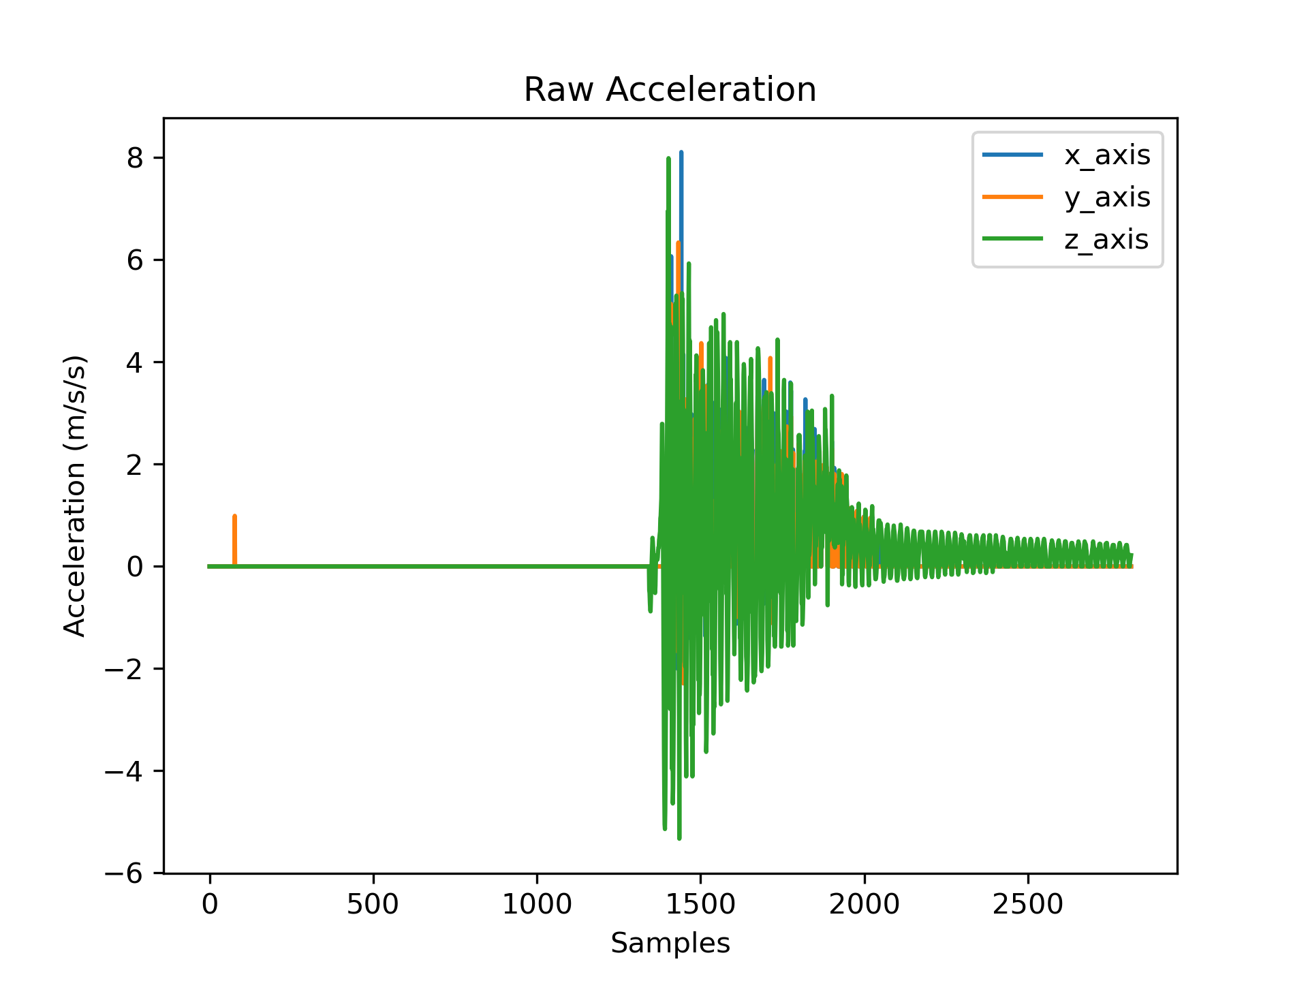
Code/serialPlot/Tests/Test4/plots/sFTest2.png
