JessyBarber/Jessy-Thesis/Code/serialPlot/Tests/Test5(home)/plots/rt1fft.png

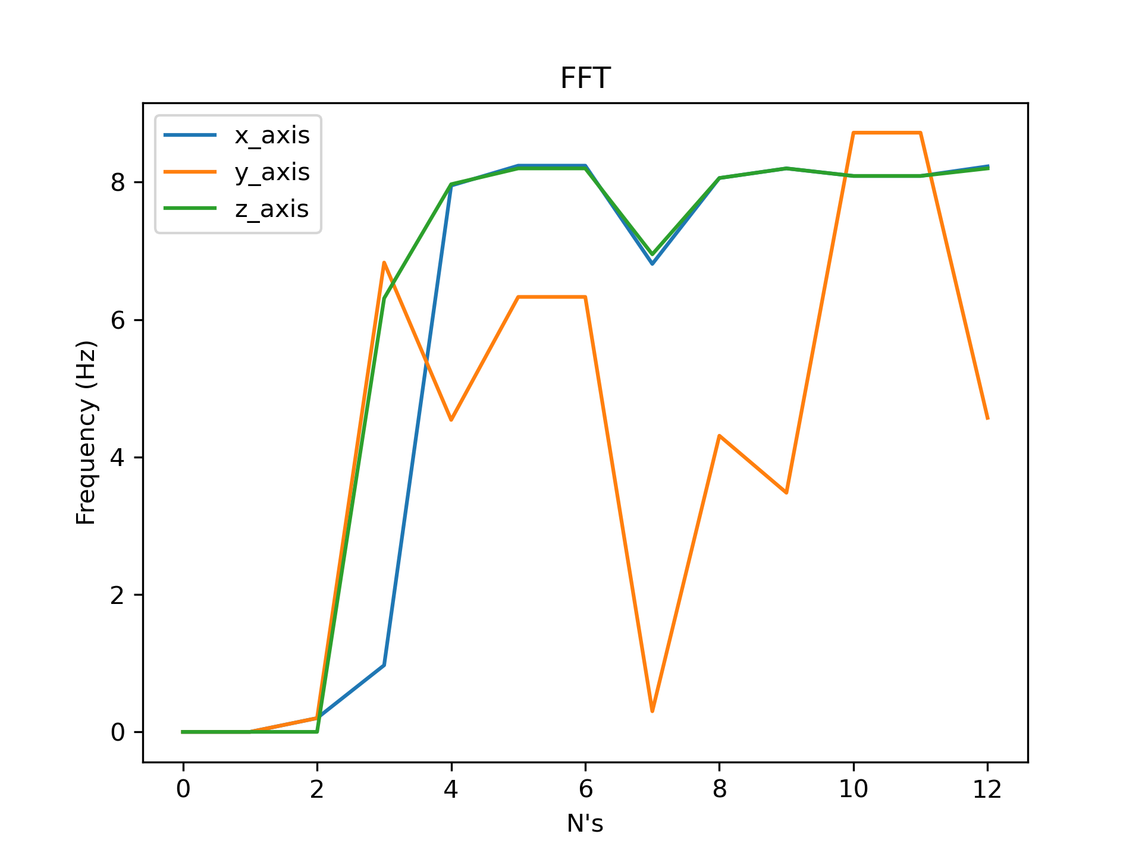
Code/serialPlot/Tests/Test5(home)/plots/rt1fft.png
