JessyBarber/Jessy-Thesis/Code/serialPlot/Tests/Test5(home)/plots/rt1ma.png

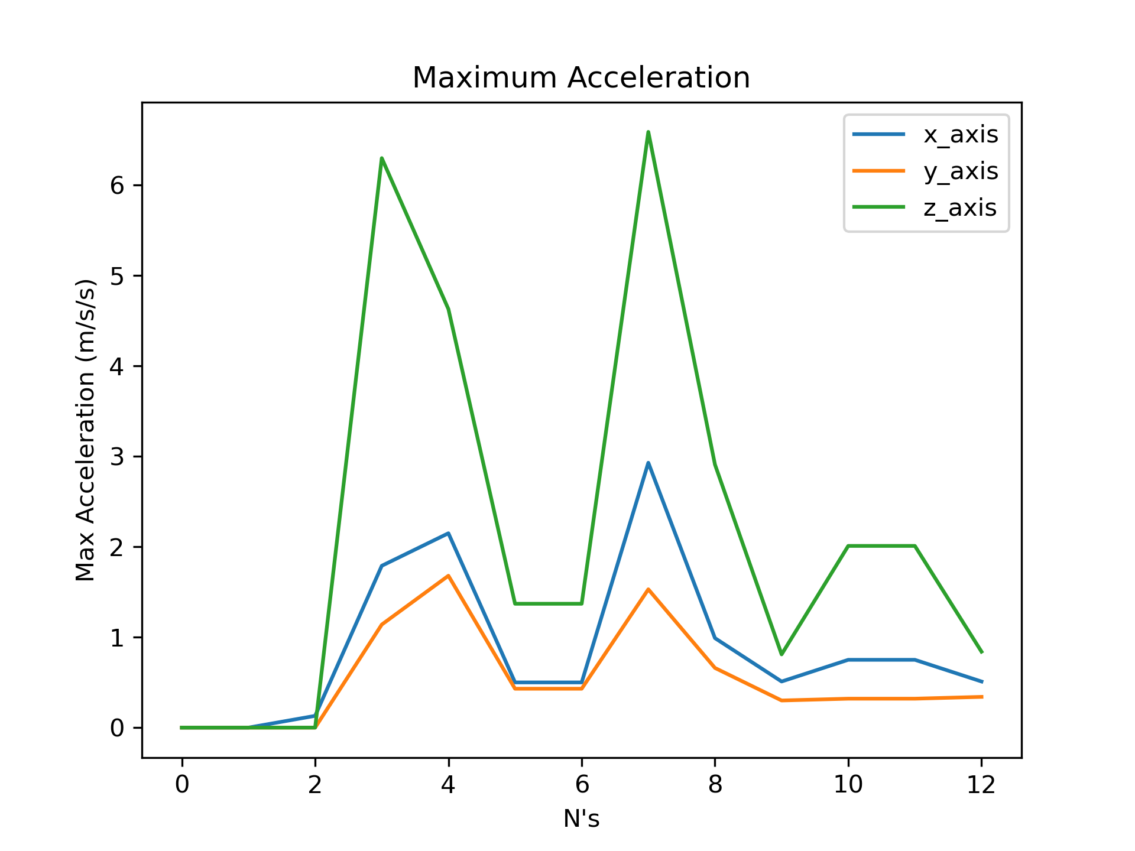
Code/serialPlot/Tests/Test5(home)/plots/rt1ma.png
