JessyBarber/Jessy-Thesis/Code/serialPlot/Tests/Test5(home)/plots/rt2fft.png

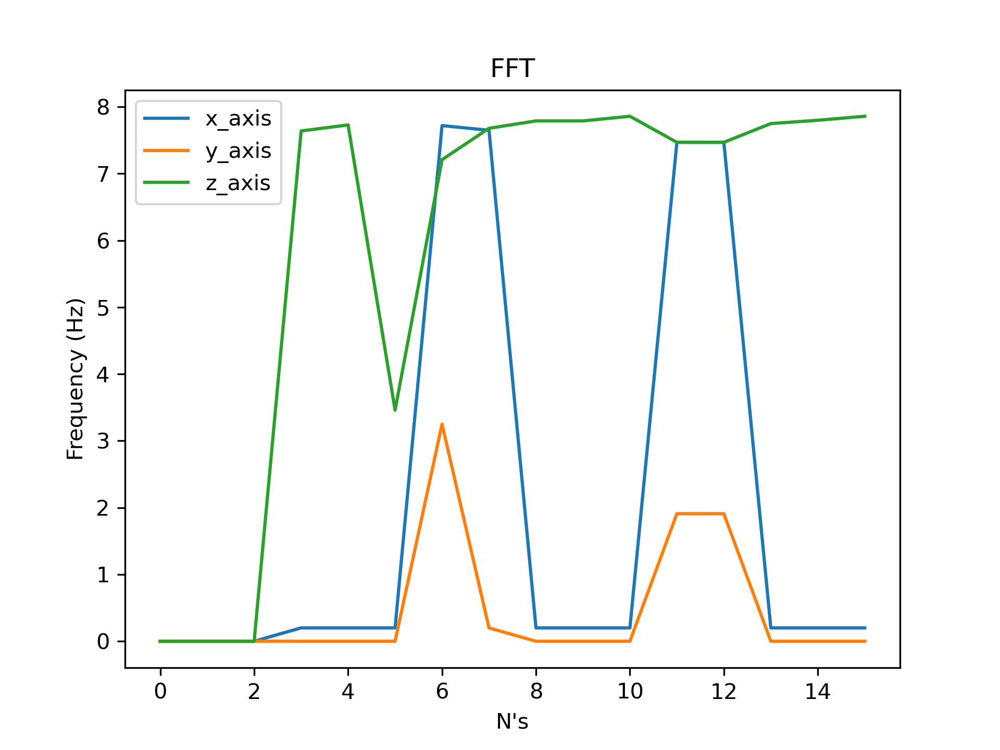
Code/serialPlot/Tests/Test5(home)/plots/rt2fft.png
