JessyBarber/Jessy-Thesis/Code/serialPlot/Tests/Test5(home)/plots/rt2ma.png

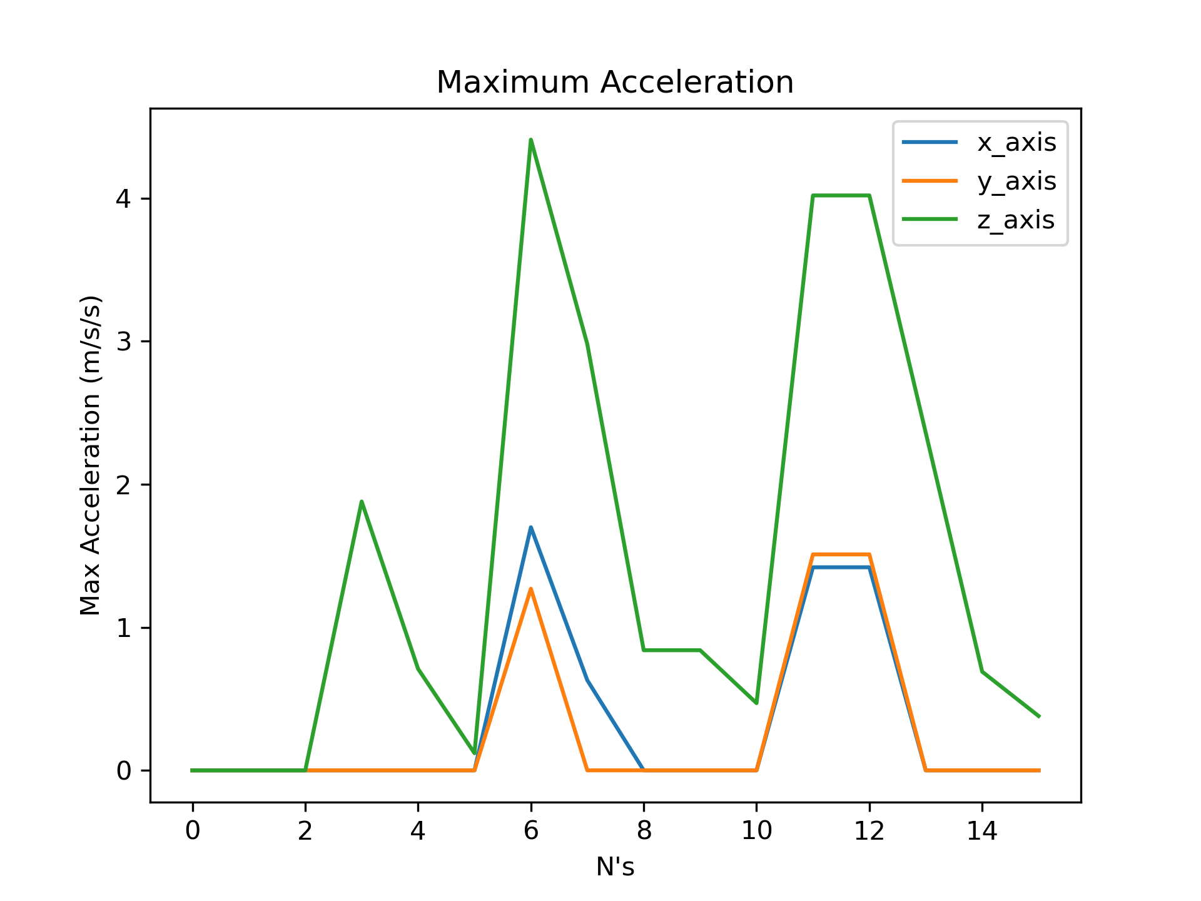
Code/serialPlot/Tests/Test5(home)/plots/rt2ma.png
