JessyBarber/Jessy-Thesis/Code/serialPlot/Tests/Test5(home)/plots/rt3fft.png

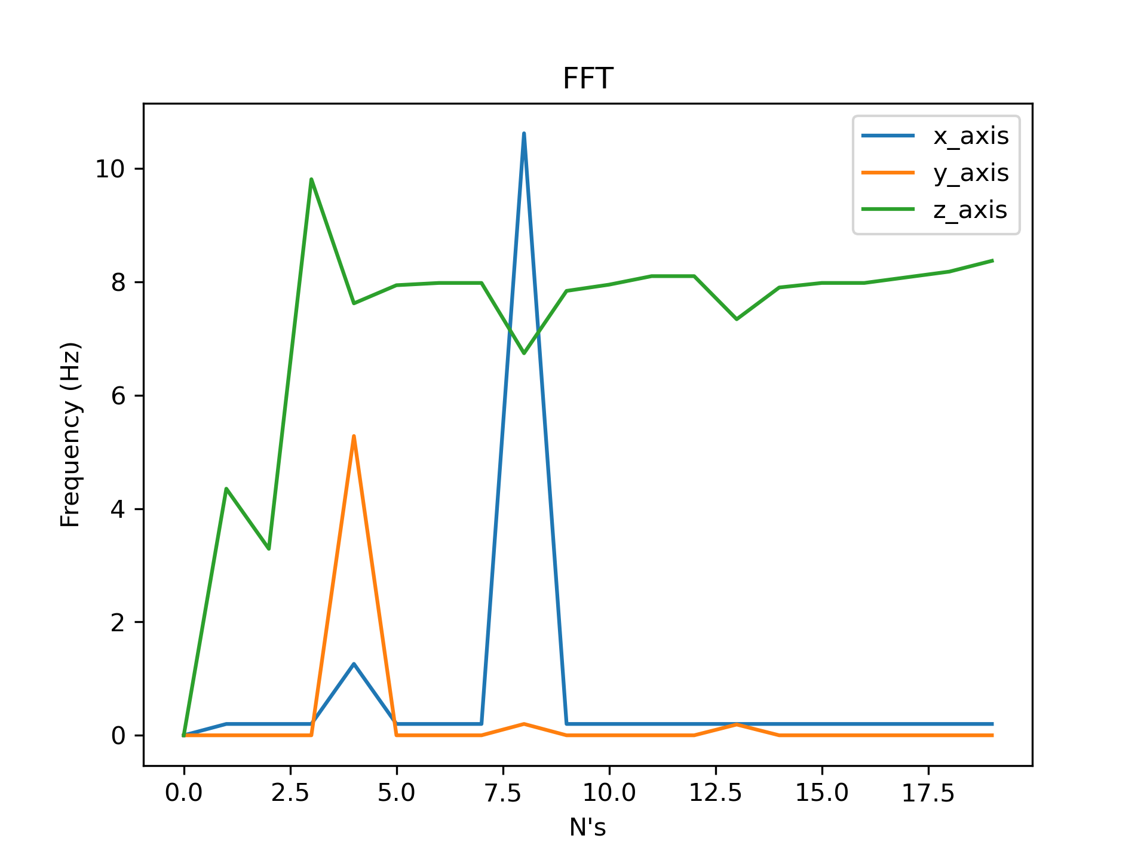
Code/serialPlot/Tests/Test5(home)/plots/rt3fft.png
