JessyBarber/Jessy-Thesis/Code/serialPlot/Tests/Test5(home)/plots/rt3ma.png

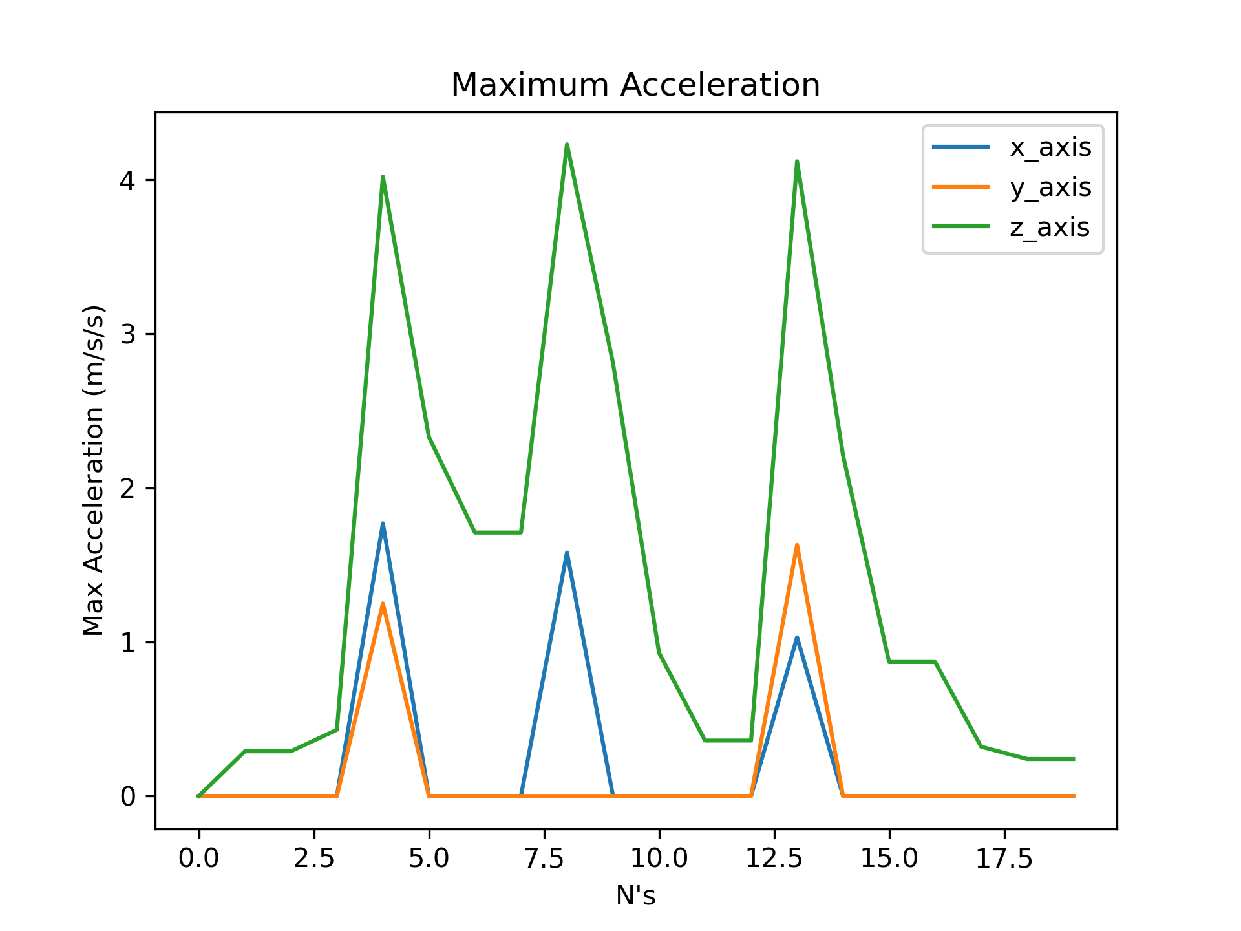
Code/serialPlot/Tests/Test5(home)/plots/rt3ma.png
