JessyBarber/Jessy-Thesis/Code/serialPlot/Tests/Test5(home)/plots/rt4fft.png

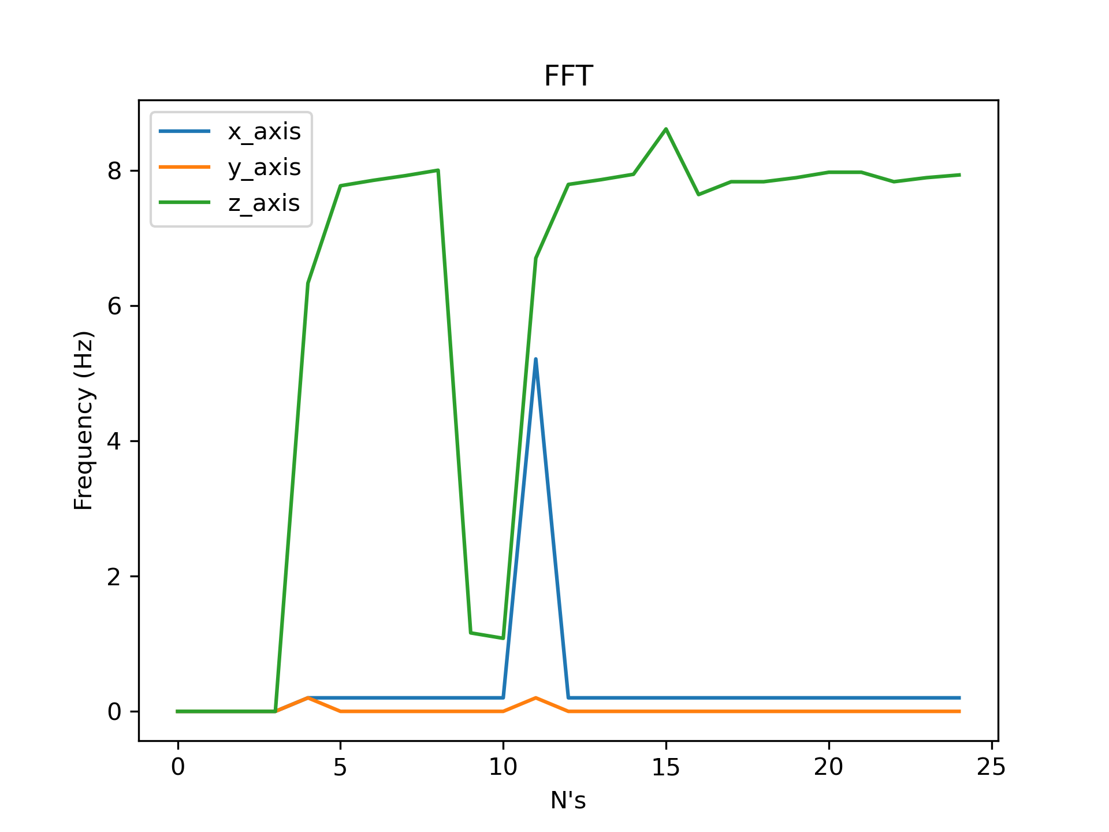
Code/serialPlot/Tests/Test5(home)/plots/rt4fft.png
