JessyBarber/Jessy-Thesis/Code/serialPlot/Tests/Test5(home)/plots/rt4ma.png

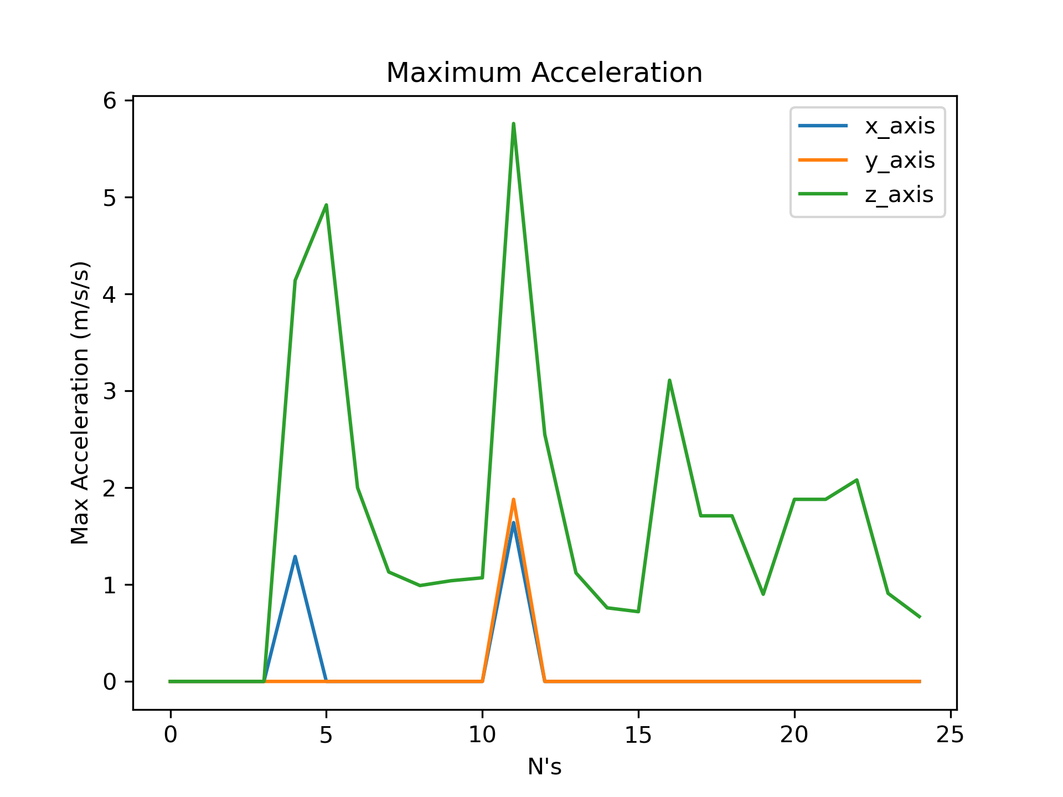
Code/serialPlot/Tests/Test5(home)/plots/rt4ma.png
