JessyBarber/Jessy-Thesis/Code/serialPlot/Tests/Test5(home)/plots/rt5fft.png

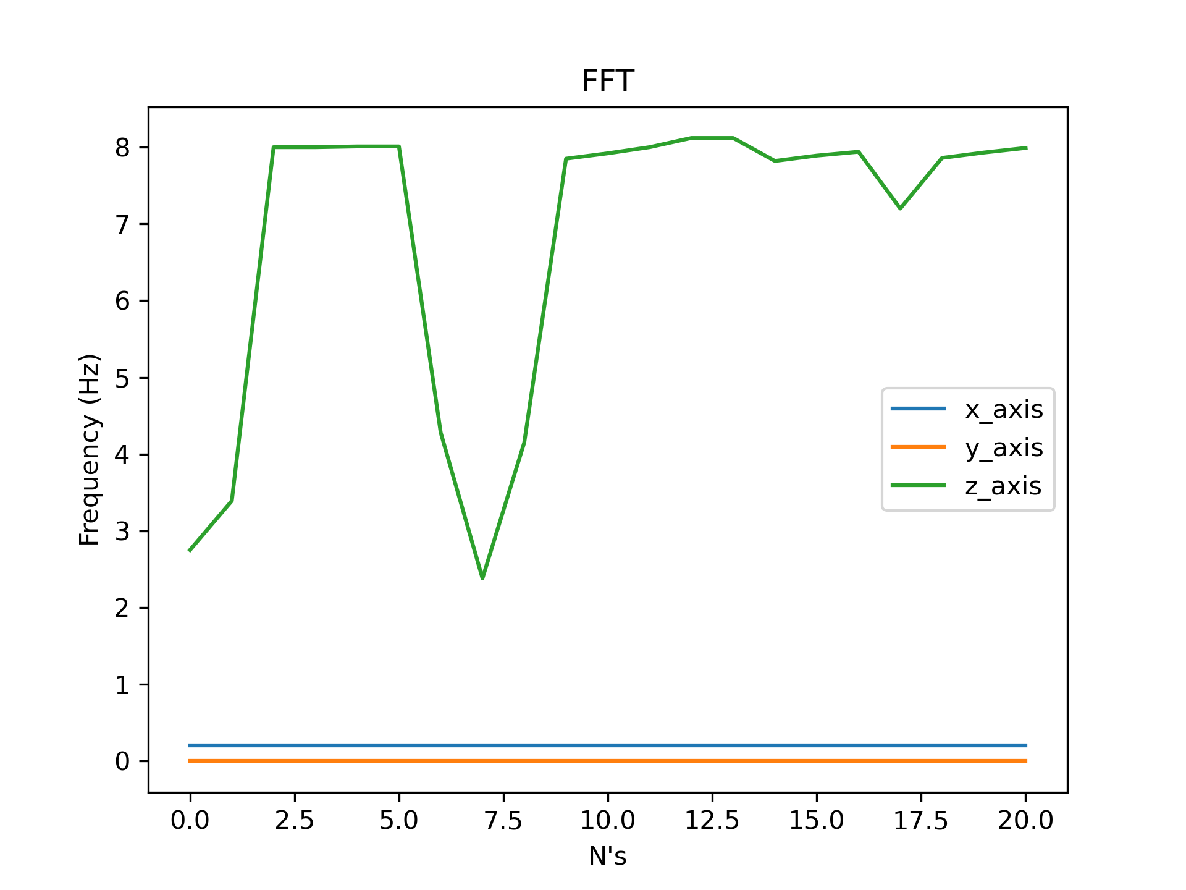
Code/serialPlot/Tests/Test5(home)/plots/rt5fft.png
