JessyBarber/Jessy-Thesis/Code/serialPlot/Tests/Test5(home)/plots/st1.png

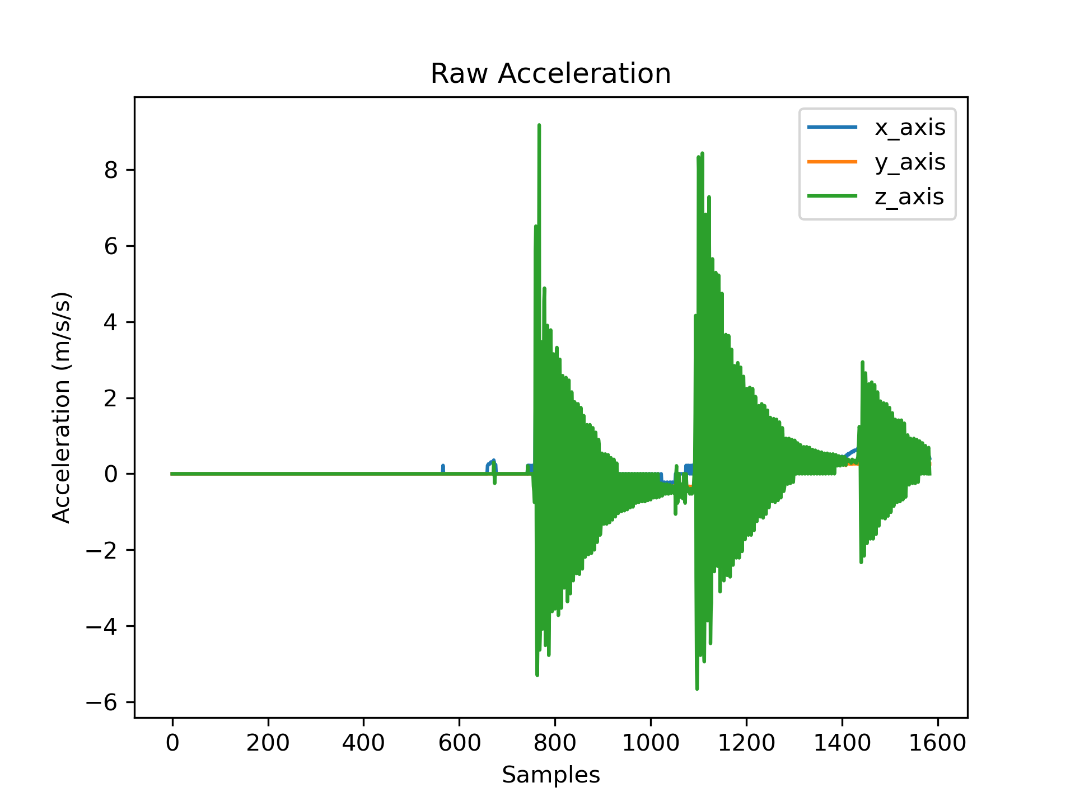
Code/serialPlot/Tests/Test5(home)/plots/st1.png
