JessyBarber/Jessy-Thesis/Code/serialPlot/Tests/Test5(home)/plots/st2.png

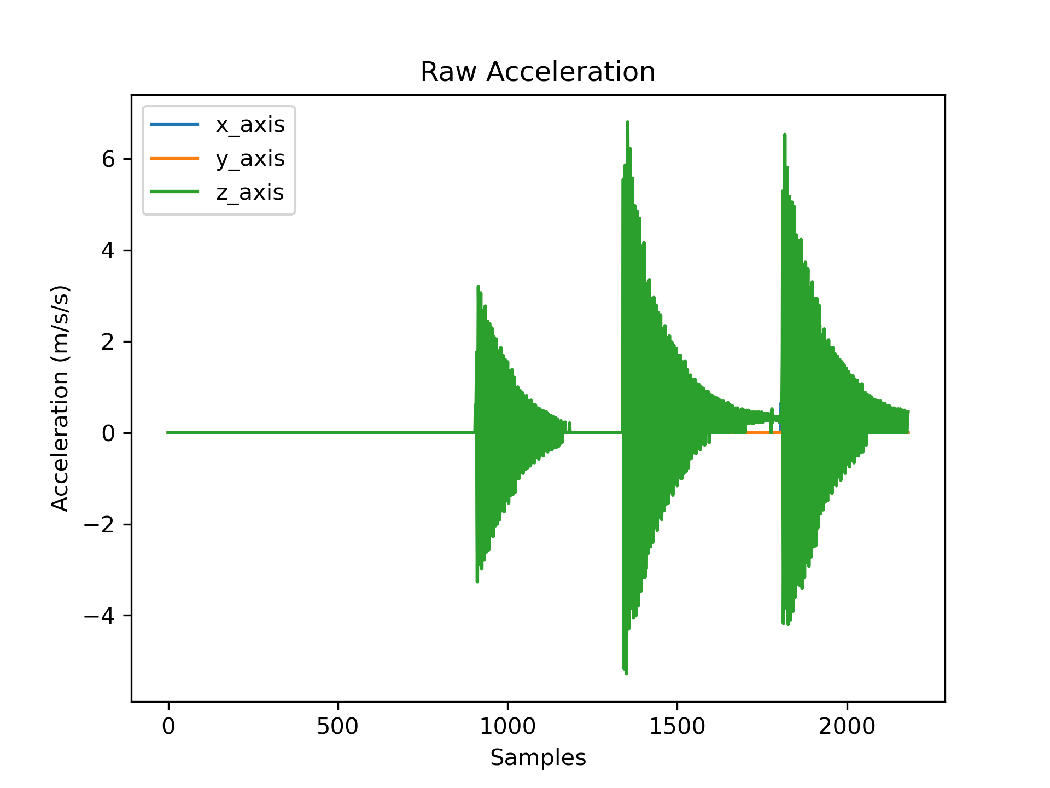
Code/serialPlot/Tests/Test5(home)/plots/st2.png
