JessyBarber/Jessy-Thesis/Code/serialPlot/Tests/Test5(home)/plots/st3.png

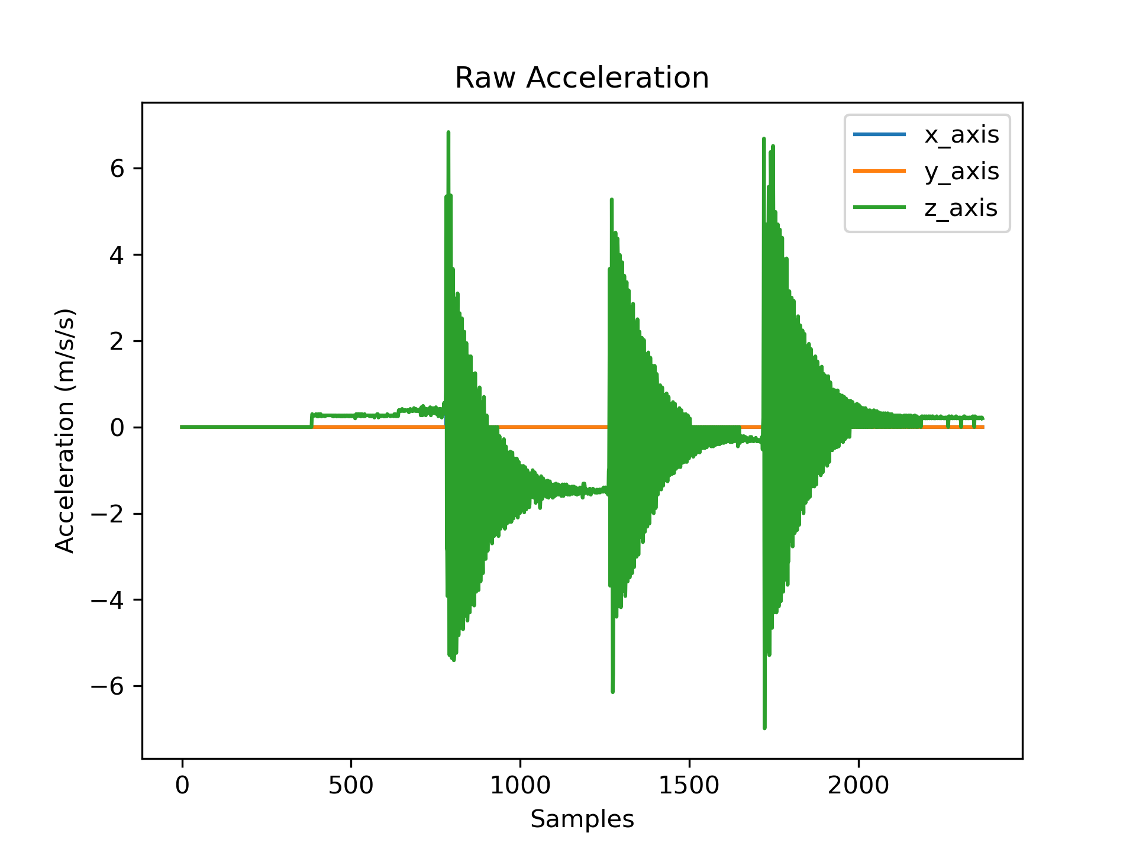
Code/serialPlot/Tests/Test5(home)/plots/st3.png
