JessyBarber/Jessy-Thesis/Code/serialPlot/Tests/Test5(home)/plots/st4.png

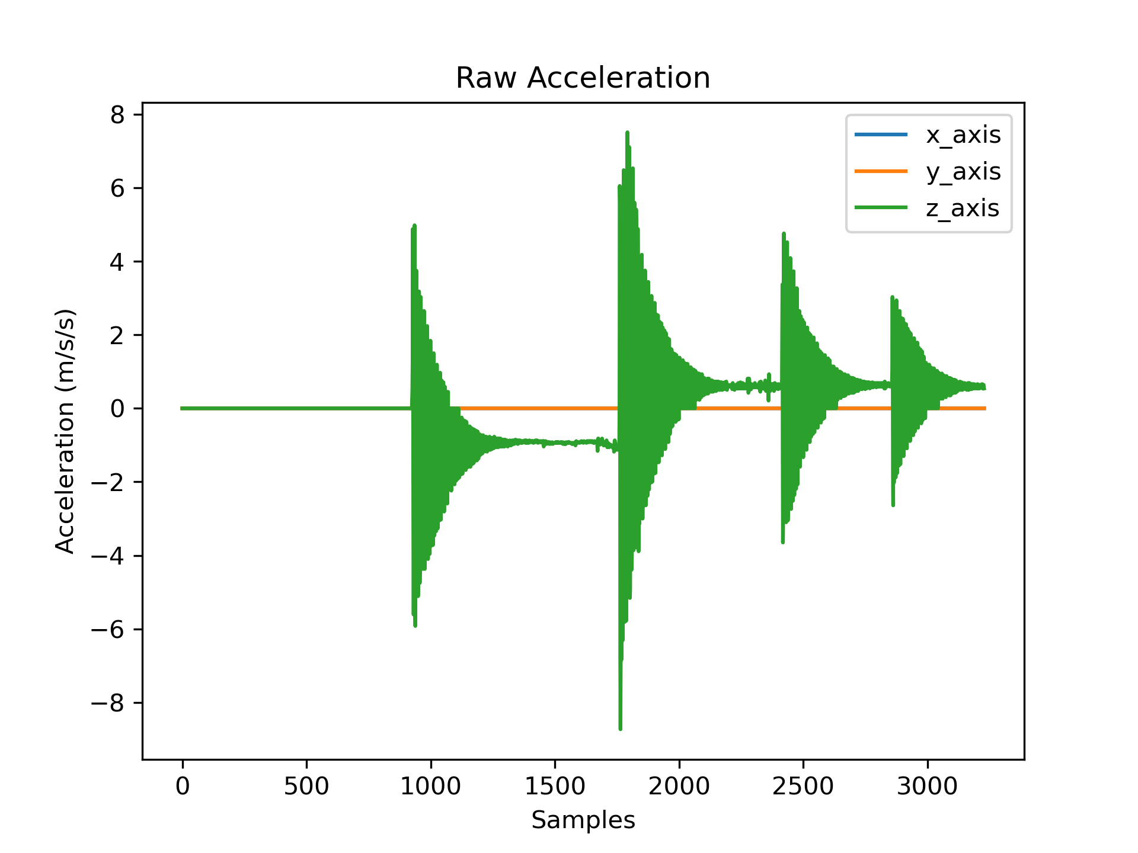
Code/serialPlot/Tests/Test5(home)/plots/st4.png
