JessyBarber/Jessy-Thesis/Code/serialPlot/Tests/Test5(home)/plots/st5.png

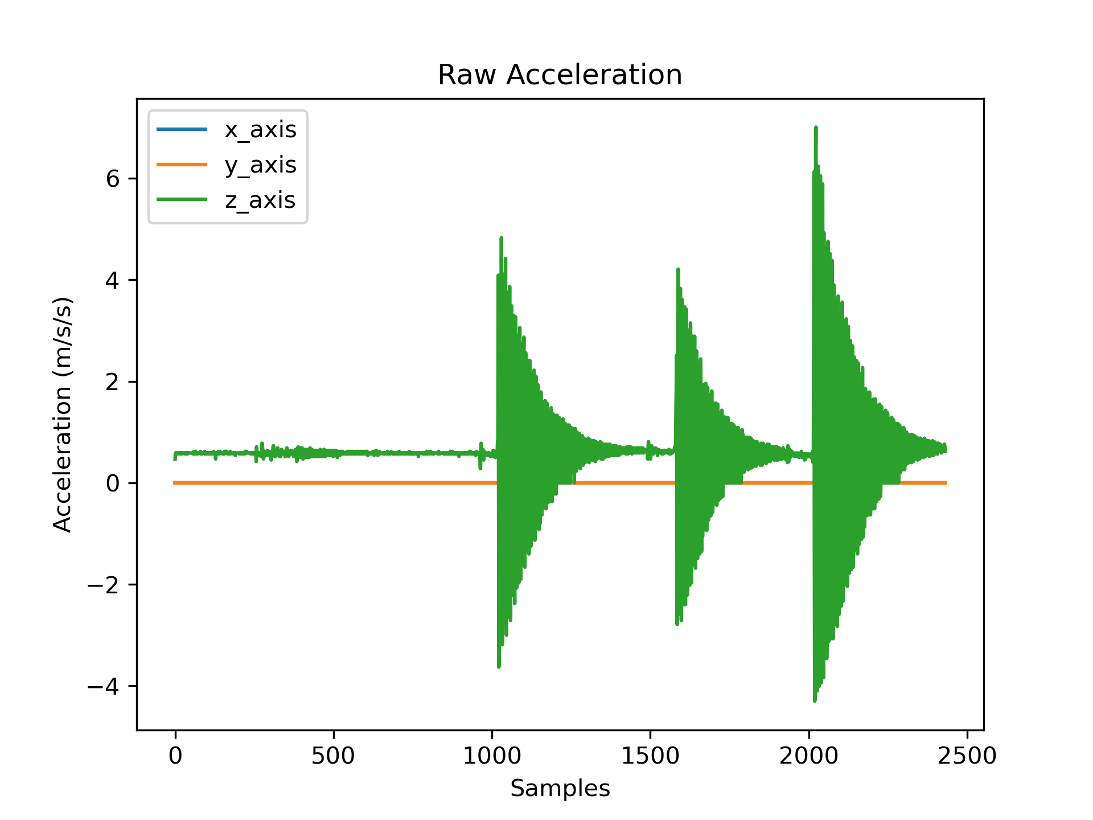
Code/serialPlot/Tests/Test5(home)/plots/st5.png
