JessyBarber/Jessy-Thesis/Final Report/Final Report/Sections/Design-Process/proto1-soft-diagram-receiver-test.png

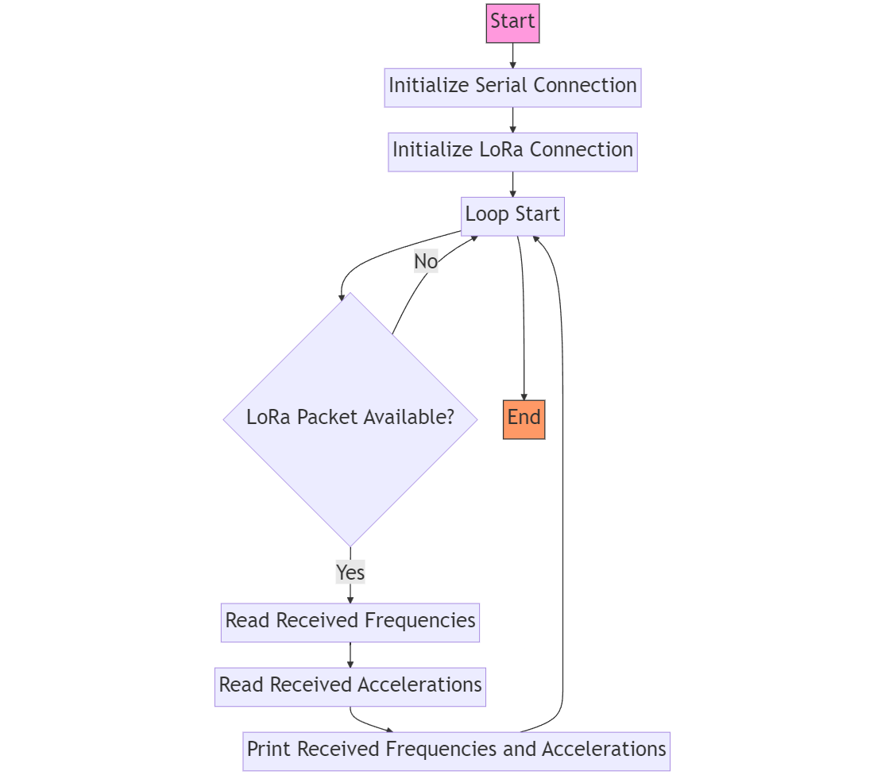
Final Report/Final Report/Sections/Design-Process/proto1-soft-diagram-receiver-test.png
