JessyBarber/Jessy-Thesis/Project Planning Report/Images/RiskOnAPage-2.pdf

powered by riskware.com.au | commercial in confidence

Conducting a
vibrating beam
experiment to test
sensor nodes in a
mechanical
engineering lab.
securely fastened. | footwear. | that distance is kept whilst the experiment is running.
