JessyBarber/Jessy-Thesis/Poster/Barber_Jessy_EEE_Poster.pdf

## Introduction Enclosure Design

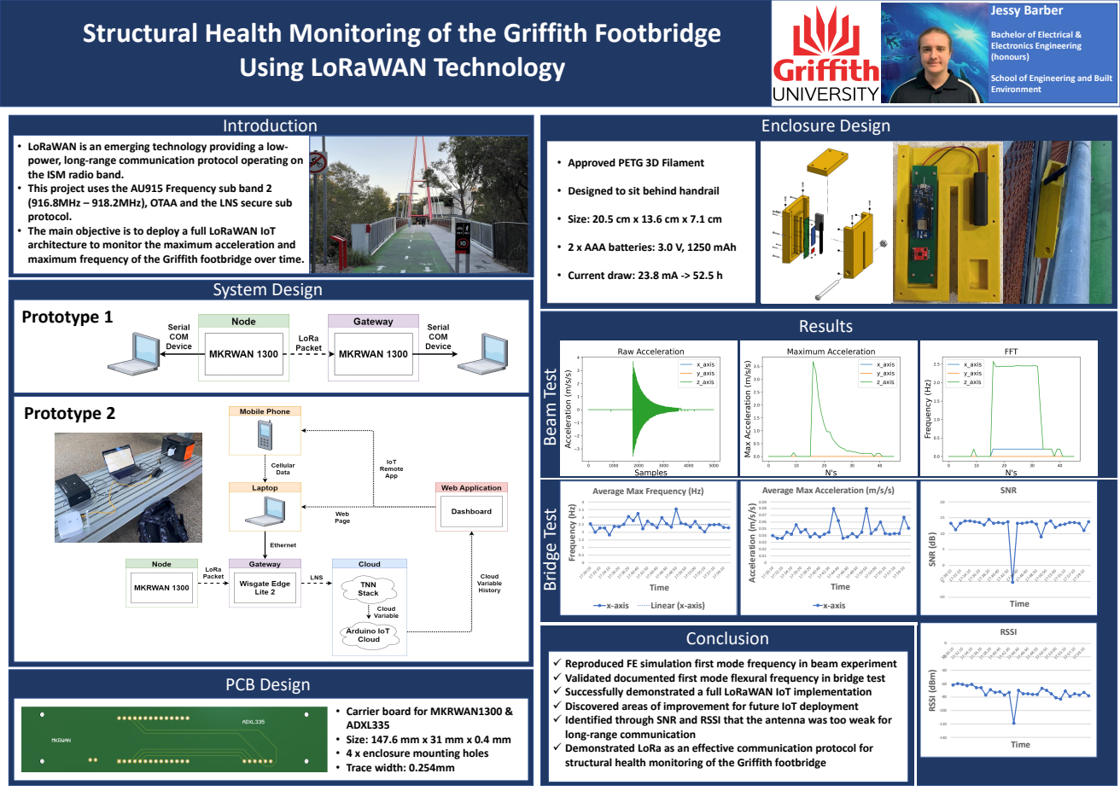
[picture p271: page 1]
Jessy Barber; System Design; PCB Design; Prototype 1; Prototype 2; Results; SNR (dB); Time; SNR; Frequency (Hz); x-axis; Linear (x-axis); Acceleration (m/s/s); RSSI (dBm); RSSI; Conclusion

Structural Health Monitoring of the Griffith Footbridge

Bachelor of Electrical &
Electronics Engineering
(honours)

Using LoRaWAN Technology

School of Engineering and Built
Environment

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

• Approved PETG 3D Filament

• Designed to sit behind handrail

• Size: 20.5 cm x 13.6 cm x 7.1 cm

• 2 x AAA batteries: 3.0 V, 1250 mAh

• Current draw: 23.8 mA -> 52.5 h

Beam Test Bridge Test

Average Max Frequency (Hz)

Average Max Acceleration (m/s/s)

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
