JessyBarber/Jessy-Thesis/Project Planning Report/Images/Timeline.pdf

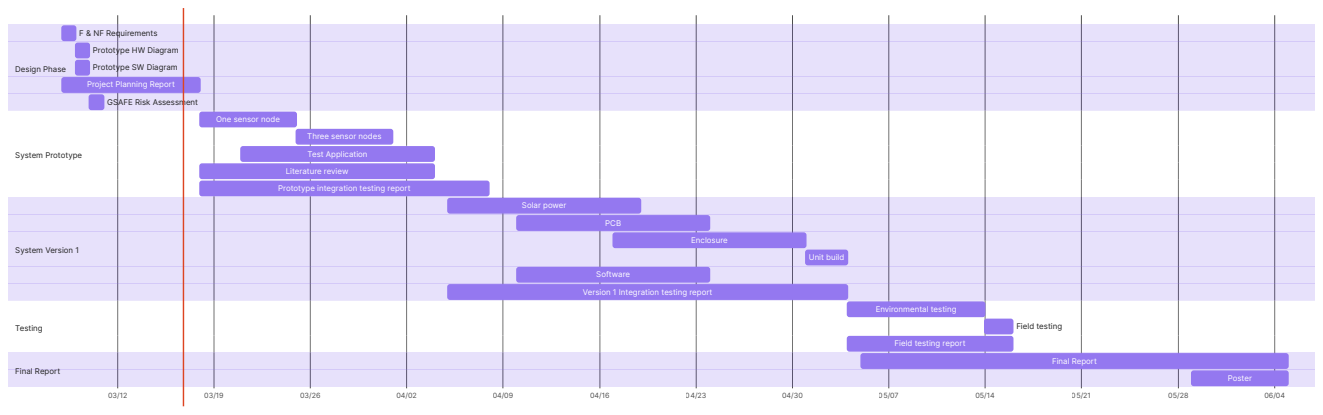
[picture p272: page 1]

F & NF Requirements
Prototype HW Diagram

Design Phase Prototype SW Diagram

Project Planning Report
GSAFE Risk Assessment

One sensor node

Three sensor nodes

System Prototype | | Test Application

Literature review
Prototype integration testing report

Solar power

System Version 1 | | | | Enclosure

PCB

Unit build

Software
Version 1 Integration testing report

Environmental testing

Testing | | | | | | | Field testing

Final Report | | | | | | | Final Report

Field testing report

Poster
