JessyBarber/Jessy-Thesis/Final Report/Final Report/Sections/Introduction/Prototype-2-High-Level.drawio.pdf

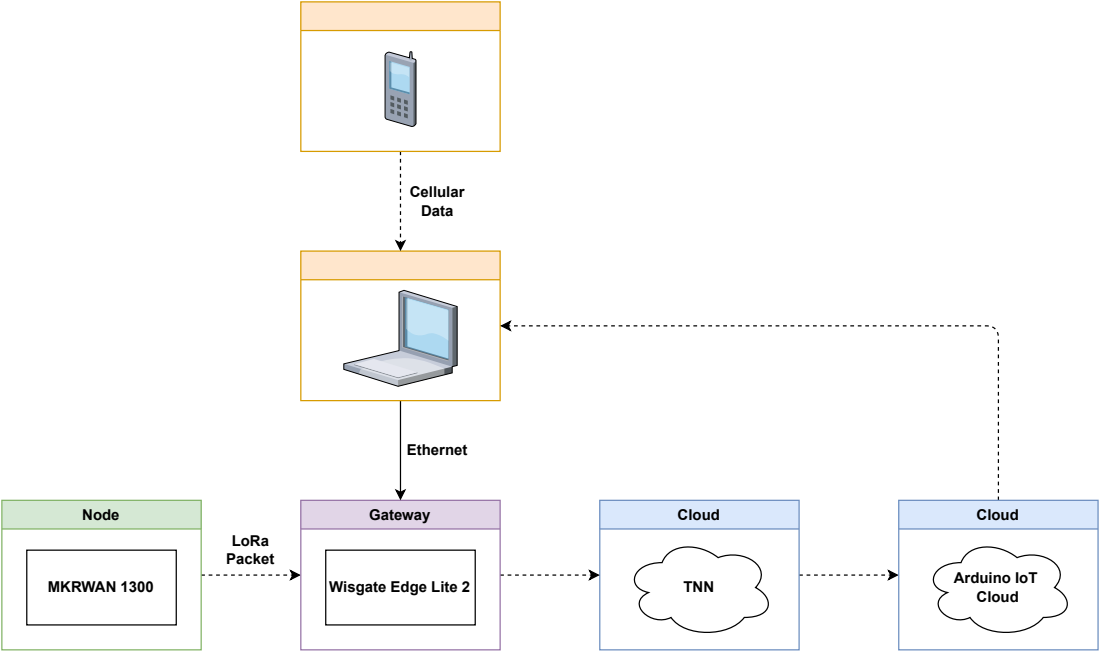
[picture p273: page 1]
Cloud; TNN; Node; MKRWAN 1300; Gateway; LoRa Packet; Cellular Data; Ethernet; Arduino IoT Cloud

Wisgate Edge Lite 2
