JessyBarber/Jessy-Thesis/(list of files, drawings)

Other design files:
PCB/lora-carrier-board/lora-carrier-board.PrjPcb
PCB/lora-carrier-board/PCB1.PcbDoc
PCB/lora-carrier-board/PcbLib1.PcbLib
PCB/lora-carrier-board/Schlib1.SchLib
PCB/lora-carrier-board/sheet1.SchDoc
PCB/MKRWAN1300/e.PrjPcb
PCB/MKRWAN1300/MKRWANV1.0_0.SchDoc
PCB/MKRWAN1300/MKRWANV1.0_1.SchDoc
