JessyBarber/Jessy-Thesis/(commit log)

2023-03-23 3rd week and added code to resources
    [Backup_Dump.txt]
2023-04-05 FFT on x-axis for sending and receiving
2023-04-11 Added changes to sender header file in regards to sample time and freq for better understanding of the values
2023-04-12 Fixed delay bug in sender file. Notes from Wednesday meeting. Added Python serial plot code
    [Sender.h, Sender.ino, acceleration_plot.py]
2023-04-20 Added new sender file that is more object orietated based. Added skeleton for finding displacement but ran into major memory problems. Added a new harry plotter python file that will plot accel and f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
    [FFT.cpp, Receiver.ino, Sender.h, Sender.ino, Sender_new.ino, harryPlotter.py]
2023-04-21 Friday experiment. Made a harryPlotter 2 so can plot from 2 serial devices. Graphs from experiment are in Log/plots.
2023-05-02 Added new logger and plotter functions. Added self-calibration and new calibration functions. Cleaned up code majorly. Changed FFT code to better convert values and use calibration values
2023-05-03 Fixed up acceleration and FFT functions. Implemented displacement functions. Added print option for displacement in receiver plotter program
    [FFT.cpp, Receiver.ino, Sender.h, Sender.ino, Testing.cpp, harryPlotter_Receiver.py, harryPlotter_Sender.py]
2023-05-08 Added a potential fix for displacement spike and raw accel data drop
    [Sender.h, Sender.ino, harryPlotter_Receiver.py, harryPlotter_Sender.py]
2023-05-08 loose ends from mac
    [Receiver.ino, Sender.ino, fatLogs_Receiver.py, fatLogs_Sender.py, harryPlotter_Receiver.py]
2023-05-08 Added PCB folder and PCB project files
    [MKRWANV1.0_0.SchDoc, MKRWANV1.0_1.SchDoc, PCB1.PcbDoc, e.PrjPcb, lora-carrier-board.PrjPcb, sheet1.SchDoc]
2023-05-09 Tuesday lab testing. New test folders for recording previous results. Changed alpha filter coefficients for low pass filter
2023-05-21 Added enclosure files, updated PCB files, updated papers for lit review
    [PCB1.GBL, PCB1.GBO, PCB1.GBP, PCB1.GBS, PCB1.GTL, PCB1.GTO, PCB1.GTP, PCB1.GTS]
2023-05-24 Introduction for final report with included references
    [Enclosure_Base_Back.step, Enclosure_Base_Back.stl, Enclosure_Base_Front.step, Enclosure_Base_Front.stl, Enclosure_Lid.step, Enclosure_Lid.stl]
2023-05-28 Added test for Lora send and receive. Added professional competencies and logbook
    [Enclosure_Lid.stl, Enclosure_Lid_V2.stl]
2023-07-02 Final push to working thesis repo
    [bridge-results.xlsx, packages.csv, software-steps-1.csv, software-steps-1.xlsx, software-steps-2.csv]
